alexmoncks/V9968_Cartridge/fpga/V9968_Cartridge_TangNano20K_geo3d/README.md

# V9968 cartridge + geo3d (Gowin project)

Generated by `geo3d/integration/apply_geo3d_patch.py` from HRA!'s project
and `geo3d/rtl`. Do not edit the files in this folder by hand: the script
refuses to regenerate over a hand edit (`geo3d_manifest.txt` tells its own
output from hand edits), and with `--force` it backs the edit up next to
this folder and overwrites it.

- `../V9968_Cartridge_TangNano20K/` is HRA!'s project, exactly as upstream,
  with his own build in `impl/` (the recovery bitstream).
- This folder is the same project with geo3d wired in, laid out like his:
  - `tangnano20k_vdp_cartridge.gprj`: his file list plus `src/geo3d/*.v`.
  - `src/`: the files his project lists, and the IP generator files of his
    IPs (`.ipc`, `.mod`, `_tmp.v`, `.vo`); `v9968/vdp.v`,
    `tangnano20k_vdp_cartridge.v`, `gowin_rpll2/gowin_rpll2.v` and
    `tangnano20k_vdp_cartridge.sdc` carry the geo3d patch.
  - `src/geo3d/`: copies of `geo3d/rtl`. Edit the files in `geo3d/rtl`,
    then run the script again.
  - `impl/tangnano20k_vdp_cartridge_process_config.json`: his project
    settings, unchanged.
  - `impl/gwsynthesis/`, `impl/pnr/`: the Gowin build of this project. The
    bitstream is `impl/pnr/tangnano20k_vdp_cartridge.fs`.
  - `geo3d_manifest.txt`: the files the script generated, with the SHA-256
    of their text.
  - `tangnano20k_vdp_cartridge.gprj.user` and `impl/temp/` are written by
    Gowin, as in HRA!'s folder. The first time the Gowin IDE opens the
    project, it adds `impl/temp/rtl_parser.result` and
    `impl/temp/rtl_parser_arg.json` and rewrites the `.gprj.user`.

After a change in HRA!'s project or in `geo3d/rtl`, from the repository root:

    python3 geo3d/integration/apply_geo3d_patch.py           # regenerate this folder
    python3 geo3d/integration/apply_geo3d_patch.py --check   # verify that it is current
    sh geo3d/syn/gowin/build_gowin.sh                         # build it in place, check every timing path

The script needs Python 3 and runs in any shell that has it (Linux, macOS,
WSL, or Windows with Python installed). `build_gowin.sh` needs Gowin EDA, so
on Windows it runs from Git Bash; it runs `--check` first (with WSL's
python3 when Windows has no Python of its own) and stops if this folder is
not current.

Opening `tangnano20k_vdp_cartridge.gprj` in the Gowin IDE and running
"Run All" gives the same bitstream as `build_gowin.sh`.

Licenses: HRA!'s sources, MIT (the repository's `LICENSE`); the files
written by Gowin's IP generator (`src/dvi_tx/`, `src/gowin_*/`), Gowin's
terms, as in HRA!'s folder; geo3d, MIT, Copyright (c) 2026 Alex Moncks.
