alexmoncks/V9968_Cartridge/geo3d/docs/cartridge_report.ja.md

[English](cartridge_report.md) | [Português](cartridge_report.pt.md)

# 標準 V9968 カートリッジ上の geo3d：検証レポート

日付：2026年9月27日。ベース：HRA! 氏のカートリッジプロジェクト（Tang Nano 20K、Gowin GW2AR-18C FPGA）のバージョン 86361d8 に、スクリプト `geo3d/integration/apply_geo3d_patch.py` で geo3d を統合したものです。ブランチは `geo3d-phase2` です。この段階の変更はすべて GitHub（alexmoncks/V9968_Cartridge）にあります：ブランチ `geo3d-phase2` は `eb9be4f`、`main` は `a72a761` です。4 章のフォルダ構成（HRA! 氏のプロジェクトは `fpga/V9968_Cartridge_TangNano20K/` にそのまま置き、geo3d 入りのプロジェクトをその隣の `fpga/V9968_Cartridge_TangNano20K_geo3d/` に置く構成）は、これらのコミットの後に導入したものです。

**2026年10月2日の更新：** geo3d プロジェクトは、新しいコマンドキャッシュを含む HRA! 氏の 4410365 をベースにするようになりました。変更点と新しい数値は 13 章にあります。1 章から 12 章は 86361d8 ベースの記述です。

## 1. 概要

| 質問 | 回答 |
|---|---|
| 物理的な基板の変更は必要ですか？ | **いいえ。** 部品、パターン、ピン、水晶、ジャンパーのいずれも変更しません。 |
| HRA! 氏のオリジナルプロジェクトは変わりますか？ | **いいえ、同氏のフォルダは upstream のままです。** geo3d は、その隣にある 2 つ目の Gowin プロジェクトに入っています。このプロジェクトは同氏のプロジェクトからスクリプトで生成し、同氏のファイルのうち 5 つにパッチを当てています（FPGA のみ）。 |
| カートリッジの FPGA に収まりますか？ | **はい。** Gowin 公式ツールで、ロジック 62%、スライス 86%、メモリ 48%、DSP 38%、プライマリクロック 8 本中 6 本です。 |
| geo3d は専用のクロックを持っていますか？ | **はい。** clk42g（42.95 MHz）は clk85m と同じ PLL から出ています。HRA! 氏の clk42m と HDMI は元のままです。 |
| ロジックは動作しますか？ | **はい、シミュレーション上では。** HRA! 氏のボード全体を geo3d と新しいクロックを含めてシミュレーションしました。すべてのケースで VRAM がリファレンスと一致しました。 |
| タイミングは収束しますか？ | **はい、Gowin のモデル上では。** HRA! 氏のプロジェクト自身の設定で、すべてのクロックペアについて、セットアップ、ホールド、リカバリ、リムーバルの負スラックのパスはゼロです。一部のスラックはぎりぎりです（6 章）。 |
| デモ ROM は geo3d を検出しますか？ | **はい。** geo3d がない場合は、黒い画面のままになるのではなく、3 か国語で「geo3d not found」を表示してそこで停止します。 |
| もうカートリッジに書き込めますか？ | **はい。** ビットストリーム `geo3d_cartridge_86361d8.fs`（`fpga/V9968_Cartridge_TangNano20K_geo3d/impl/pnr/tangnano20k_vdp_cartridge.fs` のコピー）と手順書 `FLASH.txt`（英語、ポルトガル語、日本語）が用意できています。書き込みはカートリッジを MSX から抜いた状態で行ってください。 |
| 実機のカートリッジでテストしましたか？ | **いいえ。** ここに書いた内容は実機でのテストの代わりにはなりません（10 章と 11 章）。 |

## 2. 検証した項目と方法

| 項目 | 方法 | 結果 |
|---|---|---|
| 基板とスロット | `pcb/` の回路図とネットリスト、RTL `msx_slot.v`、Z80 の I/O サイクルのシミュレーション | 変更なしで動作 |
| 統合スクリプト | HRA! 氏のクリーンな 86361d8 から生成スクリプトを実行し、リポジトリの geo3d プロジェクトと比較、2 回目の実行、`--check`、`geo3d/integration/test_apply_geo3d_patch.sh` のテスト 47 件（HRA! 氏のテキストの変更。バス読み出しマルチプレクサへの新しい読み出し元の追加や、信号の名前とビット幅の変更を含みます。パッチ済みの HRA! 氏のフォルダ、手作業での編集の拒否と保持、バックアップ付きの `--force`、HRA! 氏のプロジェクトと `geo3d/rtl` の更新、余分なファイルと欠けたファイル、設定の変更、HRA! 氏のリポジトリのクローンだけの場合） | ツリーは一致（Windows の CRLF 改行を除く）。2 回目の実行では何も書き込まない。パッチを当てたファイルは、以前のフォルダ内へのパッチとバイト単位で一致。47 件中 47 件合格 |
| 使用率とタイミング | Gowin EDA Standard V1.9.12.03（Alex のライセンス）で、geo3d プロジェクトをそのフォルダ内で、IDE の Run All と同じ方法でフルビルド。設定はプロジェクトのもの（Place Option 0）。すべてのクロックペアについてセットアップとホールドのパス表を、同じビットストリームになるコピーから出力 | 収まる。違反ゼロ |
| オープンソースツール | Yosys + nextpnr-himbaechel（oss-cad-suite） | オリジナルは配線まで完了するが、geo3d を含めると配置できない（98.6%）。このチップのリファレンスとしては使えない |
| 統合ロジック | iverilog：HRA! 氏のトップ全体、VDP、スロット、SDRAM コントローラと Micron モデル、それに geo3d を clk42g で。すべて geo3d プロジェクトの `src/` から取っています。clk42g を 0.5 ns と 2.0 ns 遅らせた場合も実行。テストベンチはリポジトリの外（作者の作業環境）にあります | すべて合格 |
| VDP の等価性 | 形式検証（Yosys）と並列シミュレーション | geo3d が停止している状態では、変更後の VDP はオリジナルと同一 |
| デモ ROM | Z80 シミュレーター `geo3d/rom/run_rom_z80.py`、geo3d あり／なし、88h と 98h | 256 回中 256 回の実行が合格 |
| geo3d なしでのソフトウェア | geo3d なしの openMSX：88h と 98h、MSX1、MSX2 PAL、MSX2+、カートリッジなし | BASIC ROM とゲームは正しく動作。デモ ROM は「geo3d not found」を表示 |

## 3. 基板（ハードウェア）

**結論：標準のカートリッジは、何も変更せずに geo3d に対応できます。** クロックの修正（4 章）は FPGA のみです。

- **アドレス：** A0-A7 は U5（SN74LVC8T245、DIR は GND、入力専用）を経由して FPGA に届きます。A8-A15、/SLTSL、/MERQ、/M1 は届きません。このカートリッジは I/O 専用で、ROM は別のスロットにあります。
- **制御：** /IORQ、/RD、/WR、/RESET は U6（DIR は GND）を経由します。
- **データ：** U4 の方向は FPGA が制御します（`SLOT_DATA_DIR`、R2 による 10k のプルダウン付き）。
- **/BUSDIR：** Q1（オープンドレインの NMOS）から出力され、ゲートは同じ `SLOT_DATA_DIR` につながっています。カートリッジがバスをドライブしている間は、どのポートでも Low になります。
- **/WAIT：** Q2 を経由し、起動時（FPGA のコンフィギュレーションと SDRAM の初期化が終わるまで）だけ使われます。geo3d は /WAIT を使いません。
- **デコード：** オリジナルの `msx_slot.v` はすでに 8 ポートのブロック全体（DIP スイッチにより 88h-8Fh または 98h-9Fh）をデコードしています。VDP は +0 から +4 を、geo3d は +5（インデックスとステータス）と +7（データ）を使います。+6（8Eh）は意図的に使っていません。
- **リード：** geo3d のリードは VDP のステータスリードと同じ経路を通り、U4 の方向切り替えも /BUSDIR も同じです。
- **シミュレーション上の応答時間：** geo3d は /RD から 116 から 140 ns 後にデータをバスに出します（clk42g でのシミュレーションでは 139.7 ns）。3.58 MHz の Z80 は約 500 ns 後に読むので十分な余裕があり、7.16 MHz でも約 220 ns の余裕が残ります。レベル変換器の遅延はこの計算に含まれていません。

**お手元の機材で確認していただきたい点：**
- **MegaRAM：** msx.org のポートマップ（再確認はしていません）によると、8Eh-8Fh は MegaRAM が使用します。アドレスを一部しかデコードしない MegaRAM は、8Fh での geo3d のリードに反応する可能性があります。
- **水晶：** 基板の部品表（`pcb/.../parts.txt`）では U1 は 28.636 MHz となっていますが、プロジェクトの PLL は 14.318 MHz を前提としています。どちらが実装されているか確認する価値があります。これは HRA! 氏のオリジナルのビットストリームにも同じように当てはまります。
- **電源：** Tang Nano の 5 V ピンはスロットの +5 V に接続されています。**ビットストリームの書き込みは、カートリッジを MSX から抜いた状態で行ってください。**

## 4. HRA! 氏のプロジェクトで変わる点

HRA! 氏のフォルダ `fpga/V9968_Cartridge_TangNano20K/` は変更しません。同氏の upstream 86361d8 そのままで、`impl/` には同氏自身のビルド（復元用のビットストリーム）が入っています。そのため、同氏の更新をマージしても競合は起きません。geo3d は、その隣にある 2 つ目の Gowin プロジェクト `fpga/V9968_Cartridge_TangNano20K_geo3d/` に入っています。構成もファイル名も同氏のプロジェクトと同じです：

| `fpga/V9968_Cartridge_TangNano20K_geo3d/` 内のパス | 内容 |
|---|---|
| `tangnano20k_vdp_cartridge.gprj` | 同氏のファイルリストに `src/geo3d/geo3d_core.v`、`geo3d_engine.v`、`geo3d_bus.v` を加えたもの（パスはプロジェクト内なので、Gowin IDE でそのまま開けます） |
| `src/` | 同氏の `.gprj` に記載されたファイルと、同氏の IP の IP ジェネレータ用ファイル（`.ipc`、`.mod`、`_tmp.v`、`.vo`）。そのうち 4 つに下記のパッチを当てています |
| `src/geo3d/` | `geo3d/rtl` のコピー。編集するのは引き続き `geo3d/rtl` だけです |
| `impl/tangnano20k_vdp_cartridge_process_config.json` | 同氏のプロジェクト設定をそのまま使用（Place Option 0） |
| `impl/gwsynthesis/`、`impl/pnr/` | 当方の Gowin ビルド。同氏と同じ形で git に入れています。ビットストリームは `impl/pnr/tangnano20k_vdp_cartridge.fs` です |
| `geo3d_manifest.txt`、`README.md` | スクリプトが書き込むファイル。生成したファイルとそれぞれのテキストの SHA-256（スクリプト自身の出力と手作業での編集を見分けるため）、およびフォルダの簡単な説明 |

`apply_geo3d_patch.py` は、HRA! 氏のフォルダと `geo3d/rtl` からこのフォルダを生成します。同氏のフォルダは読むだけです。このスクリプトは冪等で（2 回目の実行では何も書き込みません）、同氏のテキストが変わっている場合や、同氏のフォルダにすでに geo3d の変更が入っている場合は、何も書き込みません。実行のたびに、rPLL2 の設定、`u_pll2` の接続（入力 clk14m、出力 clk85m）、SDC のクロック、バス読み出しマルチプレクサ（新しい読み出し元が失われないよう、upstream とまったく同じでなければなりません）、geo3d が接続する同氏の各信号の宣言とビット幅、それらの信号がつながるスロットと VDP のポートを確認します。geo3d プロジェクト内の手作業での編集（たとえば、`src/geo3d` のコピーを表示する Gowin IDE での編集）は上書きしません。書き込みを拒否して編集を移すべき場所を示し、`--force` を付けた場合は、フォルダの隣にバックアップを取ってから上書きします。`--check` は何も書き込まず、フォルダがスクリプトの生成するものと完全に一致すること、特に `src/geo3d` が `geo3d/rtl` と同じであることを確認します。パッチを当てたファイルは、以前のフォルダ内へのパッチとバイト単位で一致します（本日確認しました）。このスクリプトには Python 3 が必要です（Linux、macOS、WSL、Windows）。`geo3d/integration/test_apply_geo3d_patch.sh` が一時的なコピーの上でスクリプトをテストします。

| HRA! 氏のファイル（geo3d プロジェクト内でパッチ適用） | 変更（行数、86361d8 との比較） | 影響 |
|---|---|---|
| `src/v9968/vdp.v` | +11 / -3：コマンドレジスタへの外部書き込みポート（`ext_cmd_wr/num/data`）を CPU からの書き込みに加え、CE を出力 | geo3d が停止している状態では、VDP はオリジナルと**同一**です。形式検証（695 点中 695 点、86361d8 では 697 点中 697 点）と、全ピンが一致した 360 万サイクルの並列シミュレーションで確認 |
| `src/tangnano20k_vdp_cartridge.v`（トップ） | +44 / -4：`geo3d_bus` をポート +5 と +7 にインスタンス化し、これらのポートを VDP から外し、リードデータをまとめ、ワイヤ `clk42g` を作って `u_pll2 .clkoutd` に接続し、geo3d の `clk_eng` を clk42g につなぐ | VDP は引き続き +0 から +4 に応答し、+6 も引き続き VDP に行きます |
| `tangnano20k_vdp_cartridge.gprj` | +3：geo3d のファイル（`src/geo3d/`） | なし |
| `src/gowin_rpll2/gowin_rpll2.v` | +3 / -3：出力 `clkoutd` を公開。PLL ではすでに設定済み（CLKOUT / 2、`DYN_SDIV_SEL = 2`）で、未使用のままだった | HRA! 氏の回路への影響はありません。CLKOUT と CLKOUTP は変わりません |
| `src/tangnano20k_vdp_cartridge.sdc` | +7：clk42g の `create_generated_clock`（clk85m が clk14m x 6 であるのと同様に clk14m x 3）と、clk85m と clk42g の間の両方向への `set_clock_uncertainty 0.5`、およびコメント | タイミング解析のみ |

**geo3d プロジェクト内で変わらないもの：** `msx_slot.v`、ピン定義ファイル（`.cst`）、HDMI、SDRAM、HRA! 氏の clk42m（引き続き CLKDIV 分周器から出て、HDMI と同氏の設計の残りの部分に供給されます）、HRA! 氏の SDC のクロックとクロックグループ、そしてプロジェクト設定です。HRA! 氏自身のフォルダはまったく変わりません。その `impl/pnr/` には、復元用に同氏のオリジナルのビットストリームが入っています。

**注意：** rPLL2 IP の `.ipc` と `.mod` ファイルは変更せずにコピーしています。誰かが geo3d プロジェクト内で、Gowin でこの IP を再生成すると、ポート `clkoutd` が消え、合成がエラーで失敗します。その場合はスクリプトをもう一度実行してください。

**Gowin IDE：** IDE で geo3d プロジェクトを初めて開くと、`impl/temp/rtl_parser.result` と `impl/temp/rtl_parser_arg.json` が作られ、`tangnano20k_vdp_cartridge.gprj.user` が書き換えられます。HRA! 氏のフォルダと同じです（同氏はこれらを git に入れています）。`build_gowin.sh` が使う `gw_sh` はこれらを作らないため、まだリポジトリには入っていません。

**この段階で変更したファイル：**

| ファイル | 変更 |
|---|---|
| `fpga/V9968_Cartridge_TangNano20K/` | HRA! 氏の upstream 86361d8 に、ファイル単位で戻しました |
| `fpga/V9968_Cartridge_TangNano20K_geo3d/`（新規） | スクリプトで生成した geo3d プロジェクト。`impl/` に Gowin のビルド結果があります |
| `geo3d/integration/apply_geo3d_patch.py` | HRA! 氏のフォルダにパッチを当てる代わりに、同氏のフォルダから geo3d プロジェクトを生成します。`--check` 付き。2 つの新しいステップ（rPLL2 と SDC）、トップへの clk42g の追加、上記の確認処理、手作業での編集の保護（`geo3d_manifest.txt`、`--force`） |
| `geo3d/integration/test_apply_geo3d_patch.sh`（新規） | スクリプトのテスト 47 件。一時的なコピーの上で実行します（bash と Python 3：Linux または WSL） |
| `geo3d/syn/gowin/build_gowin.sh`（新規） | geo3d プロジェクトをそのフォルダ内で、IDE の Run All と同じ方法で、プロジェクトの設定のままビルドします。Git Bash で実行し、最初に `apply_geo3d_patch.py --check` を実行して（Windows に Python がなければ WSL の python3 で）、プロジェクトが最新でなければ停止します。パス表は、リポジトリ外のコピーで行う 2 回目のビルドから取ります。そのコピーの SDC にだけ、プロジェクトの SDC が定義するすべてのクロックのペアについてレポートコマンドを追加し、同じビットストリームになることを確認します。負のスラックが 1 つでもあれば終了コード 2 で終わります |
| `geo3d/syn/cartridge/synth_cartridge.sh` | Yosys での合成は、HRA! 氏のプロジェクト（`run_all.sh` と同様に、同氏のリポジトリのクローンだけで足ります）とスクリプト自身の `geo3d/rtl` から、geo3d プロジェクトを作業フォルダに生成してから行います |
| `geo3d/rtl/geo3d_bus.v` | ヘッダーのコメントのみ（clk42g と SDC のマージン）。ロジックは変更していません |
| `geo3d/rom/geo3d_rom.asm`、`build_rom.py`、`run_rom_z80.py` | デモ ROM での geo3d の検出と、シミュレーターの新しいモード（8 章） |
| `geo3d/docs/BASIC_API.md` | R#32-R#58 のルール（9 章） |

## 5. FPGA の使用率（Gowin、GW2AR-LV18QN88C8/I7）

86361d8 ベース、Gowin V1.9.12.03、HRA! 氏のプロジェクト設定でのビルドです。最終ビルドの Gowin のレポートは `fpga/V9968_Cartridge_TangNano20K_geo3d/impl/` に、サマリーとパス表は `openmsx-geo3d\fpga\reports\`（納品フォルダ、リポジトリ外）にあります。

| リソース | HRA! 氏のオリジナル | geo3d あり、clk42m（以前） | geo3d あり、clk42g（最終） | 最終の差分 |
|---|---|---|---|---|
| ロジック（LUT + ALU） | 7,023 (34%) | 12,756 (62%) | 12,756 (62%) | +5,733 |
| レジスタ | 4,219 (27%) | 7,536 (48%) | 7,536 (48%) | +3,317 |
| スライス（CLS） | 5,605 (55%) | 8,896 (86%) | 8,886 (86%) | +3,281 |
| ブロックメモリ（BSRAM） | 10 / 46 (22%) | 22 (48%) | 22 (48%) | +12 |
| DSP | 3 / 24 (13%) | 9 (38%) | 9 (38%) | +6 |
| I/O ピン | 39 / 66 | 39 / 66 | 39 / 66 | 0 |
| プライマリクロック | 4 / 8 | 5 / 8 | 6 / 8 | +2 |
| ロングワイヤ | 5 / 8 | 8 / 8 | 8 / 8 | +3 |
| PLL（rPLL）／分周器（CLKDIV） | 2 / 2、1 / 8 | 2 / 2、1 / 8 | 2 / 2、1 / 8 | 0 |

- geo3d 専用のクロックは、ロジックも PLL も消費しません。PLL がもともと持っていた出力を使っているためです。プライマリクロックネットワークを 1 本使います（clk42g は TR、TL、BL の各象限で使われます）。
- ロングワイヤは 8 本中 8 本を使用しており、今後の変更に使える余りはありません。

## 6. タイミング

**結果：HRA! 氏のプロジェクト自身の設定（Place Option 0）で、すべての表において負スラックのパスはゼロです。** これは、すべてのクロックペアのセットアップ、ホールド、リカバリ、リムーバルを含みます。`build_gowin.sh` は、geo3d プロジェクトをそのフォルダ内で、Gowin IDE とまったく同じ方法（`open_project` と `run all`、オプションも追加の表もなし）でビルドします。パス表は、SDC にレポートコマンドを加えたコピーで行う 2 回目のビルドから取ります。スクリプトは、そのコピーが同じビットストリームを生成することを確認します（異なるのは「Created Time」の行だけです）。このビットストリームは、フォルダ構成を変更する前に納品したものとも同じです。

ワーストスラック（ns、正の値は合格）です。geo3d ありの 2 列では、clk42m または clk42g が geo3d エンジンのクロックです。

| 検査項目（目標） | HRA! 氏のオリジナル | geo3d、clk42m（以前） | geo3d、clk42g（最終） |
|---|---|---|---|
| Fmax clk85m (85.909 MHz) | 86.73 MHz | 86.14 MHz | 86.34 MHz |
| Fmax clk42m (42.955 MHz) | 120.92 MHz | 62.64 MHz | 117.46 MHz |
| Fmax clk42g (42.955 MHz) | なし | なし | 64.07 MHz |
| セットアップ 85 → 85 | +0.111 | +0.031 | +0.058 |
| セットアップ 85 → 42m（HDMI） | +1.334 | **-1.130（50 本以上が違反）** | +0.489 |
| セットアップ 85 → 42g | なし | なし | +2.383 |
| セットアップ 42m → 85 | なし | +12.698 | なし |
| セットアップ 42g → 85 | なし | なし | +7.857 |
| セットアップ 42m → 42m | +15.010 | +7.316 | +14.767 |
| セットアップ 42g → 42g | なし | なし | +7.673 |
| ホールド 85 → 85 | +0.199 | +0.227 | +0.216 |
| ホールド 85 → 42m（HDMI） | +3.443 | +3.458 | +3.782 |
| ホールド 85 → 42g | なし | なし | +0.047 |
| ホールド 42m → 85 | なし | **-2.487（40 本が違反）** | なし |
| ホールド 42g → 85 | なし | なし | +0.039 |
| ホールド 42m → 42m | +0.539 | +0.074 | +0.544 |
| ホールド 42g → 42g | なし | なし | +0.074 |
| リカバリ／リムーバル | +10.046 / +1.047 | +9.476 / +1.200 | +9.476 / +1.185 |
| **負のパス（全表の合計）** | **0** | **90 本以上** | **0** |

- 各表には最大 50 本のパスしか表示されません。そのため「50 本以上」としています。
- clk42m の列では、「85 → 42m」の行は geo3d エンジンも含んでおり、ワーストパスは HDMI ではなく geo3d のものです。セットアップは HRA! 氏のリセット `ff_reset3_n2` からエンジンへのパス、42m → 85 のホールドは `geo3d_bus` の `cmd_*_e` レジスタから `cmd_*` へのパスです。
- 74 の表は、プロジェクトの SDC が定義する 6 つのクロック（clk85m、clk42m、clk42g、clk215m、clk、clk14m。`build_gowin.sh` が SDC から読み取ります）の 36 のペアそれぞれのセットアップとホールド、それにリカバリとリムーバルです。最終ビルドでは、そのうち 60 の表にパスがありません。clk215m、clk、clk14m のいずれかを含むすべてのペア（54 表）、clk42m と clk42g の間のペア（4 表、HDMI と geo3d はつながっていないため）、clk42m から clk85m へのペア（2 表）です。
- clk85m と clk42g の間のスラックは、0.5 ns のマージンを差し引いた後の値です。マージンがなければ、このクロスのホールドは約 +0.54 ns になります。
- **Gowin のレポートを読む際の注意：** 「Total Negative Slack」のサマリーは、クロック間のパスが違反していても 0 と表示します。違反が見えるのはパス表だけです。`build_gowin.sh` はこれらの表を生成し、すべてを確認します。

**以前の違反の原因：** clk42m は CLKDIV 分周器から出ており、Gowin のモデルでは遅延がゼロですが、PLL から出る clk85m には 2.9 から 4.4 ns の遅延があります。geo3d のクロックドメイン間の受け渡しは、クロックがそろっていることを前提としています。

**適用した修正：** geo3d に clk42g を追加しました。clk85m と同じ PLL の CLKOUTD 出力（CLKOUT / 2）です。これにより、モデル上で geo3d のクロスのクロックスキューは 0 ns になりました（以前は 4.36 ns）。

**0.5 ns のマージン：** Gowin は CLKOUTD に CLKOUT とまったく同じ遅延を与え、分周器そのものの遅延はモデル化していません。SDC は clk85m と clk42g の間の両方向に 0.5 ns（`set_clock_uncertainty`）を確保しています。**この値は仮定であり、測定値ではありません。** ロジックを確認するため、clk42g を 0.5 ns と 2.0 ns 遅らせたシミュレーションも行いました（7 章）。

**途中のビルド**（サマリーは `reports\compare\`）：

| ビルド | 配置 | マージン | 負のパス |
|---|---|---|---|
| clk42m（旧） | Option 0 | なし | 90 本以上 |
| clk42g | Option 0 | なし | 1（HRA! 氏の HDMI のパス、85 → 42m、-0.059 ns） |
| clk42g | Option 1 | なし | 0 |
| **clk42g（納品版）** | **Option 0（HRA! 氏のデフォルト）** | **0.5 ns** | **0** |
| clk42g | Option 1 | 0.5 ns | 0 |

**ぎりぎりだが正のスラック：**
- セットアップ 85 → 85：+0.058 ns。VDP のコマンドエンジン内のパスです（オリジナルでは +0.111 ns、clk42m のビルドでは +0.031 ns）。このスラックは配置によって変わります。
- geo3d エンジン内部のホールド（42g → 42g）：+0.074 ns。
- 85 と 42g の間のクロスのホールド：+0.039 ns と +0.047 ns（マージン込み）。
- HDMI のパス（85 → 42m）は配置によって変動し、上記の clk42g のビルドでは -0.059 から +0.962 ns でした。今後の RTL の変更で再び動く可能性があります。`build_gowin.sh` はそれを検出します（終了コード 2）。

## 7. 統合 RTL のシミュレーション

iverilog で、HRA! 氏のトップ全体（geo3d プロジェクトの `src/` の Verilog、つまりクリーンな 86361d8 にスクリプトを適用したもの）を、VDP、スロット、SDRAM コントローラ、Micron MT48LC2M32B2 モデル、それに geo3d を含めて 85.909 MHz でシミュレーションしました。スタブは PLL、分周器（実際に 2 分周します）、HDMI だけです。PLL のスタブは `clkoutd` を clk85m / 2 として同相で生成します。チェッカー（`clkcheck.v`）が、geo3d の `clk_eng` が clk42g であること、正確に半分の周波数であること、ずれたエッジが 0 であることを確認します。Z80 側は OTIR の速度で実際の I/O サイクル（/IORQ、/RD、/WR、A0-A7、D0-D7）を使います。VRAM（256 KB）は、書き込みの抜けを検出できるよう、擬似乱数パターンで埋めた状態から始めます。

| テスト | 結果 |
|---|---|
| レジスタ、ステータス、即時変換 | エラー 0 |
| ワイヤーフレーム（立方体と正八面体、XOR と TIMP） | VRAM 一致 |
| シェーディングしたソリッド面 | VRAM 一致 |
| テクスチャ付きの面（LRMM） | VRAM 一致 |
| 実際のテクスチャデモ（GEO3DT.COM）、すべての OUT を再現 | 2,842 コマンド（LINE 1,855、LRMM 987）、相違 0、3 フレーム一致 |
| DIP スイッチ 98h | 合格 |
| 起動時の状態（V9958 モード） | VRAM 一致 |
| geo3d から VDP への 39,158 回の書き込みでのハンドシェイク | CE = 1 での書き込み 0、抜け 0、衝突 0 |
| 意図的な競合：geo3d がビジーの間に CPU が R#32-R#58 に書き込む（33 回） | 同一サイクルでの衝突 4 回とフレームの破損、想定どおりです。9 章のルールを裏付けます |

- **旧クロックおよび前回の納品物との比較：** コマンドログとリードログ、VRAM、サイクル数は、clk42m でのシミュレーションとも、clk42g を使った前回の納品物とも、バイト単位で一致しました。起動時の状態のテストは以前は clk42m でしか実行していなかったため、今回の見直しで最終ツリー上で再実行しました。
- **新しいフォルダ構成：** レジスタ、ワイヤーフレーム、面、テクスチャ、ハンドシェイク、DIP 98h、98h でのレジスタ、実際のデモの各テストを、すべてのファイルを `fpga/V9968_Cartridge_TangNano20K_geo3d/src`（geo3d は `src/geo3d`）から取って再実行しました。8 件すべて合格し、コマンドログとリードログ、VRAM、サイクル数は、以前の実行とバイト単位で一致しました。
- **遅延させたクロック：** 7 つのテストを、clk42g を clk85m に対して 0.5 ns と 2.0 ns 遅らせて実行しました（14 回）。ゲート遅延のないシミュレーションでは、これにより clk85m から clk42g へのすべての取り込みが、同じエッジで送出された値を取り込むことになります。14 回すべて合格しました。VRAM はクロックがそろった場合と一致しました。例外は意図的な競合テストで、衝突が変わり（4 回ではなく 1 回）、それに伴って破損したフレームも変わります。
- **テストベンチ：** `tb_cart.sv`、スタブ、Z80 サイクルの生成、デモの再生はリポジトリの外（作者の作業環境）にあるため、これらの実行はリポジトリだけでは再現できません。
- **限界：** シミュレーションは実際の配線遅延をモデル化していません。それはタイミング解析（6 章）と実機のカートリッジに委ねられます。

## 8. HRA! 氏のオリジナルのビットストリーム（geo3d なし）での当方のソフトウェア

| プログラム | 動作 | 状況 |
|---|---|---|
| BASIC ROM（G3BASIC.ROM） | 起動表示「geo3d BASIC 0.2 (none)」。`CALL G3INIT` は「Device I/O error」になり、BASIC はそのまま動作し続けます | 正しい |
| ゲーム VECTOR RAID | 止まりはしませんが、自機も敵も表示されないまま、警告なしで動作します | 許容範囲 |
| デモ ROM | 「geo3d not found」画面（英語、スペイン語、ポルトガル語）を表示し、そこで停止します。geo3d のどのポートにも書き込みません | **正しい（修正済み）** |

**デモ ROM が geo3d を検出する方法**（`geo3d_rom.asm` の `geo_probe`。BASIC ROM の `detect` と同じ方法で、ROM 自身のベースアドレスでのみ行います）：
1. 98h 版の ROM は、MSX1（MSXVER = 0）では何もしません。TMS9918 は R#15 への書き込みを R#7 として解釈してしまうためです。
2. S#1 から VDP の ID を読みます。ID 0、2、3 は V99x8 があることを意味し、メッセージの画像をそこに表示できます。geo3d には ID 2 または 3 が必要です。
3. R#15 = 2 にして P+5 を読みます。FFh（HRA! 氏のビットストリーム、または空きポート）は geo3d なしを意味します。ビット 3-2 = 11 は、ポートが P+4 から P+7 に繰り返し現れる VDP を意味します。その後で初めて PORT#4 を読みます。
4. geo3d への最初の書き込みはインデックス 40h です。続いて P+7 を 17 回読み、17 回目の値は 1 回目と同じでなければなりません。

検出は 29 回のポートアクセスで行います。geo3d がある場合、その後のトラフィックは以前の ROM と同一です。

**geo3d がない場合：**
- ベースアドレスに V99x8 がある場合は、メニューと同じスタイルの SCREEN 5 の画像を表示します。どの V99x8 でも受け付けるレジスタだけを使い、V9968 のレジスタ、コマンド、PORT#4 への書き込みは一切使いません。
- 88h 版の ROM は、BIOS（INITXT と CHPUT、プレーンな ASCII）で MSX 本体の画面にもテキストを表示します。88h に V9968 がない場合は、これが唯一のメッセージです。98h 版は MSX1 の場合にのみこれを行います。
- ROM は割り込み禁止のループ（`ng_stay`）にとどまります。
- **50/60 Hz：** 98h 版の ROM は本体の周波数を維持します（R#9 = `(RG9SAV & 02h) | 80h`、PAL 機では 82h）。88h 版はカートリッジの HDMI のため 80h（60 Hz）を使います。

**待ちのタイムアウト：** geo3d の RUN と VDP の CE の待ちは、3.58 MHz の Z80 で約 3 秒後に打ち切られます（シミュレーターでは 3.08 から 3.29 秒）。turbo R では、カートリッジの INIT は Z80 で動作します。R800 の ROM モードでは、待ちの 65,536 回のリード 1 周（Z80 では約 1.6 秒）に約 0.7 秒かかります（レビュー時の測定値で、再測定はしていません）。タイムアウトになると（`hw_timeout`）：
1. 音楽を止めます。
2. コマンドエンジンに STOP（R#46 = 0）を送ります。
3. 描画中のフレームがメッセージの上に描かれないよう、geo3d の RUN が終わるのを、P+5 を最大 32,768 回読んで（約 0.55 秒）待ちます。
4. RUN が終わった場合に限り、2 回目の STOP を送ります。
5. 同じメッセージを表示します。

**Z80 シミュレーター（`run_rom_z80.py`）、新しい ROM：**

| セット | 実行回数 | 結果 |
|---|---|---|
| MoonSound なし（PSG、SCC、OPL、OPL4、3 か国語、キー入力スクリプト、スペースバー、88h と 98h） | 120 | 120 回合格。トレースは、検出の 29 アクセスの後にリファレンスのトレースが続く形で、バイト単位で一致 |
| メッセージ（`--absent ff/mirror/v9938/none`、`--stuck geo/ce/cegeo`、`--msxver`、`--pal`、MSX1、MoonSound、88h と 98h） | 84 | 84 回合格。CPU は `ng_stay` で終わり、ページ 0、パレット、レジスタが画像と一致し、BIOS のテキストも一致 |
| MoonSound（640、256、128、0 KB） | 52 | 52 回合格。ポートごとの書き込みは、52 回中 45 回で検出とリファレンスを合わせたものと一致。残りの 7 回は最後の部分だけが異なり、そこでは実時間によって実行が打ち切られます |

- `--stuck cegeo` モードは、geo3d が CE を待っている状態で CE が止まったままになるケースを再現します。ステータスリード 1,001 回と STOP 2 回が、すべて画像の表示前に行われます。以前の ROM は、このモードと `--pal` で失敗します。

**openMSX（ヘッドレス、画像は VRAM、レジスタ、パレットのダンプから生成）：**

| 機種とカートリッジ | ROM | 結果 |
|---|---|---|
| FS-A1WSX、HRA! 氏の V9968（geo3d なし） | 88h | V9968（HDMI）に画像、MSX の画面にテキスト。geo3d へのアクセスは 8Dh のリード 1 回（FFh）のみ |
| C-BIOS_V9968_JP、geo3d なし | 98h | 画像。9Dh のリード 1 回（FFh）、書き込みなし |
| FS-A1WSX、カートリッジなし | 88h | BIOS のテキストのみ。8Dh-8Fh へのアクセスなし |
| MSX1（Expert XP-800）、HRA! 氏の V9968 | 88h | V9968 に画像、MSX の画面にテキスト |
| FS-A1WSX（98h に V9958） | 98h | V9958 に画像 |
| MSX1 | 98h | BIOS のテキストのみ。98h-9Fh へのアクセスなし |
| Philips NMS 8245（PAL、V9938） | 98h | R#9 = 82h で画像（50 Hz を維持） |
| Philips NMS 8245、HRA! 氏の V9968（geo3d なし） | 88h | R#9 = 80h で V9968 に画像 |
| geo3d あり（88h と 98h） | 両方 | メニューとクロールは正常。ポートアクセス数と VRAM は前回の納品物と同じ |

画像は `openmsx-geo3d\geo3d_not_found\`（9 ファイル）にあります。

## 9. geo3d をプログラムする方へのルール

- geo3d の描画中（RUN がビジーの間）は、**R#32 から R#58** に何も書き込んではいけません。LRMM は R#47 から R#58 を使い、geo3d の書き込みと同じサイクルで行われた CPU の書き込みは失われます。7 章の意図的な競合テストがこれを示しています。
- **CE = 0 はエンジンが空いていることを意味しません。** CE は geo3d のあるコマンドと次のコマンドの間で下がります。geo3d のステータスのビット 0 を待ってください。
- LRMM のウィンドウ（R#51 から R#58）は VRAM 全体をカバーしている必要があります。これはリセット時の値です。

これらのルールは `BASIC_API.md` の 7.2 節に記載しています。3 つの ROM はすでにこれを守っています。唯一の例外はデモ ROM の `hw_timeout` の STOP ですが、それも理論上だけです。geo3d は、固まっている場合でも、CE が High の間はレジスタに書き込みません。

## 10. 実機のカートリッジでしか確認できないこと

- **チップ上での CLKOUT と CLKOUTD の間の実際の遅延。** 0.5 ns のマージンは仮定であり、測定値ではありません。
- **6 章のぎりぎりのスラック**（ホールドで +0.039 から +0.074 ns、セットアップ 85 → 85 で +0.058 ns）：タイミング解析はあくまでモデルです。
- **シグナルインテグリティ：** LVC8T245 の遅延、ノイズ、そしてスロットバッファ付きの機種、スロット拡張、R800 でわずかに遅れる /BUSDIR。
- geo3d のコマンドトラフィック下での**実際の SDRAM**。
- **実際のモニターでの HDMI。**
- 長時間使用時の**消費電力、発熱、安定性**。
- HRA! 氏のオリジナルのビットストリームを使った、**実機上での「geo3d not found」画面**。

## 11. 実機での最初のテストの手順

納品フォルダ `openmsx-geo3d`（リポジトリ外）のファイル：

| ファイル | 確認 |
|---|---|
| `fpga\geo3d_cartridge_86361d8.fs` | SHA-256 `00238660f28d4fa73232fcfd3553b3c1eb554bb1a81b35e52ebfbab3b1e8c3ca`、リポジトリの `fpga/V9968_Cartridge_TangNano20K_geo3d/impl/pnr/tangnano20k_vdp_cartridge.fs` と同一。前回の納品物（`49a3fc51...`）と内容は同じで、異なるのは「Created Time」の行だけです |
| `fpga\recovery\tangnano20k_vdp_cartridge_HRA_86361d8.fs` | SHA-256 `9957d2b507897370c402973c2a358adad9675c0bb7b45b38f75d1fb6a6b32b73`、リポジトリの `fpga/V9968_Cartridge_TangNano20K/impl/pnr/tangnano20k_vdp_cartridge.fs`（HRA! 氏のフォルダ）と同一 |
| `fpga\FLASH.txt` | 英語、ポルトガル語、日本語の手順 |
| `GEO3D_88_hardware_real_MOD.ROM` | SHA-1 `79fbbd4f29f2f3ebffa1e9da414b7917d0ca575f` |
| `GEO3D_98.ROM` | SHA-1 `0b8ff70cd6f6ad3dbbcb194ec269987536f42987` |

2 つのビットストリームの SHA-256 の値は、Gowin が書き出すとおり、また Windows で git がチェックアウトするとおりの、CRLF 改行のファイルのものです。Linux や macOS でチェックアウトすると改行が LF になり、ハッシュが変わります（geo3d `4ce281b2...`、HRA! 氏 `7fc1fffa...`）。ビットストリームは同じです。

2 つの ROM は Star Wars の音楽（MOD）を使っているため、git には入れません。フォルダ内のほかの ROM は検出機能のない古いビルドです。

0. **基準の確認：** DIP スイッチを 88h にし、HDMI を接続し、HRA! 氏の**オリジナル**のビットストリームを書き込んだ状態で、BASIC ROM を動かします。`CALL G3INIT` は「Device I/O error」になるはずです。次に `GEO3D_88_hardware_real_MOD.ROM` を動かします。HDMI に「geo3d not found」が、MSX の画面にテキストが表示されるはずです。これで、カートリッジ、88h の経路、メッセージが動作することを確認できます。
1. **geo3d のビットストリームの書き込み**は、**カートリッジを MSX から抜いた状態で**、USB-C で PC に接続して行います。事前に SHA-256 を確認してください。
   - Gowin Programmer：デバイス GW2AR-18C、Access Mode = External Flash Mode、Operation = exFlash Erase,Program thru GAO-Bridge、ファイル `geo3d_cartridge_86361d8.fs`。
   - または：`openFPGALoader -b tangnano20k -f geo3d_cartridge_86361d8.fs`。
2. **最初の起動：** USB ケーブルを抜き、DIP スイッチを 88h にし、MSX の電源を切った状態でカートリッジをスロットに挿し、HDMI を接続してから MSX の電源を入れます。通常どおり起動するはずです。起動せずに固まった場合は、/WAIT がアサートされたままです。FPGA のコンフィギュレーションができなかったか、SDRAM が初期化されなかったことを意味します。電源を切り、カートリッジを抜いて、もう一度書き込んでください。
3. **最初は BASIC ROM** です。最も安全だからです。geo3d を識別するまではリードしか行わず、待ちにはタイムアウトがあり、CTRL+STOP も受け付けます。起動表示に「(88h)」と出るはずです。次にサンプルを実行します：`10 SCREEN 5:CALL G3INIT`、`20 CALL G3OBJ(1,1)`、`30 CALL G3SPIN(1,1,2,0)`、`40 CALL G3FRAME:GOTO 40`。
4. **次にゲーム：** タイトル画面に 3D の自機が表示されるはずです。
5. **最後にデモ ROM**（`GEO3D_88_hardware_real_MOD.ROM`）：言語メニューとデモです。
   - 起動直後に「geo3d not found」が出る場合：カートリッジは応答していますが、geo3d がありません。このビットストリームが書き込まれているか、DIP スイッチが 88h になっているかを確認してください。
   - デモの途中で同じメッセージが出る場合：geo3d またはコマンドエンジンが約 3 秒間応答しなくなりました。デモの名前と発生したタイミングを記録してください。調査すべき実際の問題です。
6. **観察する点：** 描画中の点やゴミ（SDRAM）、数分後のフリーズ、発熱。可能であれば、PAL 機や turbo R を含むほかの MSX 機種でもテストしてください。
7. **オリジナルに戻すには：** 同じ手順で、カートリッジを MSX から抜いた状態で `recovery\tangnano20k_vdp_cartridge_HRA_86361d8.fs`（または HRA! 氏の `fpga/V9968_Cartridge_TangNano20K/impl/pnr/tangnano20k_vdp_cartridge.fs`、内容は同じ）を書き込みます。

## 12. 未解決事項

1. **実機のカートリッジでの最初のテスト**（11 章）。0.5 ns のマージンとぎりぎりのスラックを確認する唯一の方法です。
2. **`geo3d/README.md`**（意図的に読み取り専用、Alex の承認が必要）：統合とタイミングの段落が、まだ以前の構成（HRA! 氏のフォルダへのパッチ適用、コピー上での Gowin ビルド）を説明しています。
3. **`geo3d/demos/README.md`、`README.pt.md`、`README.es.md`：** 「Real hardware」（実機）の段落と `run_rom_z80.py` の使い方（新しいオプション `--absent`、`--stuck`、`--msxver`、`--pal`）が、まだ以前の状態を説明しています。
4. **納品フォルダ内の古い ROM：** `GEO3D_88_hardware_real.ROM`、`*_crawlonly`、`GEO3D_98_fmconv`、`GEO3D_98_midi` には検出機能がありません。作り直すか削除してください。
5. `FLASH.txt` 内の **Gowin Programmer のメニュー名**：Sipeed の Tang Nano 20K 向けの手順に基づくもので、このマシンでは確認していません。
6. **ディスク容量：** 実験用のフォルダ `C:\Projects\mmsoft\g3x`（561 MB）と `geo3d_review_gw*` はリポジトリ外にあり、削除してかまいません。

## 13. 2026年10月2日の更新：HRA! 氏の 4410365

geo3d プロジェクトは、HRA! 氏の upstream **4410365**（2026年9月30日）から生成するようになりました。この upstream は `geo3d-phase2` にマージ済みで、同氏のフォルダは再び upstream とバイト単位で一致しています。1 章から 12 章は 86361d8 ベースの記述で、そのまま残しています。

**86361d8 以降の HRA! 氏の変更：**
- 88132d2：コマンドキャッシュを書き直し。32 ビット 8 ライン、LRU 置換（以前は 4 ライン、ラウンドロビン）になり、`vdp_command.v` の内部から `vdp.v` に移りました。CPU の VRAM アクセスもこのキャッシュを通ります。各コマンドの終了時と、CPU の最後のアクセスから 256 クロック後に書き戻され、コマンド開始時のクリアはなくなりました。
- 4410365：SCREEN 2 で R#25 CMD = 1 のとき 1 バイト飛ばしになる問題。ピクセルステップは R#46 の書き込みで設定されるレジスタになりました。
- ef12ee3：DIY = 1 の HMMM / LMMM / YMMM は、転送元が Y = 0 に達すると止まります。
- 05f9806：ステータス読み出しでポート #1 のバイト対をリセット。6acdb4d：V9958 モードでの R#4 の A17。fda3f26：水平拡大。9917548：スプライト合成とタイミング制御。
- 同氏のプロジェクト設定：`Route_Maxfan` が 100 から 50 に（スクリプトはすべての設定と同様に geo3d プロジェクトへコピーします）。

**geo3d 側の変更：** `geo3d/rtl` もパッチも変更なし。`apply_geo3d_patch.py` は新しい `vdp.v` にそのまま適用できました。フックは `vdp_command` の手前にあるので、geo3d 自身の R#46 書き込みも新しいピクセルステップのレジスタを設定します。HRA! 氏のエンジンを直接インスタンス化する 2 つのテストベンチ、`sim/hra/tb_hra_cmd.v` と `sim/tb_system.v` は、`vdp.v` と同じ接続で `vdp_command_cache.v` も並べてインスタンス化するようにしました（CPU ポートは未使用）。

| 4410365 での確認 | 結果 |
|---|---|
| パッチ後の `vdp.v` と upstream の比較 | 差分は 4 つのポート、`u_command` の接続 3 行、`ext_cmd_ce` の assign のみ。20 個の `vdp_*.v` サブモジュールは同一 |
| geo3d 停止時の VDP の等価性 | 形式検証（Yosys）：755 点中 755 点。`ext_cmd_wr` = 1 のミュータントは 15 点が未証明となり、期待どおり失敗。両カートリッジの並列シミュレーション、366 万サイクル、全ピン：一致 |
| 統合スクリプト | テスト 47 件中 47 件合格。`--check`：最新 |
| `run_all.sh`（geo3d のシミュレーション） | すべて合格：4,000 ベクタ、ワイヤーフレーム 24 シーン、面 16 シーン、テクスチャ 12 シーン、Z80 デモ 3 本。HRA! 氏の RTL と LRMM / LINE モデルの比較：不一致 0 バイト（900 + 300 コマンド）。エンドツーエンドで 130 ページ一致。ショーケースの 3 サンプル、不一致ページ 0。デモ ROM のトラフィックは検証済みのものと一致 |
| カートリッジ全体（`tb_cart.sv`） | regs、ワイヤーフレーム、面、テクスチャ、busy、DIP 98h、regs 98h、V9958 モードの面、実際のテクスチャデモ：すべて合格。VRAM はモデルと一致、CE = 1 のときのレジスタ書き込み 0（デモで geo3d の書き込み 39,158 回）、コマンド列は 86361d8 での実行と一致。変わるのはサイクル数だけ |
| HRA! 氏のテストベンチ | `test_command_cache`：すべて合格（iverilog）。`tb_port1_latch_reset`：12 件中 12 件（Verilator）。その他のテストベンチは ModelSim が必要（iverilog 12 は `break` 非対応。`test_vdp_cpu_interface/tb` と `test_vdp_timing_control_ssg` は RTL にもう存在しないポートを接続している） |
| Gowin EDA V1.9.12.03、その場でビルド | 74 個の表すべてで負のスラックのパス 0 |

**リソースとタイミング（Gowin）：**

| | HRA! 4410365（同氏のビルド） | geo3d（86361d8） | geo3d（4410365） |
|---|---|---|---|
| ロジック（LUT + ALU） | 7,469（37%） | 12,756（62%） | 13,130（64%） |
| レジスタ | 4,513（29%） | 7,536（48%） | 7,863（50%） |
| CLS | 5,768（56%） | 8,886（86%） | 9,137（89%） |
| BSRAM / DSP | 10 / 3 | 22 / 9 | 22 / 9 |
| Fmax clk85m（85.909 MHz） | 90.2 MHz | 86.34 MHz | 85.91 MHz |
| Fmax clk42g（42.955 MHz） | - | 64.07 MHz | 68.11 MHz |
| セットアップの最悪スラック 85 から 85 | | +0.058 ns | **+0.001 ns** |
| ホールドの最悪 42g から 85 / 85 から 42g | | +0.039 / +0.047 ns | +0.039 / +0.042 ns |

geo3d 自身の分は変わりません（ロジック約 +5,660、レジスタ約 +3,350）。+0.001 ns のパスは HRA! 氏のもの（スプライト回路、`ff_screen_pos_x_clone` から `ff_sprite_overmap_id`）で、配置によって変わります。今後の RTL の変更で負になる可能性があり、その場合 `build_gowin.sh` は終了コード 2 で知らせます。ビットストリームの SHA-256：Gowin が書き出す CRLF 改行で `c13b99ac...`、LF 改行で `5bb80bd0...`。

**新しいキャッシュでのコマンドのタイミング**（高速モード、85.9 MHz、両ベースで同じテストベンチ）：

| 測定 | 86361d8 | 4410365 |
|---|---|---|
| LRMM、1 ピクセルあたりのクロック数（`check_lrmm.py`、VRAM は常に準備完了） | 8.8 | 11.6 |
| LINE、1 ピクセルあたりのクロック数 | 5.9 | 7.0 |
| LINE、V9938 互換タイミング | 224 | 225 |
| テクスチャデモの最長フレーム（`tb_system.v`、RUN から終了まで） | 4.14 ms | 4.36 ms |
| サンプルの最長フレーム、パンとズーム / クロール / フライイン | 9.2 / 4.7 / 3.2 ms | 10.2 / 6.2 / 3.4 ms |

各アクセスが検索と更新のステートを通るようになったため、キャッシュヒットのコストが数クロック増えました。影響が最も大きいのはテクスチャのスパン（LRMM は読み書きの両方）です。どのデモもフレーム時間に十分収まっています（相対的な変化が最も大きいクロールでも、2.9 フィールドに 1 フレームの描画です）。

GRAPHIC 7 で古い 4 ラインのキャッシュに見られた位置合わせの影響（SX - DX が 8 で割って 3 または 4 余るコピーは最大 1.6 倍の時間がかかった）はなくなりました。画面表示とスプライトの VRAM スロットのモデルで、GRAPHIC 7 の HMMM 248x64 は SX = 0 から 7 で 2.48 から 2.90 ms（以前は 1.88 から 3.02 ms）、LMMM + TIMP は 4.08 から 4.51 ms（以前は 3.18 から 5.23 ms）です。最悪の場合は速くなり、位置が揃った場合は遅くなりました。GRAPHIC 4 と、VRAM が常に準備完了の場合、コピーと LINE は 10 から 36% 遅くなります（HMMV は変わりません）。

**VDP ポートの読み出しレイテンシ：** カートリッジ全体のテストベンチで、最も遅い VDP の読み出しは /RD から 350 ns が 417 ns になりました。CPU の VRAM アクセスが共有キャッシュでコマンドエンジンを待つようになったためと考えられます（詳しくは調べていません）。並列シミュレーションでは geo3d の有無にかかわらず同じレイテンシで、3.58 MHz の Z80 が許す 503 ns にはまだ収まっています。geo3d 自身の読み出しは変わりません（140 ns）。

**openMSX：** フォーク（`geo3d` ブランチ）は古いキャッシュ（4 ライン、ラウンドロビン、ヒット 1 クロック）をモデル化しています。古い RTL と一致していた範囲で言えば、VRAM が速い場合の高速コマンドでは約 20 から 35% 楽観的になり、位置のずれた GRAPHIC 7 のコピーでは悲観的になります。buppu3 氏の upstream は 88132d2 以降キャッシュのモデルを変えていません。更新には、LRU の経過を持つ 8 ライン、新しいステートマシンのアクセスごとのコスト、コマンド開始時にクリアしないこと、コマンド終了時と CPU アイドル時の書き戻し、キャッシュを共有する CPU の VRAM アクセスが必要です。

**未解決：** 納品フォルダのビットストリーム `geo3d_cartridge_86361d8.fs` は 86361d8 のビルドです。`cartridge_report.pt.pdf` はこの章より前のものです。
