alexmoncks/V9968_Cartridge/geo3d/demos/img/sphere7.gif

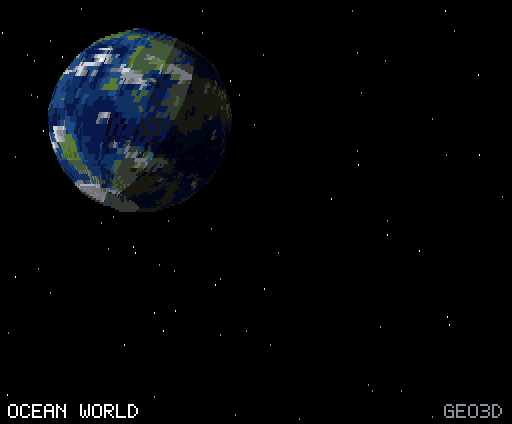
geo3d/demos/img/sphere7.gif
