alexmoncks/V9968_Cartridge/geo3d/demos/img/sphere7_textures.png

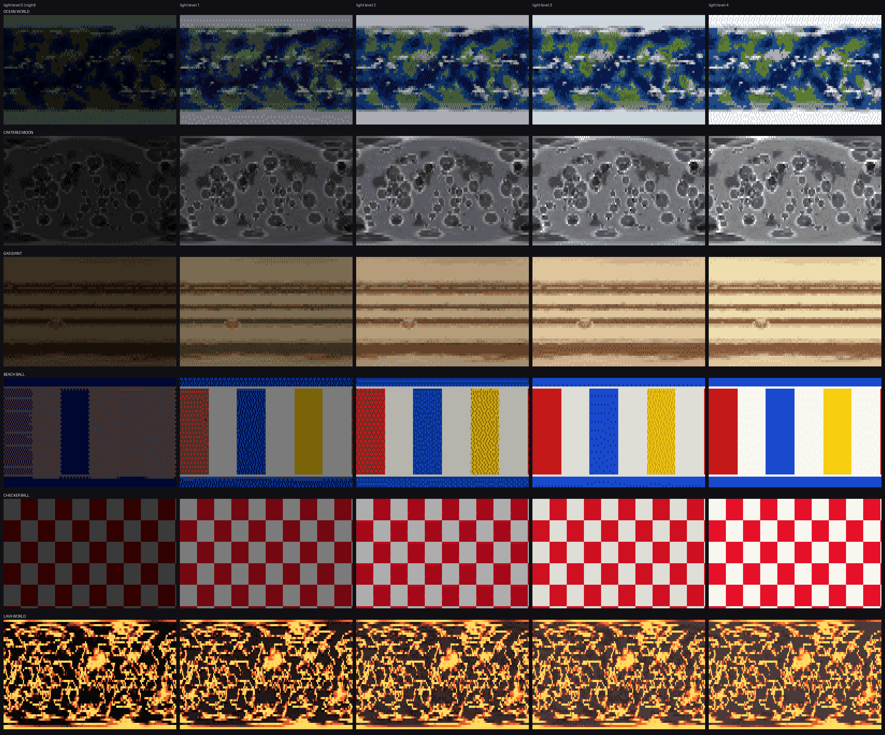
geo3d/demos/img/sphere7_textures.png
