alexmoncks/V9968_Cartridge/geo3d/demos/img/tile_background_512x212.png

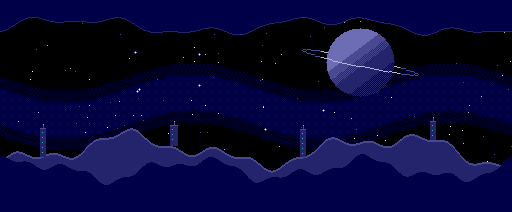
geo3d/demos/img/tile_background_512x212.png
