alexmoncks/V9968_Cartridge/geo3d/docs/demo_frames.png

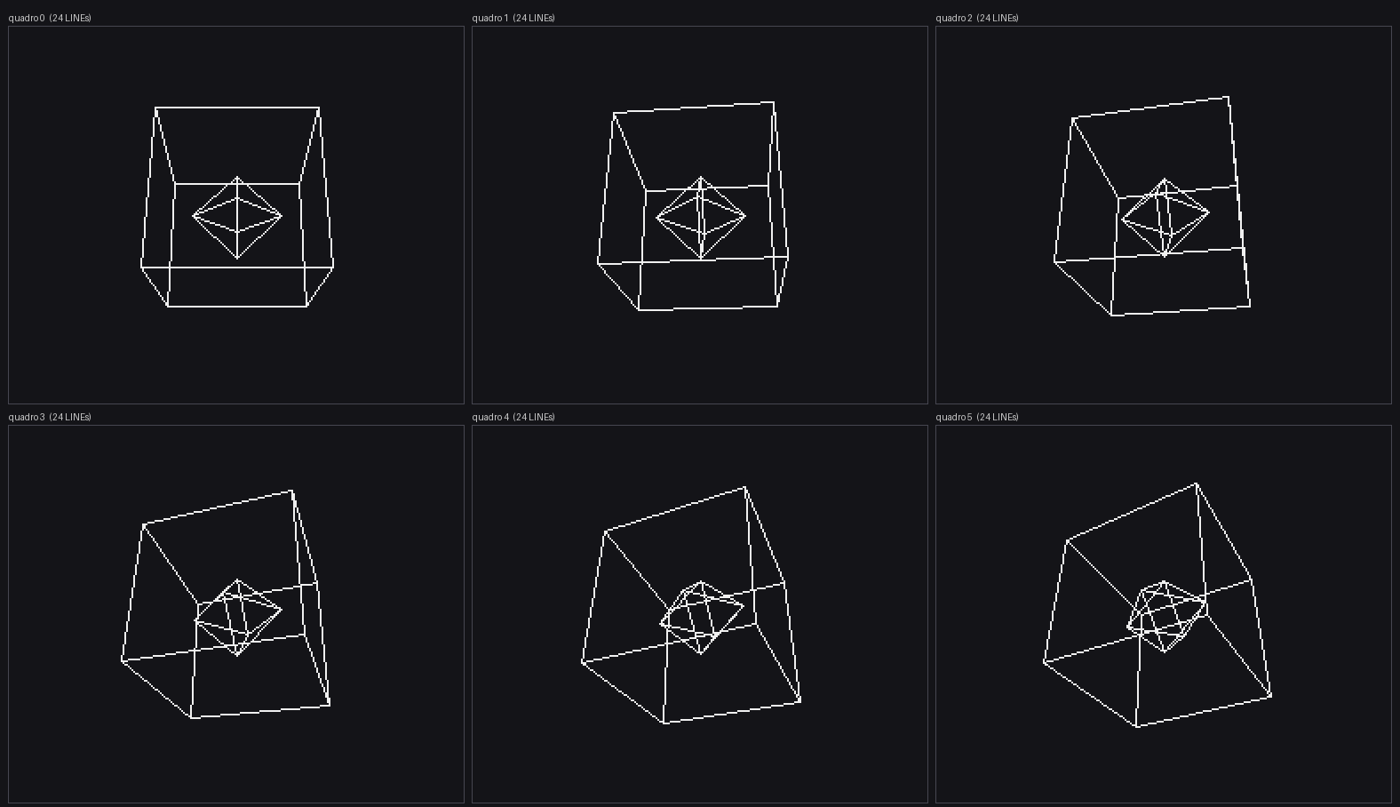
geo3d/docs/demo_frames.png
