alexmoncks/V9968_Cartridge/fpga/V9968_Cartridge_TangNano20K/src/history.md

## 2026-09-30 VDPコマンド互換性とタイミング改善

### コマンド互換性

- `ds4.rom`のデモ停止調査で、DIY逆走査時にコピー元SYが先にY=0へ到達しても、LMMM/HMMM/YMMMがコピー先DY側の境界しか終了条件に含めていないことを確認。コピー元・コピー先のうち先に上端へ到達する側で行を打ち切るよう`w_sy_overflow`を追加した。256KB VRAM時は既存の11bit Y座標を使い、Y=0を上端とする。
- [Issue #10](https://github.com/hra1129/V9968_Cartridge/issues/10)のSCREEN2（R#25 CMD=1）でHMMM/HMMV/YMMM/HMMCが1バイトおきに処理する問題を修正。非ビットマップモードをbyte単位として扱い、`w_next`と`w_nx_max`の刻み幅・終端値を一致させた。FG4のSCREEN5相当動作とSCREEN5/6/7/8の従来刻み幅は維持する。

### タイミング改善

- PnRレポートでclk85mのSetup違反16 endpoint、TNS -4.906 ns、最悪slack -0.459 nsを確認。最悪パスは`ff_fg4`から`w_next`、`w_next_sx`を経て`ff_xsel`のCEに至っていた。
- R#46書込み時に1/2/4のpixel stepを`ff_pixel_step`へ登録し、実行中の座標更新とNX終端判定で再利用するよう変更。FG4判定を画素処理の組合せ経路から外した。
- ModelSimで`vdp_command.v`単体コンパイルはエラー0、警告0。ユーザーがGowinビルド後にタイミング違反の解消を確認した。改修後の機能全体回帰は未実施。

## 2026-09-29 Fleet Commander II 起動停止の調査・ポート#1ラッチ修正

### 症状

- 実機MSX（内蔵VDP無効化）にV9968カートリッジを装着し、別スロットのASCII8Kメガロム「Fleet Commander II」を起動すると、212ライン化→画面一面シアンの後、黒画面になる前に停止した。本物のVDPでは正常起動する。

### 調査

- ROM(ASCII8K)の起動経路を逆アセンブルで追跡。H.STKE経由でバンク0 `405Eh` → `CHGMOD 7`、ページ1への64KB `BIGFIL` → RAM `D011h`（スロット走査・FM音源検出・H.TIMI設定） → バンク28 `4BE0h` → バンク29 `41EBh` → `4745h` で画面初期化。シアンは `6461h` の表示OFF（R#7=7の周辺色）。
- 停止地点の切り分けのため、指定地点で `DI`→R#7に目印色→`JR $` を実行するパッチROMを作成。バンク29 `41EBh`（赤）は到達、バンク2 `62FFh`（緑）は未到達で、停止箇所をバンク2 `6372h` 内に特定。
- `6372h` はポート99hへ `00,22,81,0F,86,00,88` の奇数バイトを書き込み、組がずれる。本物のV9938/V9958はポート98hの読み書きや、いずれかのポートの読み出しで99hの1バイト目の保持を取り消すため、直後の `CLRSPR` の98h書き込みで組が復帰する。V9968は99h書き込みでしか組の状態が変わらず、以降のレジスタ書き込みがずれ続け、CE待ちから抜けられなくなっていた（誤ったR#46書き込みで転送待ちコマンドが起動したと推定）。
- ゲーム内のステータス読み出し（99h read）は、CE待ち（S#2 bit0）、HMMC/LMMCループ（S#2 bit0/bit7）、POINT（S#7）のみ。S#0のF、S#1、S#2のHR/VRでの分岐はなく、ステータス値の差異は原因ではなかった。
- 実機で `SCREEN 7`→表示OFF→R#8=0→`CLRSPR`→`CLS`→`SCREEN 5` を99hへ必ず2バイトずつ書くBASICで再現したが停止しなかった。奇数バイト書き込みが再現条件。

### openMSXの挙動（`VDP.cc` の `writeIO`/`readIO`）

- 98h書き込み、および98h〜9Bhいずれの読み出しでも `registerDataStored`（99hの1バイト目保持）を取り消す。
- 9Ah（パレット1バイト目）と9Bhの書き込みは保持を取り消さないが、共有の `dataLatch` を上書きする。パレット2バイト目のR/Bもこの `dataLatch` から取る。
- パレットのバイトカウンタ（`paletteDataStored`）はR#16書き込みでのみリセットされる。

### RTL変更（`vdp_cpu_interface.v`）

- 98h書き込み、またはいずれかのポートの読み出しで `ff_2nd_access` を0に戻す。
- 通常パレット（V9938形式）の1バイト目を `ff_1st_byte`（99h/9Bhと共有）に格納し、2バイト目でそこからR/Bを取り出すよう変更。
- 拡張パレットモード（R/G/B 3バイト）のカウンタは独立のまま、R#16書き込みで0に戻す挙動も維持。拡張パレットの書き込みは共有ラッチを変更しない。
- 実機でFleet Commander IIの起動を確認（ラッチ取り消し修正時点）。パレットのopenMSX準拠化は合成・実機未確認。

### テスト

- `test_vdp_cpu_interface/tb.sv` に `tb_port1_latch_reset` を追加（test001〜test012）。98h書き込み・98h読み出し・ステータス読み出しでの取り消し、9Ah/9Bh書き込みでの保持と値の置き換え、パレットR/Bの共有ラッチ参照、R#16およびステータス読み出しとパレットカウンタの関係、拡張パレットの独立性を確認。`run.bat` から実行するよう追加。
- ModelSimで全件エラー0。修正前RTLではtest002で失敗することを確認。既存の `tb_sprite_overmap_status` も通過。

### 注意点

- `test_vdp_cpu_interface` の既存 `tb` モジュールはDUTのポート構成が古く、vsimの読み込みで失敗する（今回の変更以前から）。
- 9Ahが共有ラッチを上書きする挙動はopenMSXの実装に準拠したもので、実機での裏付けは未確認。
- R#8のVR=0でCPUアドレスを16KB折り返す実装は、openMSX（CPU・コマンド・表示すべてに16KBマスクとアドレス入れ替え）と異なる。今回のゲームでは実際にはR#8が書き込まれないため影響なし。

## 2026-09-27 水平スクロール調査・修正

### 症状と調査

- 実機のロゴ表示に水平帯状の乱れが発生。R#27をBG側だけ8pixel境界で反映する変更では乱れが大きくなったため、BGとスプライトでR#27の反映タイミングを分けず、ライン単位に戻した。
- 改善後も数ラインに一度、前のR#26値が使われるように見える症状が報告された。残るずれは8pixel未満とのこと。
- 参考実装 `OTHERS/ocm-pld-dev/esemsx3/src/video` のV9958 VHDLを確認。R#26はCPU書込み値と表示側の有効値を分け、HSYNCパルスで有効化し、描画側は8ドットグループ先頭で座標に取り込む。R#27はSSGの表示開始位置補正とスプライト表示位置で別々に使用されていた。

### RTL変更

- `vdp_timing_control_ssg.v` のR#26/R#27有効値を、スクロール補正後のXが`-1 pixel`、最終サブフェーズとなる位置で同時にラッチするよう変更。
- イベント位置はラッチ済みR#27ではなく入力中の`reg_horizontal_offset_l`から計算する。これによりR#27を増減した場合も、新しい値に対応する次の表示開始直前に両レジスタを更新する。
- 旧R#26の8pixel境界ごとの更新はやめ、表示中は有効値を維持する。
- BGとスプライトには共通の`horizontal_offset_l`を使用する。ユーザー変更により低位ラッチ名は`ff_horizontal_offset_l`。

### テストと確認

- `test_vdp_timing_control_ssg/tb.sv` の`tb_scroll_group_alignment`で、R#26/R#27が表示中に変化しないこと、表示開始前に同時更新されることをR#27の0→3、3→0の両方向で確認。
- VRAM要求時の`ff_phase`とサブフェーズを検査し、SCREEN5のVRAMアドレスXグループがR#26/R#27適用後の期待座標と一致することを確認。
- `tb_scroll_midline`も同時ラッチの境界期待値に更新。
- ModelSimで両専用テストを実行し、コンパイル・シミュレーションともエラー0、警告0。編集ファイルの診断エラーなし。`git diff --check`も通過（CRLF正規化に関する警告のみ）。
- 実機では途中段階で乱れの改善と8pixel未満の残りずれが報告された。最終のR#26/R#27同時ラッチ変更後の実機確認、および全体回帰テストは未実施。

### 次回の注意点

- R#26は8pixel単位の高位オフセットなので、`w_pos_x[2:0]`だけを見るテストではR#26のアドレス群ずれを検出できない。VRAMアドレスのグループ番号と要求位相を直接照合する。
- R#27=0で表示開始直前のX=-1は、14bit座標では`14'h3FFF`。テスト期待値で符号付き折返しを考慮する。
- R#26/R#27のCPU書込み値と、描画に使うラッチ済み値を区別する。表示中の書込みが即時に描画へ反映される前提を置かない。
- R#27をBGだけ8pixel境界で切り替えると、VRAM取得位相と参照座標のグループがずれ得る。個別の表示系統だけ更新タイミングを変えない。

## 2026-09-27 共有VRAMキャッシュと映像の水平拡大

### 共有VRAMキャッシュ

- `vdp_command_cache.v`を32bitライン・8-way完全連想・LRU置換に変更。CPUとVDPコマンドの8bitアクセスを共通キャッシュへ通し、同時要求時はCPUを優先する。CPUアドレスはインターリーブ変換後にキャッシュへ渡す。
- CPUアクセスを受理するたび256クロックの無アクセスカウンタを再設定し、満了時に自動フラッシュする。コマンド終了時の明示フラッシュと完了通知も維持した。
- GowinのPnRでsetupスラック-5.388nsの違反を確認。インターリーブ設定からタグ比較・LRU選択・書き戻しアドレス選択までが同一サイクルに連なっていたため、要求の保持、ライン選択、データ処理をFFで分けた。8-wayは維持。
- `test_command_cache/tb.sv`でLRU、書きかけラインの読み出し、CPU/コマンド間の可視性と優先順位、256クロックタイマーの再設定・自動フラッシュを確認。FF追加後の全件回帰はModelSim Starter Editionでエラー0、警告0。
- FF追加後、ユーザーが合成時のタイミング違反解消とFPGA実機での期待どおりの動作を確認。

### 映像の水平拡大

- `vdp_video_out.v`はBresenham式の水平座標進行で前ラインの画素を読み、水平補間後に垂直2倍表示の走査線ゲインを適用する。非インターレースでは暗い画素ほど間のラインを暗くし、インターレースでは間のラインを黒にする。
- 同じ幅の縦縞がX位置により太さを変えて見える件を調査。上位の係数は約0～63だったが、`vdp_video_out_bilinear.v`は256分率として解釈していた。黒白境界の中間係数32では、期待する約128ではなく32/223が出ていた。
- 係数の取り出しを`w_normalized_numerator[14:7]`から`[12:5]`に変更。補間器や走査線ゲインは変更しない。中間係数128で黒→白、白→黒の出力がどちらも`0x80`となることをModelSimで確認。
- `test_vdp_video_out/tb.sv`に座標進行中の係数チェックを追加。映像テストはModelSim Starter Editionでエラー0、警告0。ユーザーが実機で見た目の明確な改善を確認。

### 注意点

- キャッシュを通らない画面・スプライト読み出しは、dirtyラインが書き戻されるまで更新前のVRAMを見る可能性がある。CPUの無アクセス時は256クロック後の自動フラッシュで書き戻される。
- 係数修正の前後で、水平座標進行と補間タップの位相を画素ごとに照合するテストは追加していない。必要になった場合は出力画素値を期待値と比較する。
