alexmoncks/V9968_Cartridge/geo3d/docs/kicad/geo3d_logic.pdf

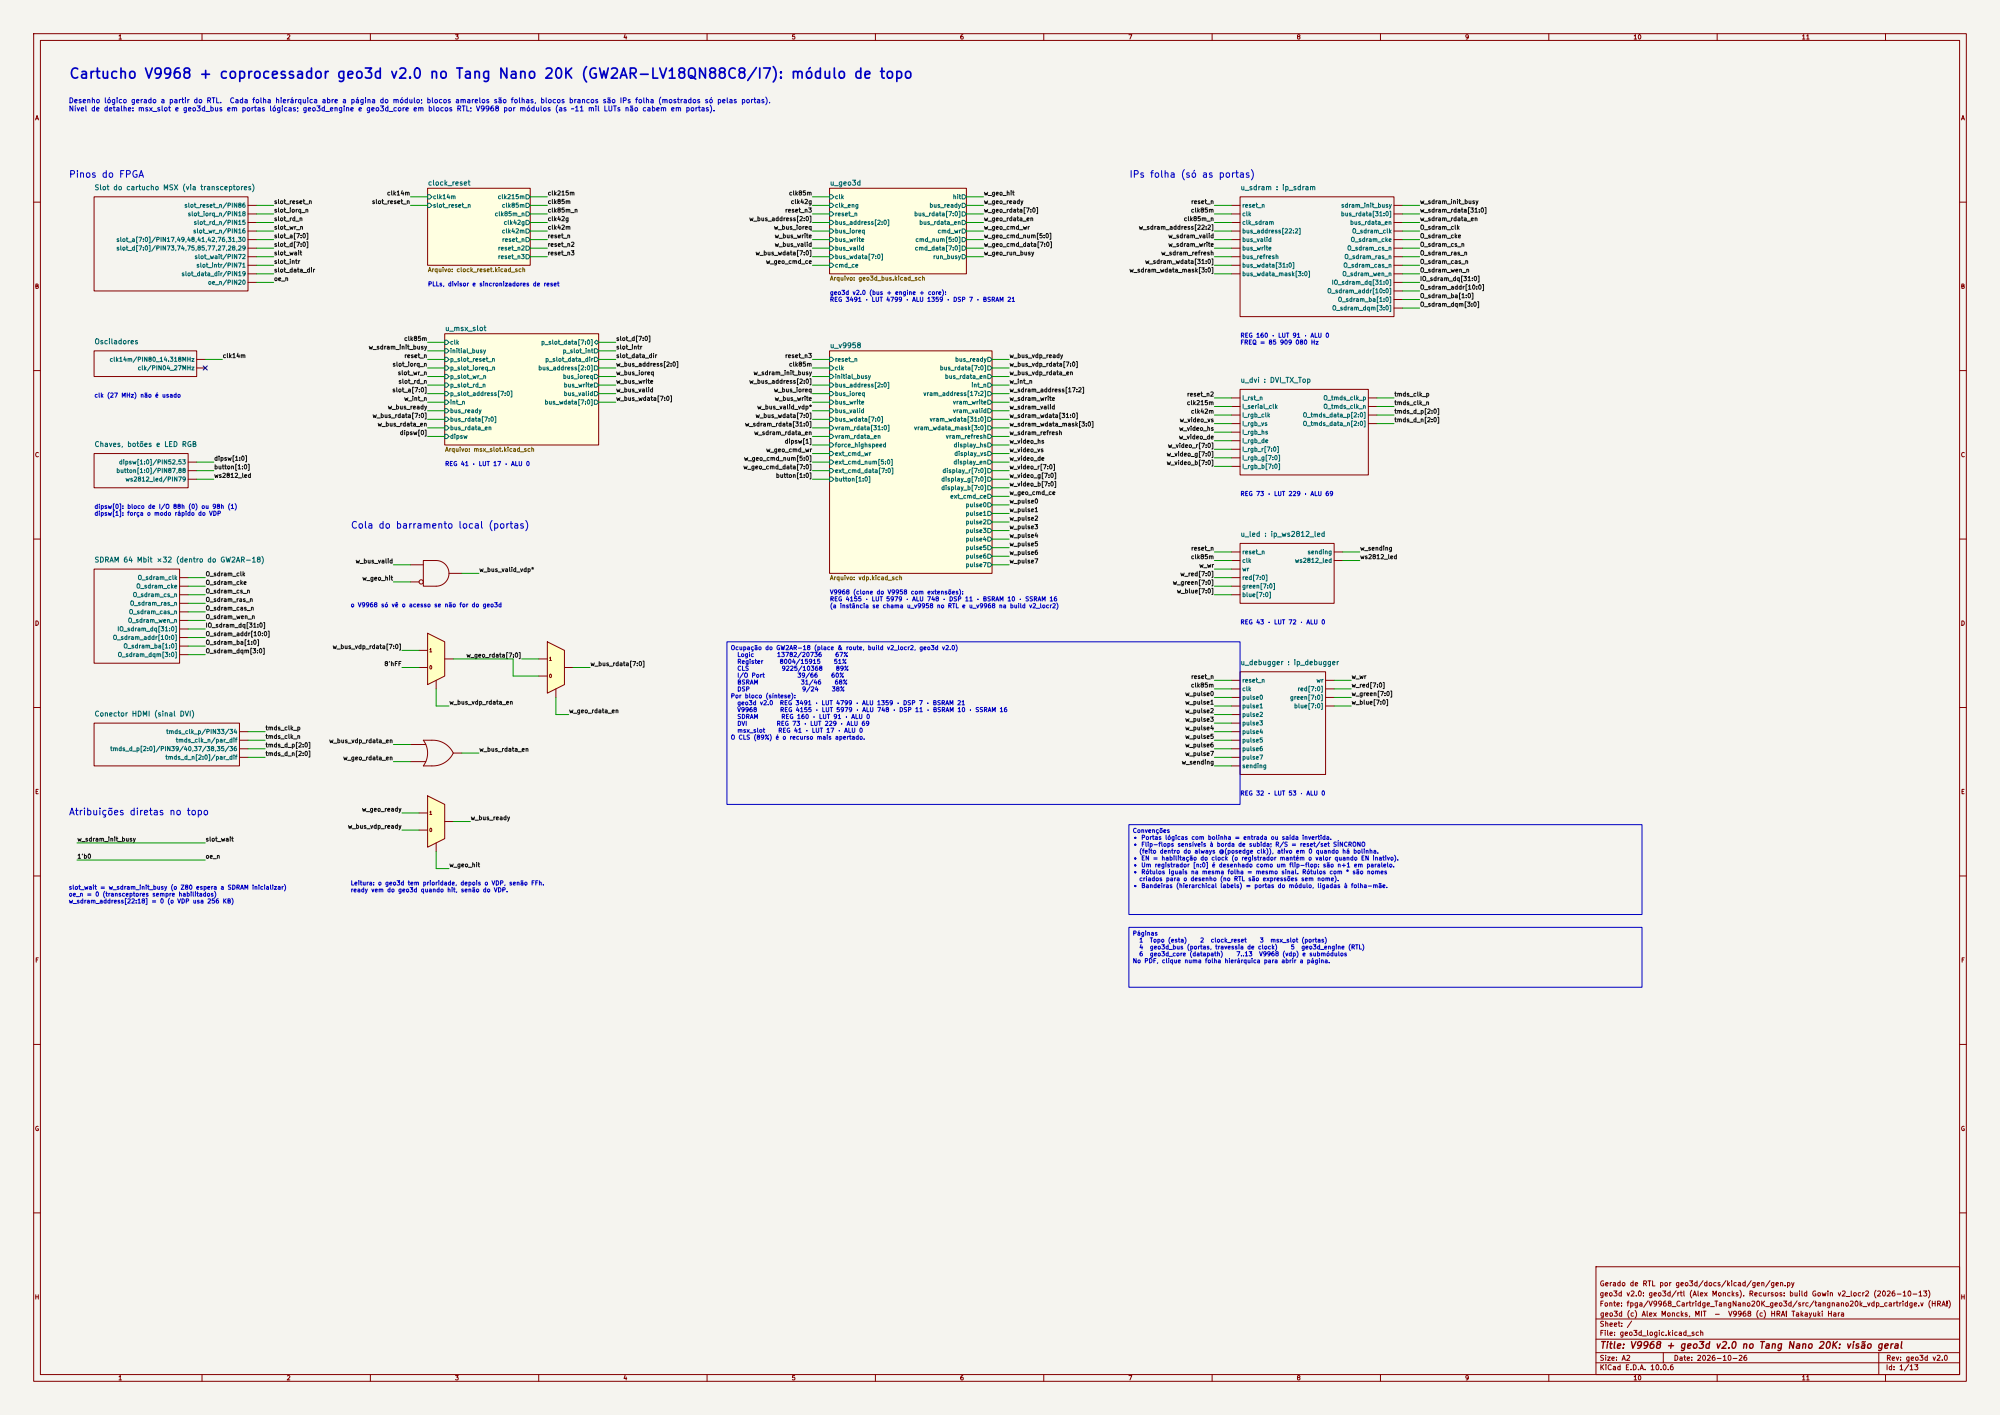
[picture p51: page 1]

Cartucho V9968 + coprocessador geo3d v2.0 no Tang Nano 20K (GW2AR-LV18QN88C8/I7): módulo de topo

Desenho lógico gerado a partir do RTL. Cada folha hierárquica abre a página do módulo; blocos amarelos são folhas, blocos brancos são IPs folha (mostrados só pelas portas).
Nível de detalhe: msx_slot e geo3d_bus em portas lógicas; geo3d_engine e geo3d_core em blocos RTL; V9968 por módulos (as ~11 mil LUTs não cabem em portas).

IPs folha (só as portas)

Slot do cartucho MSX (via transceptores)

PLLs, divisor e sincronizadores de reset Atribuições diretas no topo

geo3d v2.0 (bus + engine + core): REG 3491 · LUT 4799 · ALU 1359 · DSP 7 · BSRAM 21

REG 160 · LUT 91 · ALU 0
FREQ = 85 909 080 Hz REG 73 · LUT 229 · ALU 69

Chaves, botões e LED RGB

dipsw[0]: bloco de I/O 88h (0) ou 98h (1)
dipsw[1]: força o modo rápido do VDP

SDRAM 64 Mbit ×32 (dentro do GW2AR-18)

V9968 (clone do V9958 com extensões): REG 4155 · LUT 5979 · ALU 748 · DSP 11 · BSRAM 10 · SSRAM 16

o V9968 só vê o acesso se não for do geo3d
w_bus_vdp_rdata_en w_bus_rdata_en w_geo_hit

(a instância se chama u_v9958 no RTL e u_v9968 na build v2_locr2)

(feito dentro do always @(posedge clk)), ativo em 0 quando há bolinha. • EN = habilitação do clock (o registrador mantém o valor quando EN inativo). • Um registrador [n:0] é desenhado como um flip-flop: são n+1 em paralelo. • Rótulos iguais na mesma folha = mesmo sinal. Rótulos com * são nomes criados para o desenho (no RTL são expressões sem nome). • Bandeiras (hierarchical labels) = portas do módulo, ligadas à folha-mãe. Ocupação do GW2AR-18 (place & route, build v2_locr2, geo3d v2.0)
Por bloco (síntese):

Conector HDMI (sinal DVI)

Convenções • Portas lógicas com bolinha = entrada ou saída invertida. • Flip-flops sensíveis à borda de subida; R/S = reset/set SÍNCRONO

slot_wait = w_sdram_init_busy (o Z80 espera a SDRAM inicializar) oe_n = 0 (transceptores sempre habilitados)

Leitura: o geo3d tem prioridade, depois o VDP, senão FFh. ready vem do geo3d quando hit, senão do VDP.

Gerado de RTL por geo3d/docs/kicad/gen/gen.py
geo3d v2.0: geo3d/rtl (Alex Moncks). Recursos: build Gowin v2_locr2 (2026-10-13)
Fonte: fpga/V9968_Cartridge_TangNano20K_geo3d/src/tangnano20k_vdp_cartridge.v (HRA!)
geo3d (c) Alex Moncks, MIT - V9968 (c) HRA! Takayuki Hara
Sheet: /
File: geo3d_logic.kicad_sch
Title: V9968 + geo3d v2.0 no Tang Nano 20K: visão geral

Size: A2 | Rev: geo3d v2.0
KiCad E.D.A. 10.0.6 | Id: 1/13

1 | 2 | 3 | 4 | 5 | 6 | 7 | 8
1 | 2 | 3 | 4 | 5 | 6 | 7 | 8

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
## F Date: 2026-10-26

Size: A3 | Rev: geo3d v2.0

# Title: Clocks (PLLs) e sincronizadores de reset

## File: clock_reset.kicad_sch

## Sheet: /clock_reset/

# geo3d (c) Alex Moncks, MIT - V9968 (c) HRA! Takayuki Hara

## Fonte: fpga/V9968_Cartridge_TangNano20K_geo3d/src/tangnano20k_vdp_cartridge.v (HRA!)

## Folha de desenho: estes elementos estão no próprio módulo de topo

D | Q
rPLL clkin | clkout

## lock u_pll : Gowin_rPLL

D | Q
D | Q
D | Q
D | Q

# rPLL

clkin | clkout clkoutp

clkoutd

## lock u_pll2 : Gowin_rPLL2

÷2 hclkin

resetn

## clkout u_clkdiv : Gowin_CLKDIV

D | Q
D | Q
D | Q
D | Q

slot_reset_n

clk42g

clk14m

slot_reset_n

slot_reset_n

clk14m

clk215m

clk85m

clk85m_n

clk42m

reset_n

reset_n2

reset_n3

clk85m

clk42m

pll_lock85

clk85m

clk215m

clk215m | clk85m

clk85m_n

clk42m

reset_n3

clk42m

clk42g

clk42m

reset_n

reset_n2

clk85m

clk85m

clk85m

pll_lock85

clk85m

clk85m

clk42g

clk85m

reset_n2

reset_n3

reset_n

clk85m_n

clk42m

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

(feito dentro do always @(posedge clk)), ativo em 0 quando há bolinha. • EN = habilitação do clock (o registrador mantém o valor quando EN inativo). • Um registrador [n:0] é desenhado como um flip-flop: são n+1 em paralelo. • Rótulos iguais na mesma folha = mesmo sinal. Rótulos com * são nomes criados para o desenho (no RTL são expressões sem nome). • Bandeiras (hierarchical labels) = portas do módulo, ligadas à folha-mãe. Clocks e reset (parte do módulo de topo tangnano20k_vdp_cartridge)

# Saídas desta folha

Tudo deriva de clk14m (14,31818 MHz, pino 80). O oscilador de 27 MHz da placa (clk, pino 4) não é usado.
slot_reset_n (RESET do MSX) passa por 3 flip-flops em cada domínio antes de virar reset síncrono.
1. PLLs e divisor (primitivas Gowin rPLL / CLKDIV) ×6 → clk85m 85,91 MHz (VDP, barramento, SDRAM)

clkoutp: 85,91 MHz defasado 180° (clock da SDRAM) clkoutd: ÷2 da própria PLL → clk42g 42,95 MHz (engine geo3d) ×15 → 214,77 MHz (serializador TMDS do HDMI)

# 2. Sincronizadores de reset (3 flip-flops, syn_preserve)

clk42m 42,95 MHz (pixel clock do DVI). O geo3d usa clk42g e não
clk42m: o CLKDIV fica 3-4 ns defasado das saídas da PLL no modelo de timing. ff_reset_n0..2 em clk85m → reset_n: msx_slot, SDRAM, LED, debugger

ff_reset2_n0..2 em clk42m → reset_n2: DVI (HDMI)

ff_reset3_n0..2 em clk85m → reset_n3: geo3d e V9968

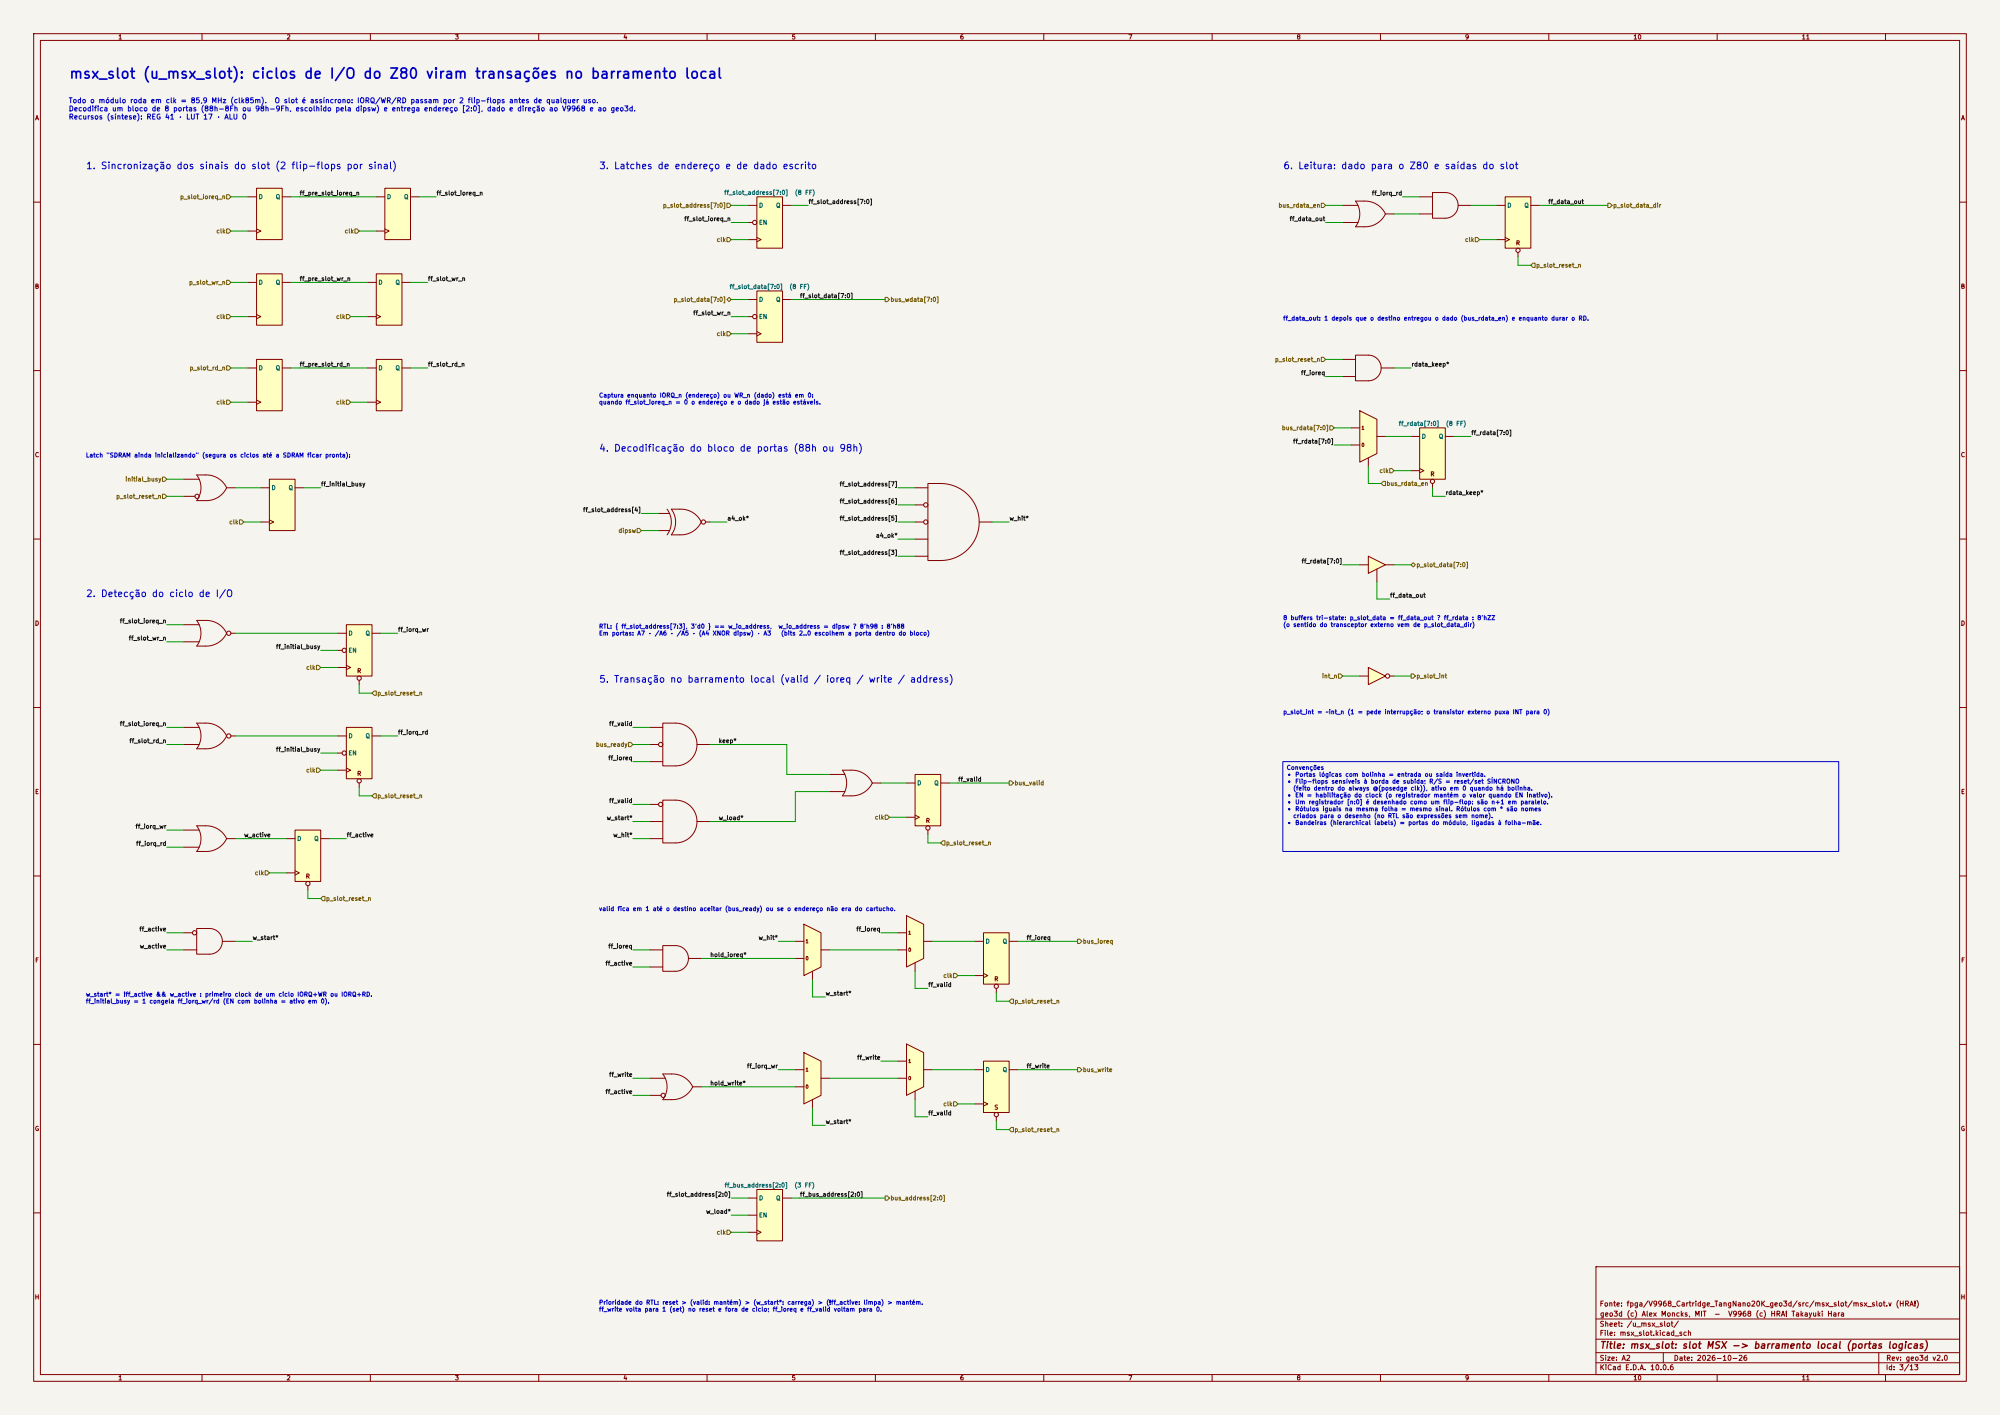
[picture p52: page 3]

(feito dentro do always @(posedge clk)), ativo em 0 quando há bolinha. • EN = habilitação do clock (o registrador mantém o valor quando EN inativo). • Um registrador [n:0] é desenhado como um flip-flop: são n+1 em paralelo. • Rótulos iguais na mesma folha = mesmo sinal. Rótulos com * são nomes criados para o desenho (no RTL são expressões sem nome). • Bandeiras (hierarchical labels) = portas do módulo, ligadas à folha-mãe. msx_slot (u_msx_slot): ciclos de I/O do Z80 viram transações no barramento local

Todo o módulo roda em clk = 85,9 MHz (clk85m). O slot é assíncrono: IORQ/WR/RD passam por 2 flip-flops antes de qualquer uso. Decodifica um bloco de 8 portas (88h-8Fh ou 98h-9Fh, escolhido pela dipsw) e entrega endereço [2:0], dado e direção ao V9968 e ao geo3d.

Recursos (síntese): REG 41 · LUT 17 · ALU 0

1. Sincronização dos sinais do slot (2 flip-flops por sinal)

3. Latches de endereço e de dado escrito

ff_data_out: 1 depois que o destino entregou o dado (bus_rdata_en) e enquanto durar o RD.

4. Decodificação do bloco de portas (88h ou 98h)

Latch "SDRAM ainda inicializando" (segura os ciclos até a SDRAM ficar pronta):

2. Detecção do ciclo de I/O

8 buffers tri-state: p_slot_data = ff_data_out ? ff_rdata : 8'hZZ RTL:

(o sentido do transceptor externo vem de p_slot_data_dir) { ff_slot_address[7:3], 3'd0 } == w_io_address, w_io_address = dipsw ? 8'h98 : 8'h88

valid fica em 1 até o destino aceitar (bus_ready) ou se o endereço não era do cartucho. 5. Transação no barramento local (valid / ioreq / write / address)

p_slot_int = ~int_n (1 = pede interrupção; o transistor externo puxa INT para 0)

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

w_start* = !ff_active && w_active : primeiro clock de um ciclo IORQ+WR ou IORQ+RD. ff_initial_busy = 1 congela ff_iorq_wr/rd (EN com bolinha = ativo em 0).

Prioridade do RTL: reset > (valid: mantém) > (w_start*: carrega) > (!ff_active: limpa) > mantém. ff_write volta para 1 (set) no reset e fora de ciclo; ff_ioreq e ff_valid voltam para 0.

Fonte: fpga/V9968_Cartridge_TangNano20K_geo3d/src/msx_slot/msx_slot.v (HRA!)

Sheet: /u_msx_slot/
File: msx_slot.kicad_sch
Title: msx_slot: slot MSX -> barramento local (portas logicas)

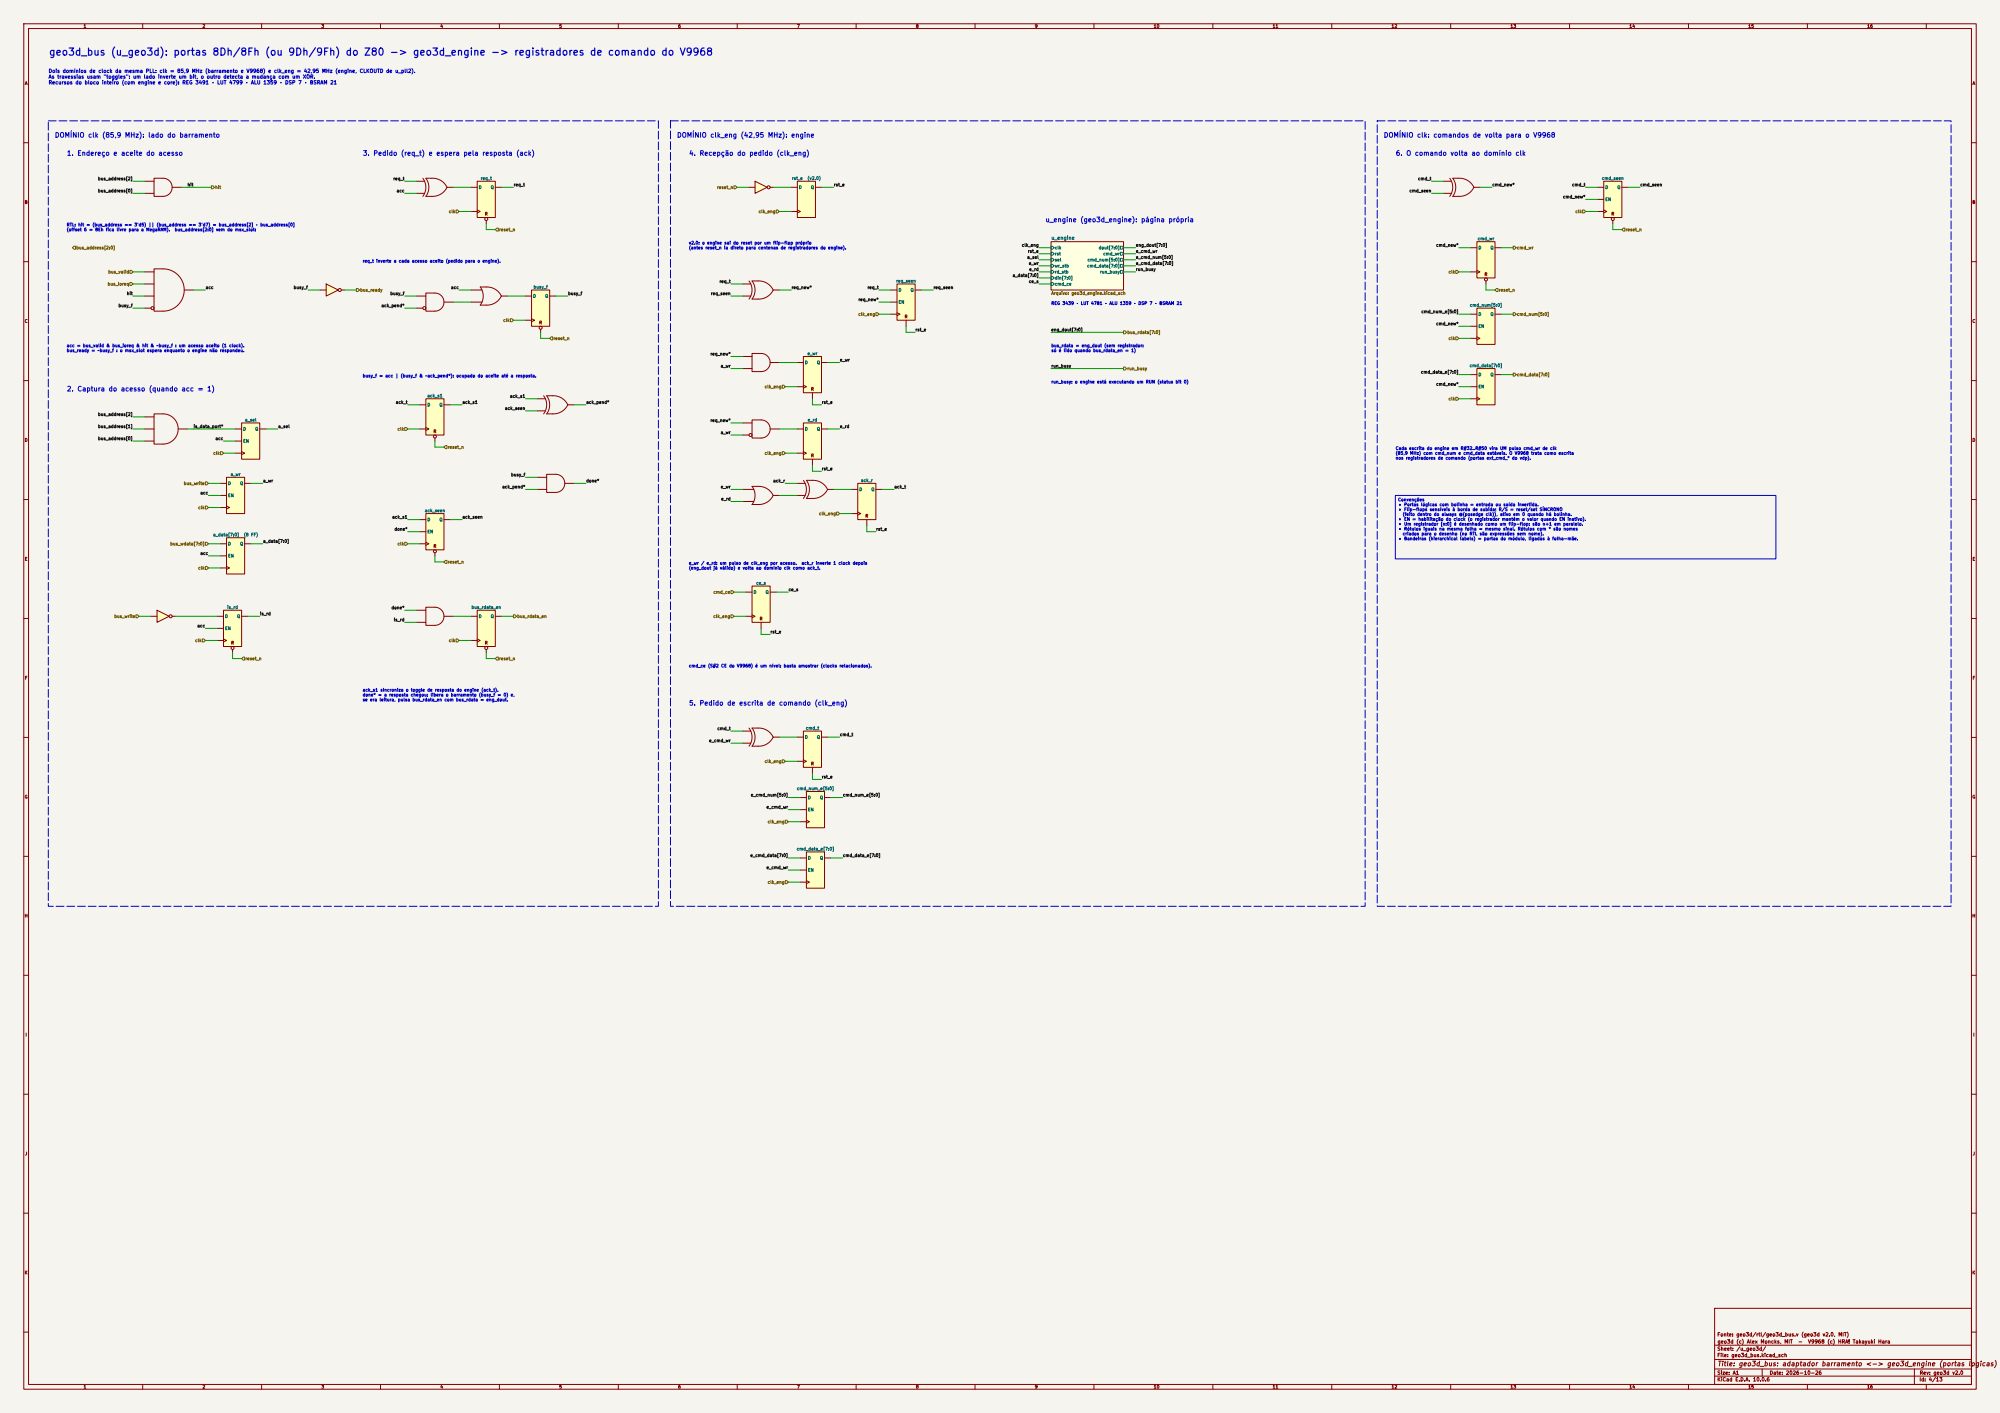
[picture p53: page 4]

geo3d_bus (u_geo3d): portas 8Dh/8Fh (ou 9Dh/9Fh) do Z80 -> geo3d_engine -> registradores de comando do V9968

Dois domínios de clock da mesma PLL: clk = 85,9 MHz (barramento e V9968) e clk_eng = 42,95 MHz (engine, CLKOUTD de u_pll2).
As travessias usam "toggles": um lado inverte um bit, o outro detecta a mudança com um XOR.
Recursos do bloco inteiro (com engine e core): REG 3491 · LUT 4799 · ALU 1359 · DSP 7 · BSRAM 21

DOMÍNIO clk (85,9 MHz): lado do barramento

DOMÍNIO clk: comandos de volta para o V9968

1. Endereço e aceite do acesso

3. Pedido (req_t) e espera pela resposta (ack)

6. O comando volta ao domínio clk

v2.0: o engine sai do reset por um flip-flop próprio
(antes reset_n ia direto para centenas de registradores do engine).

REG 3439 · LUT 4781 · ALU 1359 · DSP 7 · BSRAM 21

2. Captura do acesso (quando acc = 1)

run_busy: o engine está executando um RUN (status bit 0)

Cada escrita do engine em R#32..R#50 vira UM pulso cmd_wr de clk
(85,9 MHz) com cmd_num e cmd_data estáveis. O V9968 trata como escrita
nos registradores de comando (portas ext_cmd_* do vdp).

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

(eng_dout já válido) e volta ao domínio clk como ack_t.

cmd_ce (S#2 CE do V9968) é um nível: basta amostrar (clocks relacionados).

ack_s1 sincroniza o toggle de resposta do engine (ack_t). done* = a resposta chegou: libera o barramento (busy_f = 0) e, se era leitura, pulsa bus_rdata_en com bus_rdata = eng_dout.

5. Pedido de escrita de comando (clk_eng)

Sheet: /u_geo3d/
File: geo3d_bus.kicad_sch
Title: geo3d_bus: adaptador barramento <-> geo3d_engine (portas logicas)

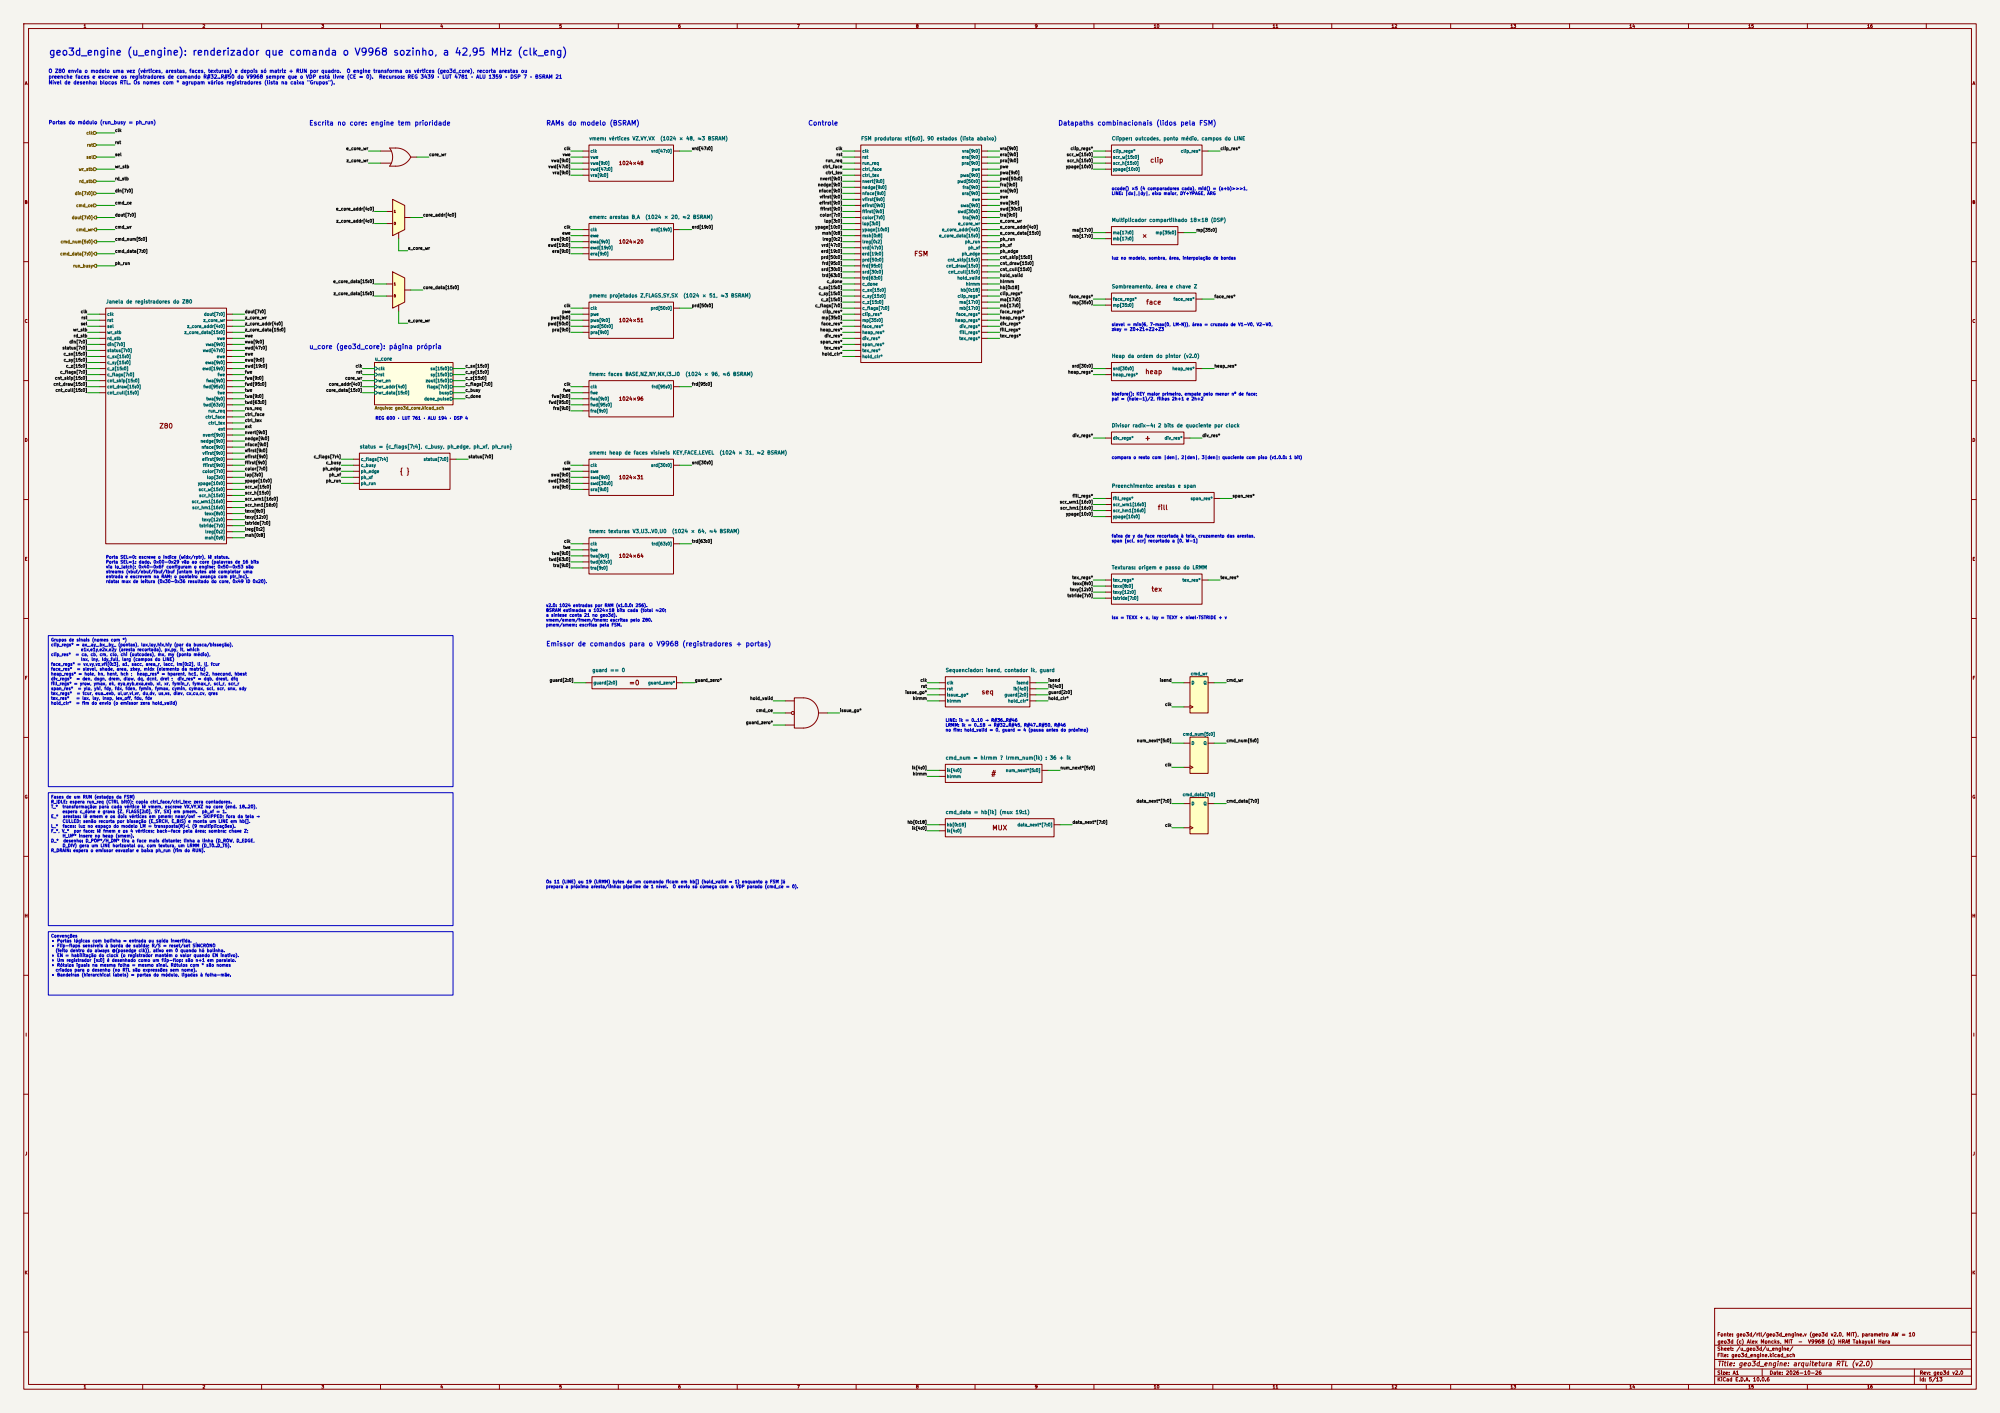
[picture p54: page 5]

geo3d_engine (u_engine): renderizador que comanda o V9968 sozinho, a 42,95 MHz (clk_eng)

O Z80 envia o modelo uma vez (vértices, arestas, faces, texturas) e depois só matriz + RUN por quadro. O engine transforma os vértices (geo3d_core), recorta arestas ou
preenche faces e escreve os registradores de comando R#32..R#50 do V9968 sempre que o VDP está livre (CE = 0). Recursos: REG 3439 · LUT 4781 · ALU 1359 · DSP 7 · BSRAM 21
Nível de desenho: blocos RTL. Os nomes com * agrupam vários registradores (lista na caixa "Grupos").
cmd_data[7:0] clk

Escrita no core: engine tem prioridade

RAMs do modelo (BSRAM)

ocode() ×5 (4 comparadores cada), mid() = (a+b)>>>1, LINE: |dx|,|dy|, eixo maior, DY+YPAGE, ARG Controle
lop[3:0] clk

luz no modelo, sombra, área, interpolação de bordas Datapaths combinacionais (lidos pela FSM)

vrd[47:0] vmem: vértices VZ,VY,VX (1024 × 48, ≈3 BSRAM)

FSM produtora: st[6:0], 90 estados (lista abaixo)

Clipper: outcodes, ponto médio, campos do LINE

erd[19:0] emem: arestas B,A (1024 × 20, ≈2 BSRAM)

pmem: projetados Z,FLAGS,SY,SX (1024 × 51, ≈3 BSRAM)

Janela de registradores do Z80

slevel = min(6, 7·max(0, LM·N)), área = cruzado de V1-V0, V2-V0,
zkey = Z0+Z1+Z2+Z3

Heap da ordem do pintor (v2.0)

fmem: faces BASE,NZ,NY,NX,I3..I0 (1024 × 96, ≈6 BSRAM)

hbefore(): KEY maior primeiro, empate pelo menor nº de face;
pai = (hole-1)/2, filhos 2h+1 e 2h+2

vmem/emem/fmem/tmem: escritas pelo Z80. pmem/smem: escritas pela FSM. REG 600 · LUT 761 · ALU 194 · DSP 4

srd[30:0] smem: heap de faces visíveis KEY,FACE,LEVEL (1024 × 31, ≈2 BSRAM)

compara o resto com |den|, 2|den|, 3|den|; quociente com piso (v1.0.0: 1 bit)

faixa de y da face recortada à tela, cruzamento das arestas, span [scl, scr] recortado a [0, W-1]

Porta SEL=0: escreve o índice (widx/rptr), lê status. Porta SEL=1: dado. 0x00-0x29 vão ao core (palavras de 16 bits

via lo_latch); 0x40-0x6F configuram o engine; 0x50-0x53 são
streams (vbuf/ebuf/fbuf/tbuf juntam bytes até completar uma
entrada e escrevem na RAM; o ponteiro avança com ptr_inc). rdata: mux de leitura (0x30-0x36 resultado do core, 0x49 ID 0x20).

tex_res* Texturas: origem e passo do LRMM

v2.0: 1024 entradas por RAM (v1.0.0: 256). BSRAM estimadas a 1024×18 bits cada (total ≈20; a síntese conta 21 no geo3d).

lsx = TEXX + u, lsy = TEXY + nível·TSTRIDE + v

Grupos de sinais (nomes com *)
clip_regs* = ax_,ay_,bx_,by_ (pontas), lox,loy,hix,hiy (par da busca/bisseção),

Emissor de comandos para o V9968 (registradores + portas)

e1x,e1y,e2x,e2y (aresta recortada), px,py, it, which

lnx, lny, ldy_full, larg (campos do LINE)

face_regs* = vx,vy,vz,vfl[0:3], a1, sacc, area_r, lacc, lm[0:2], li, lj, fcur

guard[2:0] hold_clr* Sequenciador: isend, contador ik, guard

LINE: ik = 0..10 → R#36..R#46
LRMM: ik = 0..18 → R#32..R#45, R#47..R#50, R#46
no fim: hold_valid = 0, guard = 4 (pausa antes do próximo)

D_DIV) gera um LINE horizontal ou, com textura, um LRMM (D_T0..D_T5). R_DRAIN: espera o emissor esvaziar e baixa ph_run (fim do RUN).

Os 11 (LINE) ou 19 (LRMM) bytes de um comando ficam em hb[] (hold_valid = 1) enquanto a FSM já

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

Fonte: geo3d/rtl/geo3d_engine.v (geo3d v2.0, MIT), parametro AW = 10

1 | 2 | 3 | 4 | 5 | 6 | 7 | 8 | 9 | 10 | 11 | 12 | 13 | 14 | 15 | 16
1 | 2 | 3 | 4 | 5 | 6 | 7 | 8 | 9 | 10 | 11 | 12 | 13 | 14 | 15 | 16

AB

C

D

E

### FGH

### IJK

AB

C

D

E

### FGH

## IJK Date: 2026-10-26

Size: A1 | Rev: geo3d v2.0

# Title: geo3d_core: datapath da transformacao e projecao

## File: geo3d_core.kicad_sch

## Sheet: /u_geo3d/u_engine/u_core/

## Fonte: geo3d/rtl/geo3d_core.v (MIT)

×

acoord[16:0]

f[15:0]

prod[32:0]

## Multiplicador 17×16

# reg

clk prod[32:0] st_mul* | num[32:0] num (S_MUL)

{ }

outc[3:0]

busy

f_ovfy

f_ovfx

f_near

flags[7:0]

## flags = {outc, busy, f_ovfy, f_ovfx, f_near} −

clk cy[15:0]

sq[16:0] st_acc* axis

sy[15:0]

## sy = sat16(CY - sq) (S_ACC, axis = 1)

# MUX

m[0:8]

v[0:2]

col[1:0]

m_row0*[15:0]

m_row1*[15:0]

m_row2*[15:0]

vcol[15:0]

## Seleção da coluna col

±

q[15:0]

coord[17:0]

sq[16:0]

## sq = coord < 0 ? -q : q ×

m_row2*[15:0]

vcol[15:0]

p2[31:0]

## Multiplicador 16×16 com sinal (p2)

+

clk cx[15:0]

sq[16:0] st_acc* axis

## sx[15:0] sx = sat16(CX + sq) (S_ACC, axis = 0)

Σ

clk p2[31:0] st_mac* start | acc2[33:0]

## Acumulador acc2 (34 bits): zera em S_IDLE+start, soma em S_MAC

# FSM

clk

rst start col[1:0]

cnt[3:0] near* ovf* axis

# state[3:0] st_mac* st_xf* st_chk* st_mul* st_ovf* st_div* st_acc* st_out* busy

done_pulse

## Máquina de estados (9 estados)

≥

num[32:0]

zc[17:0] | ovf* num ≥ zc·2^15 → satura em 32767

# sat

clk acc0[33:0]

t[0] st_xf* | xc[17:0] xc = sat18((acc0 >>> 14) + TX) (reg. em S_XF)

# sat

clk acc1[33:0]

t[1] st_xf*

yc[17:0]

## yc = sat18((acc1 >>> 14) + TY) (reg. em S_XF)

# sat

clk acc2[33:0]

t[2] st_xf* | zc[17:0] zc = sat18((acc2 >>> 14) + TZ) (reg. em S_XF)

# sat

clk

zc[17:0] st_chk* | zout[15:0]

## zout = sat16(zc) (S_CHK) <

zc[17:0]

znear[15:0] | near* zc < ZNEAR ou zc ≤ 0 → vértice atrás ×

m_row1*[15:0]

vcol[15:0]

p1[31:0]

## Multiplicador 16×16 com sinal (p1)

# regs

clk

rst wr_en wr_addr[4:0]

wr_data[15:0]

m[0:8]

t[0:2]

v[0:2]

f[15:0]

cx[15:0]

cy[15:0]

znear[15:0]

w[15:0]

## h[15:0] start Banco de registradores (decodificador de wr_addr)

coord[17:0] |x| acoord[16:0]

## valor absoluto

Σ

clk p0[31:0] st_mac* start | acc0[33:0]

## Acumulador acc0 (34 bits): zera em S_IDLE+start, soma em S_MAC

1

0 | ×

m_row0*[15:0]

vcol[15:0]

p0[31:0]

## Multiplicador 16×16 com sinal (p0)

Σ

clk p1[31:0] st_mac* start | acc1[33:0]

## Acumulador acc1 (34 bits): zera em S_IDLE+start, soma em S_MAC

≥ −

rem[16:0]

low[15:0]

zc[17:0] | ge diff[17:0]

rem2[17:0]

## rem2 = {rem, low[15]}; ge = rem2 ≥ zc; diff = rem2 - zc div

clk gediff[17:0]

rem2[17:0]

num[32:0] st_ovf* st_div*

rem[16:0]

low[15:0]

q[15:0]

cnt[3:0]

## Registradores do divisor (restaurador)

<≥

clk
sx[15:0]

sy[15:0]

w[15:0]

h[15:0] st_out* | outc[3:0]

## outcodes: sx<0, sx≥W, sy<0, sy≥H (S_OUT)

# flags

clk near* ovf* axis

st_chk* st_ovf*

f_near

f_ovfx

f_ovfy

## bits de flag

clk

# rst busy

done_pulse

wr_data[15:0]

sx[15:0]

sy[15:0]

zout[15:0]

# flags[7:0] wr_en wr_addr[4:0]

wr_data[15:0]

acoord[16:0]

m[0:8]

t[0:2]

v[0:2]

f[15:0]

m_row1*[15:0]

vcol[15:0]

m_row2*[15:0]

vcol[15:0]

m_row0*[15:0]

vcol[15:0]

m[0:8]

v[0:2]

col[1:0] | clk

clk

m_row0*[15:0]

m_row1*[15:0]

near* ovf* axis

m_row2*[15:0]

vcol[15:0]

p0[31:0]

state[3:0]

cx[15:0]

znear[15:0]

w[15:0]

h[15:0] start

acc0[33:0] clk clk

rst start col[1:0]

cnt[3:0]

num[32:0]

st_mac* st_xf* st_chk* st_mul* st_ovf* st_div* st_acc* | ovf*

acc2[33:0]

zc[17:0]

acc1[33:0] | st_xf* st_out*

p1[31:0]

busy

done_pulse

prod[32:0]

xc[17:0] | axis

acc1[33:0]

t[1]

p2[31:0] | st_xf*

acoord[16:0]

p0[31:0] st_mac*

f[15:0]

acc2[33:0]

yc[17:0]

coord[17:0]

coord[17:0]

t[2] start clk p1[31:0] st_mac* start | acc0[33:0]

clk prod[32:0]

clk p2[31:0] st_mac* start

# st_mul* num[32:0]

zc[17:0]

cy[15:0]

clk

rst

low[15:0]

rem[16:0]

# clk busy wr_en

ge diff[17:0]

rem2[17:0]

num[32:0] st_ovf* st_div*

# st_chk* gediff[17:0]

rem2[17:0]

rem[16:0]

low[15:0]

q[15:0]

cnt[3:0]

wr_addr[4:0]

wr_data[15:0]

done_pulse

clk near* ovf* axis

st_chk* st_ovf*

f_near

f_ovfx

f_ovfy

flags[7:0]

q[15:0]

coord[17:0] clk

sy[15:0]

outc[3:0]

sx[15:0]

sq[16:0]

sy[15:0] | sx[15:0]

zout[15:0]

cx[15:0]

# sq[16:0] st_acc* axis clk cy[15:0]

sq[16:0] st_acc* axis

sx[15:0]

sy[15:0]

w[15:0]

# h[15:0] st_out* clk outc[3:0]

busy

f_ovfy

f_ovfx

f_near

xc[17:0]

yc[17:0]

flags[7:0] | clk | zc[17:0] clk
rst | zc[17:0]
t[0] st_xf* | near* zout[15:0] wr_en wr_addr[4:0]

# znear[15:0] clk

zc[17:0]

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

ovf*: q = 32767 e FLAGS.OVFX/OVFY = 1 (S_OVF)

# S_OUT

### outcodes S_DIV ×16 passos

# geo3d_core (u_core): matriz 3×3 + translação + perspectiva, ~44 clocks por vértice

S_CHK com near → S_IDLE. | S_OVF com ovf pula para S_ACC. S_ACC com axis = 0 volta a S_MUL (agora Y). | S_OUT → S_IDLE com done_pulse. Total ≈ 44 clocks: 3 MAC + 2 × (MUL, OVF, 16 DIV, ACC) + XF, CHK, OUT. | S_CHK

### near?

Portas do módulo | 1. MAC: 3 linhas em paralelo, 1 coluna por clock

### sat18 + T

# 4. Sinal, centro, saturação e outcodes

busy = (state != S_IDLE) | start | Sequência de estados (state[3:0])

# 3. Projeção: |coord|·F / Zc por divisão de 16 passos, primeiro X depois Y (axis)

# S_IDLE

espera start | S_MAC

S_OVF: rem = num[32:16], low = num[15:0], q = 0, cnt = 15 S_DIV: rem = ge ? diff : rem2; q = {q, ge}; low <<= 1; cnt--

# S_ACC

### sx ou sy ×3 (col 0..2)

# S_XF

0..8 M00..M22, 9..11 TX..TZ, 12 F, 13 CX, 14 CY, 15 ZNEAR, 16 W, 17 H, 18..20 VX..VZ (VZ dispara start)

reset: F=256, CX=128, CY=106, ZNEAR=16, W=256, H=212 | m_rowK* = m[3K + col], vcol = v[col]

# S_MUL

|c|·F

# S_OVF

### satura?

# 2. Translação, saturação, plano próximo

Xc = sat18((M00·VX + M01·VY + M02·VZ) >>> 14) + TX (idem Yc, Zc); | SX = sat16(CX + sinal(Xc)·min(|Xc|·F / Zc, 32767)); | SY = sat16(CY - sinal(Yc)·min(|Yc|·F / Zc, 32767))
Formatos: M em Q2.14, T/V/CX/CY/ZNEAR/W/H inteiros de 16 bits, F sem sinal. Escrever VZ (endereço 20) dispara o cálculo. Recursos: REG 600 · LUT 761 · ALU 194 · DSP 4

near*: FLAGS.NEAR = 1, SX = SY = 0, termina (S_CHK)

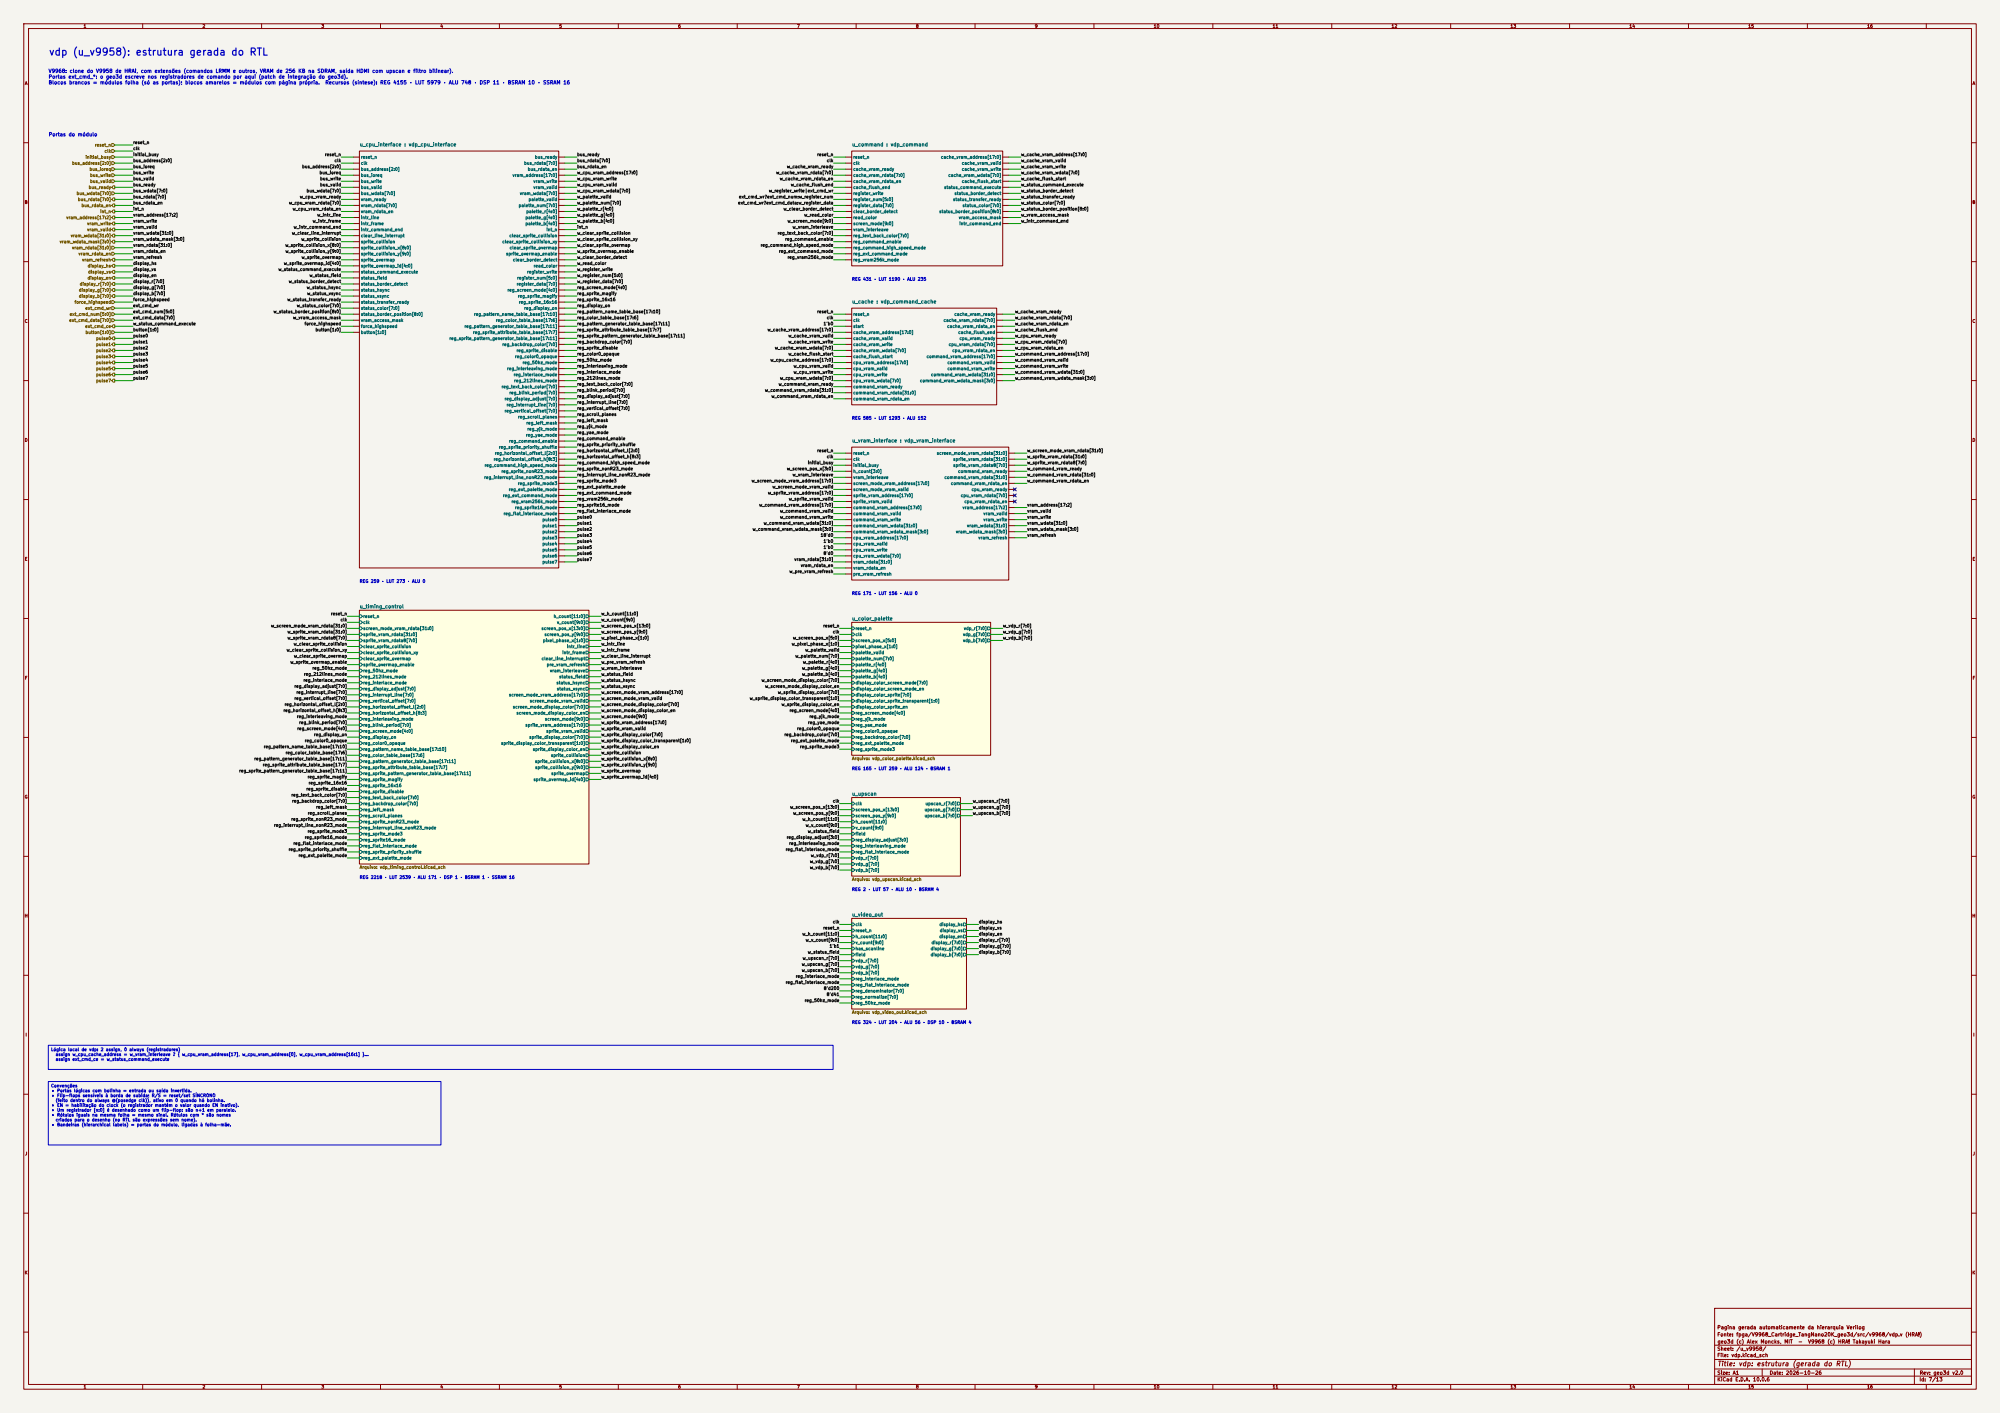
[picture p55: page 7]

REG 585 · LUT 1293 · ALU 152 vdp (u_v9958): estrutura gerada do RTL

V9968: clone do V9958 de HRA!, com extensões (comandos LRMM e outros, VRAM de 256 KB na SDRAM, saída HDMI com upscan e filtro bilinear).
Portas ext_cmd_*: o geo3d escreve nos registradores de comando por aqui (patch de integração do geo3d).
Blocos brancos = módulos folha (só as portas); blocos amarelos = módulos com página própria. Recursos (síntese): REG 4155 · LUT 5979 · ALU 748 · DSP 11 · BSRAM 10 · SSRAM 16

REG 171 · LUT 156 · ALU 0 REG 165 · LUT 259 · ALU 124 · BSRAM 1 REG 2218 · LUT 2539 · ALU 171 · DSP 1 · BSRAM 1 · SSRAM 16

REG 2 · LUT 57 · ALU 10 · BSRAM 4

REG 324 · LUT 204 · ALU 56 · DSP 10 · BSRAM 4

(feito dentro do always @(posedge clk)), ativo em 0 quando há bolinha. • EN = habilitação do clock (o registrador mantém o valor quando EN inativo). • Um registrador [n:0] é desenhado como um flip-flop: são n+1 em paralelo. • Rótulos iguais na mesma folha = mesmo sinal. Rótulos com * são nomes criados para o desenho (no RTL são expressões sem nome). • Bandeiras (hierarchical labels) = portas do módulo, ligadas à folha-mãe. Lógica local de vdp: 2 assign, 0 always (registradores)
assign w_cpu_cache_address = w_vram_interleave ? { w_cpu_vram_address[17], w_cpu_vram_address[0], w_cpu_vram_address[16:1] }...
assign ext_cmd_ce = w_status_command_execute

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

Pagina gerada automaticamente da hierarquia Verilog
Fonte: fpga/V9968_Cartridge_TangNano20K_geo3d/src/v9968/vdp.v (HRA!)

Sheet: /u_v9958/
File: vdp.kicad_sch
Title: vdp: estrutura (gerada do RTL)

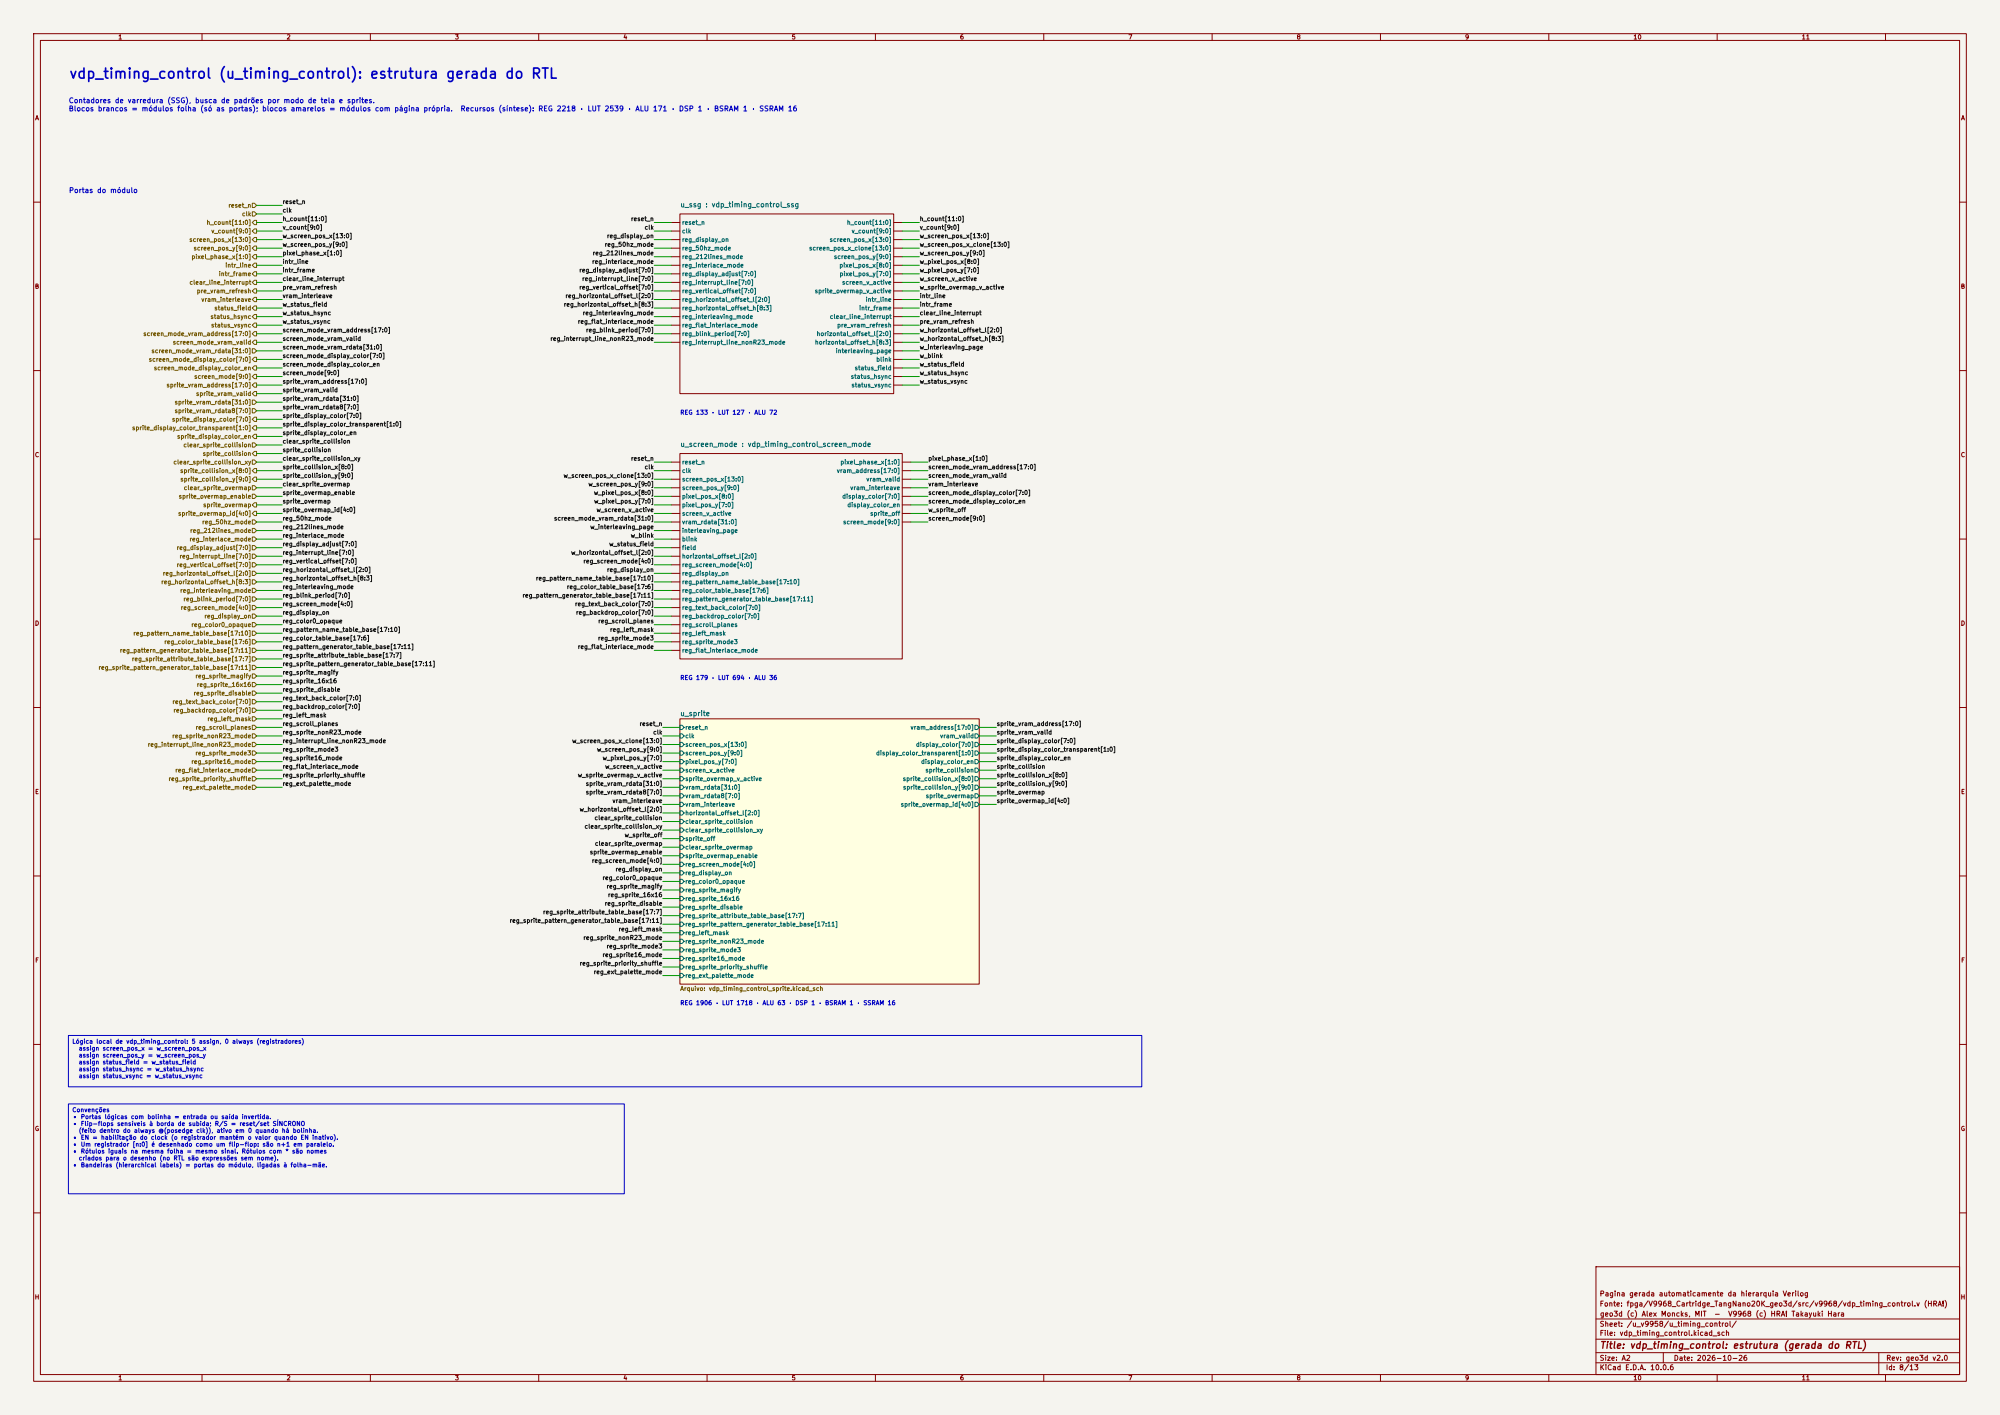
[picture p56: page 8]

vdp_timing_control (u_timing_control): estrutura gerada do RTL

Contadores de varredura (SSG), busca de padrões por modo de tela e sprites.
Blocos brancos = módulos folha (só as portas); blocos amarelos = módulos com página própria. Recursos (síntese): REG 2218 · LUT 2539 · ALU 171 · DSP 1 · BSRAM 1 · SSRAM 16

REG 1906 · LUT 1718 · ALU 63 · DSP 1 · BSRAM 1 · SSRAM 16

(feito dentro do always @(posedge clk)), ativo em 0 quando há bolinha. • EN = habilitação do clock (o registrador mantém o valor quando EN inativo). • Um registrador [n:0] é desenhado como um flip-flop: são n+1 em paralelo. • Rótulos iguais na mesma folha = mesmo sinal. Rótulos com * são nomes criados para o desenho (no RTL são expressões sem nome). • Bandeiras (hierarchical labels) = portas do módulo, ligadas à folha-mãe. Lógica local de vdp_timing_control: 5 assign, 0 always (registradores)
assign screen_pos_x = w_screen_pos_x assign screen_pos_y = w_screen_pos_y assign status_field = w_status_field

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

Pagina gerada automaticamente da hierarquia Verilog
Fonte: fpga/V9968_Cartridge_TangNano20K_geo3d/src/v9968/vdp_timing_control.v (HRA!)

Sheet: /u_v9958/u_timing_control/
File: vdp_timing_control.kicad_sch
Title: vdp_timing_control: estrutura (gerada do RTL)

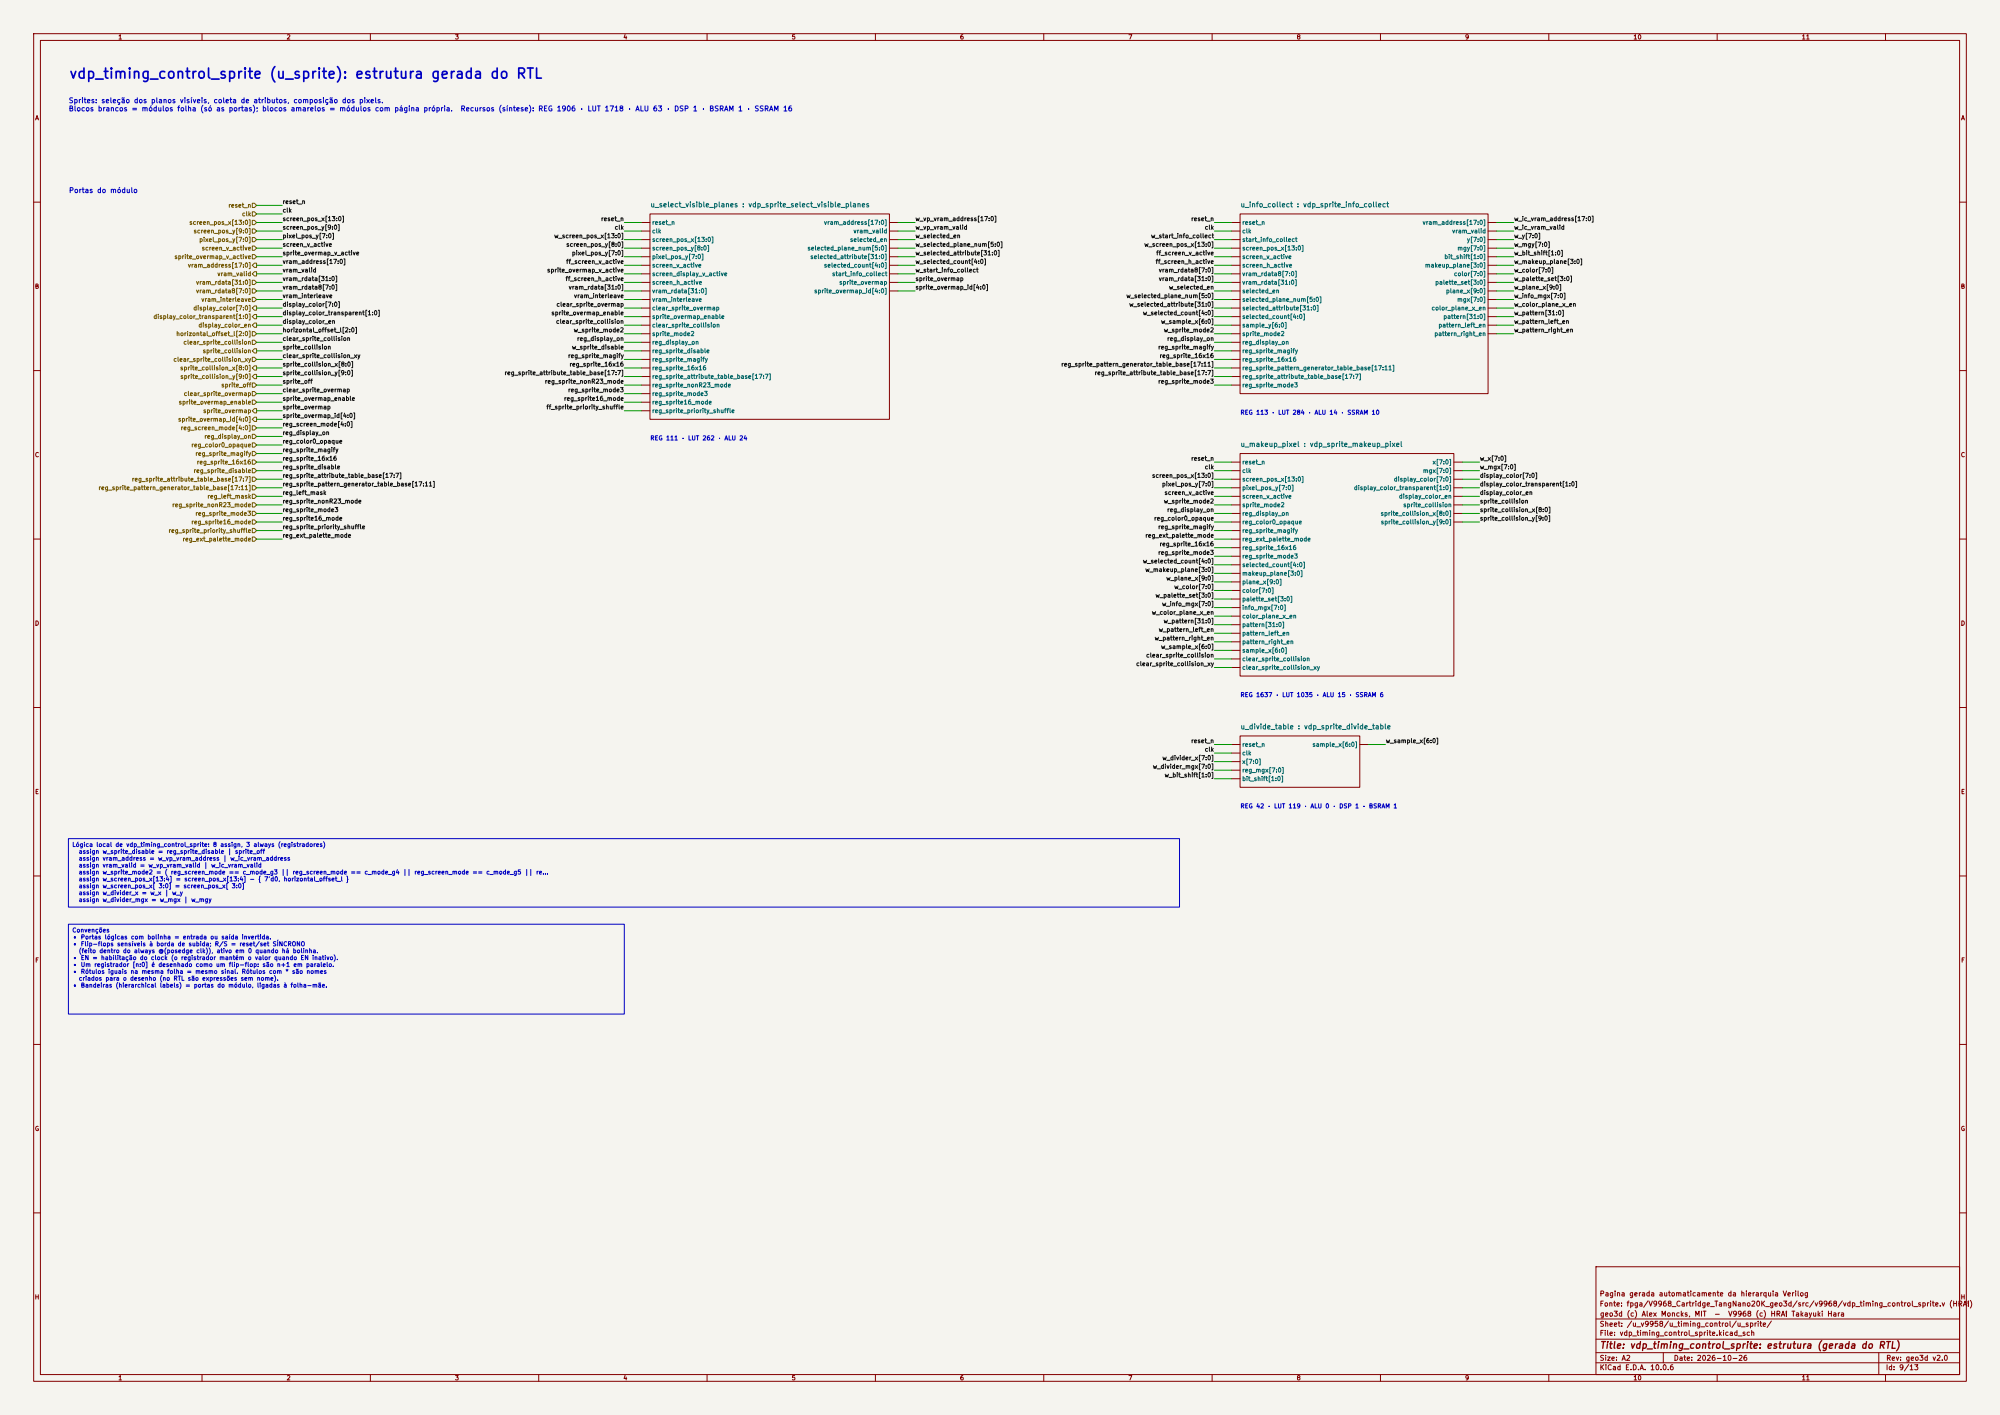
[picture p57: page 9]

vdp_timing_control_sprite (u_sprite): estrutura gerada do RTL

Sprites: seleção dos planos visíveis, coleta de atributos, composição dos pixels.
Blocos brancos = módulos folha (só as portas); blocos amarelos = módulos com página própria. Recursos (síntese): REG 1906 · LUT 1718 · ALU 63 · DSP 1 · BSRAM 1 · SSRAM 16

Lógica local de vdp_timing_control_sprite: 8 assign, 3 always (registradores)
assign w_sprite_disable = reg_sprite_disable | sprite_off
assign vram_address = w_vp_vram_address | w_ic_vram_address assign vram_valid = w_vp_vram_valid | w_ic_vram_valid

assign w_screen_pos_x[ 3:0] = screen_pos_x[ 3:0]
assign w_divider_x = w_x | w_y assign w_divider_mgx = w_mgx | w_mgy Convenções • Portas lógicas com bolinha = entrada ou saída invertida. • Flip-flops sensíveis à borda de subida; R/S = reset/set SÍNCRONO

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

Pagina gerada automaticamente da hierarquia Verilog
Fonte: fpga/V9968_Cartridge_TangNano20K_geo3d/src/v9968/vdp_timing_control_sprite.v (HRA!)

Sheet: /u_v9958/u_timing_control/u_sprite/
File: vdp_timing_control_sprite.kicad_sch
Title: vdp_timing_control_sprite: estrutura (gerada do RTL)

1 | 2 | 3 | 4 | 5 | 6 | 7 | 8
1 | 2 | 3 | 4 | 5 | 6 | 7 | 8

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
## F Date: 2026-10-26

Size: A3 | Rev: geo3d v2.0

# Title: vdp_color_palette: estrutura (gerada do RTL)

## File: vdp_color_palette.kicad_sch

## Sheet: /u_v9958/u_color_palette/

# geo3d (c) Alex Moncks, MIT - V9968 (c) HRA! Takayuki Hara

## Fonte: fpga/V9968_Cartridge_TangNano20K_geo3d/src/v9968/vdp_color_palette.v (HRA!)

## Pagina gerada automaticamente da hierarquia Verilog

clk palette_valid

palette_num[7:0]

palette_r[4:0]

palette_g[4:0]

palette_b[4:0]

display_color[7:0]

display_color_oe

display_r[4:0]

display_g[4:0]

display_b[4:0]

## u_color_palette_ram : vdp_color_palette_ram

reg_screen_mode[4:0]

reg_yae_mode

reg_color0_opaque
reg_backdrop_color[7:0]

reg_ext_palette_mode

display_color_screen_mode[7:0]

vdp_g[7:0]

display_color_sprite[7:0]

reset_n

clk
screen_pos_x[5:0]

pixel_phase_x[1:0]

reg_sprite_mode3

palette_valid
palette_num[7:0]

palette_r[4:0]

palette_g[4:0]

palette_b[4:0]

display_color_screen_mode_en

display_color_sprite_transparent[1:0]

display_color_sprite_en
vdp_r[7:0]

vdp_b[7:0]

reg_yjk_mode

screen_pos_x[5:0]

display_color_sprite[7:0]

display_color_sprite_transparent[1:0]

display_color_sprite_en

clk w_palette_valid

w_palette_r[4:0]

w_palette_g[4:0]

w_palette_b[4:0]

ff_display_color[7:0]

ff_display_color_oe

w_display_g16[4:0]

reg_yae_mode

w_display_b16[4:0]

reg_screen_mode[4:0]

reg_yjk_mode

ff_vdp_b[7:0]

reset_n

ff_vdp_g[7:0]

ff_vdp_r[7:0]

w_display_r16[4:0]

pixel_phase_x[1:0]

palette_valid
palette_num[7:0]

palette_r[4:0]

palette_g[4:0]

reg_ext_palette_mode

w_palette_num[7:0]

reg_sprite_mode3

palette_b[4:0] clk display_color_screen_mode[7:0]

display_color_screen_mode_en

reg_color0_opaque
reg_backdrop_color[7:0]

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

Lógica local de vdp_color_palette: 34 assign, 12 always (registradores)
assign w_palette_valid = ff_palette_num[8] ? palette_valid : 1'b1
assign w_palette_num = ff_palette_num[8] ? palette_num : ff_palette_num[7:0] assign w_palette_r = ff_palette_num[8] ? palette_r : ff_palette_r
assign w_palette_g = ff_palette_num[8] ? palette_g : ff_palette_g
assign w_palette_b = ff_palette_num[8] ? palette_b : ff_palette_b
assign w_r_yjk = { 2'd0, ff_y } + { ff_j[5], ff_j }
assign w_g_yjk = { 2'd0, ff_y } + { ff_k[5], ff_k }
assign w_b_y = { 1'b0, ff_y, 2'd0 } + { 3'd0, ff_y }
assign w_b_jk = { ff_j[5], ff_j, 1'b0 } + { ff_k[5], ff_k[5], ff_k } assign w_b_yjk_pre = { 1'b0, w_b_y } - { w_b_jk[7], w_b_jk } + 9'd2 assign w_b_yjk = w_b_yjk_pre[ 8: 2 ]
assign w_r = w_r_yjk[6] ? 5'd0: w_r_yjk[5] ? 5'd31: w_r_yjk[4:0] assign w_g = w_g_yjk[6] ? 5'd0: w_g_yjk[5] ? 5'd31: w_g_yjk[4:0] assign w_b = w_b_yjk[6] ? 5'd0: w_b_yjk[5] ? 5'd31: w_b_yjk[4:0]
assign w_256colors_mode = (reg_screen_mode == 5'b11100)
assign w_4colors_mode = (reg_screen_mode == 5'b10000)
assign w_g4567_mode = (reg_screen_mode == 5'b01100) || (reg_screen_mode == 5'b10000) || (reg_screen_mode == 5'b10100) || (re... assign w_t12_mode = (reg_screen_mode == 5'b00001) || (reg_screen_mode == 5'b00101) || (reg_screen_mode == 5'b01001)
assign w_g5_mode = (reg_screen_mode == 5'b10000)
assign w_g6_mode = (reg_screen_mode == 5'b10100)
assign w_high_resolution = w_g5_mode | w_g6_mode | (reg_screen_mode == 5'b01001)
assign w_display_color = reg_yjk_mode ? ff_display_color_delay3: ff_display_color_delay0
assign w_display_sprite_mix_r16 = func_sprite_mix( ff_display_r16, w_display_r16, ff_display_color_sprite_transparent )
assign w_display_sprite_mix_g16 = func_sprite_mix( ff_display_g16, w_display_g16, ff_display_color_sprite_transparent )
assign w_display_sprite_mix_b16 = func_sprite_mix( ff_display_b16, w_display_b16, ff_display_color_sprite_transparent )
assign w_display_r_pre = (!reg_ext_palette_mode && w_256colors_mode) ? { ff_display_color256[4:2], ff_display_color256[4:3] ... assign w_display_g_pre = (!reg_ext_palette_mode && w_256colors_mode) ? { ff_display_color256[7:5], ff_display_color256[7:6] ... assign w_display_b_pre = (!reg_ext_palette_mode && w_256colors_mode) ? { ff_display_color256[1:0], ff_display_color256[1] & ...

... e mais 6

# Portas do módulo

Paleta de 256 cores em BSRAM, modos YJK/YAE, conversão para RGB de 8 bits.
Blocos brancos = módulos folha (só as portas); blocos amarelos = módulos com página própria. Recursos (síntese): REG 165 · LUT 259 · ALU 124 · BSRAM 1

# vdp_color_palette (u_color_palette): estrutura gerada do RTL

REG 0 · LUT 0 · ALU 0 · BSRAM 1

1 | 2 | 3 | 4 | 5 | 6
1 | 2 | 3 | 4 | 5 | 6

AB

C

D

AB

C

## D Date: 2026-10-26

Size: A4 | Rev: geo3d v2.0

# Title: vdp_upscan: estrutura (gerada do RTL)

## File: vdp_upscan.kicad_sch

## Sheet: /u_v9958/u_upscan/

# geo3d (c) Alex Moncks, MIT - V9968 (c) HRA! Takayuki Hara

## Fonte: fpga/V9968_Cartridge_TangNano20K_geo3d/src/v9968/vdp_upscan.v (HRA!)
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
