alexmoncks/V9968_Cartridge/geo3d/docs/kicad/clock_reset.kicad_sch

## KiCad design geo3d/docs/kicad/clock_reset.kicad_sch (2026-10-27)

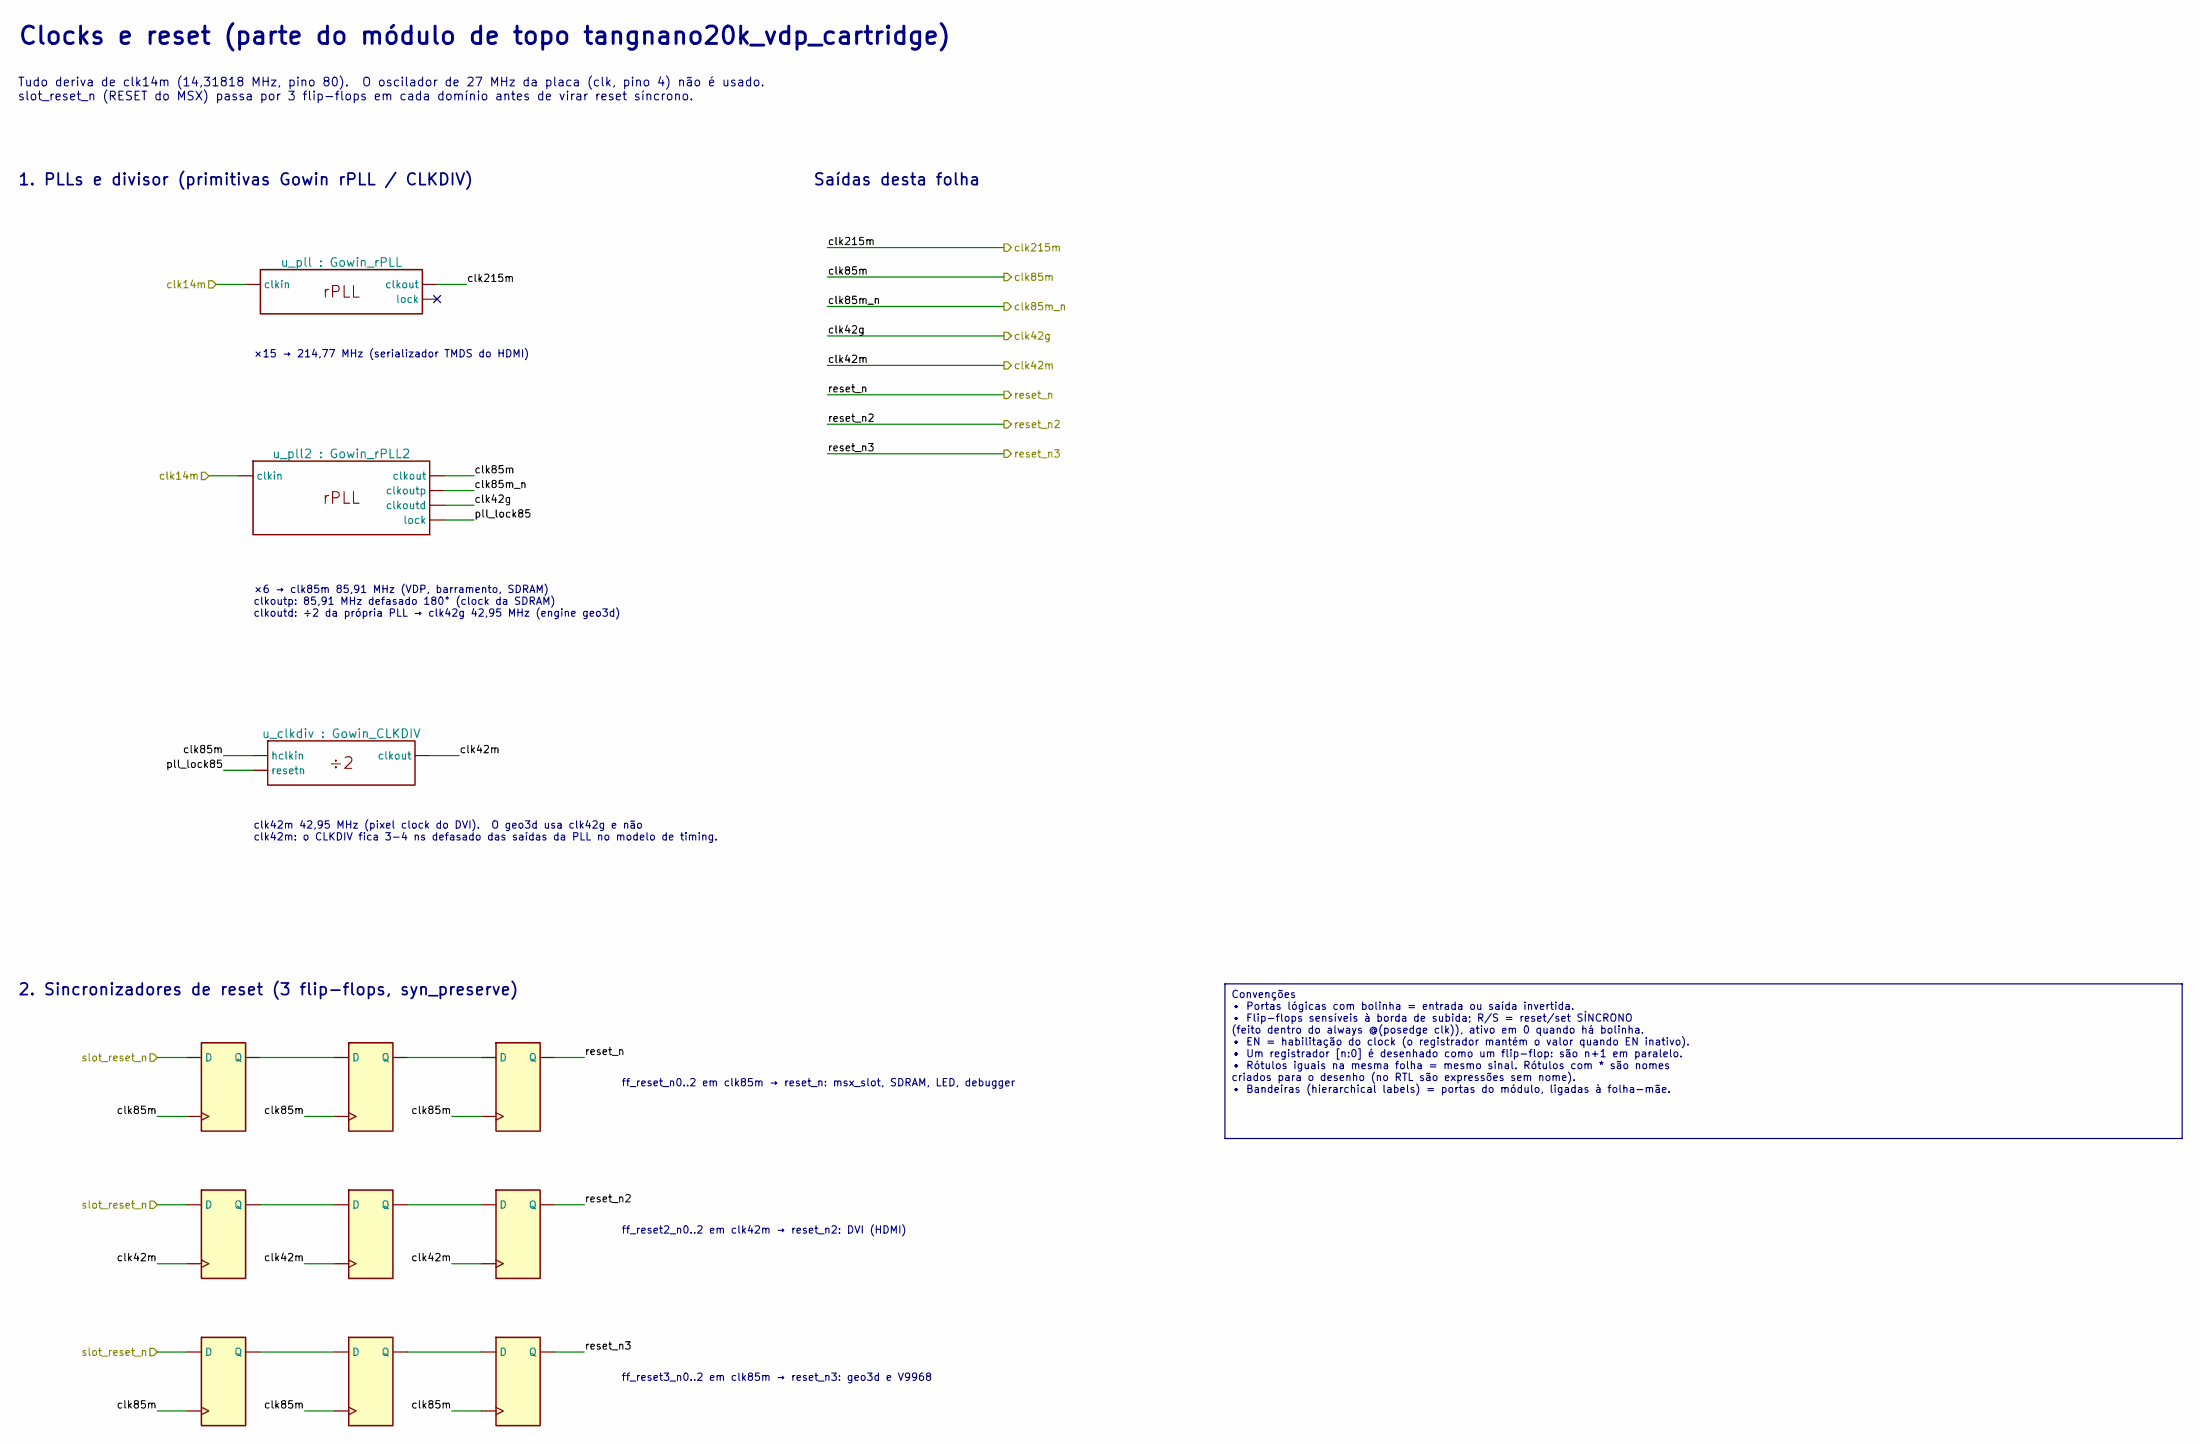
[picture p58: schematic clock_reset.kicad_sch]

Parts:
U15: u_pll : Gowin_rPLL
U16: u_pll2 : Gowin_rPLL2
U17: u_clkdiv : Gowin_CLKDIV
U18: ff_reset_n0
U19, U20, U22, U23, U25, U26: DFF
U21: ff_reset2_n0
U24: ff_reset3_n0

Connections:
unnamed: U18.3 (Q), U19.1 (D)
unnamed: U19.3 (Q), U20.1 (D)
unnamed: U21.3 (Q), U22.1 (D)
unnamed: U22.3 (Q), U23.1 (D)
unnamed: U24.3 (Q), U25.1 (D)
unnamed: U25.3 (Q), U26.1 (D)
clk14m: U15.1 (clkin), U16.1 (clkin)
clk42g: U16.4 (clkoutd)
clk42m: U17.3 (clkout), U21.2, U22.2, U23.2
clk85m: U16.2 (clkout), U17.1 (hclkin), U18.2, U19.2, U20.2, U24.2, U25.2, U26.2
clk85m_n: U16.3 (clkoutp)
clk215m: U15.2 (clkout)
pll_lock85: U16.5 (lock), U17.2 (resetn)
reset_n: U20.3 (Q)
reset_n2: U23.3 (Q)
reset_n3: U26.3 (Q)
slot_reset_n: U18.1 (D), U21.1 (D), U24.1 (D)

Notes on the sheet:
Clocks e reset (parte do módulo de topo tangnano20k_vdp_cartridge)
Tudo deriva de clk14m (14,31818 MHz, pino 80). O oscilador de 27 MHz da placa (clk, pino 4) não é usado. slot_reset_n (RESET do MSX) passa por 3 flip-flops em cada domínio antes de virar reset síncrono.
1. PLLs e divisor (primitivas Gowin rPLL / CLKDIV)
×15 → 214,77 MHz (serializador TMDS do HDMI)
×6 → clk85m 85,91 MHz (VDP, barramento, SDRAM) clkoutp: 85,91 MHz defasado 180° (clock da SDRAM) clkoutd: ÷2 da própria PLL → clk42g 42,95 MHz (engine geo3d)
clk42m 42,95 MHz (pixel clock do DVI). O geo3d usa clk42g e não clk42m: o CLKDIV fica 3-4 ns defasado das saídas da PLL no modelo de timing.
Saídas desta folha
2. Sincronizadores de reset (3 flip-flops, syn_preserve)
ff_reset_n0..2 em clk85m → reset_n: msx_slot, SDRAM, LED, debugger
ff_reset2_n0..2 em clk42m → reset_n2: DVI (HDMI)
ff_reset3_n0..2 em clk85m → reset_n3: geo3d e V9968
Convenções • Portas lógicas com bolinha = entrada ou saída invertida. • Flip-flops sensíveis à borda de subida; R/S = reset/set SÍNCRONO (feito dentro do always @(posedge clk)), ativo em 0 quando há bolinha. • EN = habilitação do clock (o registrador mantém o valor quando EN inativo). • Um registra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
