alexmoncks/V9968_Cartridge/geo3d/docs/kicad/geo3d_bus.kicad_sch

## KiCad design geo3d/docs/kicad/geo3d_bus.kicad_sch (2026-10-27)

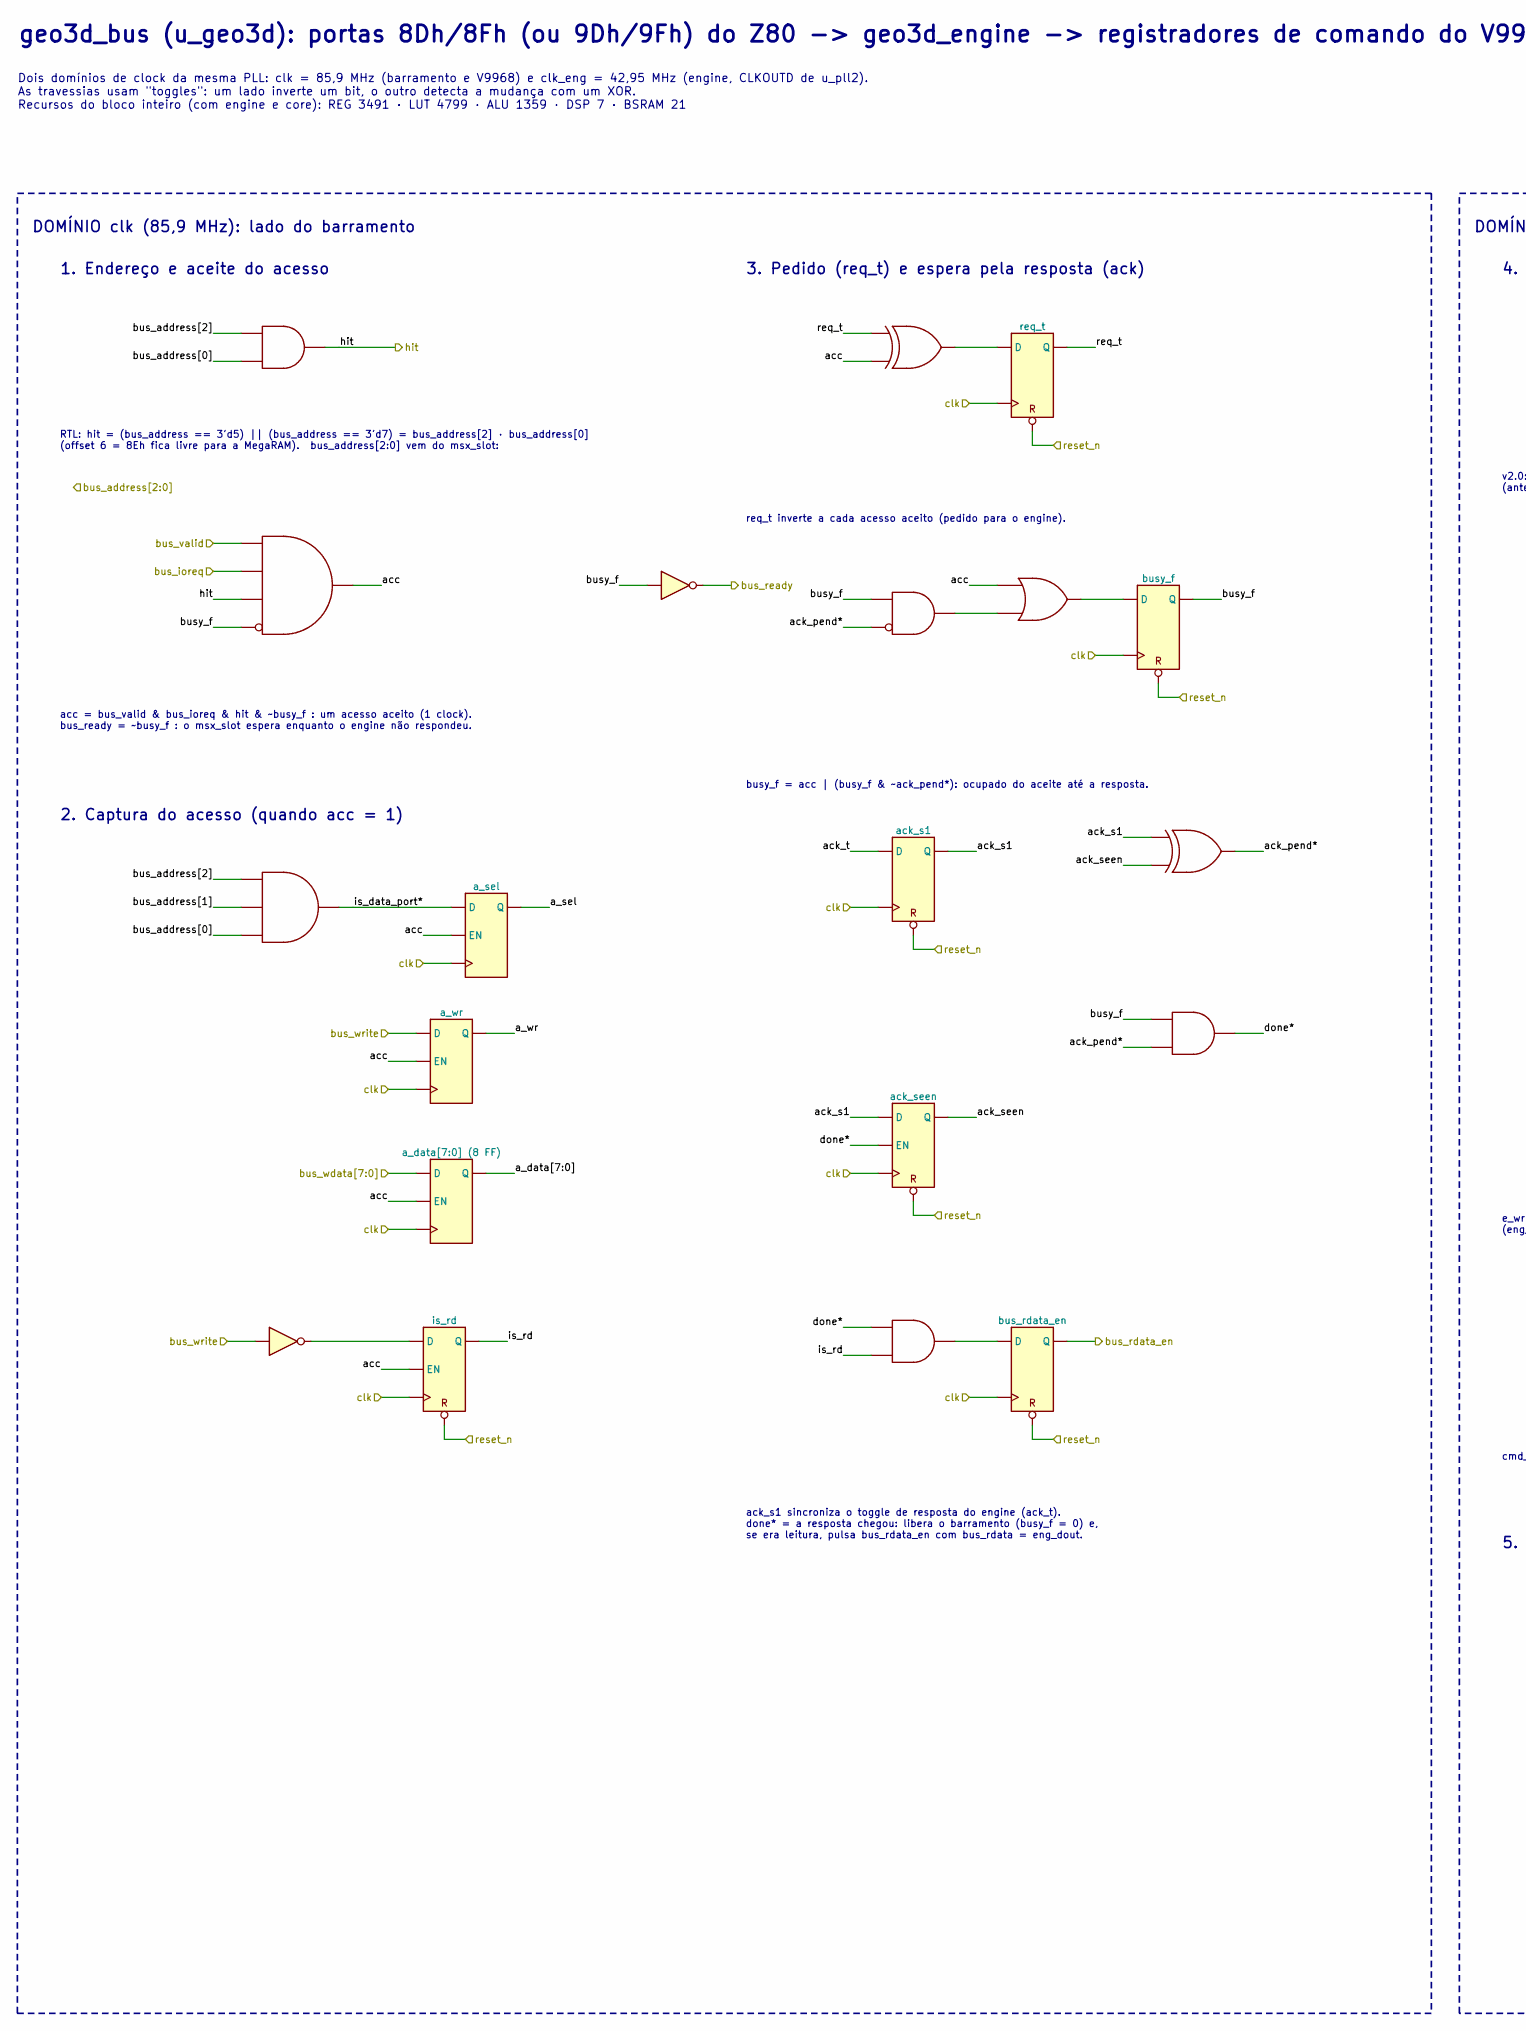
[picture p59: schematic geo3d_bus.kicad_sch, part in row 1, column 1]

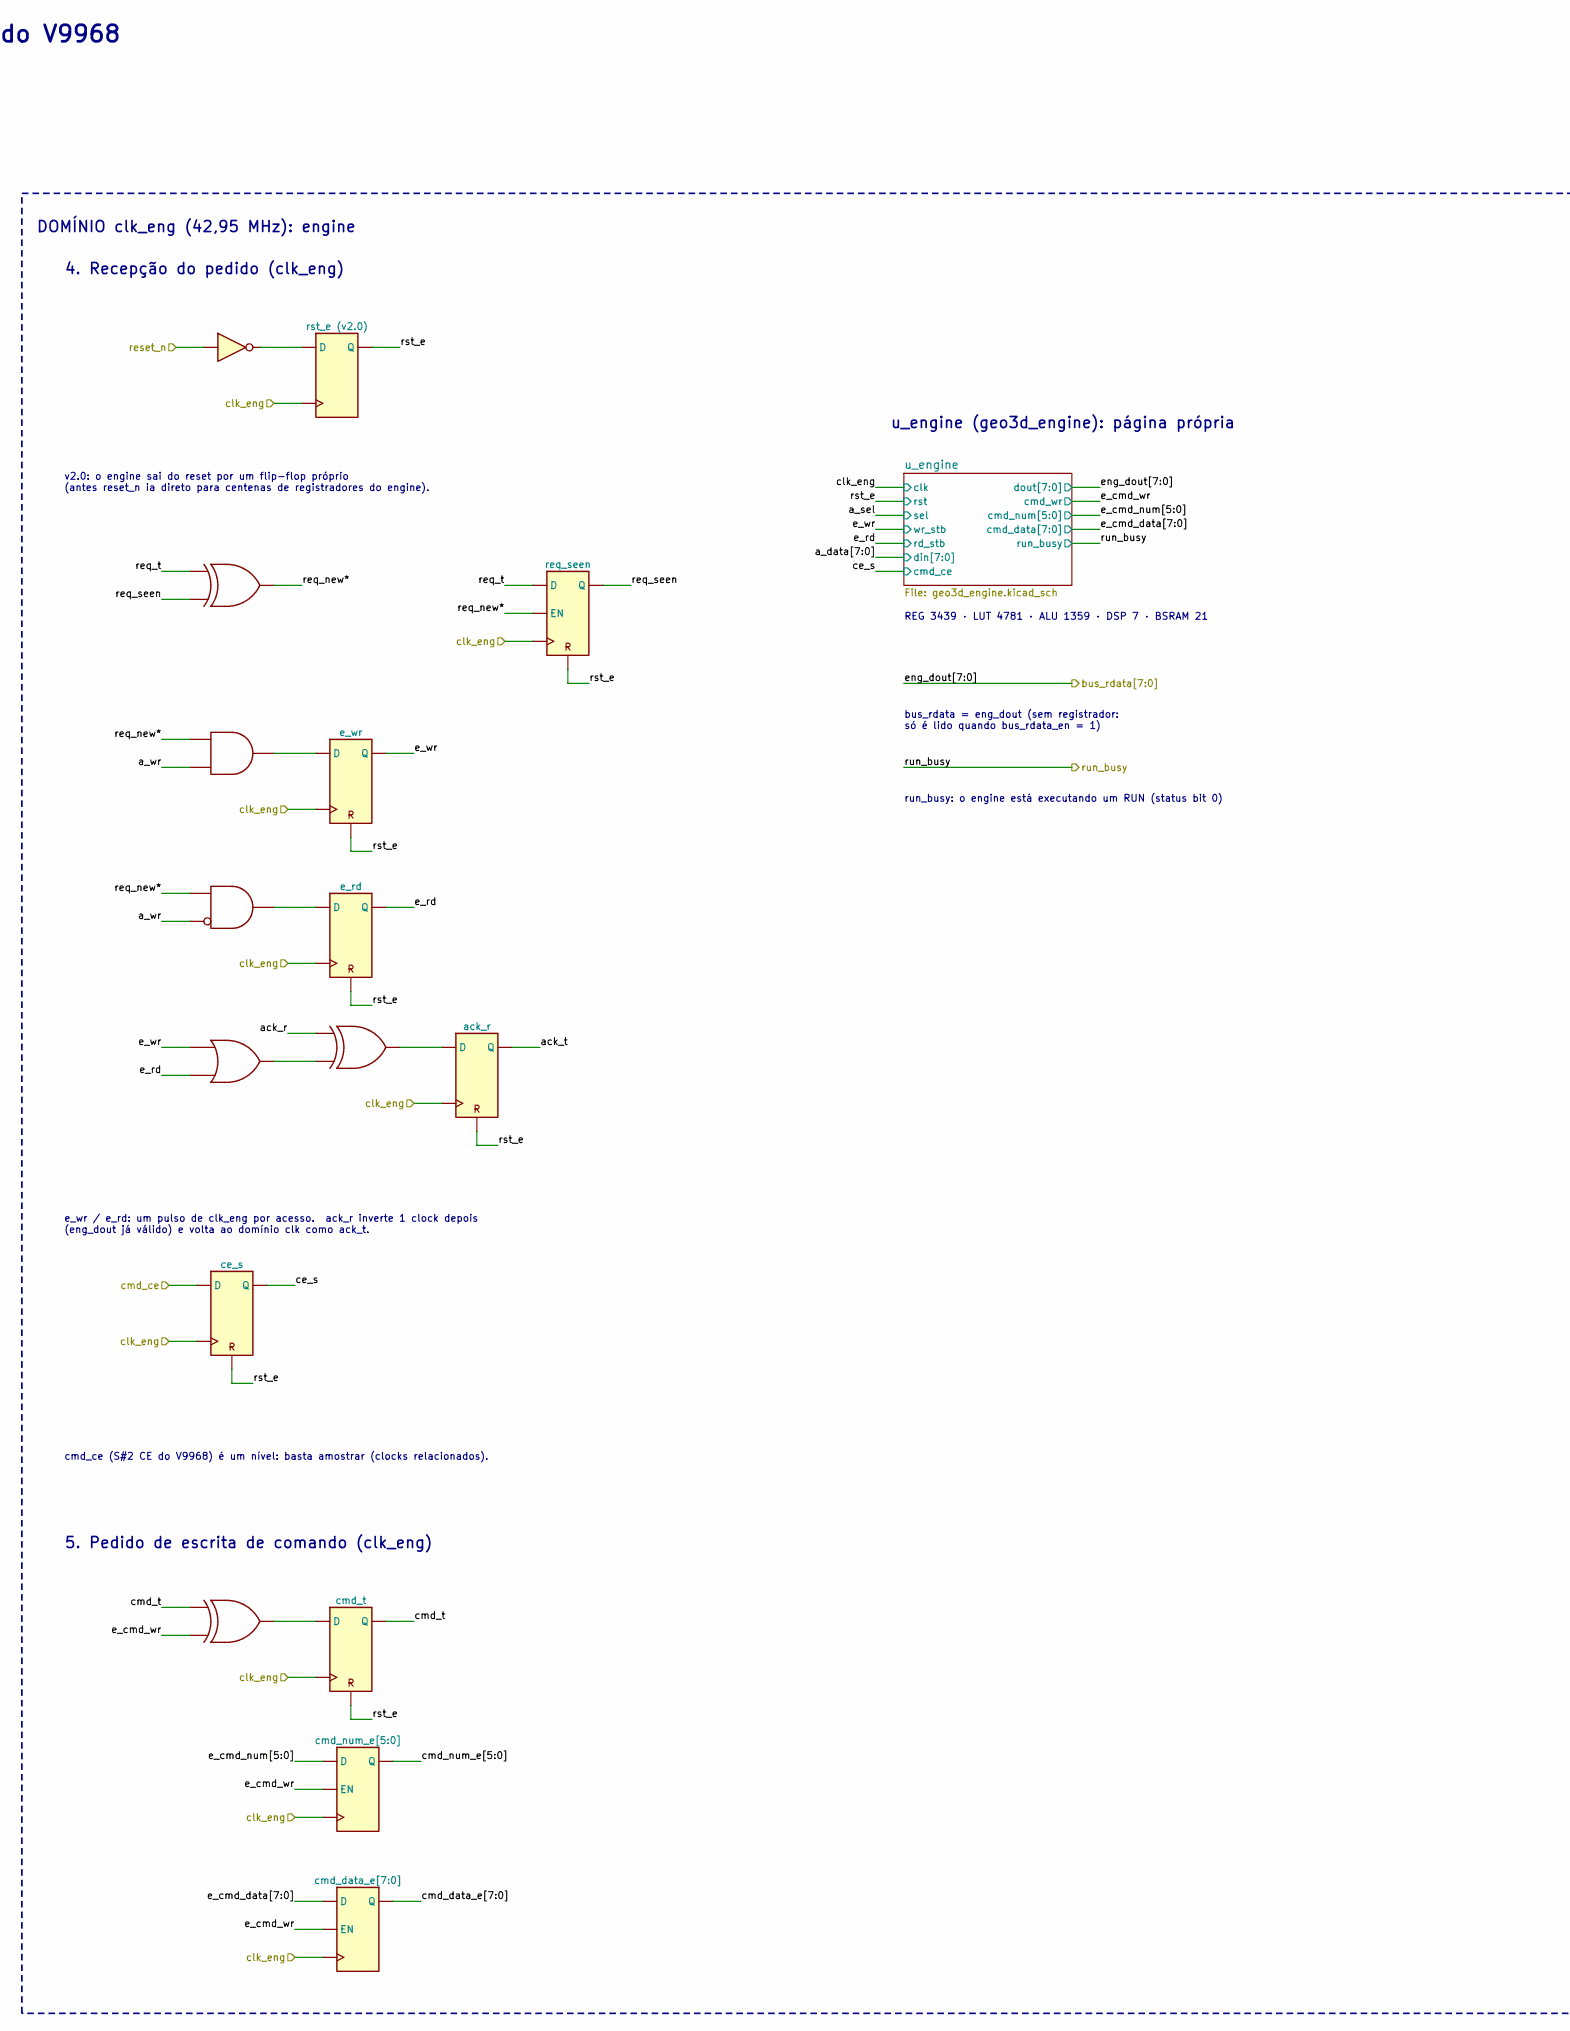
[picture p60: schematic geo3d_bus.kicad_sch, part in row 1, column 2]

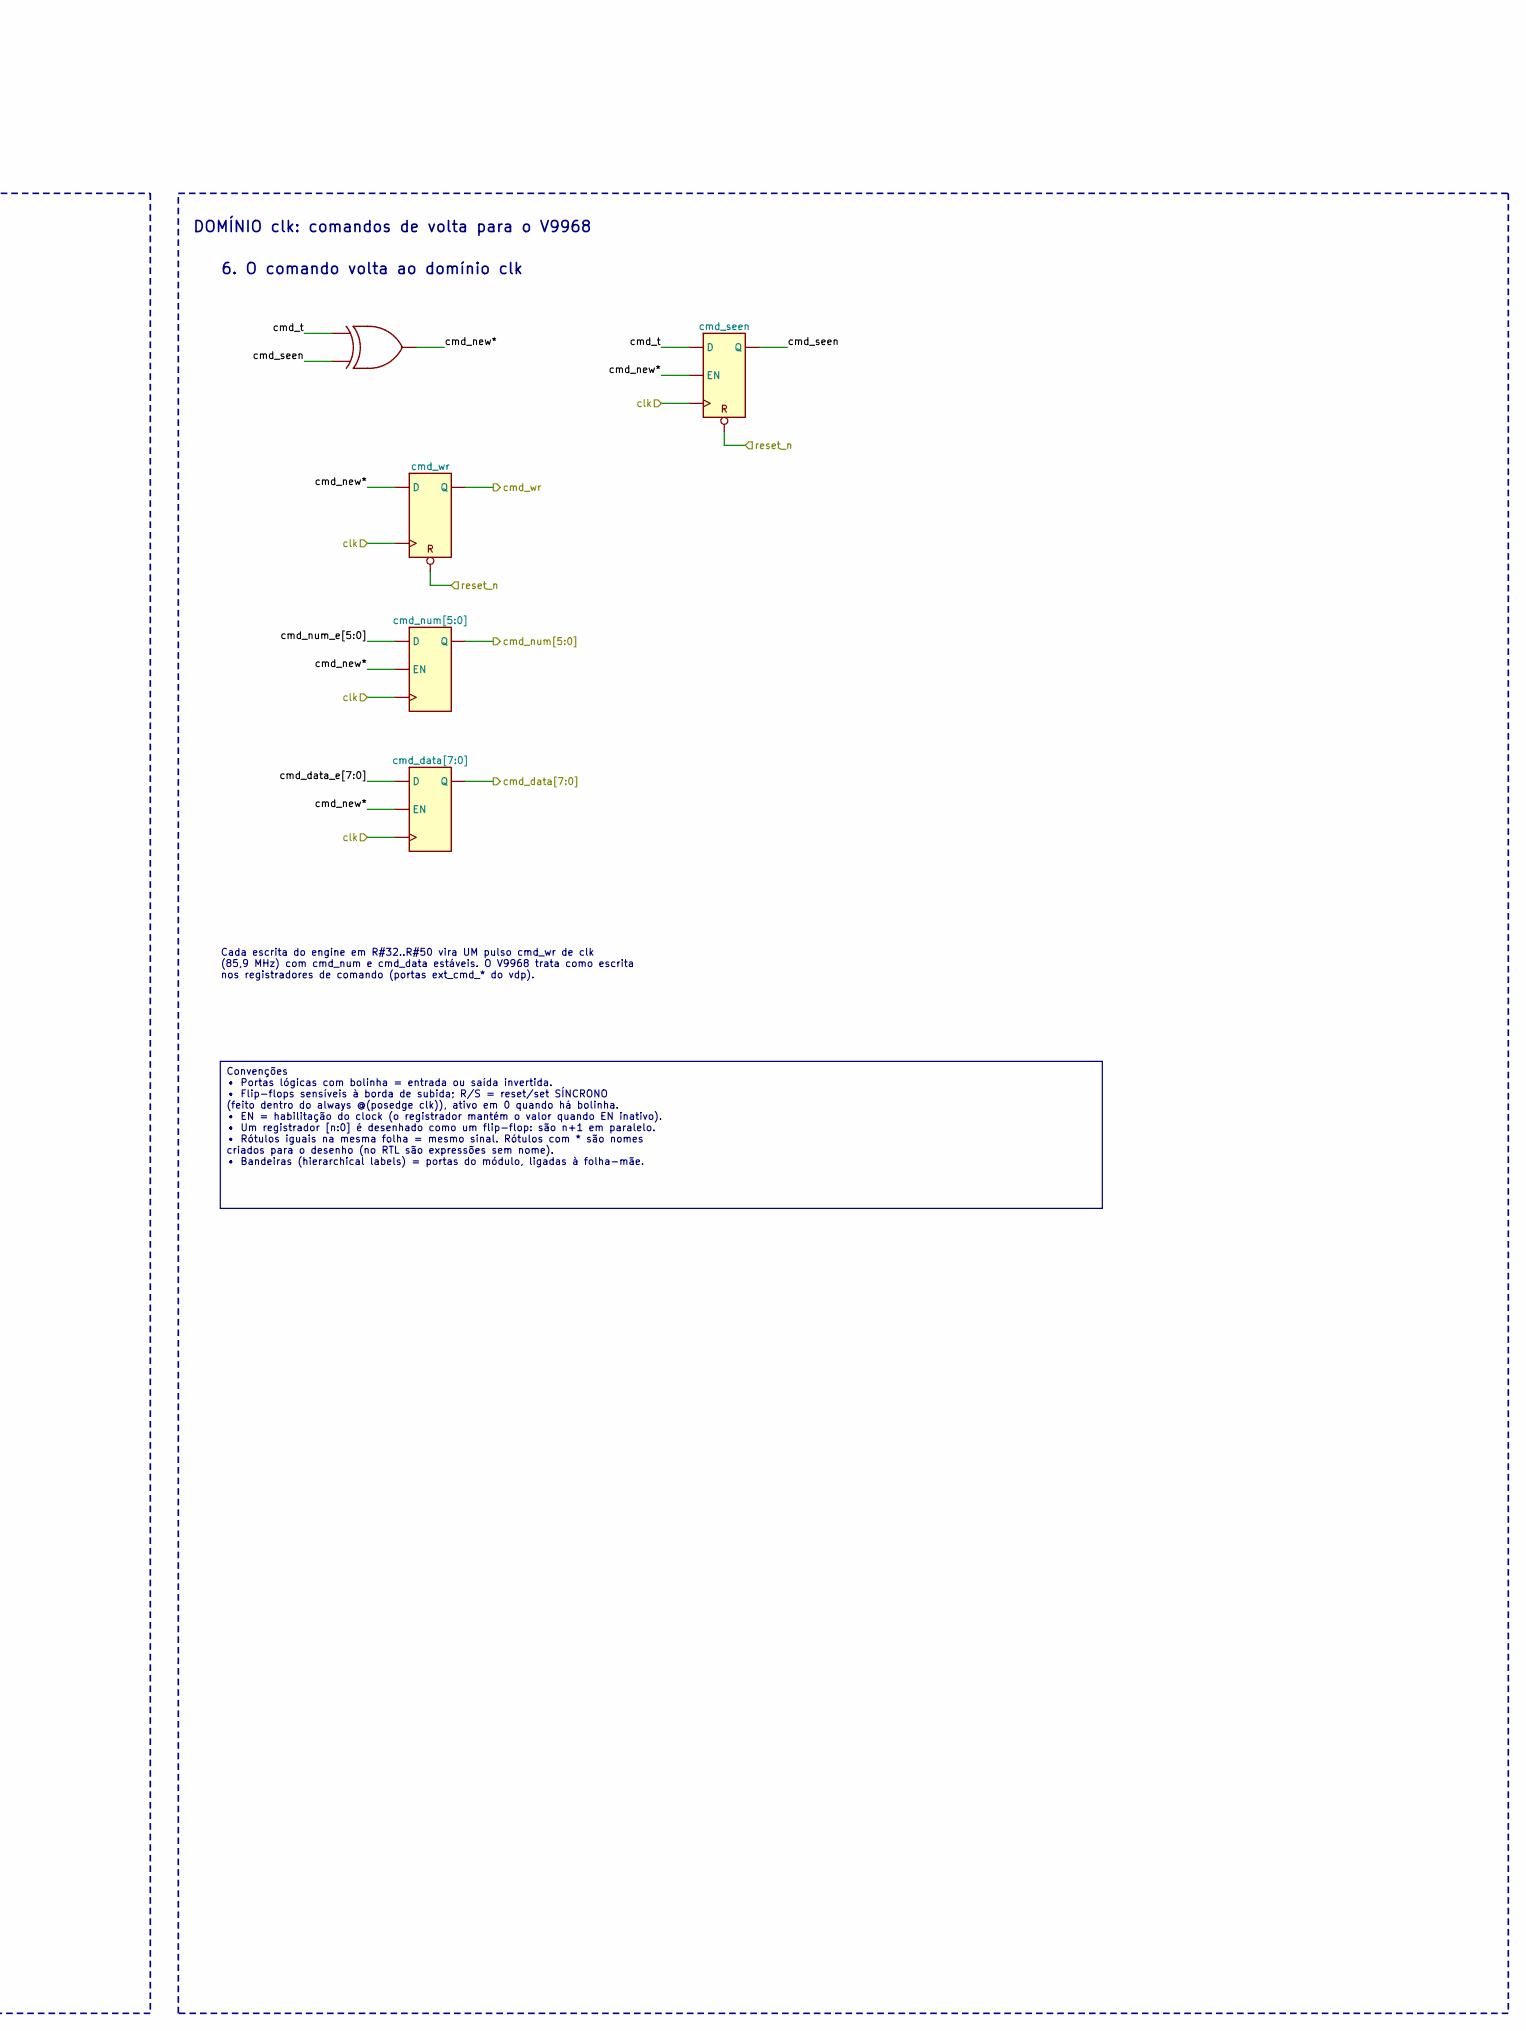
[picture p61: schematic geo3d_bus.kicad_sch, part in row 1, column 3]

Parts:
U67, U83, U85, U91: AND2
U68: AND4_N3
U69, U74, U87: NOT
U70: AND3
U71: a_sel
U72: a_wr
U73: a_data[7:0] (8 FF)
U75: is_rd
U76, U82, U89, U96, U99, U103: XOR2
U77: req_t
U78, U93: AND2_N1
U79, U95: OR2
U80: busy_f
U81: ack_s1
U84: ack_seen
U86: bus_rdata_en
U88: rst_e (v2.0)
U90: req_seen
U92: e_wr
U94: e_rd
U97: ack_r
U98: ce_s
U100: cmd_t
U101: cmd_num_e[5:0]
U102: cmd_data_e[7:0]
U104: cmd_seen
U105: cmd_wr
U106: cmd_num[5:0]
U107: cmd_data[7:0]

Connections:
unnamed: U74.2, U75.1 (D)
unnamed: U76.3, U77.1 (D)
unnamed: U78.3, U79.2
unnamed: U79.3, U80.1 (D)
unnamed: U85.3, U86.1 (D)
unnamed: U87.2, U88.1 (D)
unnamed: U91.3, U92.1 (D)
unnamed: U93.3, U94.1 (D)
unnamed: U95.3, U96.2
unnamed: U96.3, U97.1 (D)
unnamed: U99.3, U100.1 (D)
a_data[7:0]: U73.4 (Q)
a_sel: U71.4 (Q)
a_wr: U72.4 (Q), U91.2, U93.2
acc: U68.5, U71.2 (EN), U72.2 (EN), U73.2 (EN), U75.2 (EN), U76.2, U79.1
ack_pend*: U78.2, U82.3, U83.2
ack_r: U96.1
ack_s1: U81.3 (Q), U82.1, U84.1 (D)
ack_seen: U82.2, U84.4 (Q)
ack_t: U81.1 (D), U97.3 (Q)
bus_address[0]: U67.2, U70.3
bus_address[1]: U70.2
bus_address[2]: U67.1, U70.1
bus_ioreq: U68.2
bus_rdata_en: U86.3 (Q)
bus_ready: U69.2
bus_valid: U68.1
bus_wdata[7:0]: U73.1 (D)
bus_write: U72.1 (D), U74.1
busy_f: U68.4, U69.1, U78.1, U80.3 (Q), U83.1
ce_s: U98.3 (Q)
clk: U71.3, U72.3, U73.3, U75.3, U77.2, U80.2, U81.2, U84.3, U86.2, U104.3, U105.2, U106.3, U107.3
clk_eng: U88.2, U90.3, U92.2, U94.2, U97.2, U98.2, U100.2, U101.3, U102.3
cmd_ce: U98.1 (D)
cmd_data[7:0]: U107.4 (Q)
cmd_data_e[7:0]: U102.4 (Q), U107.1 (D)
cmd_new*: U103.3, U104.2 (EN), U105.1 (D), U106.2 (EN), U107.2 (EN)
cmd_num[5:0]: U106.4 (Q)
cmd_num_e[5:0]: U101.4 (Q), U106.1 (D)
cmd_seen: U103.2, U104.4 (Q)
cmd_t: U99.1, U100.3 (Q), U103.1, U104.1 (D)
cmd_wr: U105.3 (Q)
done*: U83.3, U84.2 (EN), U85.1
e_cmd_data[7:0]: U102.1 (D)
e_cmd_num[5:0]: U101.1 (D)
e_cmd_wr: U99.2, U101.2 (EN), U102.2 (EN)
e_rd: U94.3 (Q), U95.2
e_wr: U92.3 (Q), U95.1
hit: U67.3, U68.3
is_data_port*: U70.4, U71.1 (D)
is_rd: U75.4 (Q), U85.2
req_new*: U89.3, U90.2 (EN), U91.1, U93.1
req_seen: U89.2, U90.4 (Q)
req_t: U76.1, U77.3 (Q), U89.1, U90.1 (D)
reset_n: U75.5, U77.4, U80.4, U81.4, U84.5, U86.4, U87.1, U104.5, U105.4
rst_e: U88.3 (Q), U90.5, U92.4, U94.4, U97.4, U98.4, U100.4

Notes on the sheet:
geo3d_bus (u_geo3d): portas 8Dh/8Fh (ou 9Dh/9Fh) do Z80 -> geo3d_engine -> registradores de comando do V9968
Dois domínios de clock da mesma PLL: clk = 85,9 MHz (barramento e V9968) e clk_eng = 42,95 MHz (engine, CLKOUTD de u_pll2). As travessias usam "toggles": um lado inverte um bit, o outro detecta a mudança com um XOR. Recursos do bloco inteiro (com engine e core): REG 3491 · LUT 4799 · ALU 1359 · DSP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
DOMÍNIO clk (85,9 MHz): lado do barramento
DOMÍNIO clk_eng (42,95 MHz): engine
DOMÍNIO clk: comandos de volta para o V9968
1. Endereço e aceite do acesso
RTL: hit = (bus_address == 3'd5) || (bus_address == 3'd7) = bus_address[2] · bus_address[0] (offset 6 = 8Eh fica livre para a MegaRAM). bus_address[2:0] vem do msx_slot:
acc = bus_valid & bus_ioreq & hit & ~busy_f : um acesso aceito (1 clock). bus_ready = ~busy_f : o msx_slot espera enquanto o engine não respondeu.
2. Captura do acesso (quando acc = 1)
3. Pedido (req_t) e espera pela resposta (ack)
req_t inverte a cada acesso aceito (pedido para o engine).
busy_f = acc | (busy_f & ~ack_pend*): ocupado do aceite até a resposta.
ack_s1 sincroniza o toggle de resposta do engine (ack_t). done* = a resposta chegou: libera o barramento (busy_f = 0) e, se era leitura, pulsa bus_rdata_en com bus_rdata = eng_dout.
4. Recepção do pedido (clk_eng)
v2.0: o engine sai do reset por um flip-flop próprio (antes reset_n ia direto para centenas de registradores do engine).
e_wr / e_rd: um pulso de clk_eng por acesso. ack_r inverte 1 clock depois (eng_dout já válido) e volta ao domínio clk como ack_t.
cmd_ce (S#2 CE do V9968) é um nível: basta amostrar (clocks relacionados).
5. Pedido de escrita de comando (clk_eng)
u_engine (geo3d_engine): página própria
REG 3439 · LUT 4781 · ALU 1359 · DSP 7 · BSRAM 21
bus_rdata = eng_dout (sem registrador: só é lido quando bus_rdata_en = 1)
run_busy: o engine está executando um RUN (status bit 0)
6. O comando volta ao domínio clk
Cada escrita do engine em R#32..R#50 vira UM pulso cmd_wr de clk (85,9 MHz) com cmd_num e cmd_data estáveis. O V9968 trata como escrita nos registradores de comando (portas ext_cmd_* do vdp).
Convenções • Portas lógicas com bolinha = entrada ou saída invertida. • Flip-flops sensíveis à borda de subida; R/S = reset/set SÍNCRONO (feito dentro do always @(posedge clk)), ativo em 0 quando há bolinha. • EN = habilitação do clock (o registrador mantém o valor quando EN inativo). • Um registra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
