alexmoncks/V9968_Cartridge/geo3d/docs/kicad/geo3d_core.kicad_sch

## KiCad design geo3d/docs/kicad/geo3d_core.kicad_sch (2026-10-27)

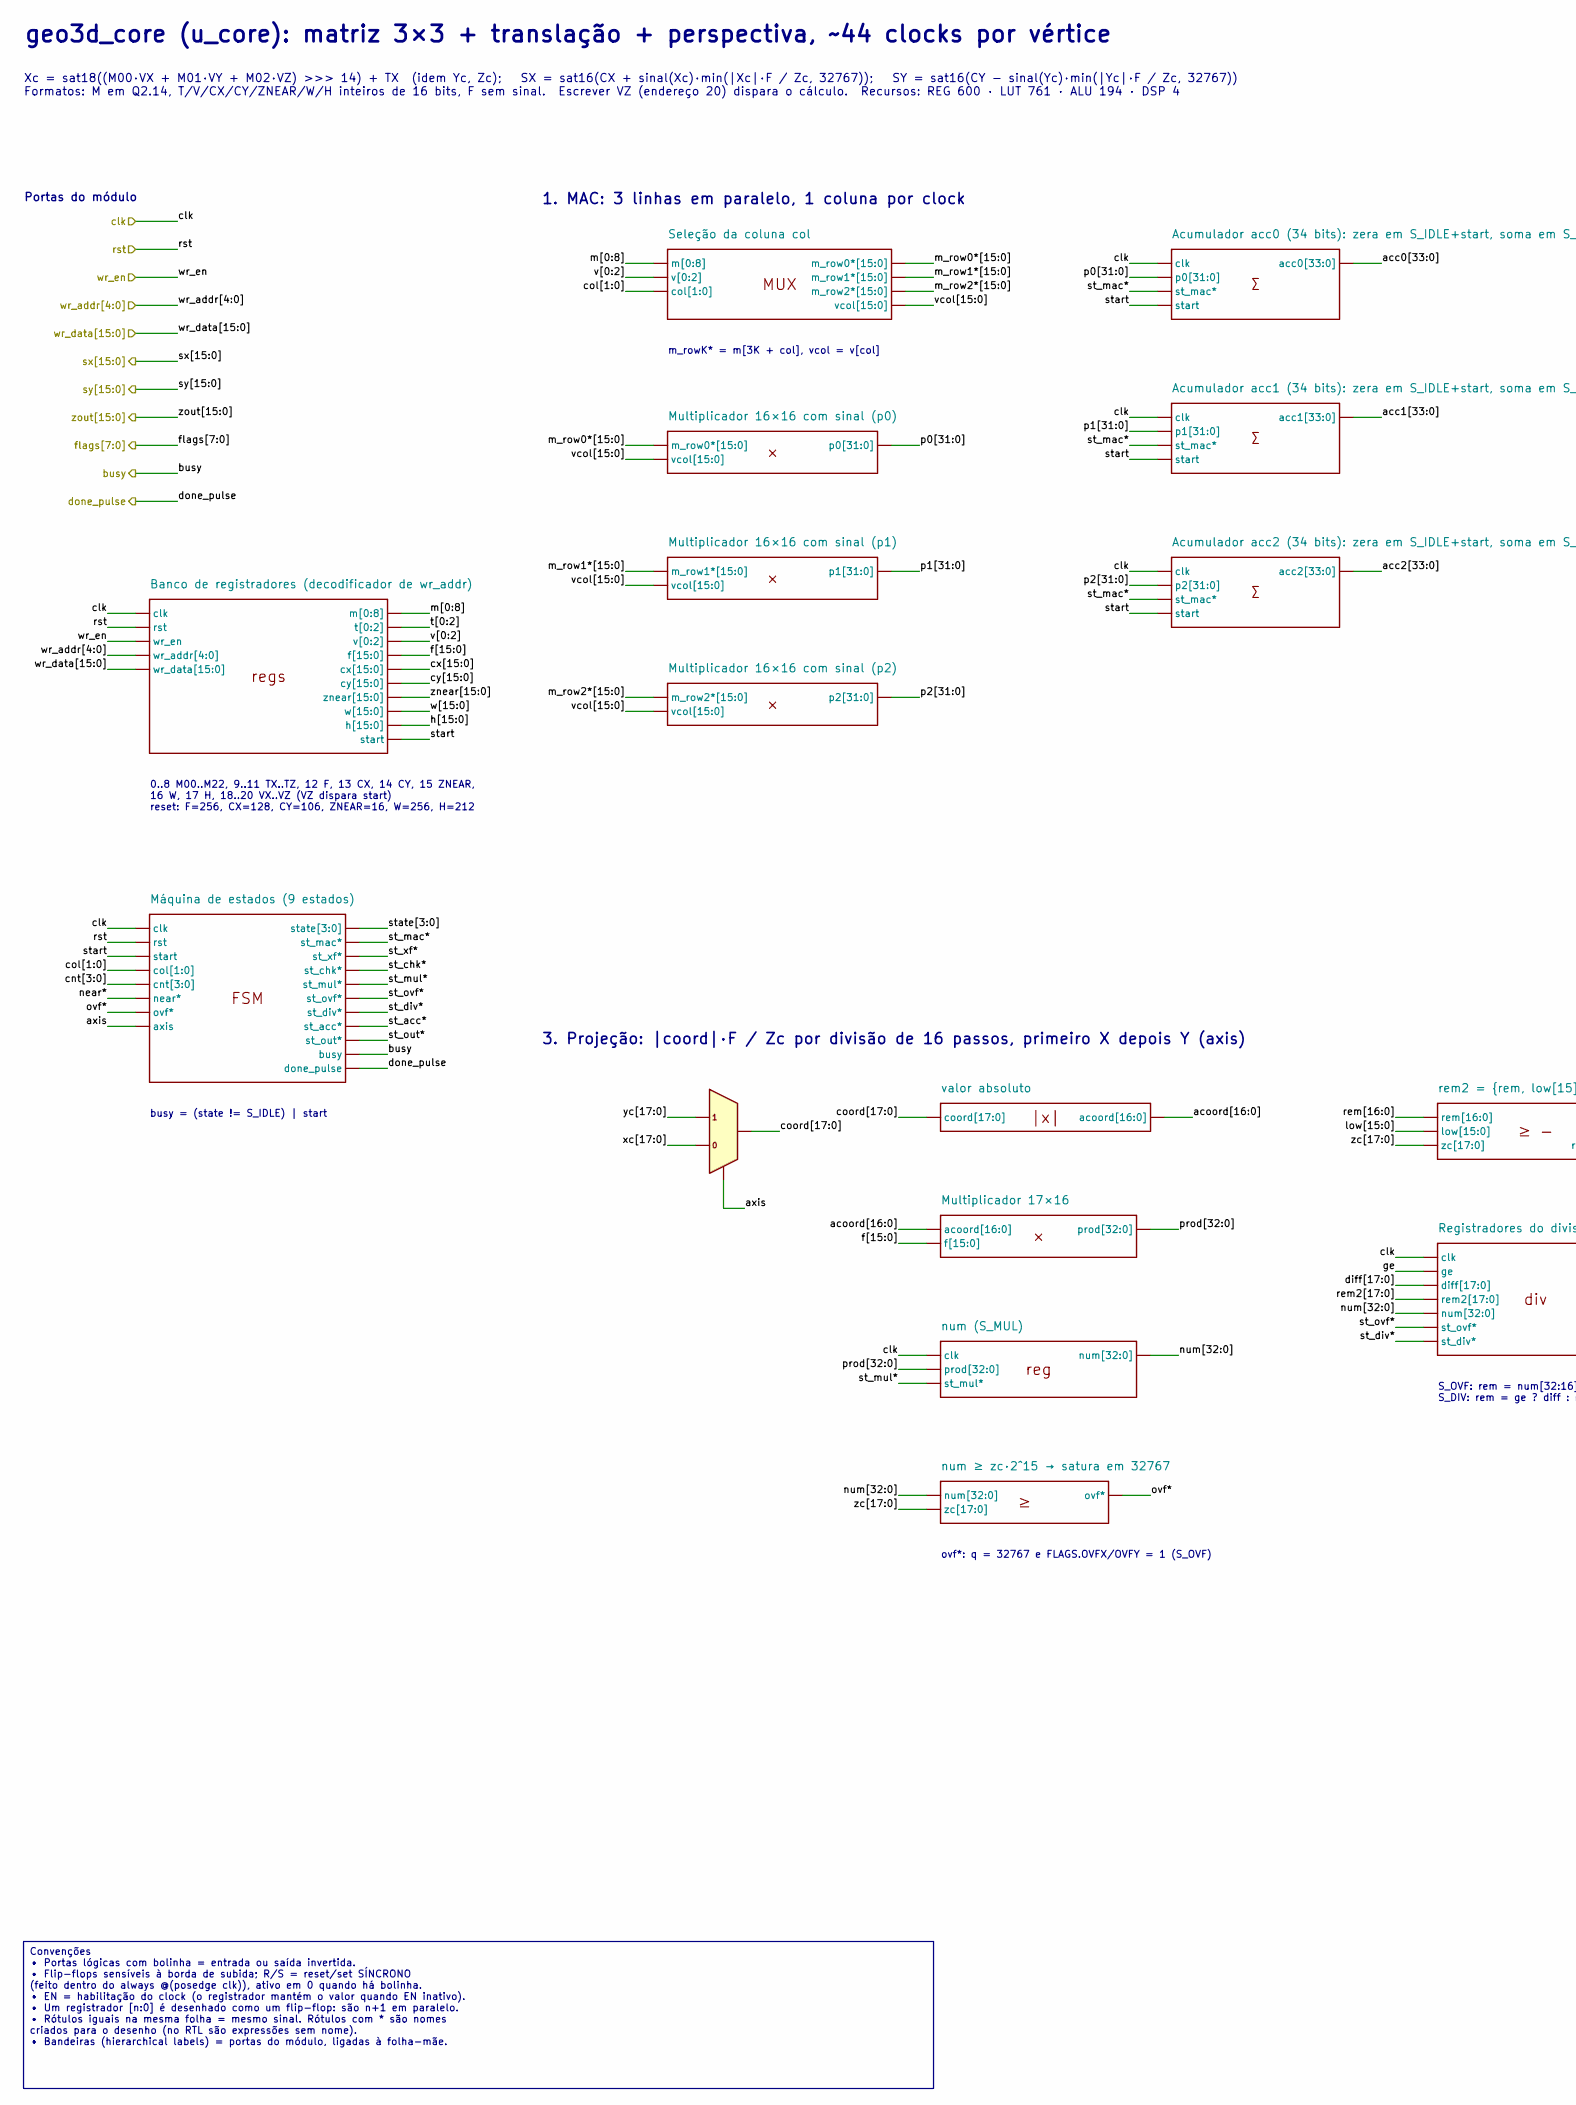
[picture p62: schematic geo3d_core.kicad_sch, part in row 1, column 1]

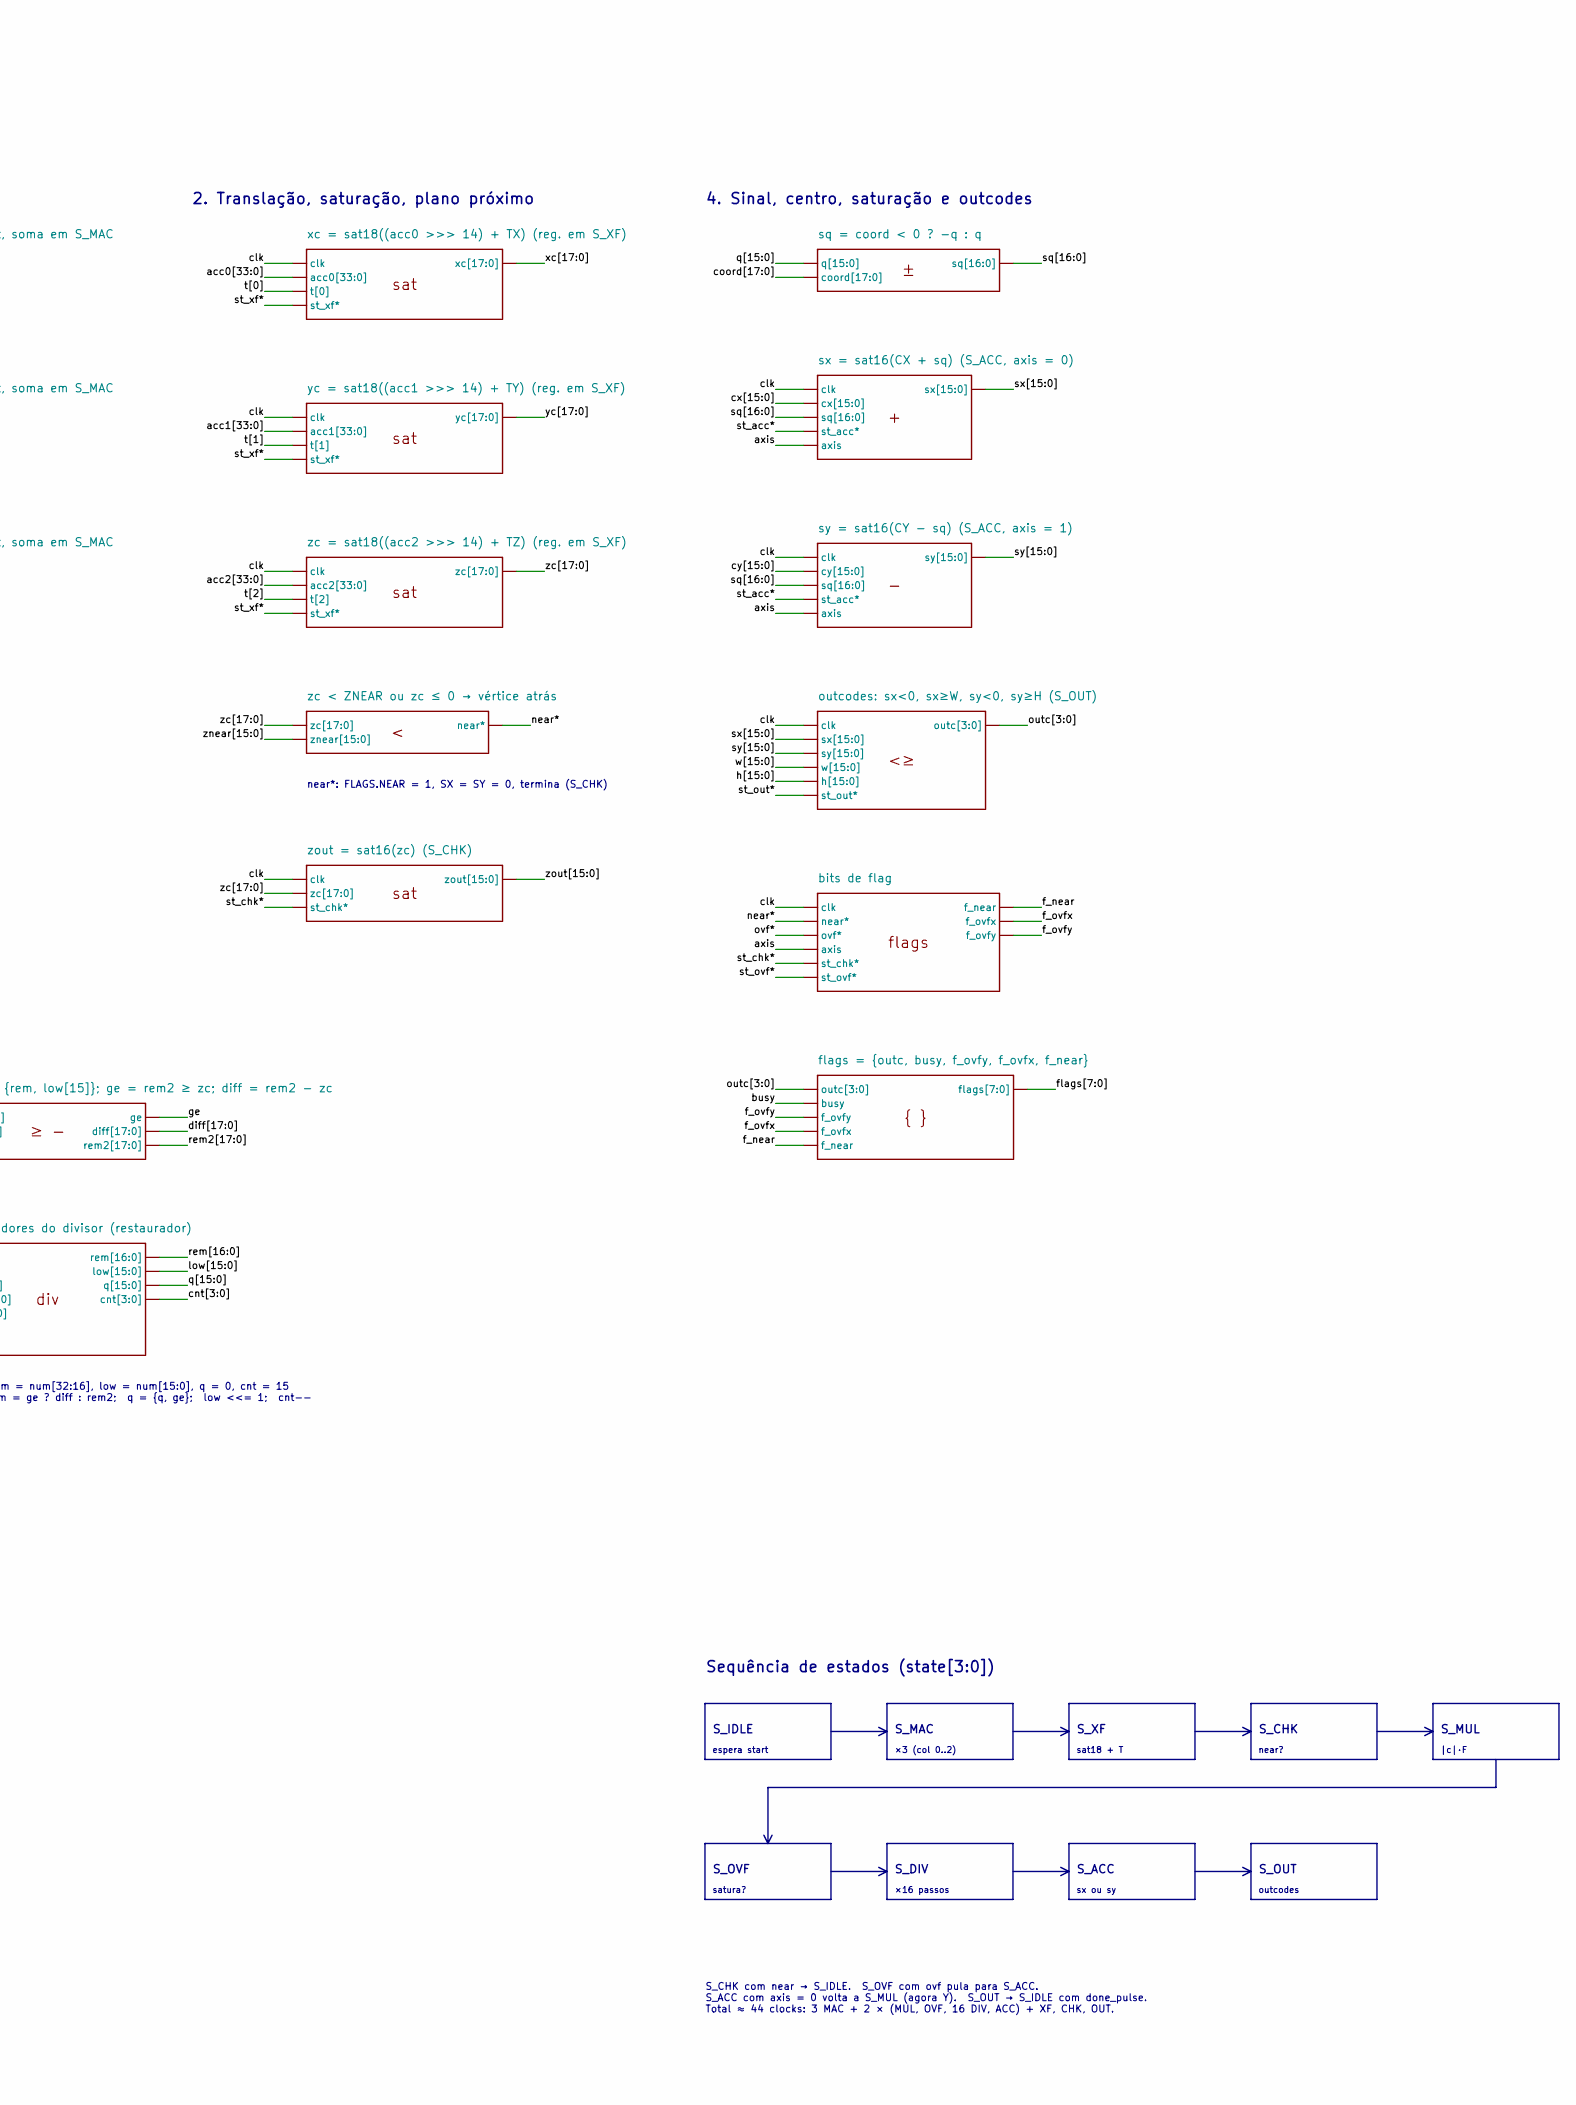
[picture p63: schematic geo3d_core.kicad_sch, part in row 1, column 2]

Parts:
U135: Banco de registradores (decodificador de wr_addr)
U136: Máquina de estados (9 estados)
U137: Seleção da coluna col
U138: Multiplicador 16×16 com sinal (p0)
U139: Multiplicador 16×16 com sinal (p1)
U140: Multiplicador 16×16 com sinal (p2)
U141: Acumulador acc0 (34 bits): zera em S_IDLE+start, 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
U142: Acumulador acc1 (34 bits): zera em S_IDLE+start, 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
U143: Acumulador acc2 (34 bits): zera em S_IDLE+start, 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
U144: xc = sat18((acc0 >>> 14) + TX) (reg. em S_XF)
U145: yc = sat18((acc1 >>> 14) + TY) (reg. em S_XF)
U146: zc = sat18((acc2 >>> 14) + TZ) (reg. em S_XF)
U147: zc < ZNEAR ou zc ≤ 0 → vértice atrás
U148: zout = sat16(zc) (S_CHK)
U149: MUX2
U150: valor absoluto
U151: Multiplicador 17×16
U152: num (S_MUL)
U153: num ≥ zc·2^15 → satura em 32767
U154: rem2 = {rem, low[15]}; ge = rem2 ≥ zc; diff = rem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
U155: Registradores do divisor (restaurador)
U156: sq = coord < 0 ? -q : q
U157: sx = sat16(CX + sq) (S_ACC, axis = 0)
U158: sy = sat16(CY - sq) (S_ACC, axis = 1)
U159: outcodes: sx<0, sx≥W, sy<0, sy≥H (S_OUT)
U160: bits de flag
U161: flags = {outc, busy, f_ovfy, f_ovfx, f_near}

Connections:
acc0[33:0]: U141.5 (acc0[33:0]), U144.2 (acc0[33:0])
acc1[33:0]: U142.5 (acc1[33:0]), U145.2 (acc1[33:0])
acc2[33:0]: U143.5 (acc2[33:0]), U146.2 (acc2[33:0])
acoord[16:0]: U150.2 (acoord[16:0]), U151.1 (acoord[16:0])
axis: U136.8 (axis), U149.3, U157.5 (axis), U158.5 (axis), U160.4 (axis)
busy: U136.18 (busy), U161.2 (busy)
clk: U135.1 (clk), U136.1 (clk), U141.1 (clk), U142.1 (clk), U143.1 (clk), U144.1 (clk), U145.1 (clk), U146.1 (clk), U148.1 (clk), U152.1 (clk), U155.1 (clk), U157.1 (clk), U158.1 (clk), U159.1 (clk), U160.1 (clk)
cnt[3:0]: U136.5 (cnt[3:0]), U155.11 (cnt[3:0])
col[1:0]: U136.4 (col[1:0]), U137.3 (col[1:0])
coord[17:0]: U149.4, U150.1 (coord[17:0]), U156.2 (coord[17:0])
cx[15:0]: U135.10 (cx[15:0]), U157.2 (cx[15:0])
cy[15:0]: U135.11 (cy[15:0]), U158.2 (cy[15:0])
diff[17:0]: U154.5 (diff[17:0]), U155.3 (diff[17:0])
done_pulse: U136.19 (done_pulse)
f[15:0]: U135.9 (f[15:0]), U151.2 (f[15:0])
f_near: U160.7 (f_near), U161.5 (f_near)
f_ovfx: U160.8 (f_ovfx), U161.4 (f_ovfx)
f_ovfy: U160.9 (f_ovfy), U161.3 (f_ovfy)
flags[7:0]: U161.6 (flags[7:0])
ge: U154.4 (ge), U155.2 (ge)
h[15:0]: U135.14 (h[15:0]), U159.5 (h[15:0])
low[15:0]: U154.2 (low[15:0]), U155.9 (low[15:0])
m[0:8]: U135.6 (m[0:8]), U137.1 (m[0:8])
m_row0*[15:0]: U137.4 (m_row0*[15:0]), U138.1 (m_row0*[15:0])
m_row1*[15:0]: U137.5 (m_row1*[15:0]), U139.1 (m_row1*[15:0])
m_row2*[15:0]: U137.6 (m_row2*[15:0]), U140.1 (m_row2*[15:0])
near*: U136.6 (near*), U147.3 (near*), U160.2 (near*)
num[32:0]: U152.4 (num[32:0]), U153.1 (num[32:0]), U155.5 (num[32:0])
outc[3:0]: U159.7 (outc[3:0]), U161.1 (outc[3:0])
ovf*: U136.7 (ovf*), U153.3 (ovf*), U160.3 (ovf*)
p0[31:0]: U138.3 (p0[31:0]), U141.2 (p0[31:0])
p1[31:0]: U139.3 (p1[31:0]), U142.2 (p1[31:0])
p2[31:0]: U140.3 (p2[31:0]), U143.2 (p2[31:0])
prod[32:0]: U151.3 (prod[32:0]), U152.2 (prod[32:0])
q[15:0]: U155.10 (q[15:0]), U156.1 (q[15:0])
rem2[17:0]: U154.6 (rem2[17:0]), U155.4 (rem2[17:0])
rem[16:0]: U154.1 (rem[16:0]), U155.8 (rem[16:0])
rst: U135.2 (rst), U136.2 (rst)
sq[16:0]: U156.3 (sq[16:0]), U157.3 (sq[16:0]), U158.3 (sq[16:0])
st_acc*: U136.16 (st_acc*), U157.4 (st_acc*), U158.4 (st_acc*)
st_chk*: U136.12 (st_chk*), U148.3 (st_chk*), U160.5 (st_chk*)
st_div*: U136.15 (st_div*), U155.7 (st_div*)
st_mac*: U136.10 (st_mac*), U141.3 (st_mac*), U142.3 (st_mac*), U143.3 (st_mac*)
st_mul*: U136.13 (st_mul*), U152.3 (st_mul*)
st_out*: U136.17 (st_out*), U159.6 (st_out*)
st_ovf*: U136.14 (st_ovf*), U155.6 (st_ovf*), U160.6 (st_ovf*)
st_xf*: U136.11 (st_xf*), U144.4 (st_xf*), U145.4 (st_xf*), U146.4 (st_xf*)
start: U135.15 (start), U136.3 (start), U141.4 (start), U142.4 (start), U143.4 (start)
state[3:0]: U136.9 (state[3:0])
sx[15:0]: U157.6 (sx[15:0]), U159.2 (sx[15:0])
sy[15:0]: U158.6 (sy[15:0]), U159.3 (sy[15:0])
t[0:2]: U135.7 (t[0:2])
t[0]: U144.3 (t[0])
t[1]: U145.3 (t[1])
t[2]: U146.3 (t[2])
v[0:2]: U135.8 (v[0:2]), U137.2 (v[0:2])
vcol[15:0]: U137.7 (vcol[15:0]), U138.2 (vcol[15:0]), U139.2 (vcol[15:0]), U140.2 (vcol[15:0])
w[15:0]: U135.13 (w[15:0]), U159.4 (w[15:0])
wr_addr[4:0]: U135.4 (wr_addr[4:0])
wr_data[15:0]: U135.5 (wr_data[15:0])
wr_en: U135.3 (wr_en)
xc[17:0]: U144.5 (xc[17:0]), U149.2
yc[17:0]: U145.5 (yc[17:0]), U149.1
zc[17:0]: U146.5 (zc[17:0]), U147.1 (zc[17:0]), U148.2 (zc[17:0]), U153.2 (zc[17:0]), U154.3 (zc[17:0])
znear[15:0]: U135.12 (znear[15:0]), U147.2 (znear[15:0])
zout[15:0]: U148.4 (zout[15:0])

Notes on the sheet:
geo3d_core (u_core): matriz 3×3 + translação + perspectiva, ~44 clocks por vértice
Xc = sat18((M00·VX + M01·VY + M02·VZ) >>> 14) + TX (idem Yc, Zc); SX = sat16(CX + sinal(Xc)·min(|Xc|·F / Zc, 32767)); SY = sat16(CY - sinal(Yc)·min(|Yc|·F / Zc, 32767)) Formatos: M em Q2.14, T/V/CX/CY/ZNEAR/W/H inteiros de 16 bits, F sem sinal. Escrever VZ (endereço 20) dispara o cálculo. Recursos: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
Portas do módulo
0..8 M00..M22, 9..11 TX..TZ, 12 F, 13 CX, 14 CY, 15 ZNEAR, 16 W, 17 H, 18..20 VX..VZ (VZ dispara start) reset: F=256, CX=128, CY=106, ZNEAR=16, W=256, H=212
busy = (state != S_IDLE) | start
1. MAC: 3 linhas em paralelo, 1 coluna por clock
m_rowK* = m[3K + col], vcol = v[col]
near*: FLAGS.NEAR = 1, SX = SY = 0, termina (S_CHK)
2. Translação, saturação, plano próximo
3. Projeção: |coord|·F / Zc por divisão de 16 passos, primeiro X depois Y (axis)
ovf*: q = 32767 e FLAGS.OVFX/OVFY = 1 (S_OVF)
S_OVF: rem = num[32:16], low = num[15:0], q = 0, cnt = 15 S_DIV: rem = ge ? diff : rem2; q = {q, ge}; low <<= 1; cnt--
4. Sinal, centro, saturação e outcodes
Sequência de estados (state[3:0])
S_IDLE
espera start
S_MAC
×3 (col 0..2)
S_XF
sat18 + T
S_CHK
near?
S_MUL
|c|·F
S_OVF
satura?
S_DIV
×16 passos
S_ACC
sx ou sy
S_OUT
outcodes
S_CHK com near → S_IDLE. S_OVF com ovf pula para S_ACC. S_ACC com axis = 0 volta a S_MUL (agora Y). S_OUT → S_IDLE com done_pulse. Total ≈ 44 clocks: 3 MAC + 2 × (MUL, OVF, 16 DIV, ACC) + XF, CHK, OUT.
Convenções • Portas lógicas com bolinha = entrada ou saída invertida. • Flip-flops sensíveis à borda de subida; R/S = reset/set SÍNCRONO (feito dentro do always @(posedge clk)), ativo em 0 quando há bolinha. • EN = habilitação do clock (o registrador mantém o valor quando EN inativo). • Um registra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
