alexmoncks/V9968_Cartridge/geo3d/docs/kicad/geo3d_engine.kicad_sch

## KiCad design geo3d/docs/kicad/geo3d_engine.kicad_sch (2026-10-27)

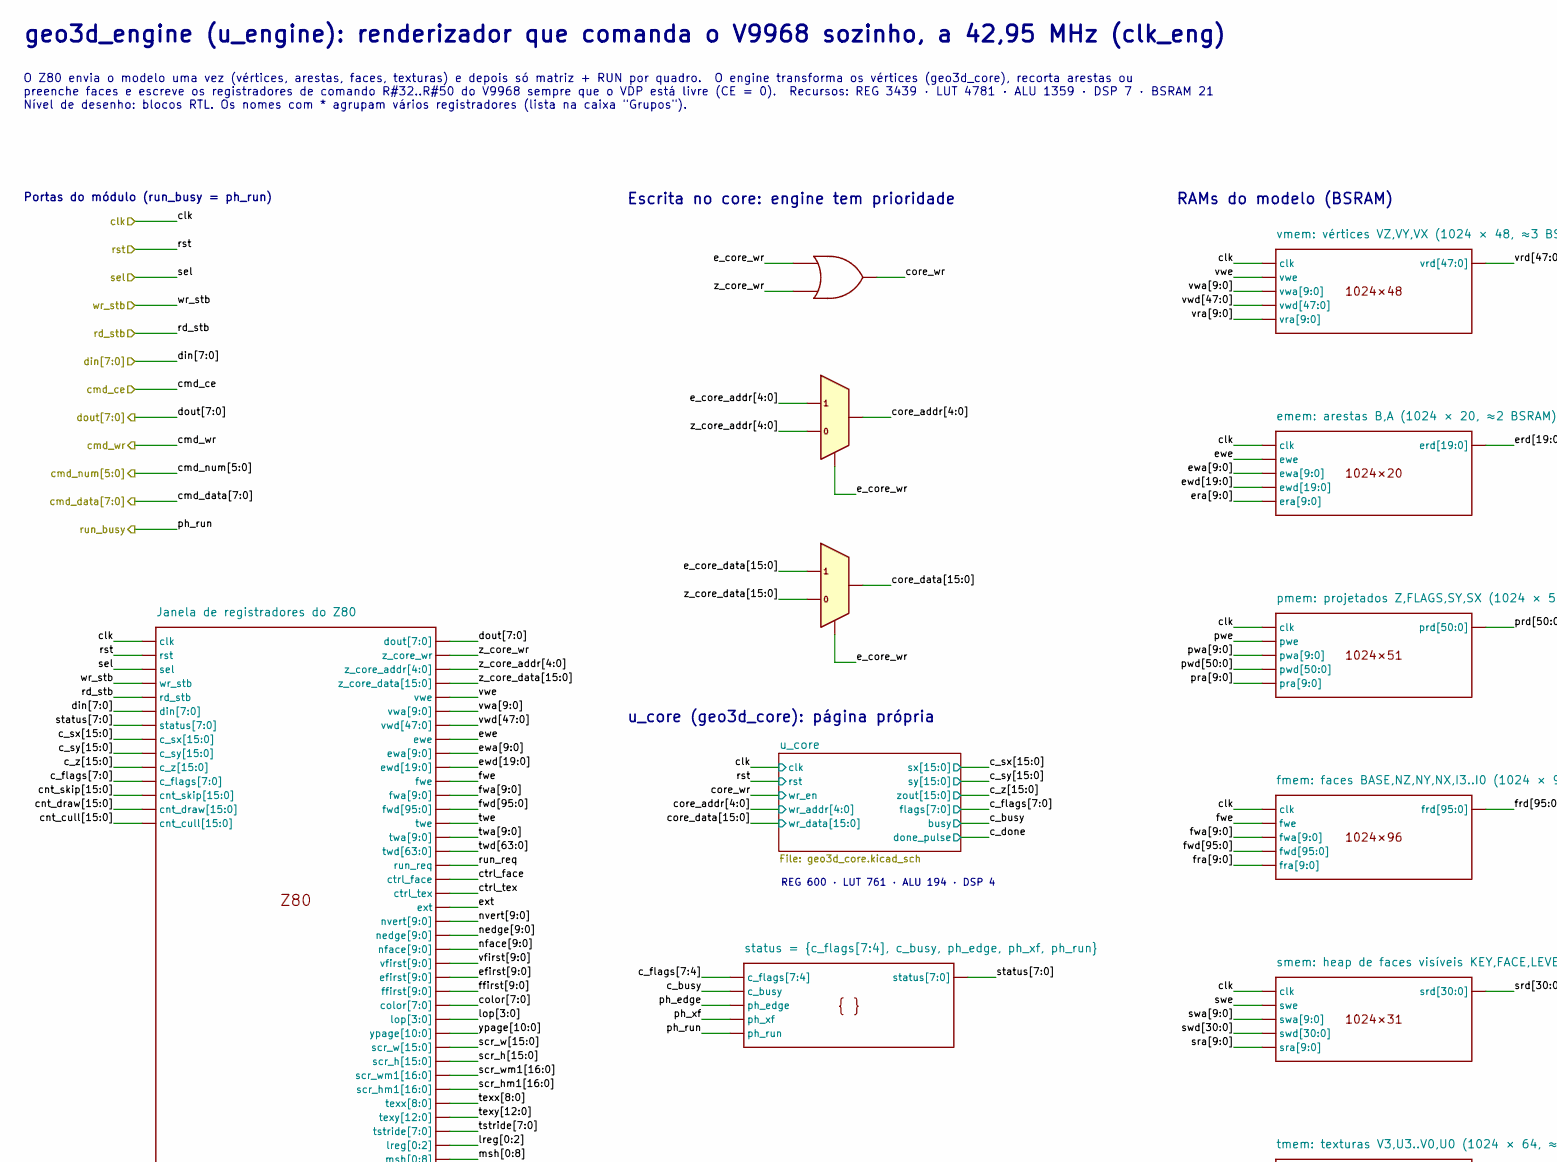
[picture p64: schematic geo3d_engine.kicad_sch, part in row 1, column 1]

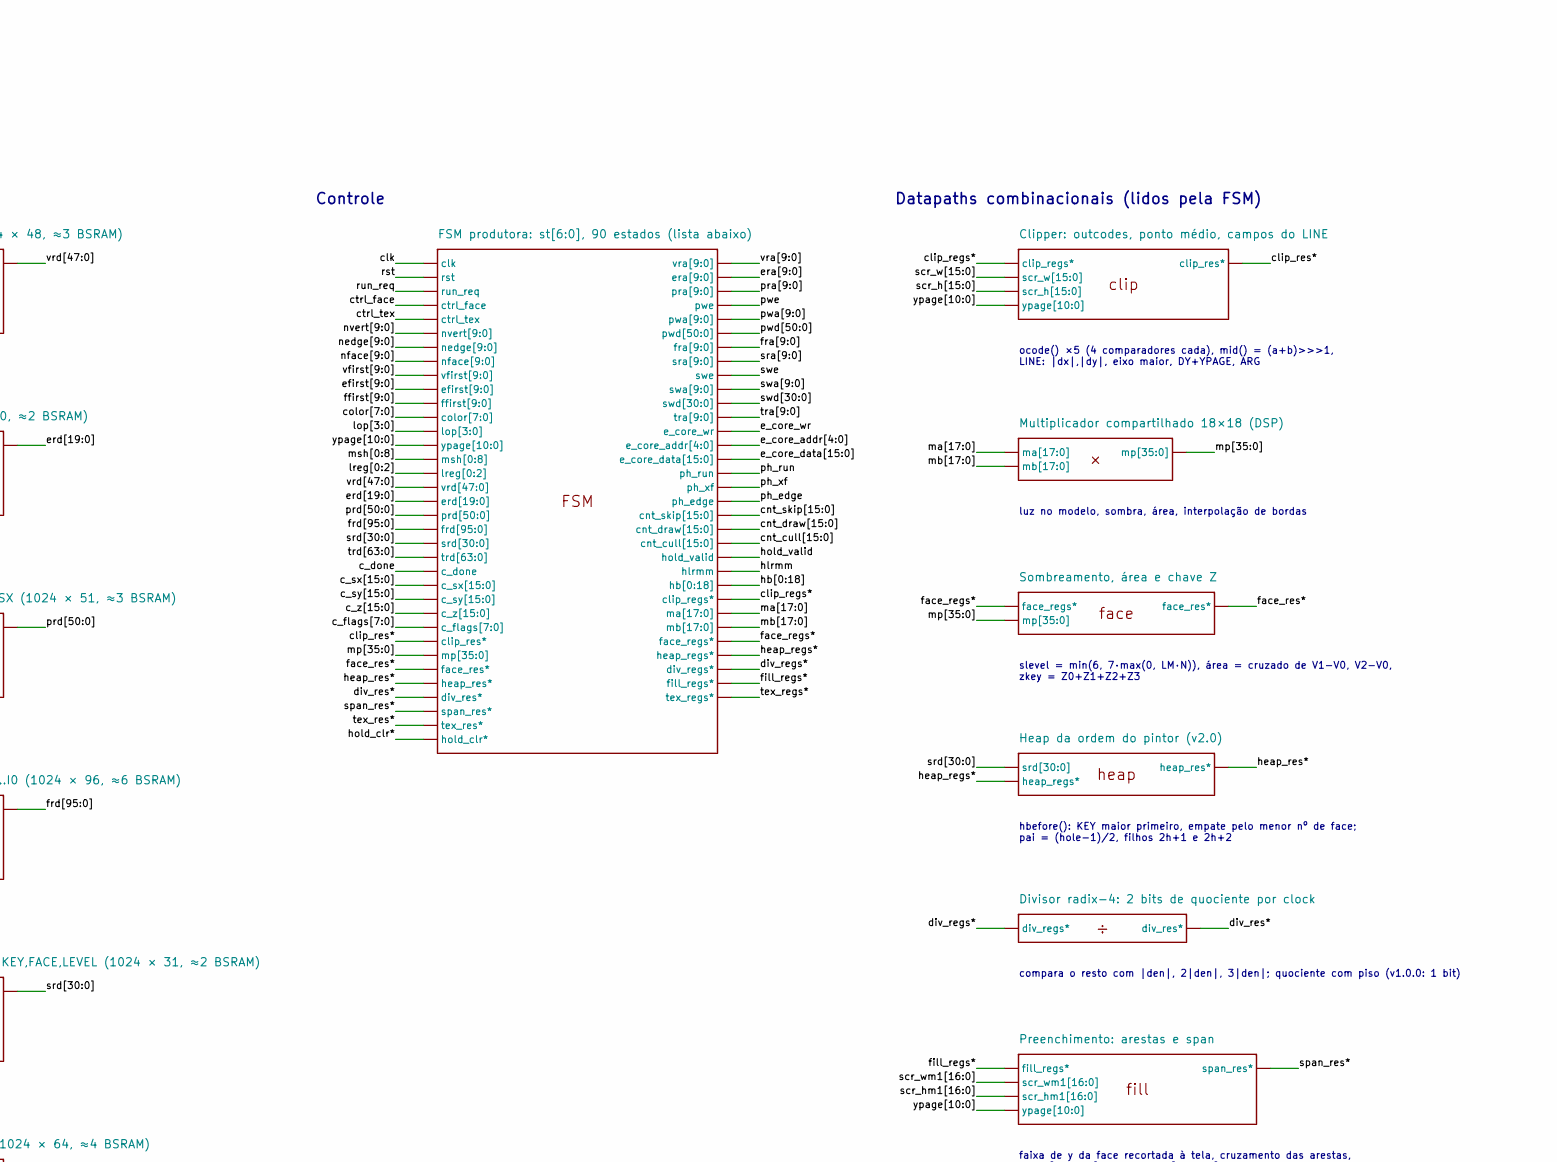
[picture p65: schematic geo3d_engine.kicad_sch, part in row 1, column 2]

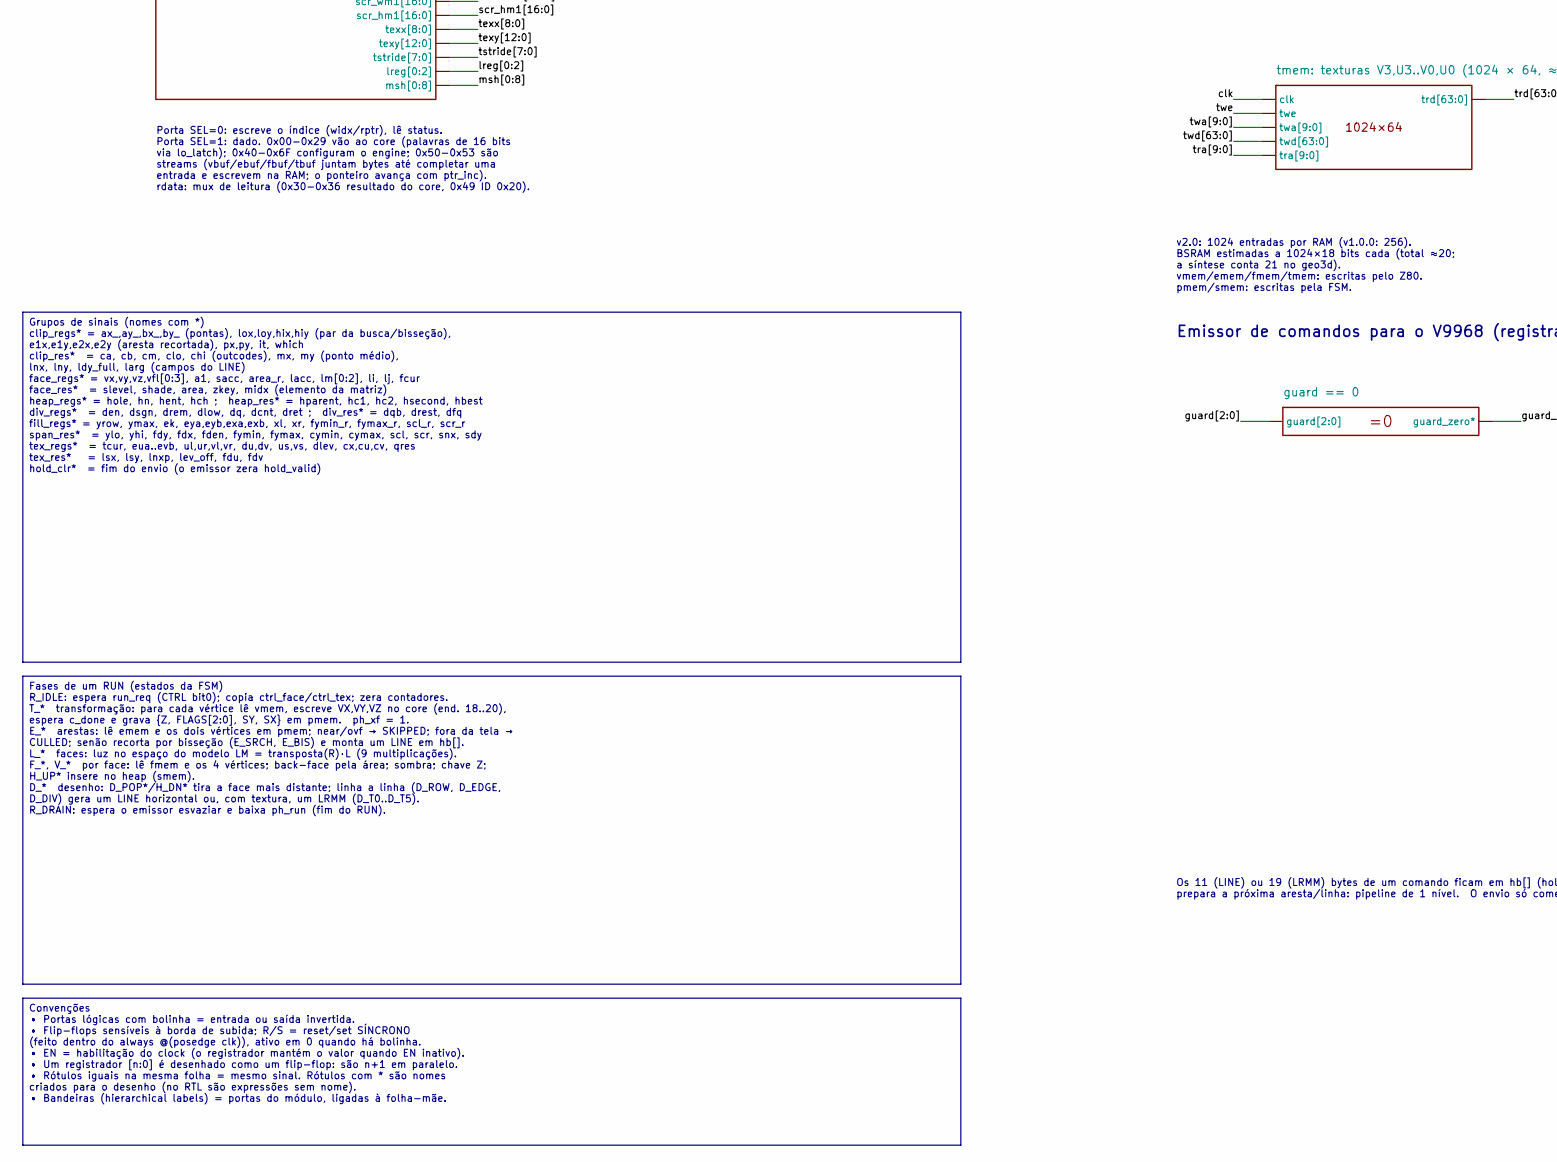
[picture p66: schematic geo3d_engine.kicad_sch, part in row 2, column 1]

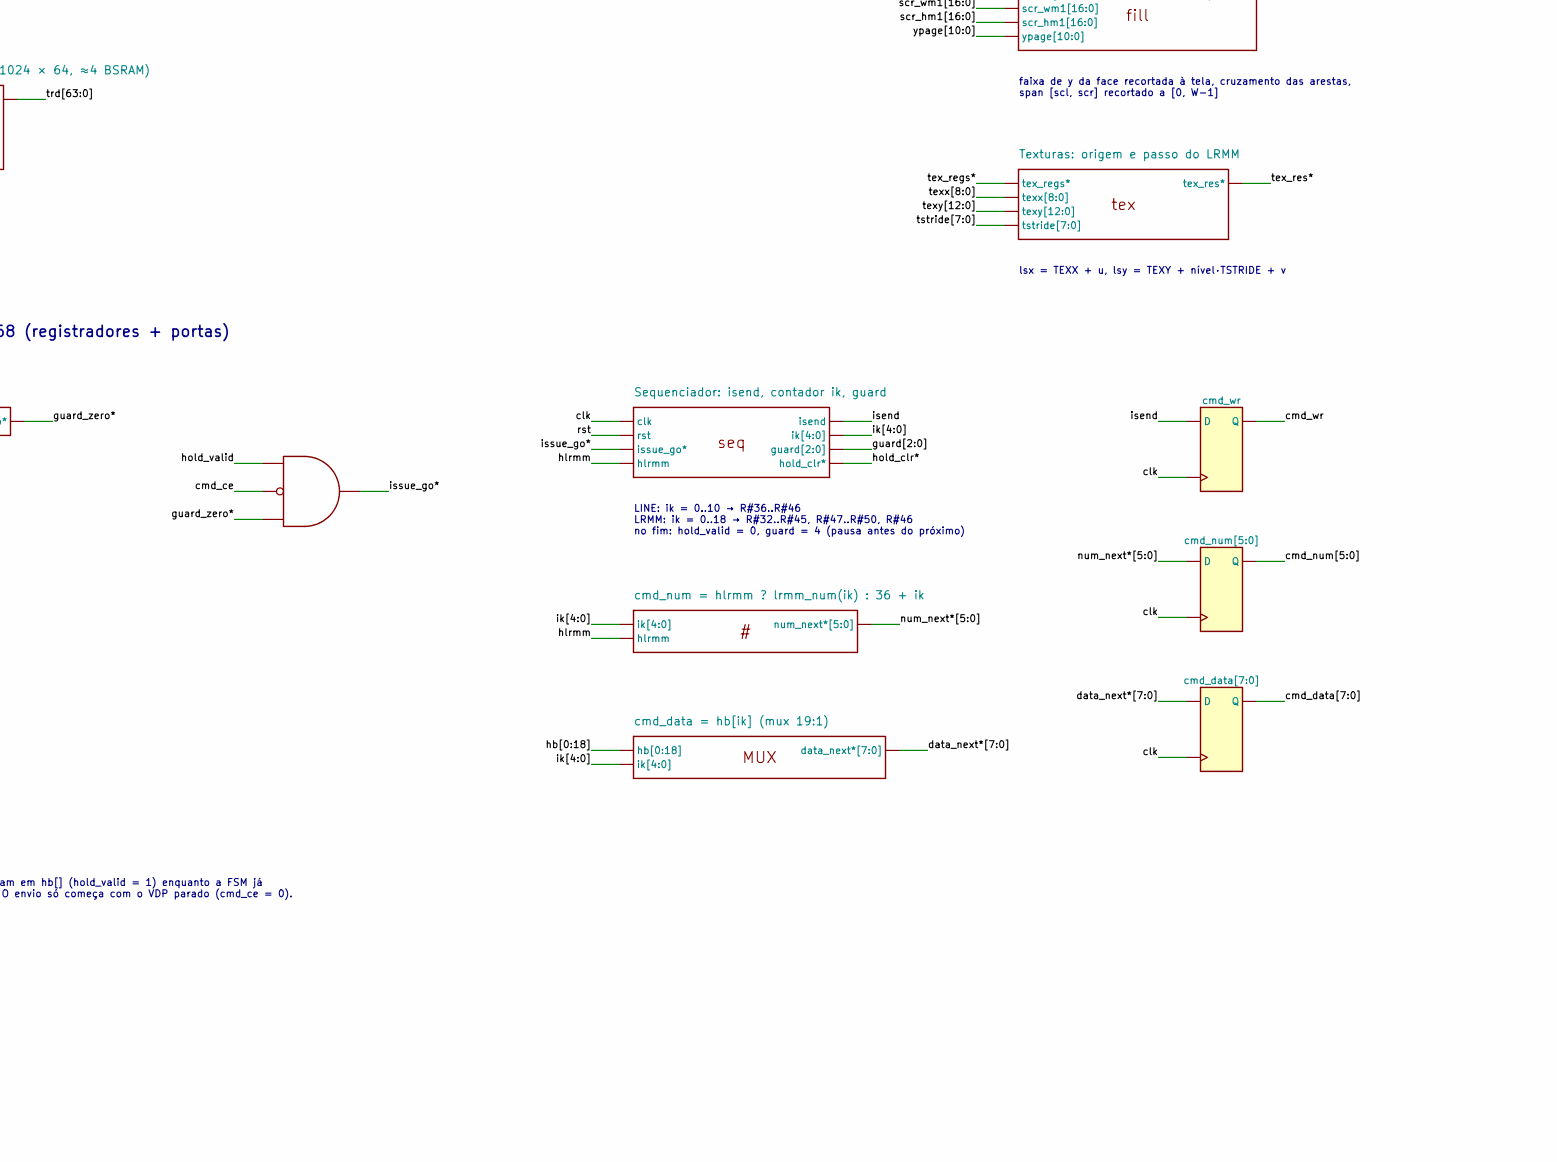
[picture p67: schematic geo3d_engine.kicad_sch, part in row 2, column 2]

Parts:
U108: Janela de registradores do Z80
U109: OR2
U110, U111: MUX2
U112: status = {c_flags[7:4], c_busy, ph_edge, ph_xf, p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
U113: vmem: vértices VZ,VY,VX (1024 × 48, ≈3 BSRAM)
U114: emem: arestas B,A (1024 × 20, ≈2 BSRAM)
U115: pmem: projetados Z,FLAGS,SY,SX (1024 × 51, ≈3 BSR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
U116: fmem: faces BASE,NZ,NY,NX,I3..I0 (1024 × 96, ≈6 B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
U117: smem: heap de faces visíveis KEY,FACE,LEVEL (1024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
U118: tmem: texturas V3,U3..V0,U0 (1024 × 64, ≈4 BSRAM)
U119: FSM produtora: st[6:0], 90 estados (lista abaixo)
U120: Clipper: outcodes, ponto médio, campos do LINE
U121: Multiplicador compartilhado 18×18 (DSP)
U122: Sombreamento, área e chave Z
U123: Heap da ordem do pintor (v2.0)
U124: Divisor radix-4: 2 bits de quociente por clock
U125: Preenchimento: arestas e span
U126: Texturas: origem e passo do LRMM
U127: guard == 0
U128: AND3_N1
U129: Sequenciador: isend, contador ik, guard
U130: cmd_num = hlrmm ? lrmm_num(ik) : 36 + ik
U131: cmd_data = hb[ik] (mux 19:1)
U132: cmd_wr
U133: cmd_num[5:0]
U134: cmd_data[7:0]

Connections:
c_busy: U112.2 (c_busy)
c_done: U119.23 (c_done)
c_flags[7:0]: U108.11 (c_flags[7:0]), U119.27 (c_flags[7:0])
c_flags[7:4]: U112.1 (c_flags[7:4])
c_sx[15:0]: U108.8 (c_sx[15:0]), U119.24 (c_sx[15:0])
c_sy[15:0]: U108.9 (c_sy[15:0]), U119.25 (c_sy[15:0])
c_z[15:0]: U108.10 (c_z[15:0]), U119.26 (c_z[15:0])
clip_regs*: U119.60 (clip_regs*), U120.1 (clip_regs*)
clip_res*: U119.28 (clip_res*), U120.5 (clip_res*)
clk: U108.1 (clk), U113.1 (clk), U114.1 (clk), U115.1 (clk), U116.1 (clk), U117.1 (clk), U118.1 (clk), U119.1 (clk), U129.1 (clk), U132.2, U133.2, U134.2
cmd_ce: U128.2
cmd_data[7:0]: U134.3 (Q)
cmd_num[5:0]: U133.3 (Q)
cmd_wr: U132.3 (Q)
cnt_cull[15:0]: U108.14 (cnt_cull[15:0]), U119.56 (cnt_cull[15:0])
cnt_draw[15:0]: U108.13 (cnt_draw[15:0]), U119.55 (cnt_draw[15:0])
cnt_skip[15:0]: U108.12 (cnt_skip[15:0]), U119.54 (cnt_skip[15:0])
color[7:0]: U108.41 (color[7:0]), U119.12 (color[7:0])
core_addr[4:0]: U110.4
core_data[15:0]: U111.4
core_wr: U109.3
ctrl_face: U108.32 (ctrl_face), U119.4 (ctrl_face)
ctrl_tex: U108.33 (ctrl_tex), U119.5 (ctrl_tex)
data_next*[7:0]: U131.3 (data_next*[7:0]), U134.1 (D)
din[7:0]: U108.6 (din[7:0])
div_regs*: U119.65 (div_regs*), U124.1 (div_regs*)
div_res*: U119.32 (div_res*), U124.2 (div_res*)
dout[7:0]: U108.15 (dout[7:0])
e_core_addr[4:0]: U110.1, U119.49 (e_core_addr[4:0])
e_core_data[15:0]: U111.1, U119.50 (e_core_data[15:0])
e_core_wr: U109.1, U110.3, U111.3, U119.48 (e_core_wr)
efirst[9:0]: U108.39 (efirst[9:0]), U119.10 (efirst[9:0])
era[9:0]: U114.5 (era[9:0]), U119.37 (era[9:0])
erd[19:0]: U114.6 (erd[19:0]), U119.18 (erd[19:0])
ewa[9:0]: U108.23 (ewa[9:0]), U114.3 (ewa[9:0])
ewd[19:0]: U108.24 (ewd[19:0]), U114.4 (ewd[19:0])
ewe: U108.22 (ewe), U114.2 (ewe)
ext: U108.34 (ext)
face_regs*: U119.63 (face_regs*), U122.1 (face_regs*)
face_res*: U119.30 (face_res*), U122.3 (face_res*)
ffirst[9:0]: U108.40 (ffirst[9:0]), U119.11 (ffirst[9:0])
fill_regs*: U119.66 (fill_regs*), U125.1 (fill_regs*)
fra[9:0]: U116.5 (fra[9:0]), U119.42 (fra[9:0])
frd[95:0]: U116.6 (frd[95:0]), U119.20 (frd[95:0])
fwa[9:0]: U108.26 (fwa[9:0]), U116.3 (fwa[9:0])
fwd[95:0]: U108.27 (fwd[95:0]), U116.4 (fwd[95:0])
fwe: U108.25 (fwe), U116.2 (fwe)
guard[2:0]: U127.1 (guard[2:0]), U129.7 (guard[2:0])
guard_zero*: U127.2 (guard_zero*), U128.3
hb[0:18]: U119.59 (hb[0:18]), U131.1 (hb[0:18])
heap_regs*: U119.64 (heap_regs*), U123.2 (heap_regs*)
heap_res*: U119.31 (heap_res*), U123.3 (heap_res*)
hlrmm: U119.58 (hlrmm), U129.4 (hlrmm), U130.2 (hlrmm)
hold_clr*: U119.35 (hold_clr*), U129.8 (hold_clr*)
hold_valid: U119.57 (hold_valid), U128.1
ik[4:0]: U129.6 (ik[4:0]), U130.1 (ik[4:0]), U131.2 (ik[4:0])
isend: U129.5 (isend), U132.1 (D)
issue_go*: U128.4, U129.3 (issue_go*)
lop[3:0]: U108.42 (lop[3:0]), U119.13 (lop[3:0])
lreg[0:2]: U108.51 (lreg[0:2]), U119.16 (lreg[0:2])
ma[17:0]: U119.61 (ma[17:0]), U121.1 (ma[17:0])
mb[17:0]: U119.62 (mb[17:0]), U121.2 (mb[17:0])
mp[35:0]: U119.29 (mp[35:0]), U121.3 (mp[35:0]), U122.2 (mp[35:0])
msh[0:8]: U108.52 (msh[0:8]), U119.15 (msh[0:8])
nedge[9:0]: U108.36 (nedge[9:0]), U119.7 (nedge[9:0])
nface[9:0]: U108.37 (nface[9:0]), U119.8 (nface[9:0])
num_next*[5:0]: U130.3 (num_next*[5:0]), U133.1 (D)
nvert[9:0]: U108.35 (nvert[9:0]), U119.6 (nvert[9:0])
ph_edge: U112.3 (ph_edge), U119.53 (ph_edge)
ph_run: U112.5 (ph_run), U119.51 (ph_run)
ph_xf: U112.4 (ph_xf), U119.52 (ph_xf)
pra[9:0]: U115.5 (pra[9:0]), U119.38 (pra[9:0])
prd[50:0]: U115.6 (prd[50:0]), U119.19 (prd[50:0])
pwa[9:0]: U115.3 (pwa[9:0]), U119.40 (pwa[9:0])
pwd[50:0]: U115.4 (pwd[50:0]), U119.41 (pwd[50:0])
pwe: U115.2 (pwe), U119.39 (pwe)
rd_stb: U108.5 (rd_stb)
rst: U108.2 (rst), U119.2 (rst), U129.2 (rst)
run_req: U108.31 (run_req), U119.3 (run_req)
scr_h[15:0]: U108.45 (scr_h[15:0]), U120.3 (scr_h[15:0])
scr_hm1[16:0]: U108.47 (scr_hm1[16:0]), U125.3 (scr_hm1[16:0])
scr_w[15:0]: U108.44 (scr_w[15:0]), U120.2 (scr_w[15:0])
scr_wm1[16:0]: U108.46 (scr_wm1[16:0]), U125.2 (scr_wm1[16:0])
sel: U108.3 (sel)
span_res*: U119.33 (span_res*), U125.5 (span_res*)
sra[9:0]: U117.5 (sra[9:0]), U119.43 (sra[9:0])
srd[30:0]: U117.6 (srd[30:0]), U119.21 (srd[30:0]), U123.1 (srd[30:0])
status[7:0]: U108.7 (status[7:0]), U112.6 (status[7:0])
swa[9:0]: U117.3 (swa[9:0]), U119.45 (swa[9:0])
swd[30:0]: U117.4 (swd[30:0]), U119.46 (swd[30:0])
swe: U117.2 (swe), U119.44 (swe)
tex_regs*: U119.67 (tex_regs*), U126.1 (tex_regs*)
tex_res*: U119.34 (tex_res*), U126.5 (tex_res*)
texx[8:0]: U108.48 (texx[8:0]), U126.2 (texx[8:0])
texy[12:0]: U108.49 (texy[12:0]), U126.3 (texy[12:0])
tra[9:0]: U118.5 (tra[9:0]), U119.47 (tra[9:0])
trd[63:0]: U118.6 (trd[63:0]), U119.22 (trd[63:0])
tstride[7:0]: U108.50 (tstride[7:0]), U126.4 (tstride[7:0])
twa[9:0]: U108.29 (twa[9:0]), U118.3 (twa[9:0])
twd[63:0]: U108.30 (twd[63:0]), U118.4 (twd[63:0])
twe: U108.28 (twe), U118.2 (twe)
vfirst[9:0]: U108.38 (vfirst[9:0]), U119.9 (vfirst[9:0])
vra[9:0]: U113.5 (vra[9:0]), U119.36 (vra[9:0])
vrd[47:0]: U113.6 (vrd[47:0]), U119.17 (vrd[47:0])
vwa[9:0]: U108.20 (vwa[9:0]), U113.3 (vwa[9:0])
vwd[47:0]: U108.21 (vwd[47:0]), U113.4 (vwd[47:0])
vwe: U108.19 (vwe), U113.2 (vwe)
wr_stb: U108.4 (wr_stb)
ypage[10:0]: U108.43 (ypage[10:0]), U119.14 (ypage[10:0]), U120.4 (ypage[10:0]), U125.4 (ypage[10:0])
z_core_addr[4:0]: U108.17 (z_core_addr[4:0]), U110.2
z_core_data[15:0]: U108.18 (z_core_data[15:0]), U111.2
z_core_wr: U108.16 (z_core_wr), U109.2

Notes on the sheet:
geo3d_engine (u_engine): renderizador que comanda o V9968 sozinho, a 42,95 MHz (clk_eng)
O Z80 envia o modelo uma vez (vértices, arestas, faces, texturas) e depois só matriz + RUN por quadro. O engine transforma os vértices (geo3d_core), recorta arestas ou preenche faces e escreve os registradores de comando R#32..R#50 do V9968 sempre que o VDP está livre (CE = 0). Recursos: REG 3439 ·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
Portas do módulo (run_busy = ph_run)
Porta SEL=0: escreve o índice (widx/rptr), lê status. Porta SEL=1: dado. 0x00-0x29 vão ao core (palavras de 16 bits via lo_latch); 0x40-0x6F configuram o engine; 0x50-0x53 são streams (vbuf/ebuf/fbuf/tbuf juntam bytes até completar uma entrada e escrevem na RAM; o ponteiro avança com ptr_inc). rdat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
Escrita no core: engine tem prioridade
u_core (geo3d_core): página própria
REG 600 · LUT 761 · ALU 194 · DSP 4
RAMs do modelo (BSRAM)
v2.0: 1024 entradas por RAM (v1.0.0: 256). BSRAM estimadas a 1024×18 bits cada (total ≈20; a síntese conta 21 no geo3d). vmem/emem/fmem/tmem: escritas pelo Z80. pmem/smem: escritas pela FSM.
Controle
Datapaths combinacionais (lidos pela FSM)
ocode() ×5 (4 comparadores cada), mid() = (a+b)>>>1, LINE: |dx|,|dy|, eixo maior, DY+YPAGE, ARG
luz no modelo, sombra, área, interpolação de bordas
slevel = min(6, 7·max(0, LM·N)), área = cruzado de V1-V0, V2-V0, zkey = Z0+Z1+Z2+Z3
hbefore(): KEY maior primeiro, empate pelo menor nº de face; pai = (hole-1)/2, filhos 2h+1 e 2h+2
compara o resto com |den|, 2|den|, 3|den|; quociente com piso (v1.0.0: 1 bit)
faixa de y da face recortada à tela, cruzamento das arestas, span [scl, scr] recortado a [0, W-1]
lsx = TEXX + u, lsy = TEXY + nível·TSTRIDE + v
Emissor de comandos para o V9968 (registradores + portas)
LINE: ik = 0..10 → R#36..R#46 LRMM: ik = 0..18 → R#32..R#45, R#47..R#50, R#46 no fim: hold_valid = 0, guard = 4 (pausa antes do próximo)
Os 11 (LINE) ou 19 (LRMM) bytes de um comando ficam em hb[] (hold_valid = 1) enquanto a FSM já prepara a próxima aresta/linha: pipeline de 1 nível. O envio só começa com o VDP parado (cmd_ce = 0).
Grupos de sinais (nomes com *) clip_regs* = ax_,ay_,bx_,by_ (pontas), lox,loy,hix,hiy (par da busca/bisseção), e1x,e1y,e2x,e2y (aresta recortada), px,py, it, which clip_res* = ca, cb, cm, clo, chi (outcodes), mx, my (ponto médio), lnx, lny, ldy_full, larg (campos do LINE) face_regs* = vx,vy,vz,vfl[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
Fases de um RUN (estados da FSM) R_IDLE: espera run_req (CTRL bit0); copia ctrl_face/ctrl_tex; zera contadores. T_* transformação: para cada vértice lê vmem, escreve VX,VY,VZ no core (end. 18..20), espera c_done e grava {Z, FLAGS[2:0], SY, SX} em pmem. ph_xf = 1. E_* arestas: lê emem e os dois vért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
Convenções • Portas lógicas com bolinha = entrada ou saída invertida. • Flip-flops sensíveis à borda de subida; R/S = reset/set SÍNCRONO (feito dentro do always @(posedge clk)), ativo em 0 quando há bolinha. • EN = habilitação do clock (o registrador mantém o valor quando EN inativo). • Um registra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
