alexmoncks/V9968_Cartridge/geo3d/docs/kicad/geo3d_logic.kicad_sch

## KiCad design geo3d/docs/kicad/geo3d_logic.kicad_sch (2026-10-27)

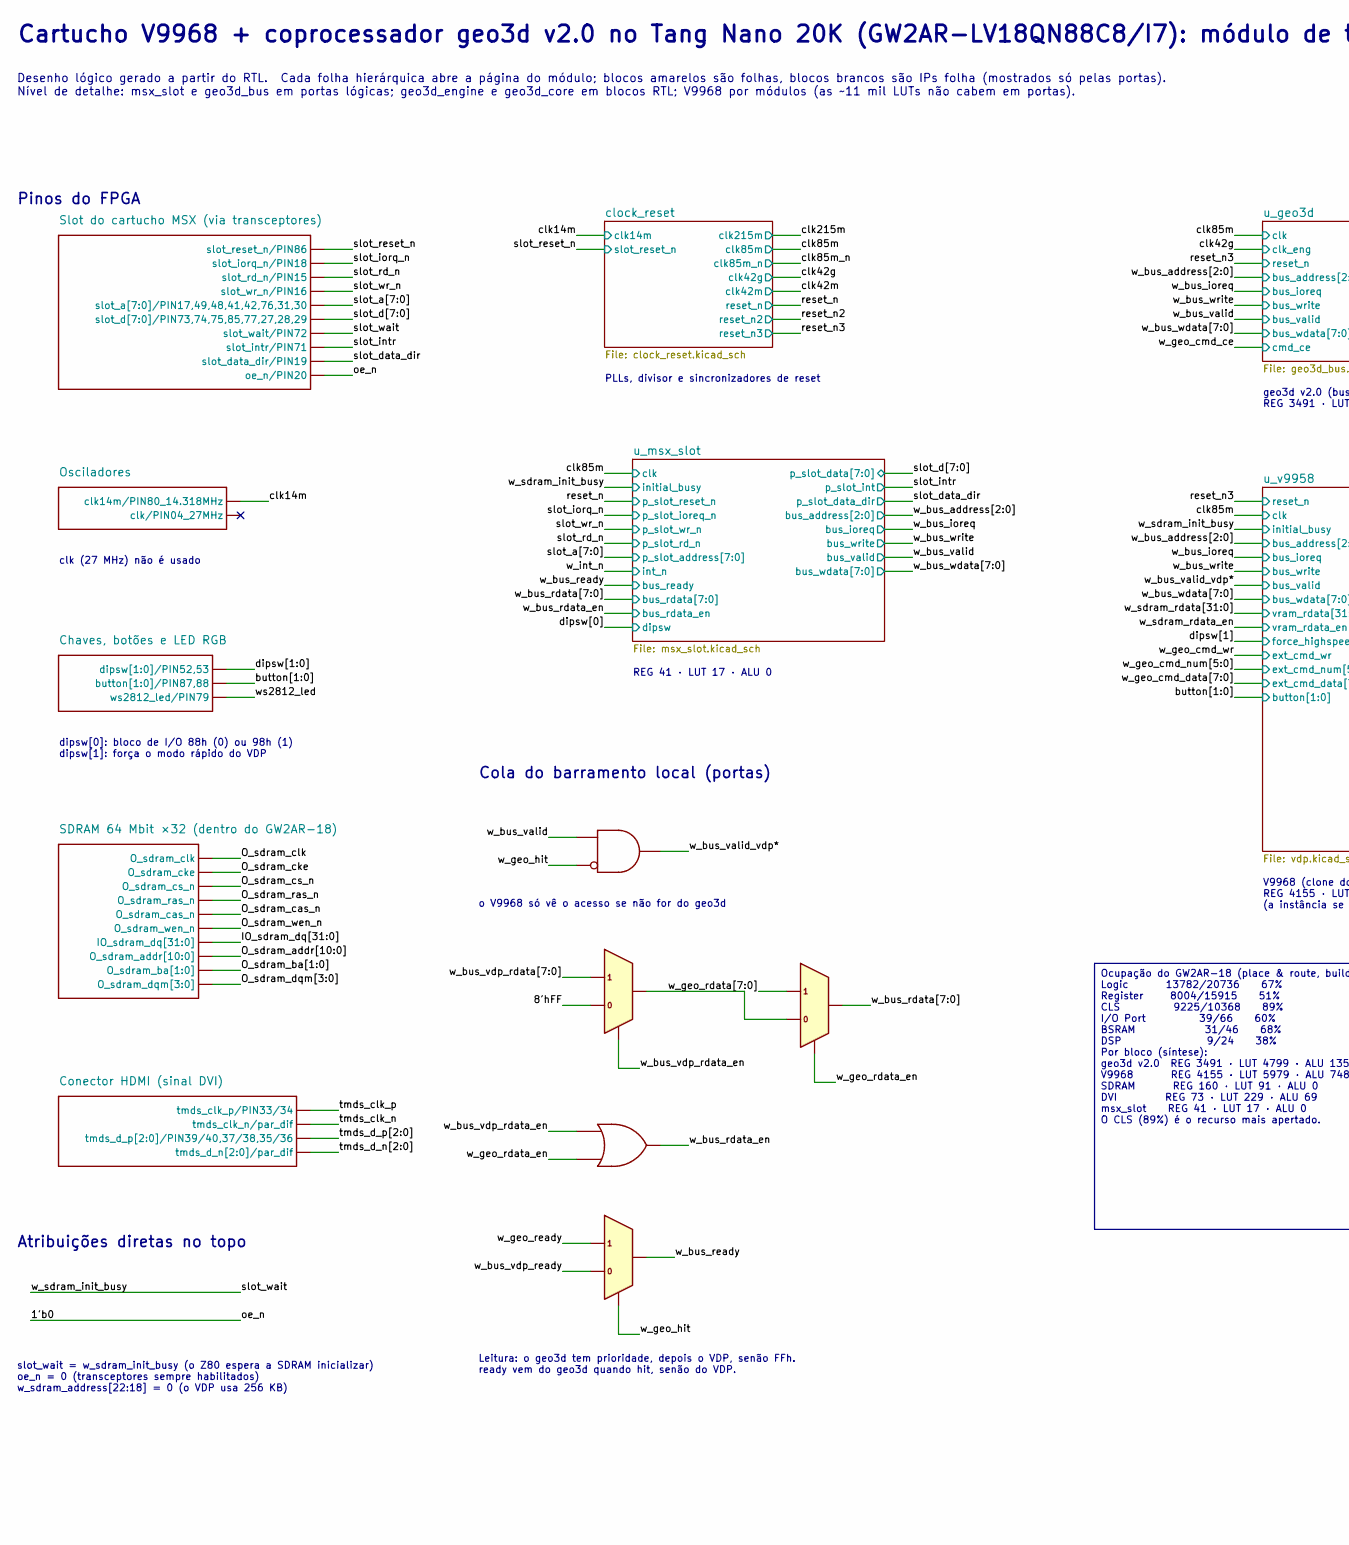
[picture p68: schematic geo3d_logic.kicad_sch, part in row 1, column 1]

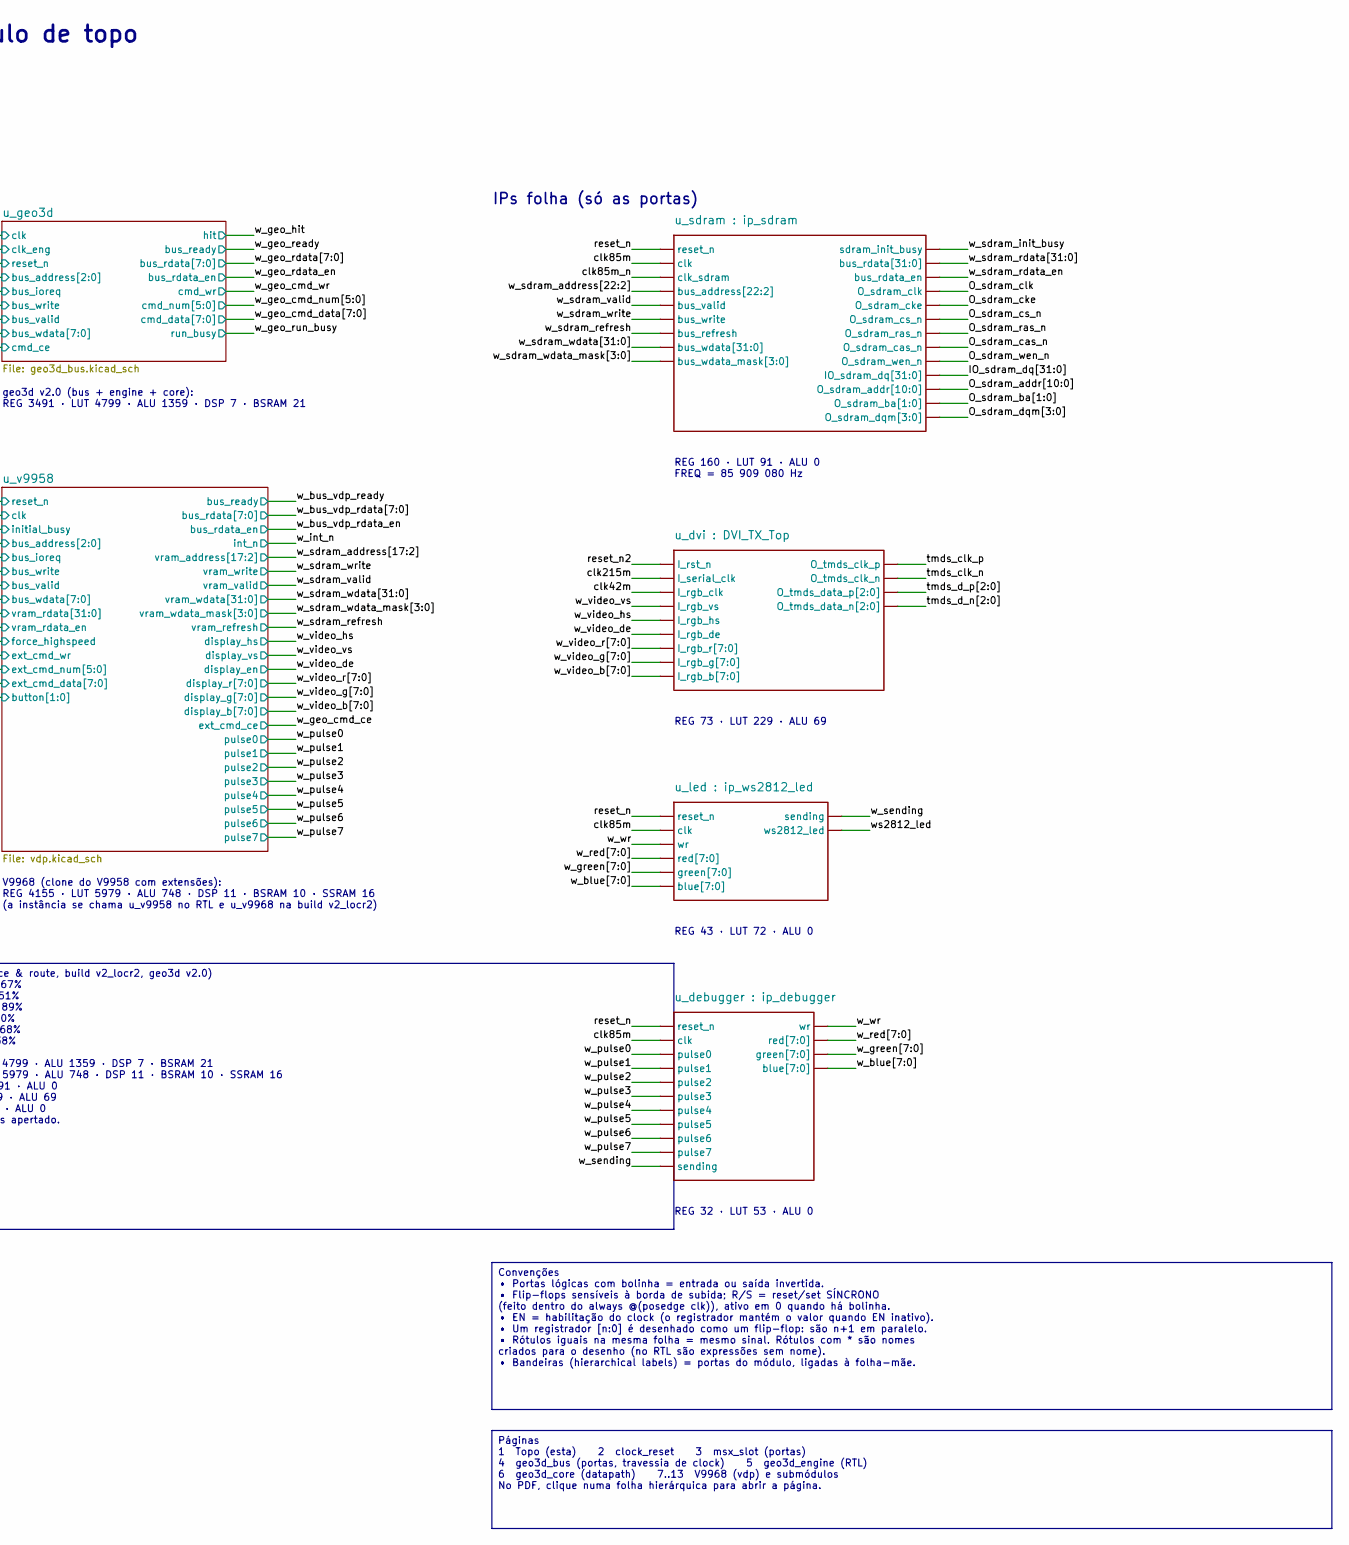
[picture p69: schematic geo3d_logic.kicad_sch, part in row 1, column 2]

Parts:
U1: Slot do cartucho MSX (via transceptores)
U2: Osciladores
U3: Chaves, botões e LED RGB
U4: SDRAM 64 Mbit ×32 (dentro do GW2AR-18)
U5: Conector HDMI (sinal DVI)
U6: AND2_N1
U7, U8, U10: MUX2
U9: OR2
U11: u_sdram : ip_sdram
U12: u_dvi : DVI_TX_Top
U13: u_led : ip_ws2812_led
U14: u_debugger : ip_debugger

Connections:
1'b0: U1.10 (oe_n/PIN20)
8'hFF: U7.2
IO_sdram_dq[31:0]: U4.7 (IO_sdram_dq[31:0]), U11.19 (IO_sdram_dq[31:0])
unnamed: U7.4, U8.2
O_sdram_addr[10:0]: U4.8 (O_sdram_addr[10:0]), U11.20 (O_sdram_addr[10:0])
O_sdram_ba[1:0]: U4.9 (O_sdram_ba[1:0]), U11.21 (O_sdram_ba[1:0])
O_sdram_cas_n: U4.5 (O_sdram_cas_n), U11.17 (O_sdram_cas_n)
O_sdram_cke: U4.2 (O_sdram_cke), U11.14 (O_sdram_cke)
O_sdram_clk: U4.1 (O_sdram_clk), U11.13 (O_sdram_clk)
O_sdram_cs_n: U4.3 (O_sdram_cs_n), U11.15 (O_sdram_cs_n)
O_sdram_dqm[3:0]: U4.10 (O_sdram_dqm[3:0]), U11.22 (O_sdram_dqm[3:0])
O_sdram_ras_n: U4.4 (O_sdram_ras_n), U11.16 (O_sdram_ras_n)
O_sdram_wen_n: U4.6 (O_sdram_wen_n), U11.18 (O_sdram_wen_n)
button[1:0]: U3.2 (button[1:0]/PIN87,88)
clk14m: U2.1 (clk14m/PIN80_14.318MHz)
clk42m: U12.3 (I_rgb_clk)
clk85m: U11.2 (clk), U13.2 (clk), U14.2 (clk)
clk85m_n: U11.3 (clk_sdram)
clk215m: U12.2 (I_serial_clk)
dipsw[1:0]: U3.1 (dipsw[1:0]/PIN52,53)
reset_n: U11.1 (reset_n), U13.1 (reset_n), U14.1 (reset_n)
reset_n2: U12.1 (I_rst_n)
slot_a[7:0]: U1.5 (slot_a[7:0]/PIN17,49,48,41,42,76,31,30)
slot_d[7:0]: U1.6 (slot_d[7:0]/PIN73,74,75,85,77,27,28,29)
slot_data_dir: U1.9 (slot_data_dir/PIN19)
slot_intr: U1.8 (slot_intr/PIN71)
slot_iorq_n: U1.2 (slot_iorq_n/PIN18)
slot_rd_n: U1.3 (slot_rd_n/PIN15)
slot_reset_n: U1.1 (slot_reset_n/PIN86)
slot_wait: U1.7 (slot_wait/PIN72), U11.10 (sdram_init_busy)
slot_wr_n: U1.4 (slot_wr_n/PIN16)
tmds_clk_n: U5.2 (tmds_clk_n/par_dif), U12.11 (O_tmds_clk_n)
tmds_clk_p: U5.1 (tmds_clk_p/PIN33/34), U12.10 (O_tmds_clk_p)
tmds_d_n[2:0]: U5.4 (tmds_d_n[2:0]/par_dif), U12.13 (O_tmds_data_n[2:0])
tmds_d_p[2:0]: U5.3 (tmds_d_p[2:0]/PIN39/40,37/38,35/36), U12.12 (O_tmds_data_p[2:0])
w_blue[7:0]: U13.6 (blue[7:0]), U14.15 (blue[7:0])
w_bus_rdata[7:0]: U8.4
w_bus_rdata_en: U9.3
w_bus_ready: U10.4
w_bus_valid: U6.1
w_bus_valid_vdp*: U6.3
w_bus_vdp_rdata[7:0]: U7.1
w_bus_vdp_rdata_en: U7.3, U9.1
w_bus_vdp_ready: U10.2
w_geo_hit: U6.2, U10.3
w_geo_rdata[7:0]: U8.1
w_geo_rdata_en: U8.3, U9.2
w_geo_ready: U10.1
w_green[7:0]: U13.5 (green[7:0]), U14.14 (green[7:0])
w_pulse0: U14.3 (pulse0)
w_pulse1: U14.4 (pulse1)
w_pulse2: U14.5 (pulse2)
w_pulse3: U14.6 (pulse3)
w_pulse4: U14.7 (pulse4)
w_pulse5: U14.8 (pulse5)
w_pulse6: U14.9 (pulse6)
w_pulse7: U14.10 (pulse7)
w_red[7:0]: U13.4 (red[7:0]), U14.13 (red[7:0])
w_sdram_address[22:2]: U11.4 (bus_address[22:2])
w_sdram_rdata[31:0]: U11.11 (bus_rdata[31:0])
w_sdram_rdata_en: U11.12 (bus_rdata_en)
w_sdram_refresh: U11.7 (bus_refresh)
w_sdram_valid: U11.5 (bus_valid)
w_sdram_wdata[31:0]: U11.8 (bus_wdata[31:0])
w_sdram_wdata_mask[3:0]: U11.9 (bus_wdata_mask[3:0])
w_sdram_write: U11.6 (bus_write)
w_sending: U13.7 (sending), U14.11 (sending)
w_video_b[7:0]: U12.9 (I_rgb_b[7:0])
w_video_de: U12.6 (I_rgb_de)
w_video_g[7:0]: U12.8 (I_rgb_g[7:0])
w_video_hs: U12.5 (I_rgb_hs)
w_video_r[7:0]: U12.7 (I_rgb_r[7:0])
w_video_vs: U12.4 (I_rgb_vs)
w_wr: U13.3 (wr), U14.12 (wr)
ws2812_led: U3.3 (ws2812_led/PIN79), U13.8 (ws2812_led)

Notes on the sheet:
Cartucho V9968 + coprocessador geo3d v2.0 no Tang Nano 20K (GW2AR-LV18QN88C8/I7): módulo de topo
Desenho lógico gerado a partir do RTL. Cada folha hierárquica abre a página do módulo; blocos amarelos são folhas, blocos brancos são IPs folha (mostrados só pelas portas). Nível de detalhe: msx_slot e geo3d_bus em portas lógicas; geo3d_engine e geo3d_core em blocos RTL; V9968 por módulos (as ~11 m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
Pinos do FPGA
clk (27 MHz) não é usado
dipsw[0]: bloco de I/O 88h (0) ou 98h (1) dipsw[1]: força o modo rápido do VDP
Atribuições diretas no topo
slot_wait = w_sdram_init_busy (o Z80 espera a SDRAM inicializar) oe_n = 0 (transceptores sempre habilitados) w_sdram_address[22:18] = 0 (o VDP usa 256 KB)
PLLs, divisor e sincronizadores de reset
REG 41 · LUT 17 · ALU 0
Cola do barramento local (portas)
o V9968 só vê o acesso se não for do geo3d
Leitura: o geo3d tem prioridade, depois o VDP, senão FFh. ready vem do geo3d quando hit, senão do VDP.
geo3d v2.0 (bus + engine + core): REG 3491 · LUT 4799 · ALU 1359 · DSP 7 · BSRAM 21
V9968 (clone do V9958 com extensões): REG 4155 · LUT 5979 · ALU 748 · DSP 11 · BSRAM 10 · SSRAM 16 (a instância se chama u_v9958 no RTL e u_v9968 na build v2_locr2)
Ocupação do GW2AR-18 (place & route, build v2_locr2, geo3d v2.0) Logic 13782/20736 67% Register 8004/15915 51% CLS 9225/10368 89% I/O Port 39/66 60% BSRAM 31/46 68% DSP 9/24 38% Por bloco (síntese): geo3d v2.0 REG 3491 · LUT 4799 · ALU 1359 · DSP 7 · BSRAM 21 V9968 REG 4155 · LUT 5979 · ALU 748 · D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
IPs folha (só as portas)
REG 160 · LUT 91 · ALU 0 FREQ = 85 909 080 Hz
REG 73 · LUT 229 · ALU 69
REG 43 · LUT 72 · ALU 0
REG 32 · LUT 53 · ALU 0
Convenções • Portas lógicas com bolinha = entrada ou saída invertida. • Flip-flops sensíveis à borda de subida; R/S = reset/set SÍNCRONO (feito dentro do always @(posedge clk)), ativo em 0 quando há bolinha. • EN = habilitação do clock (o registrador mantém o valor quando EN inativo). • Um registra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
Páginas 1 Topo (esta) 2 clock_reset 3 msx_slot (portas) 4 geo3d_bus (portas, travessia de clock) 5 geo3d_engine (RTL) 6 geo3d_core (datapath) 7..13 V9968 (vdp) e submódulos No PDF, clique numa folha hierárquica para abrir a página.
