alexmoncks/V9968_Cartridge/geo3d/docs/kicad/msx_slot.kicad_sch

## KiCad design geo3d/docs/kicad/msx_slot.kicad_sch (2026-10-27)

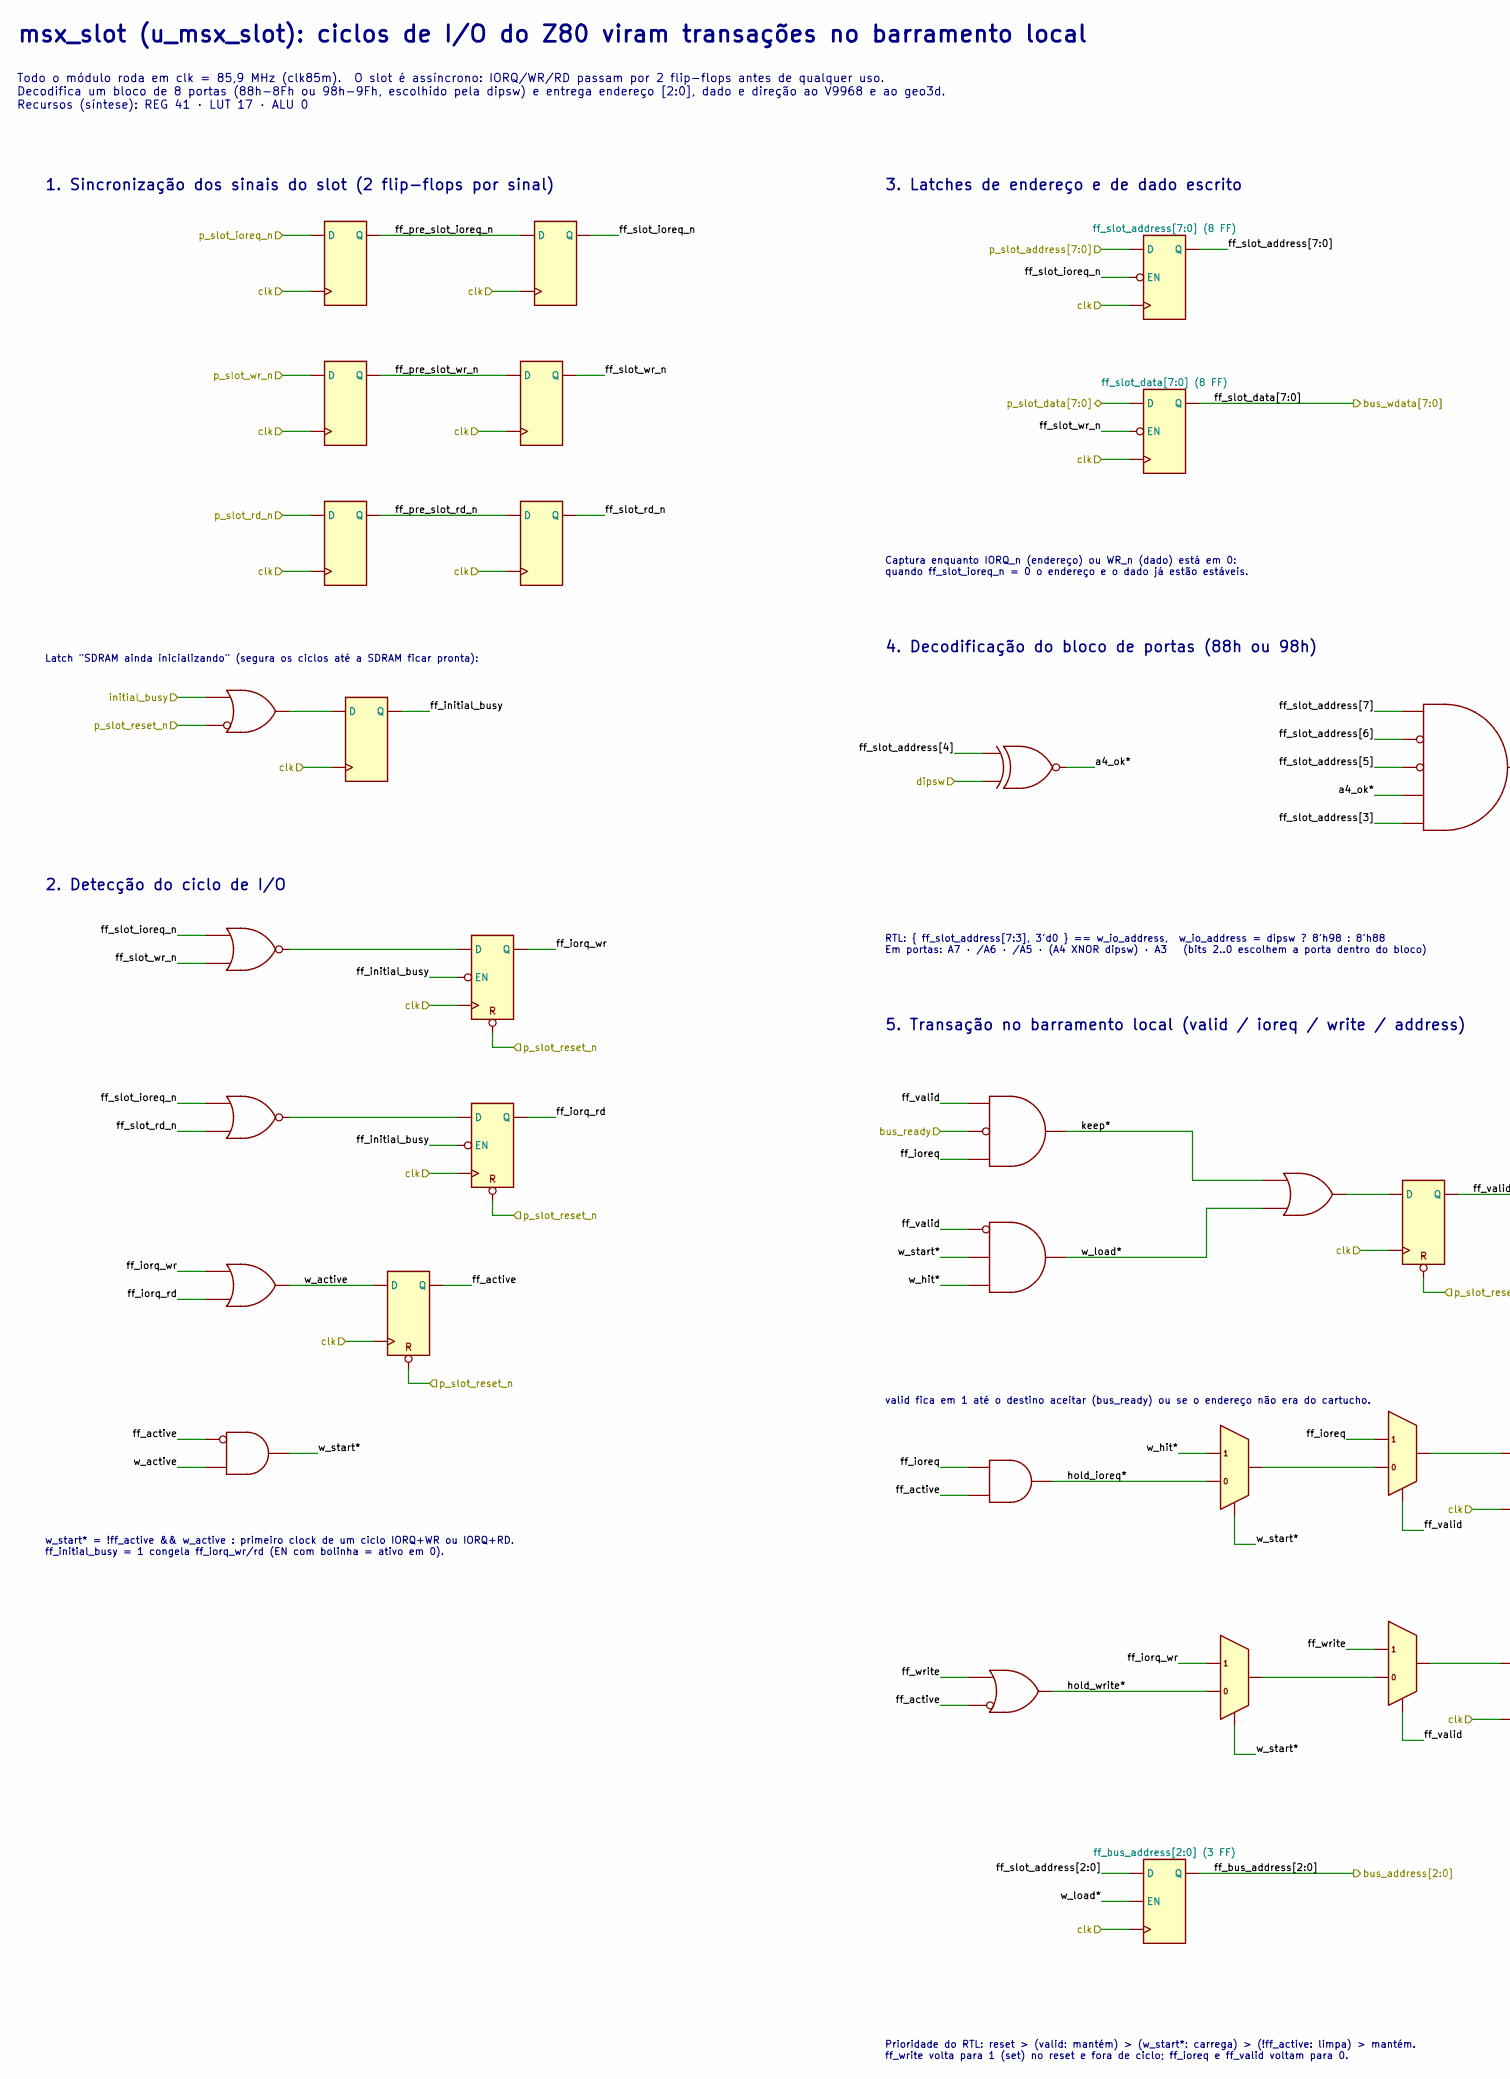
[picture p70: schematic msx_slot.kicad_sch, part in row 1, column 1]

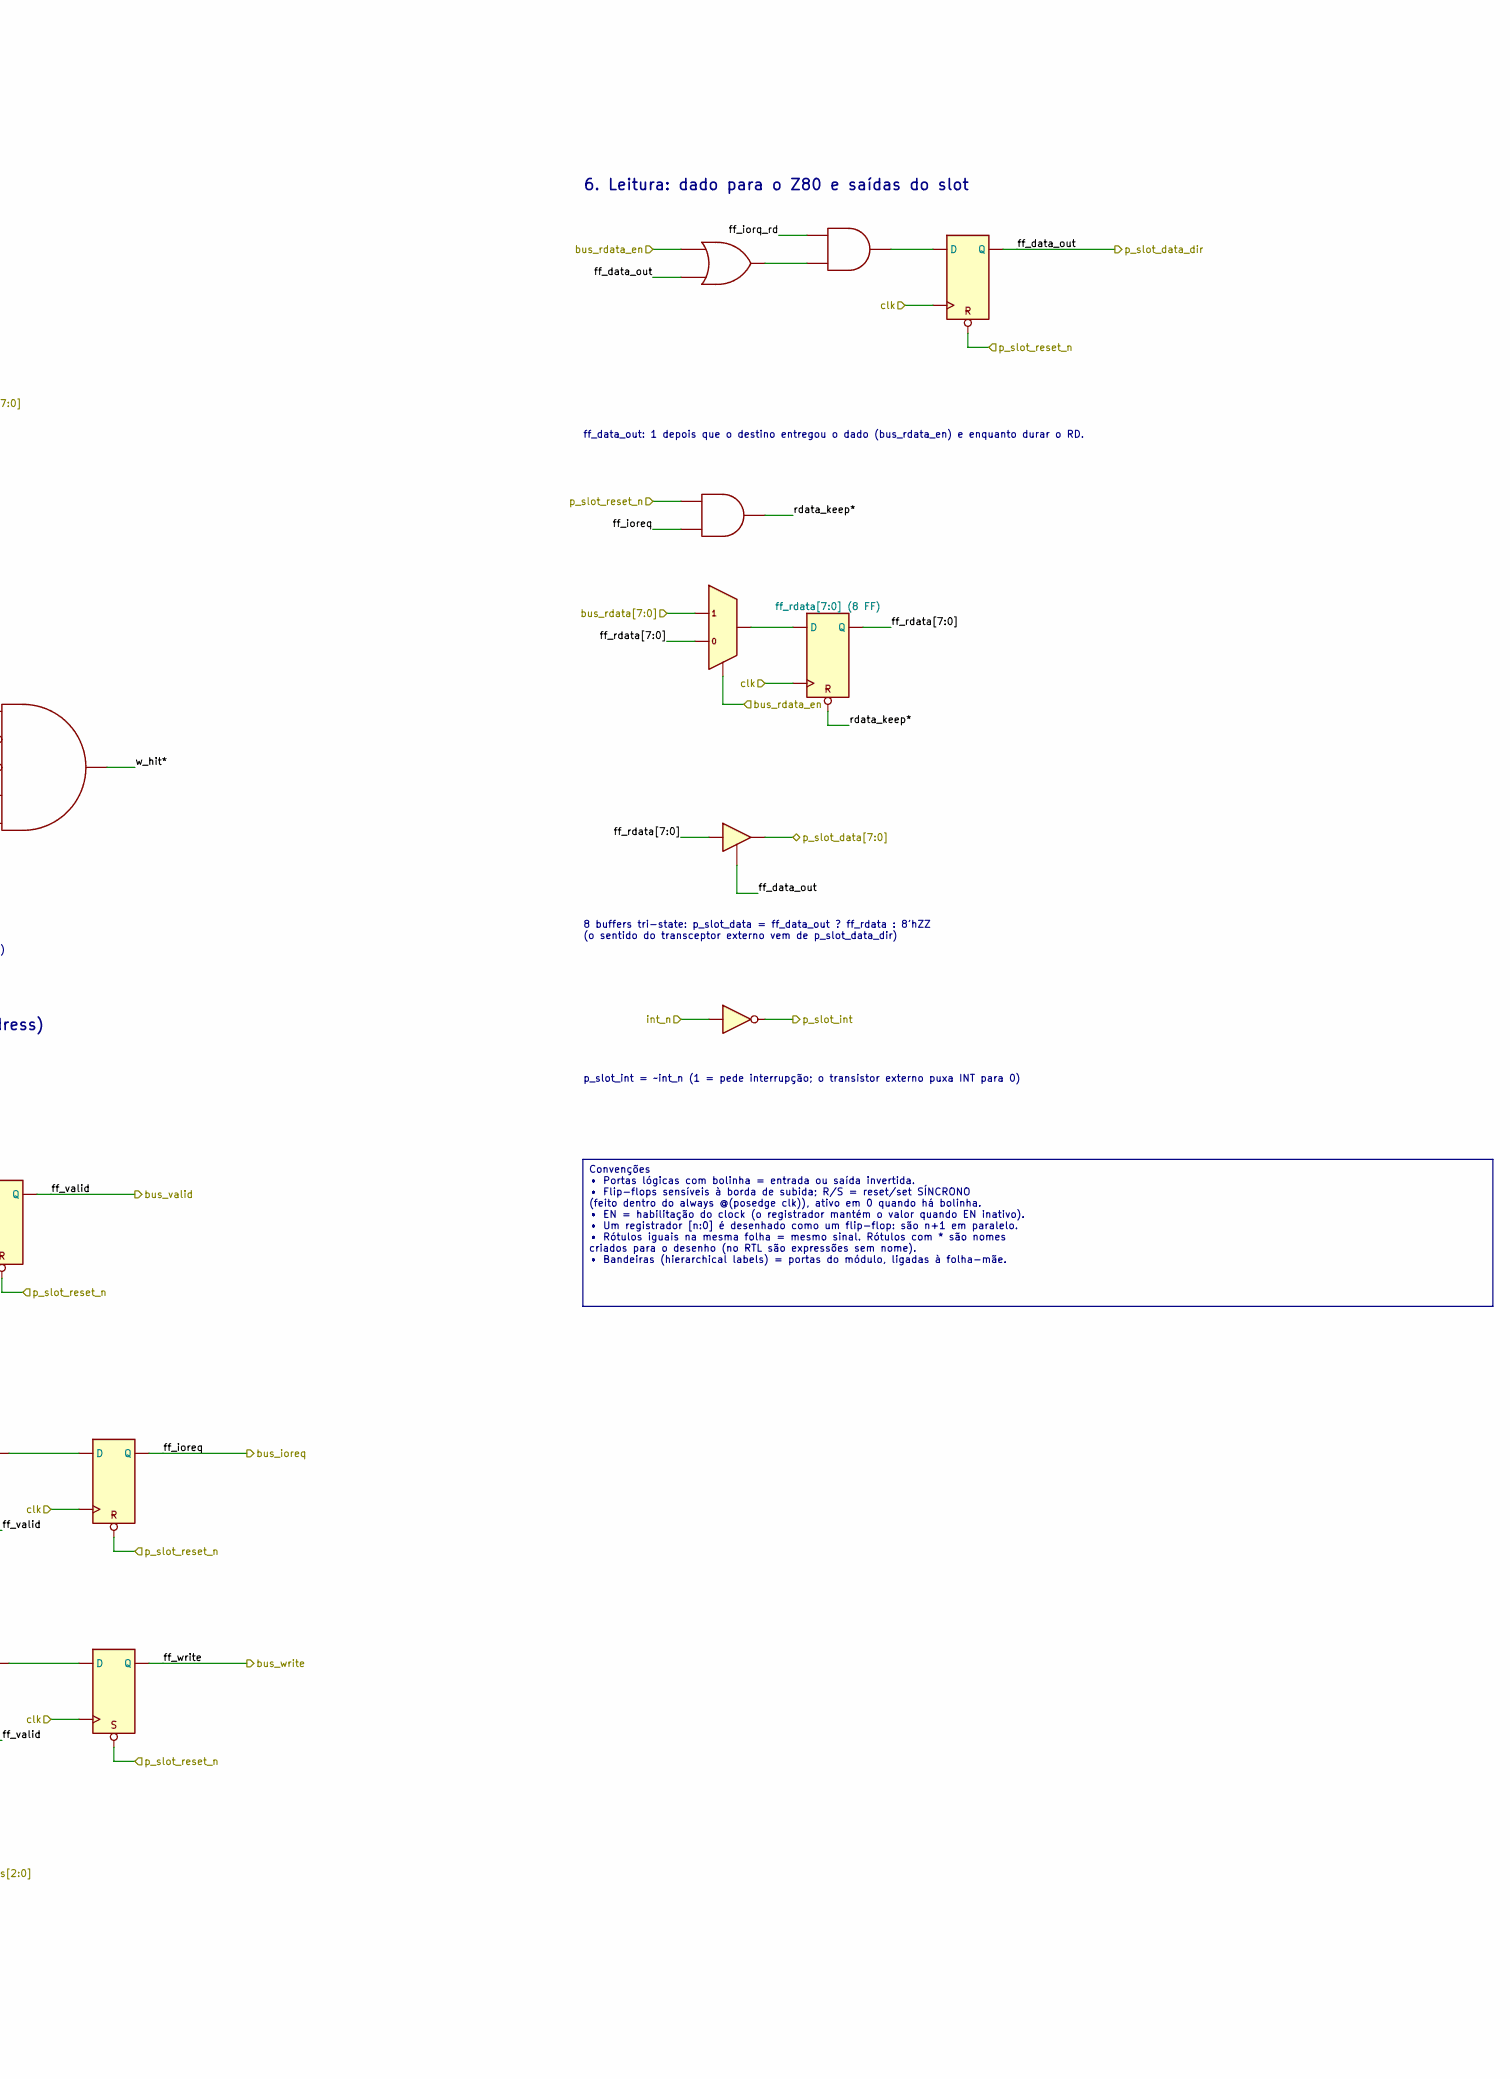
[picture p71: schematic msx_slot.kicad_sch, part in row 1, column 2]

Parts:
U27, U28, U29, U30, U31, U32, U34: DFF
U33, U54: OR2_N1
U35, U37: OR2_INV
U36, U38: DFFENR
U39, U48, U59: OR2
U40, U49, U53, U61: DFFR
U41: AND2_N0
U42: ff_slot_address[7:0] (8 FF)
U43: ff_slot_data[7:0] (8 FF)
U44: XOR2_INV
U45: AND5_N1_N2
U46: AND3_N1
U47: AND3_N0
U50, U60, U62: AND2
U51, U52, U55, U56, U63: MUX2
U57: DFFS
U58: ff_bus_address[2:0] (3 FF)
U64: ff_rdata[7:0] (8 FF)
U65: TRIBUF
U66: NOT

Connections:
unnamed: U33.3, U34.1 (D)
unnamed: U35.3, U36.1 (D)
unnamed: U37.3, U38.1 (D)
unnamed: U48.3, U49.1 (D)
unnamed: U51.4, U52.2
unnamed: U52.4, U53.1 (D)
unnamed: U55.4, U56.2
unnamed: U56.4, U57.1 (D)
unnamed: U59.3, U60.2
unnamed: U60.3, U61.1 (D)
unnamed: U63.4, U64.1 (D)
a4_ok*: U44.3, U45.4
bus_address[2:0]: U58.4 (Q)
bus_ioreq: U46.3, U50.1, U52.1, U53.3 (Q), U62.2
bus_rdata[7:0]: U63.1
bus_rdata_en: U59.1, U63.3
bus_ready: U46.2
bus_valid: U46.1, U47.1, U49.3 (Q), U52.3, U56.3
bus_wdata[7:0]: U43.4 (Q)
bus_write: U54.1, U56.1, U57.3 (Q)
clk: U27.2, U28.2, U29.2, U30.2, U31.2, U32.2, U34.2, U36.3, U38.3, U40.2, U42.3, U43.3, U49.2, U53.2, U57.2, U58.3, U61.2, U64.2
dipsw: U44.2
ff_active: U40.3 (Q), U41.1, U50.2, U54.2
ff_data_out: U59.2, U61.3 (Q), U65.2
ff_initial_busy: U34.3 (Q), U36.2 (EN), U38.2 (EN)
ff_iorq_rd: U38.4 (Q), U39.2, U60.1
ff_iorq_wr: U36.4 (Q), U39.1, U55.1
ff_pre_slot_ioreq_n: U27.3 (Q), U28.1 (D)
ff_pre_slot_rd_n: U31.3 (Q), U32.1 (D)
ff_pre_slot_wr_n: U29.3 (Q), U30.1 (D)
ff_rdata[7:0]: U63.2, U64.3 (Q), U65.1
ff_slot_address[2:0]: U58.1 (D)
ff_slot_address[3]: U45.5
ff_slot_address[4]: U44.1
ff_slot_address[5]: U45.3
ff_slot_address[6]: U45.2
ff_slot_address[7:0]: U42.4 (Q)
ff_slot_address[7]: U45.1
ff_slot_ioreq_n: U28.3 (Q), U35.1, U37.1, U42.2 (EN)
ff_slot_rd_n: U32.3 (Q), U37.2
ff_slot_wr_n: U30.3 (Q), U35.2, U43.2 (EN)
hold_ioreq*: U50.3, U51.2
hold_write*: U54.3, U55.2
initial_busy: U33.1
int_n: U66.1
keep*: U46.4, U48.1
p_slot_address[7:0]: U42.1 (D)
p_slot_data[7:0]: U43.1 (D), U65.3
p_slot_int: U66.2
p_slot_ioreq_n: U27.1 (D)
p_slot_rd_n: U31.1 (D)
p_slot_reset_n: U33.2, U36.5, U38.5, U40.4, U49.4, U53.4, U57.4, U61.4, U62.1
p_slot_wr_n: U29.1 (D)
rdata_keep*: U62.3, U64.4
w_active: U39.3, U40.1 (D), U41.2
w_hit*: U45.6, U47.3, U51.1
w_load*: U47.4, U48.2, U58.2 (EN)
w_start*: U41.3, U47.2, U51.3, U55.3

Notes on the sheet:
msx_slot (u_msx_slot): ciclos de I/O do Z80 viram transações no barramento local
Todo o módulo roda em clk = 85,9 MHz (clk85m). O slot é assíncrono: IORQ/WR/RD passam por 2 flip-flops antes de qualquer uso. Decodifica um bloco de 8 portas (88h-8Fh ou 98h-9Fh, escolhido pela dipsw) e entrega endereço [2:0], dado e direção ao V9968 e ao geo3d. Recursos (síntese): REG 41 · LUT 17 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
1. Sincronização dos sinais do slot (2 flip-flops por sinal)
Latch "SDRAM ainda inicializando" (segura os ciclos até a SDRAM ficar pronta):
2. Detecção do ciclo de I/O
w_start* = !ff_active && w_active : primeiro clock de um ciclo IORQ+WR ou IORQ+RD. ff_initial_busy = 1 congela ff_iorq_wr/rd (EN com bolinha = ativo em 0).
3. Latches de endereço e de dado escrito
Captura enquanto IORQ_n (endereço) ou WR_n (dado) está em 0: quando ff_slot_ioreq_n = 0 o endereço e o dado já estão estáveis.
4. Decodificação do bloco de portas (88h ou 98h)
RTL: { ff_slot_address[7:3], 3'd0 } == w_io_address, w_io_address = dipsw ? 8'h98 : 8'h88 Em portas: A7 · /A6 · /A5 · (A4 XNOR dipsw) · A3 (bits 2..0 escolhem a porta dentro do bloco)
5. Transação no barramento local (valid / ioreq / write / address)
valid fica em 1 até o destino aceitar (bus_ready) ou se o endereço não era do cartucho.
Prioridade do RTL: reset > (valid: mantém) > (w_start*: carrega) > (!ff_active: limpa) > mantém. ff_write volta para 1 (set) no reset e fora de ciclo; ff_ioreq e ff_valid voltam para 0.
6. Leitura: dado para o Z80 e saídas do slot
ff_data_out: 1 depois que o destino entregou o dado (bus_rdata_en) e enquanto durar o RD.
8 buffers tri-state: p_slot_data = ff_data_out ? ff_rdata : 8'hZZ (o sentido do transceptor externo vem de p_slot_data_dir)
p_slot_int = ~int_n (1 = pede interrupção; o transistor externo puxa INT para 0)
Convenções • Portas lógicas com bolinha = entrada ou saída invertida. • Flip-flops sensíveis à borda de subida; R/S = reset/set SÍNCRONO (feito dentro do always @(posedge clk)), ativo em 0 quando há bolinha. • EN = habilitação do clock (o registrador mantém o valor quando EN inativo). • Um registra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
