alexmoncks/V9968_Cartridge/geo3d/docs/kicad/vdp.kicad_sch

## KiCad design geo3d/docs/kicad/vdp.kicad_sch (2026-10-27)

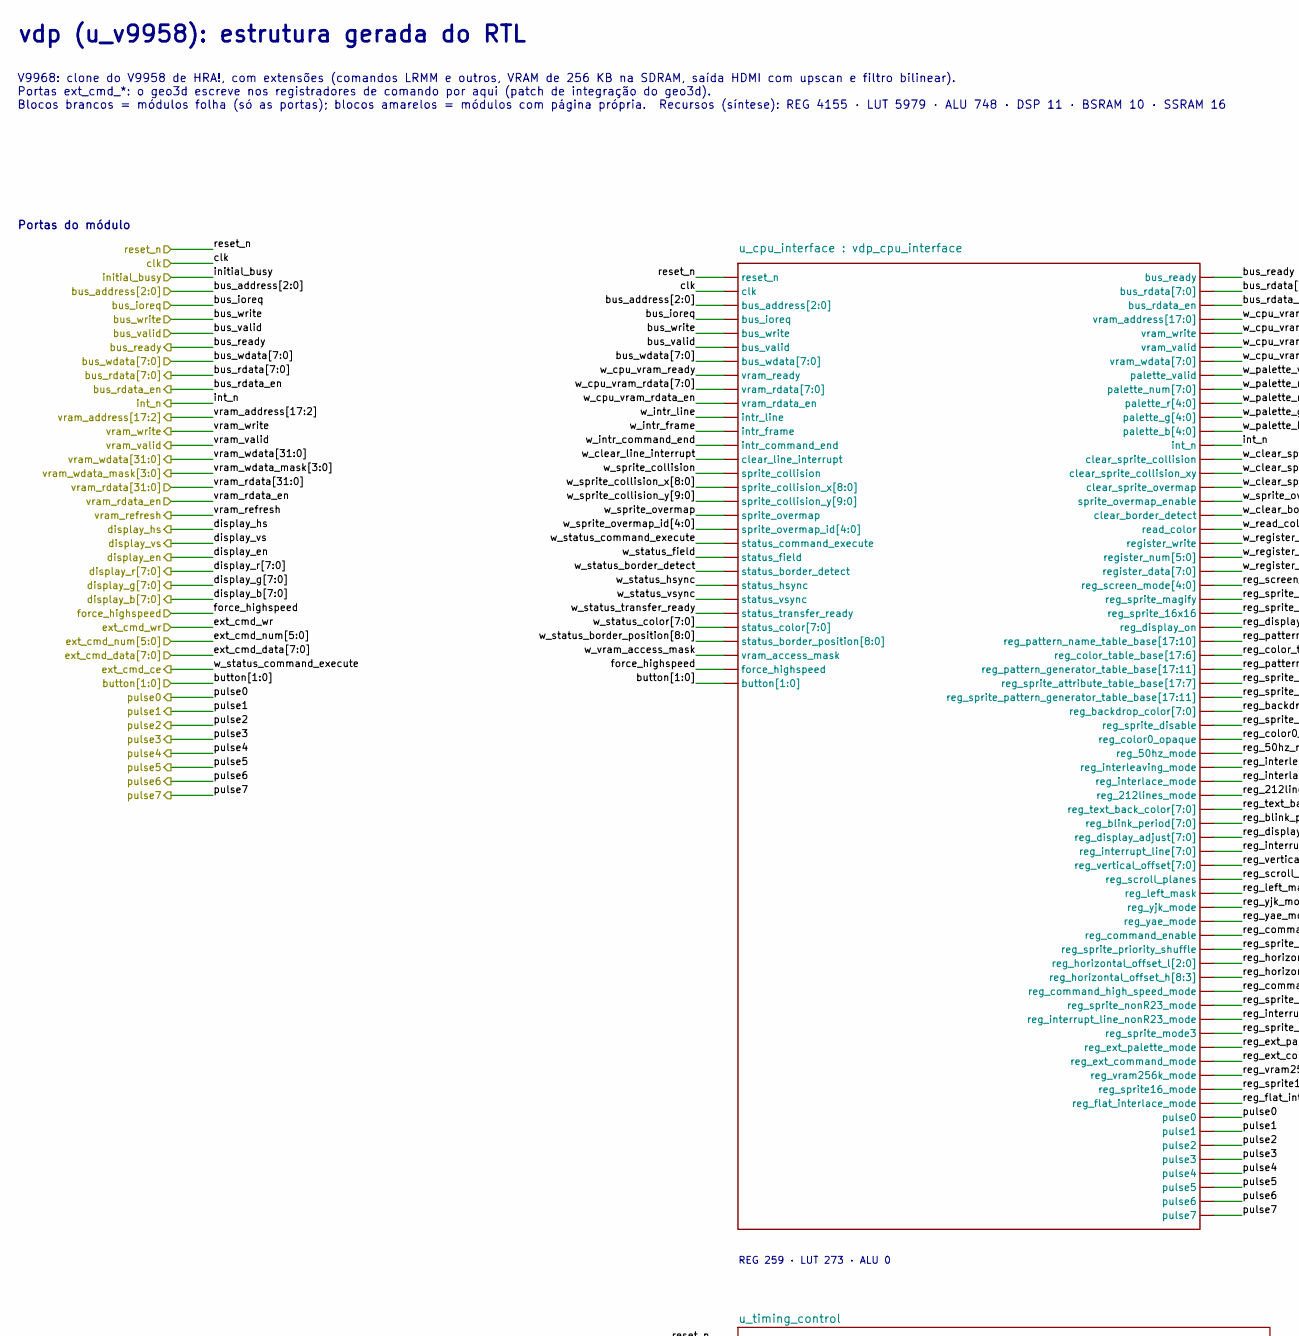
[picture p72: schematic vdp.kicad_sch, part in row 1, column 1]

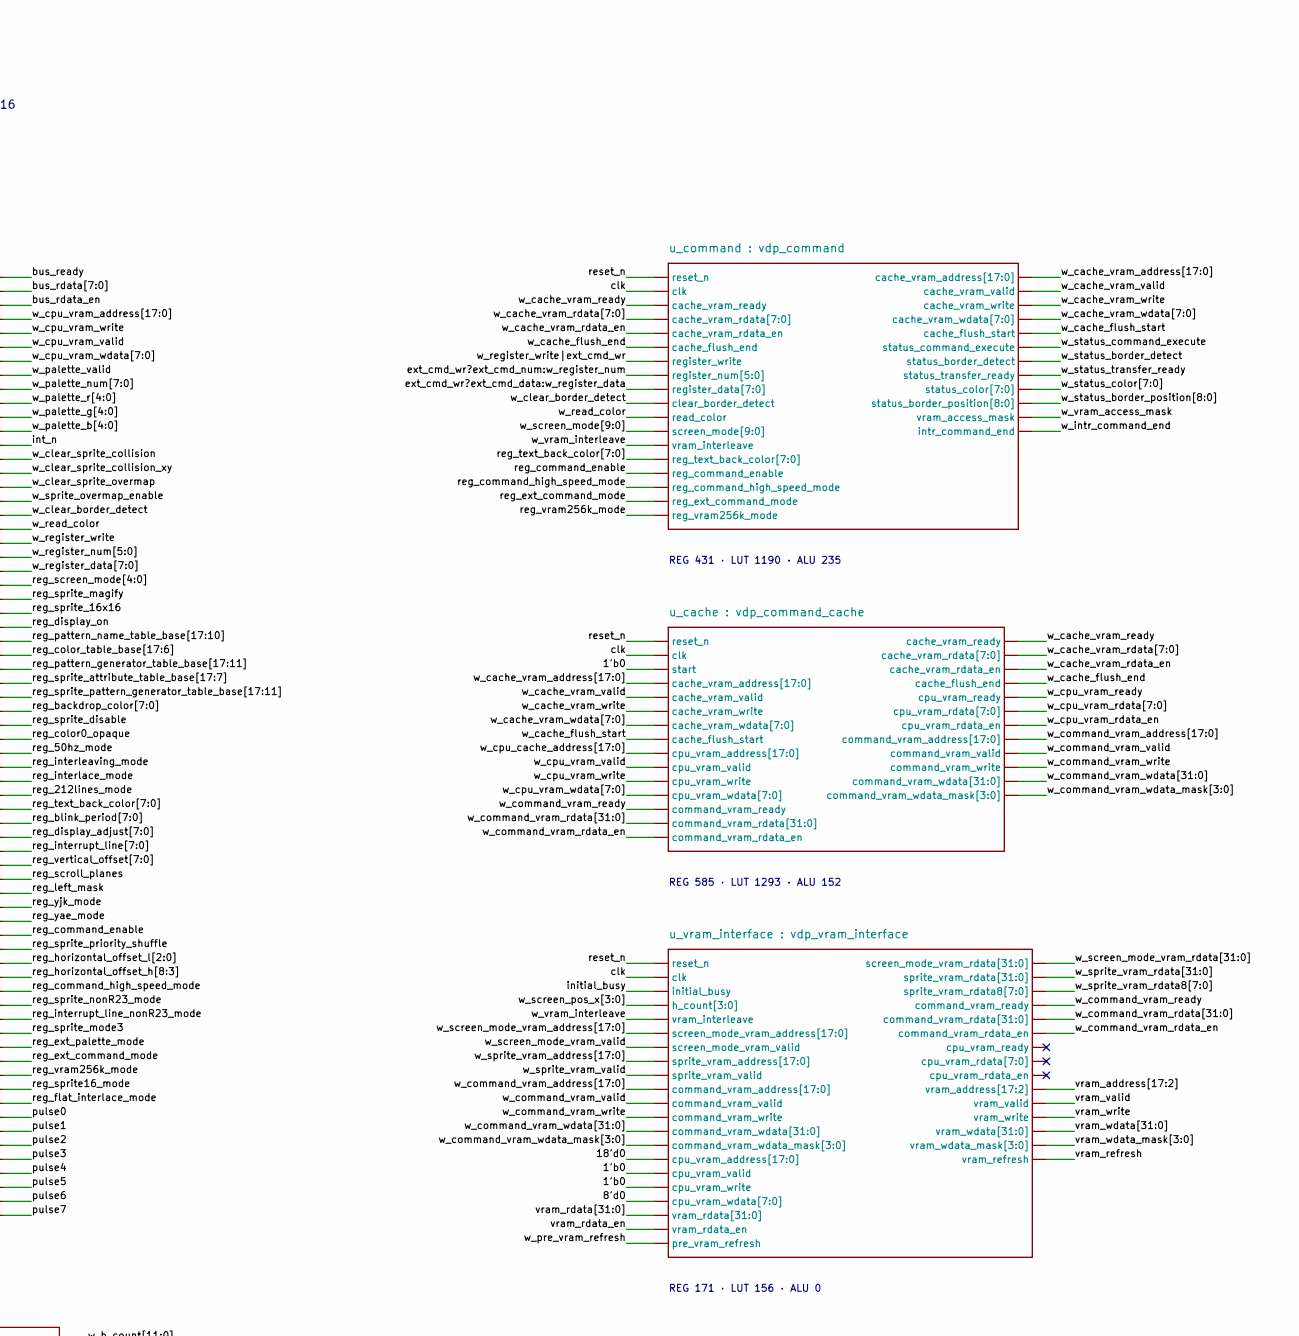
[picture p73: schematic vdp.kicad_sch, part in row 1, column 2]

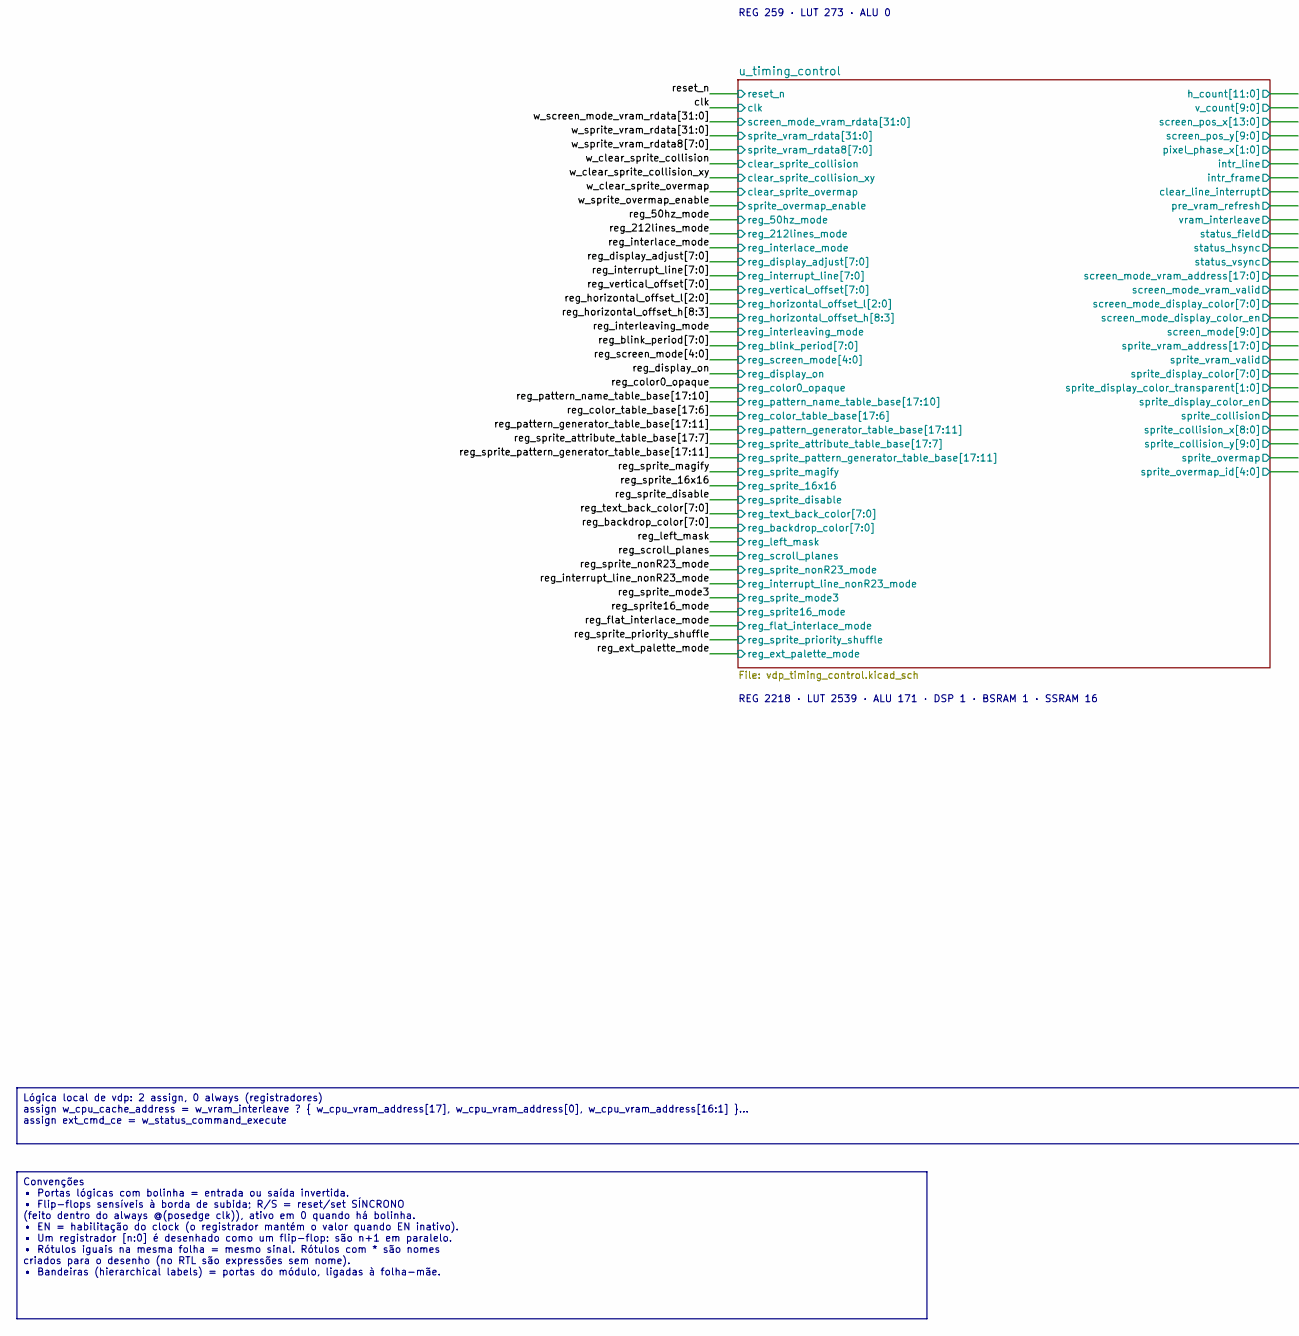
[picture p74: schematic vdp.kicad_sch, part in row 2, column 1]

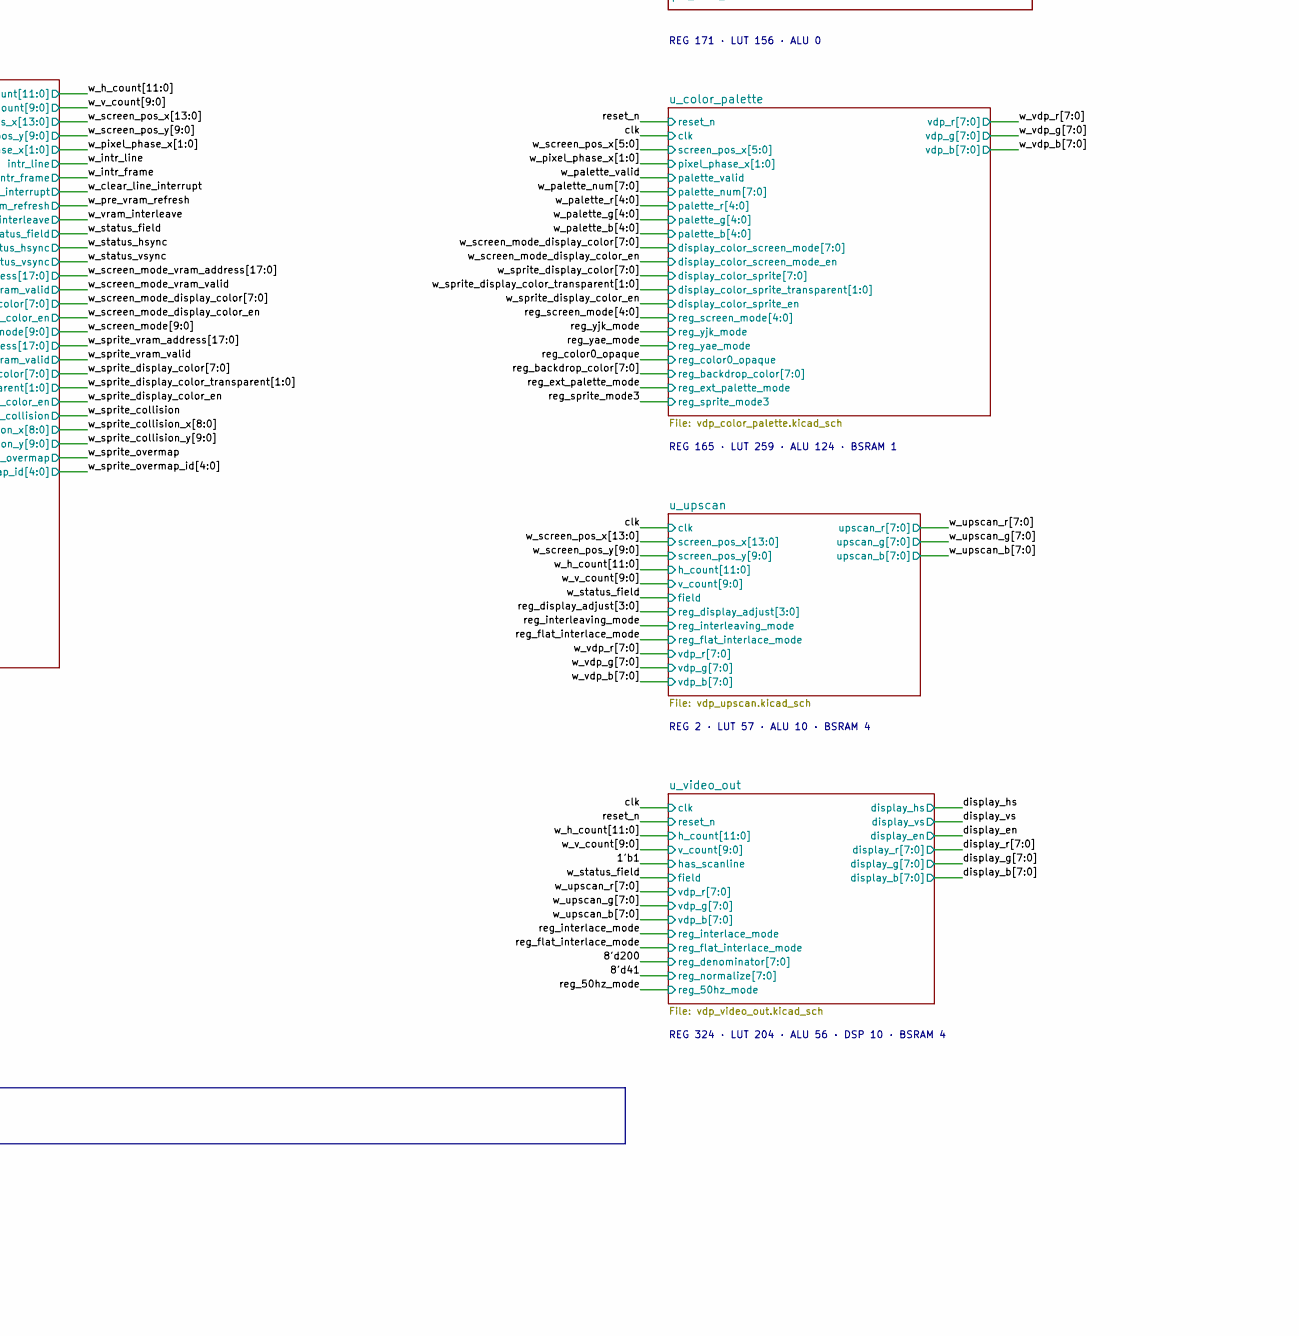
[picture p75: schematic vdp.kicad_sch, part in row 2, column 2]

Parts:
U162: u_cpu_interface : vdp_cpu_interface
U163: u_command : vdp_command
U164: u_cache : vdp_command_cache
U165: u_vram_interface : vdp_vram_interface

Connections:
1'b0: U164.3 (start), U165.16 (cpu_vram_valid), U165.17 (cpu_vram_write)
8'd0: U165.18 (cpu_vram_wdata[7:0])
18'd0: U165.15 (cpu_vram_address[17:0])
bus_address[2:0]: U162.3 (bus_address[2:0])
bus_ioreq: U162.4 (bus_ioreq)
bus_rdata[7:0]: U162.32 (bus_rdata[7:0])
bus_rdata_en: U162.33 (bus_rdata_en)
bus_ready: U162.31 (bus_ready)
bus_valid: U162.6 (bus_valid)
bus_wdata[7:0]: U162.7 (bus_wdata[7:0])
bus_write: U162.5 (bus_write)
button[1:0]: U162.30 (button[1:0])
clk: U162.2 (clk), U163.2 (clk), U164.2 (clk), U165.2 (clk)
ext_cmd_ce: U162.20 (status_command_execute), U163.24 (status_command_execute)
ext_cmd_wr?ext_cmd_data:w_register_data: U163.9 (register_data[7:0])
ext_cmd_wr?ext_cmd_num:w_register_num: U163.8 (register_num[5:0])
force_highspeed: U162.29 (force_highspeed)
initial_busy: U165.3 (initial_busy)
int_n: U162.43 (int_n)
pulse0: U162.91 (pulse0)
pulse1: U162.92 (pulse1)
pulse2: U162.93 (pulse2)
pulse3: U162.94 (pulse3)
pulse4: U162.95 (pulse4)
pulse5: U162.96 (pulse5)
pulse6: U162.97 (pulse6)
pulse7: U162.98 (pulse7)
reg_50hz_mode: U162.65 (reg_50hz_mode)
reg_212lines_mode: U162.68 (reg_212lines_mode)
reg_backdrop_color[7:0]: U162.62 (reg_backdrop_color[7:0])
reg_blink_period[7:0]: U162.70 (reg_blink_period[7:0])
reg_color0_opaque: U162.64 (reg_color0_opaque)
reg_color_table_base[17:6]: U162.58 (reg_color_table_base[17:6])
reg_command_enable: U162.78 (reg_command_enable), U163.15 (reg_command_enable)
reg_command_high_speed_mode: U162.82 (reg_command_high_speed_mode), U163.16 (reg_command_high_speed_mode)
reg_display_adjust[7:0]: U162.71 (reg_display_adjust[7:0])
reg_display_on: U162.56 (reg_display_on)
reg_ext_command_mode: U162.87 (reg_ext_command_mode), U163.17 (reg_ext_command_mode)
reg_ext_palette_mode: U162.86 (reg_ext_palette_mode)
reg_flat_interlace_mode: U162.90 (reg_flat_interlace_mode)
reg_horizontal_offset_h[8:3]: U162.81 (reg_horizontal_offset_h[8:3])
reg_horizontal_offset_l[2:0]: U162.80 (reg_horizontal_offset_l[2:0])
reg_interlace_mode: U162.67 (reg_interlace_mode)
reg_interleaving_mode: U162.66 (reg_interleaving_mode)
reg_interrupt_line[7:0]: U162.72 (reg_interrupt_line[7:0])
reg_interrupt_line_nonR23_mode: U162.84 (reg_interrupt_line_nonR23_mode)
reg_left_mask: U162.75 (reg_left_mask)
reg_pattern_generator_table_base[17:11]: U162.59 (reg_pattern_generator_table_base[17:11])
reg_pattern_name_table_base[17:10]: U162.57 (reg_pattern_name_table_base[17:10])
reg_screen_mode[4:0]: U162.53 (reg_screen_mode[4:0])
reg_scroll_planes: U162.74 (reg_scroll_planes)
reg_sprite16_mode: U162.89 (reg_sprite16_mode)
reg_sprite_16x16: U162.55 (reg_sprite_16x16)
reg_sprite_attribute_table_base[17:7]: U162.60 (reg_sprite_attribute_table_base[17:7])
reg_sprite_disable: U162.63 (reg_sprite_disable)
reg_sprite_magify: U162.54 (reg_sprite_magify)
reg_sprite_mode3: U162.85 (reg_sprite_mode3)
reg_sprite_nonR23_mode: U162.83 (reg_sprite_nonR23_mode)
reg_sprite_pattern_generator_table_base[17:11]: U162.61 (reg_sprite_pattern_generator_table_base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)
reg_sprite_priority_shuffle: U162.79 (reg_sprite_priority_shuffle)
reg_text_back_color[7:0]: U162.69 (reg_text_back_color[7:0]), U163.14 (reg_text_back_color[7:0])
reg_vertical_offset[7:0]: U162.73 (reg_vertical_offset[7:0])
reg_vram256k_mode: U162.88 (reg_vram256k_mode), U163.18 (reg_vram256k_mode)
reg_yae_mode: U162.77 (reg_yae_mode)
reg_yjk_mode: U162.76 (reg_yjk_mode)
reset_n: U162.1 (reset_n), U163.1 (reset_n), U164.1 (reset_n), U165.1 (reset_n)
vram_address[17:2]: U165.31 (vram_address[17:2])
vram_rdata[31:0]: U165.19 (vram_rdata[31:0])
vram_rdata_en: U165.20 (vram_rdata_en)
vram_refresh: U165.36 (vram_refresh)
vram_valid: U165.32 (vram_valid)
vram_wdata[31:0]: U165.34 (vram_wdata[31:0])
vram_wdata_mask[3:0]: U165.35 (vram_wdata_mask[3:0])
vram_write: U165.33 (vram_write)
w_cache_flush_end: U163.6 (cache_flush_end), U164.19 (cache_flush_end)
w_cache_flush_start: U163.23 (cache_flush_start), U164.8 (cache_flush_start)
w_cache_vram_address[17:0]: U163.19 (cache_vram_address[17:0]), U164.4 (cache_vram_address[17:0])
w_cache_vram_rdata[7:0]: U163.4 (cache_vram_rdata[7:0]), U164.17 (cache_vram_rdata[7:0])
w_cache_vram_rdata_en: U163.5 (cache_vram_rdata_en), U164.18 (cache_vram_rdata_en)
w_cache_vram_ready: U163.3 (cache_vram_ready), U164.16 (cache_vram_ready)
w_cache_vram_valid: U163.20 (cache_vram_valid), U164.5 (cache_vram_valid)
w_cache_vram_wdata[7:0]: U163.22 (cache_vram_wdata[7:0]), U164.7 (cache_vram_wdata[7:0])
w_cache_vram_write: U163.21 (cache_vram_write), U164.6 (cache_vram_write)
w_clear_border_detect: U162.48 (clear_border_detect), U163.10 (clear_border_detect)
w_clear_line_interrupt: U162.14 (clear_line_interrupt)
w_clear_sprite_collision: U162.44 (clear_sprite_collision)
w_clear_sprite_collision_xy: U162.45 (clear_sprite_collision_xy)
w_clear_sprite_overmap: U162.46 (clear_sprite_overmap)
w_command_vram_address[17:0]: U164.23 (command_vram_address[17:0]), U165.10 (command_vram_address[17:0])
w_command_vram_rdata[31:0]: U164.14 (command_vram_rdata[31:0]), U165.26 (command_vram_rdata[31:0])
w_command_vram_rdata_en: U164.15 (command_vram_rdata_en), U165.27 (command_vram_rdata_en)
w_command_vram_ready: U164.13 (command_vram_ready), U165.25 (command_vram_ready)
w_command_vram_valid: U164.24 (command_vram_valid), U165.11 (command_vram_valid)
w_command_vram_wdata[31:0]: U164.26 (command_vram_wdata[31:0]), U165.13 (command_vram_wdata[31:0])
w_command_vram_wdata_mask[3:0]: U164.27 (command_vram_wdata_mask[3:0]), U165.14 (command_vram_wdata_mask[3:0])
w_command_vram_write: U164.25 (command_vram_write), U165.12 (command_vram_write)
w_cpu_cache_address[17:0]: U164.9 (cpu_vram_address[17:0])
w_cpu_vram_address[17:0]: U162.34 (vram_address[17:0])
w_cpu_vram_rdata[7:0]: U162.9 (vram_rdata[7:0]), U164.21 (cpu_vram_rdata[7:0])
w_cpu_vram_rdata_en: U162.10 (vram_rdata_en), U164.22 (cpu_vram_rdata_en)
w_cpu_vram_ready: U162.8 (vram_ready), U164.20 (cpu_vram_ready)
w_cpu_vram_valid: U162.36 (vram_valid), U164.10 (cpu_vram_valid)
w_cpu_vram_wdata[7:0]: U162.37 (vram_wdata[7:0]), U164.12 (cpu_vram_wdata[7:0])
w_cpu_vram_write: U162.35 (vram_write), U164.11 (cpu_vram_write)
w_intr_command_end: U162.13 (intr_command_end), U163.30 (intr_command_end)
w_intr_frame: U162.12 (intr_frame)
w_intr_line: U162.11 (intr_line)
w_palette_b[4:0]: U162.42 (palette_b[4:0])
w_palette_g[4:0]: U162.41 (palette_g[4:0])
w_palette_num[7:0]: U162.39 (palette_num[7:0])
w_palette_r[4:0]: U162.40 (palette_r[4:0])
w_palette_valid: U162.38 (palette_valid)
w_pre_vram_refresh: U165.21 (pre_vram_refresh)
w_read_color: U162.49 (read_color), U163.11 (read_color)
w_register_data[7:0]: U162.52 (register_data[7:0])
w_register_num[5:0]: U162.51 (register_num[5:0])
w_register_write: U162.50 (register_write)
w_register_write|ext_cmd_wr: U163.7 (register_write)
w_screen_mode[9:0]: U163.12 (screen_mode[9:0])
w_screen_mode_vram_address[17:0]: U165.6 (screen_mode_vram_address[17:0])
w_screen_mode_vram_rdata[31:0]: U165.22 (screen_mode_vram_rdata[31:0])
w_screen_mode_vram_valid: U165.7 (screen_mode_vram_valid)
w_screen_pos_x[3:0]: U165.4 (h_count[3:0])
w_sprite_collision: U162.15 (sprite_collision)
w_sprite_collision_x[8:0]: U162.16 (sprite_collision_x[8:0])
w_sprite_collision_y[9:0]: U162.17 (sprite_collision_y[9:0])
w_sprite_overmap: U162.18 (sprite_overmap)
w_sprite_overmap_enable: U162.47 (sprite_overmap_enable)
w_sprite_overmap_id[4:0]: U162.19 (sprite_overmap_id[4:0])
w_sprite_vram_address[17:0]: U165.8 (sprite_vram_address[17:0])
w_sprite_vram_rdata8[7:0]: U165.24 (sprite_vram_rdata8[7:0])
w_sprite_vram_rdata[31:0]: U165.23 (sprite_vram_rdata[31:0])
w_sprite_vram_valid: U165.9 (sprite_vram_valid)
w_status_border_detect: U162.22 (status_border_detect), U163.25 (status_border_detect)
w_status_border_position[8:0]: U162.27 (status_border_position[8:0]), U163.28 (status_border_position[8:0])
w_status_color[7:0]: U162.26 (status_color[7:0]), U163.27 (status_color[7:0])
w_status_field: U162.21 (status_field)
w_status_hsync: U162.23 (status_hsync)
w_status_transfer_ready: U162.25 (status_transfer_ready), U163.26 (status_transfer_ready)
w_status_vsync: U162.24 (status_vsync)
w_vram_access_mask: U162.28 (vram_access_mask), U163.29 (vram_access_mask)
w_vram_interleave: U163.13 (vram_interleave), U165.5 (vram_interleave)

Notes on the sheet:
vdp (u_v9958): estrutura gerada do RTL
V9968: clone do V9958 de HRA!, com extensões (comandos LRMM e outros, VRAM de 256 KB na SDRAM, saída HDMI com upscan e filtro bilinear). Portas ext_cmd_*: o geo3d escreve nos registradores de comando por aqui (patch de integração do geo3d). Blocos brancos = módulos folha (só as portas); blocos amar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
Portas do módulo
REG 259 · LUT 273 · ALU 0
REG 2218 · LUT 2539 · ALU 171 · DSP 1 · BSRAM 1 · SSRAM 16
REG 431 · LUT 1190 · ALU 235
REG 585 · LUT 1293 · ALU 152
REG 171 · LUT 156 · ALU 0
REG 165 · LUT 259 · ALU 124 · BSRAM 1
REG 2 · LUT 57 · ALU 10 · BSRAM 4
REG 324 · LUT 204 · ALU 56 · DSP 10 · BSRAM 4
Lógica local de vdp: 2 assign, 0 always (registradores) assign w_cpu_cache_address = w_vram_interleave ? { w_cpu_vram_address[17], w_cpu_vram_address[0], w_cpu_vram_address[16:1] }... assign ext_cmd_ce = w_status_command_execute
Convenções • Portas lógicas com bolinha = entrada ou saída invertida. • Flip-flops sensíveis à borda de subida; R/S = reset/set SÍNCRONO (feito dentro do always @(posedge clk)), ativo em 0 quando há bolinha. • EN = habilitação do clock (o registrador mantém o valor quando EN inativo). • Um registra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
