alexmoncks/V9968_Cartridge/geo3d/docs/kicad/vdp_timing_control.kicad_sch

## KiCad design geo3d/docs/kicad/vdp_timing_control.kicad_sch (2026-10-27)

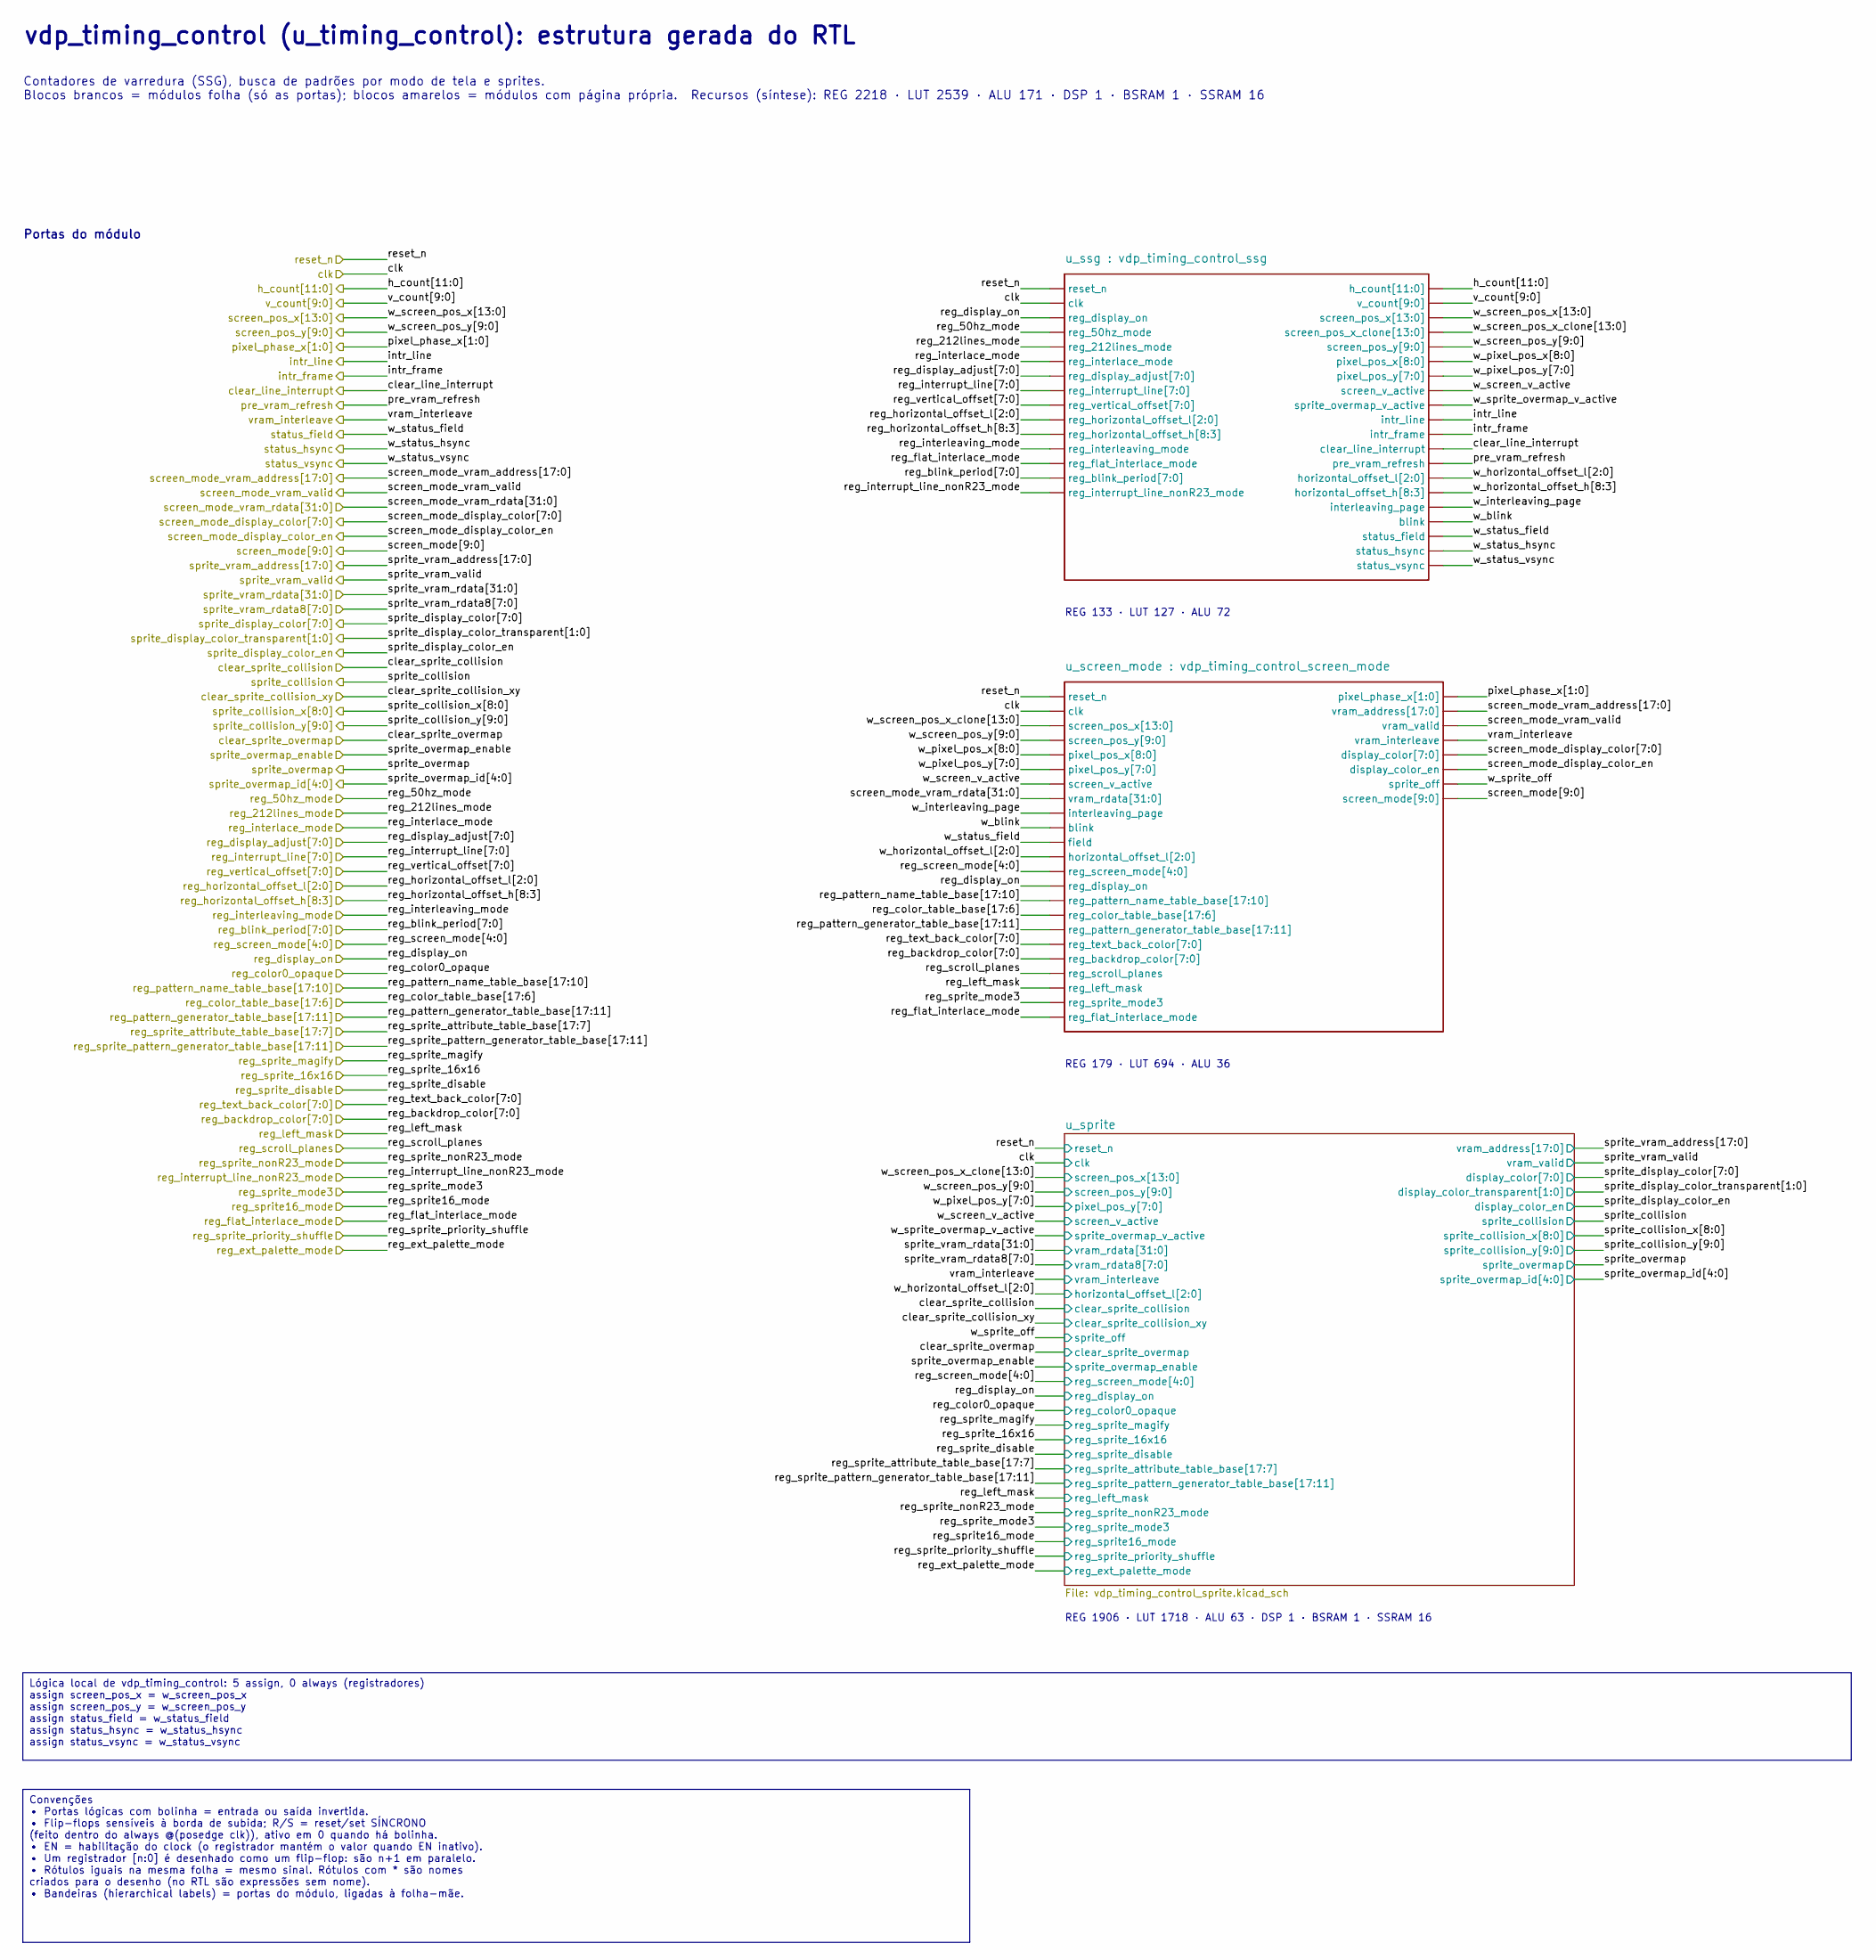
[picture p76: schematic vdp_timing_control.kicad_sch]

Parts:
U166: u_ssg : vdp_timing_control_ssg
U167: u_screen_mode : vdp_timing_control_screen_mode

Connections:
clear_line_interrupt: U166.27 (clear_line_interrupt)
clk: U166.2 (clk), U167.2 (clk)
h_count[11:0]: U166.16 (h_count[11:0])
intr_frame: U166.26 (intr_frame)
intr_line: U166.25 (intr_line)
pixel_phase_x[1:0]: U167.24 (pixel_phase_x[1:0])
pre_vram_refresh: U166.28 (pre_vram_refresh)
reg_50hz_mode: U166.4 (reg_50hz_mode)
reg_212lines_mode: U166.5 (reg_212lines_mode)
reg_backdrop_color[7:0]: U167.19 (reg_backdrop_color[7:0])
reg_blink_period[7:0]: U166.14 (reg_blink_period[7:0])
reg_color_table_base[17:6]: U167.16 (reg_color_table_base[17:6])
reg_display_adjust[7:0]: U166.7 (reg_display_adjust[7:0])
reg_display_on: U166.3 (reg_display_on), U167.14 (reg_display_on)
reg_flat_interlace_mode: U166.13 (reg_flat_interlace_mode), U167.23 (reg_flat_interlace_mode)
reg_horizontal_offset_h[8:3]: U166.11 (reg_horizontal_offset_h[8:3])
reg_horizontal_offset_l[2:0]: U166.10 (reg_horizontal_offset_l[2:0])
reg_interlace_mode: U166.6 (reg_interlace_mode)
reg_interleaving_mode: U166.12 (reg_interleaving_mode)
reg_interrupt_line[7:0]: U166.8 (reg_interrupt_line[7:0])
reg_interrupt_line_nonR23_mode: U166.15 (reg_interrupt_line_nonR23_mode)
reg_left_mask: U167.21 (reg_left_mask)
reg_pattern_generator_table_base[17:11]: U167.17 (reg_pattern_generator_table_base[17:11])
reg_pattern_name_table_base[17:10]: U167.15 (reg_pattern_name_table_base[17:10])
reg_screen_mode[4:0]: U167.13 (reg_screen_mode[4:0])
reg_scroll_planes: U167.20 (reg_scroll_planes)
reg_sprite_mode3: U167.22 (reg_sprite_mode3)
reg_text_back_color[7:0]: U167.18 (reg_text_back_color[7:0])
reg_vertical_offset[7:0]: U166.9 (reg_vertical_offset[7:0])
reset_n: U166.1 (reset_n), U167.1 (reset_n)
screen_mode[9:0]: U167.31 (screen_mode[9:0])
screen_mode_display_color[7:0]: U167.28 (display_color[7:0])
screen_mode_display_color_en: U167.29 (display_color_en)
screen_mode_vram_address[17:0]: U167.25 (vram_address[17:0])
screen_mode_vram_rdata[31:0]: U167.8 (vram_rdata[31:0])
screen_mode_vram_valid: U167.26 (vram_valid)
screen_pos_x[13:0]: U166.18 (screen_pos_x[13:0])
screen_pos_y[9:0]: U166.20 (screen_pos_y[9:0]), U167.4 (screen_pos_y[9:0])
status_field: U166.33 (status_field), U167.11 (field)
status_hsync: U166.34 (status_hsync)
status_vsync: U166.35 (status_vsync)
v_count[9:0]: U166.17 (v_count[9:0])
vram_interleave: U167.27 (vram_interleave)
w_blink: U166.32 (blink), U167.10 (blink)
w_horizontal_offset_h[8:3]: U166.30 (horizontal_offset_h[8:3])
w_horizontal_offset_l[2:0]: U166.29 (horizontal_offset_l[2:0]), U167.12 (horizontal_offset_l[2:0])
w_interleaving_page: U166.31 (interleaving_page), U167.9 (interleaving_page)
w_pixel_pos_x[8:0]: U166.21 (pixel_pos_x[8:0]), U167.5 (pixel_pos_x[8:0])
w_pixel_pos_y[7:0]: U166.22 (pixel_pos_y[7:0]), U167.6 (pixel_pos_y[7:0])
w_screen_pos_x_clone[13:0]: U166.19 (screen_pos_x_clone[13:0]), U167.3 (screen_pos_x[13:0])
w_screen_v_active: U166.23 (screen_v_active), U167.7 (screen_v_active)
w_sprite_off: U167.30 (sprite_off)
w_sprite_overmap_v_active: U166.24 (sprite_overmap_v_active)

Notes on the sheet:
vdp_timing_control (u_timing_control): estrutura gerada do RTL
Contadores de varredura (SSG), busca de padrões por modo de tela e sprites. Blocos brancos = módulos folha (só as portas); blocos amarelos = módulos com página própria. Recursos (síntese): REG 2218 · LUT 2539 · ALU 171 · DSP 1 · BSRAM 1 · SSRAM 16
Portas do módulo
REG 133 · LUT 127 · ALU 72
REG 179 · LUT 694 · ALU 36
REG 1906 · LUT 1718 · ALU 63 · DSP 1 · BSRAM 1 · SSRAM 16
Lógica local de vdp_timing_control: 5 assign, 0 always (registradores) assign screen_pos_x = w_screen_pos_x assign screen_pos_y = w_screen_pos_y assign status_field = w_status_field assign status_hsync = w_status_hsync assign status_vsync = w_status_vsync
Convenções • Portas lógicas com bolinha = entrada ou saída invertida. • Flip-flops sensíveis à borda de subida; R/S = reset/set SÍNCRONO (feito dentro do always @(posedge clk)), ativo em 0 quando há bolinha. • EN = habilitação do clock (o registrador mantém o valor quando EN inativo). • Um registra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
