alexmoncks/V9968_Cartridge/geo3d/docs/kicad/vdp_timing_control_sprite.kicad_sch

## KiCad design geo3d/docs/kicad/vdp_timing_control_sprite.kicad_sch (2026-10-27)

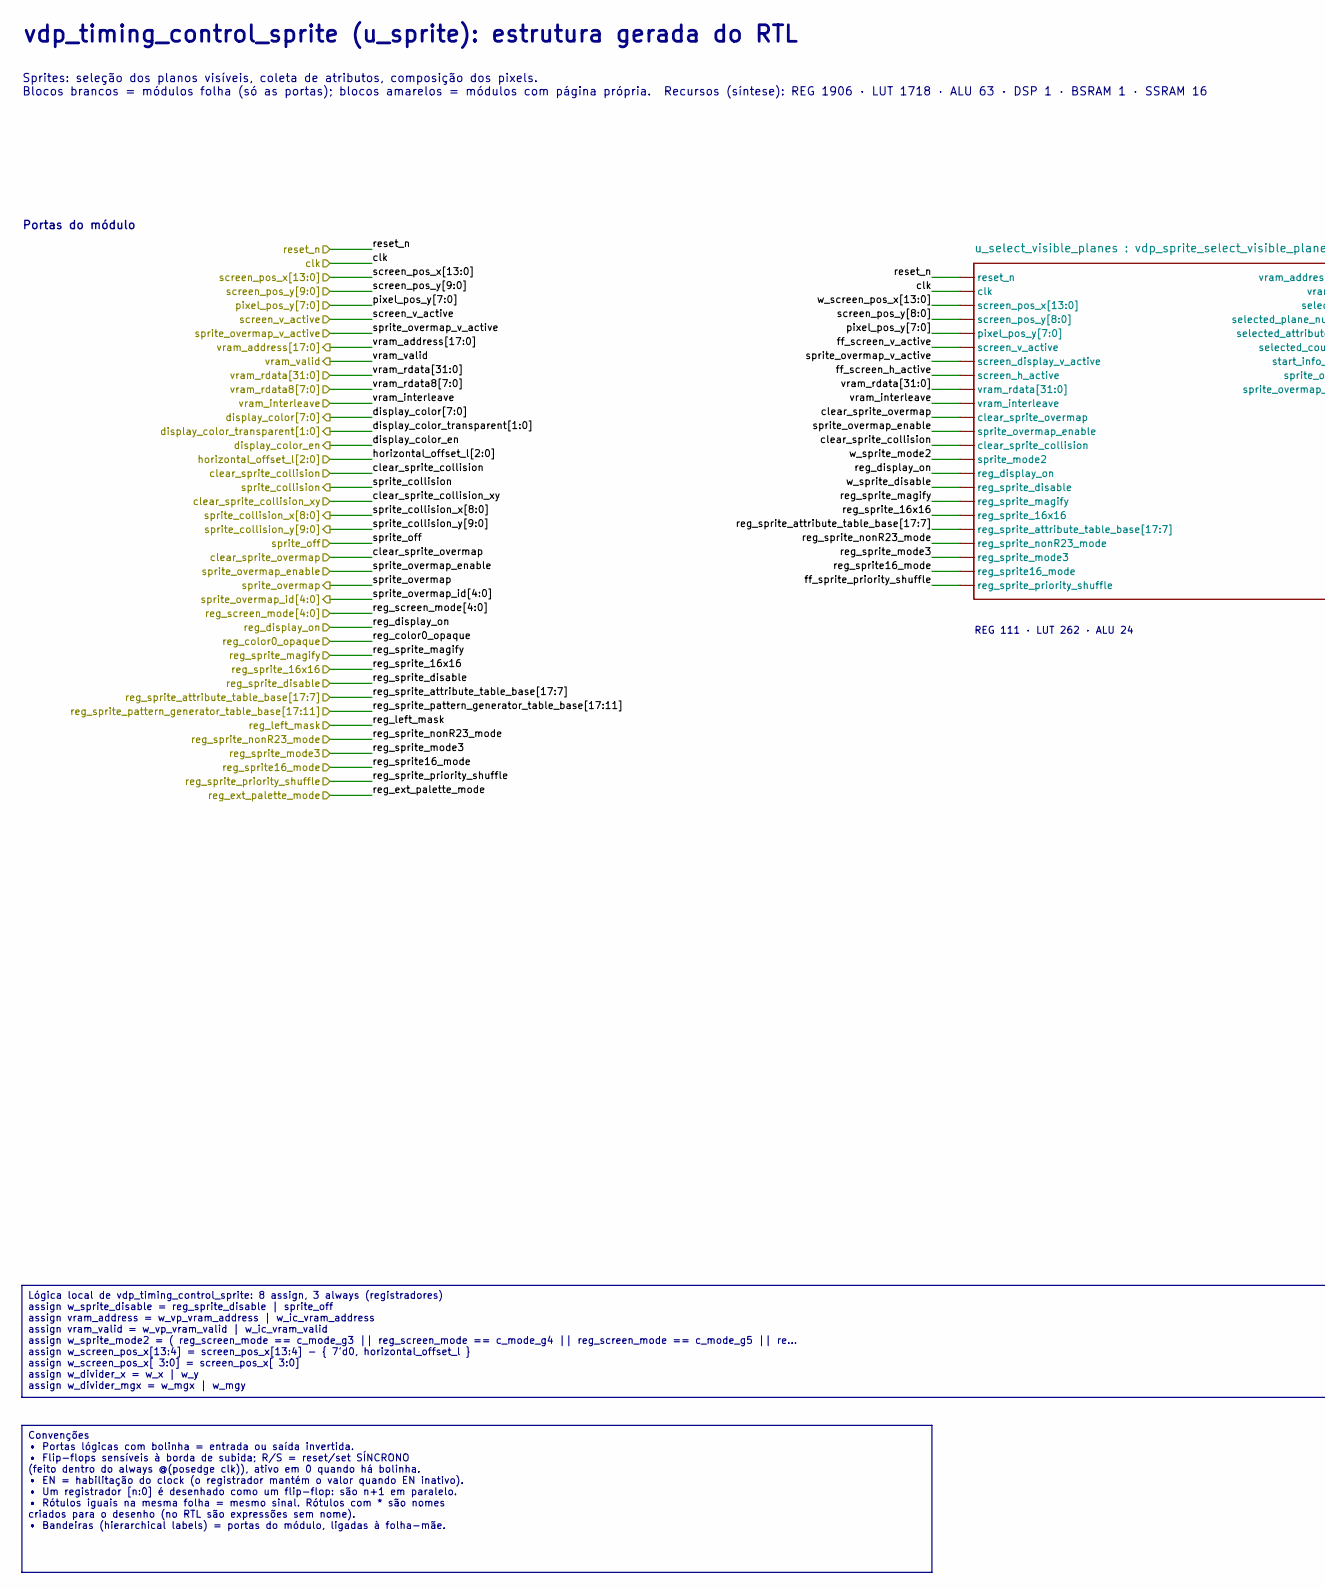
[picture p77: schematic vdp_timing_control_sprite.kicad_sch, part in row 1, column 1]

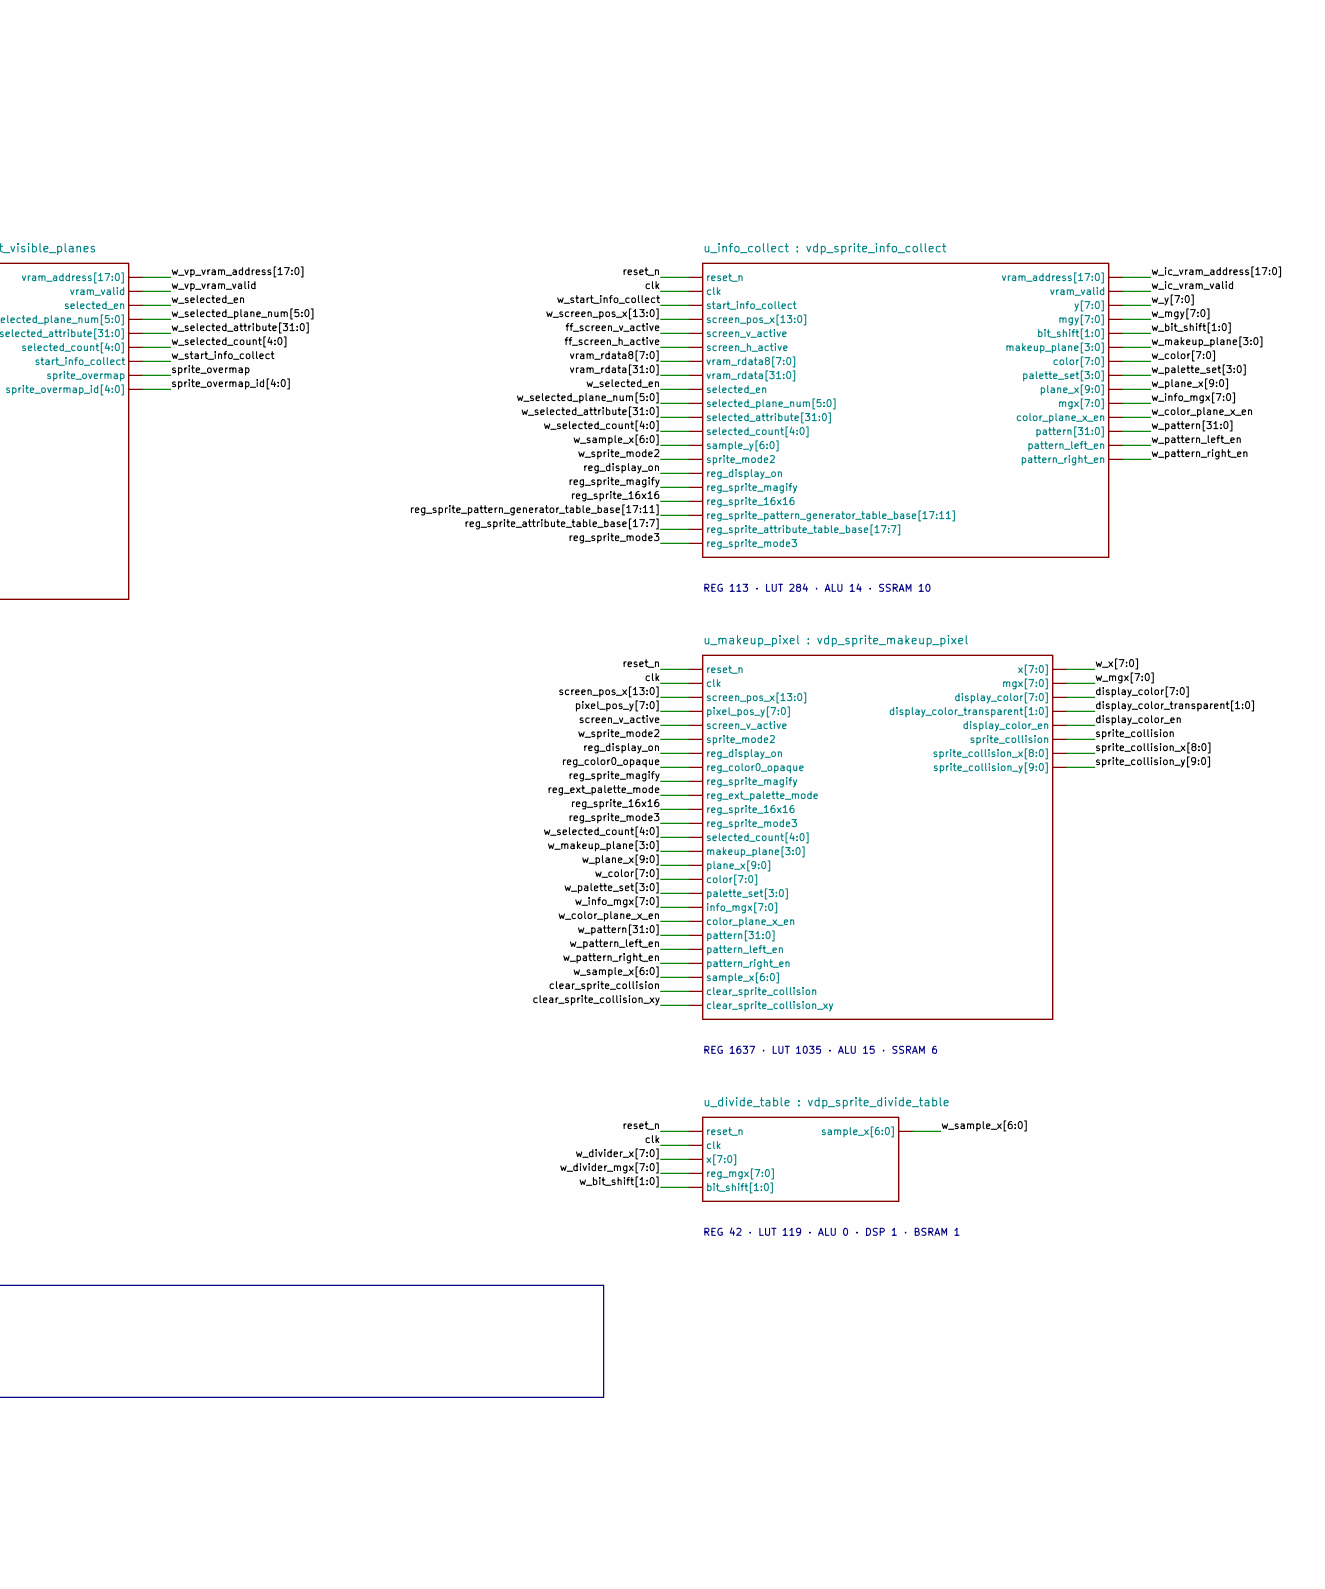
[picture p78: schematic vdp_timing_control_sprite.kicad_sch, part in row 1, column 2]

Parts:
U168: u_select_visible_planes : vdp_sprite_select_visib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
U169: u_info_collect : vdp_sprite_info_collect
U170: u_makeup_pixel : vdp_sprite_makeup_pixel
U171: u_divide_table : vdp_sprite_divide_table

Connections:
clear_sprite_collision: U168.13 (clear_sprite_collision), U170.24 (clear_sprite_collision)
clear_sprite_collision_xy: U170.25 (clear_sprite_collision_xy)
clear_sprite_overmap: U168.11 (clear_sprite_overmap)
clk: U168.2 (clk), U169.2 (clk), U170.2 (clk), U171.2 (clk)
display_color[7:0]: U170.28 (display_color[7:0])
display_color_en: U170.30 (display_color_en)
display_color_transparent[1:0]: U170.29 (display_color_transparent[1:0])
ff_screen_h_active: U168.8 (screen_h_active), U169.6 (screen_h_active)
ff_screen_v_active: U168.6 (screen_v_active), U169.5 (screen_v_active)
ff_sprite_priority_shuffle: U168.23 (reg_sprite_priority_shuffle)
pixel_pos_y[7:0]: U168.5 (pixel_pos_y[7:0]), U170.4 (pixel_pos_y[7:0])
reg_color0_opaque: U170.8 (reg_color0_opaque)
reg_display_on: U168.15 (reg_display_on), U169.15 (reg_display_on), U170.7 (reg_display_on)
reg_ext_palette_mode: U170.10 (reg_ext_palette_mode)
reg_sprite16_mode: U168.22 (reg_sprite16_mode)
reg_sprite_16x16: U168.18 (reg_sprite_16x16), U169.17 (reg_sprite_16x16), U170.11 (reg_sprite_16x16)
reg_sprite_attribute_table_base[17:7]: U168.19 (reg_sprite_attribute_table_base[17:7]), U169.19 (reg_sprite_attribute_table_base[17:7])
reg_sprite_magify: U168.17 (reg_sprite_magify), U169.16 (reg_sprite_magify), U170.9 (reg_sprite_magify)
reg_sprite_mode3: U168.21 (reg_sprite_mode3), U169.20 (reg_sprite_mode3), U170.12 (reg_sprite_mode3)
reg_sprite_nonR23_mode: U168.20 (reg_sprite_nonR23_mode)
reg_sprite_pattern_generator_table_base[17:11]: U169.18 (reg_sprite_pattern_generator_table_base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)
reset_n: U168.1 (reset_n), U169.1 (reset_n), U170.1 (reset_n), U171.1 (reset_n)
screen_pos_x[13:0]: U170.3 (screen_pos_x[13:0])
screen_pos_y[8:0]: U168.4 (screen_pos_y[8:0])
screen_v_active: U170.5 (screen_v_active)
sprite_collision: U170.31 (sprite_collision)
sprite_collision_x[8:0]: U170.32 (sprite_collision_x[8:0])
sprite_collision_y[9:0]: U170.33 (sprite_collision_y[9:0])
sprite_overmap: U168.31 (sprite_overmap)
sprite_overmap_enable: U168.12 (sprite_overmap_enable)
sprite_overmap_id[4:0]: U168.32 (sprite_overmap_id[4:0])
sprite_overmap_v_active: U168.7 (screen_display_v_active)
vram_interleave: U168.10 (vram_interleave)
vram_rdata8[7:0]: U169.7 (vram_rdata8[7:0])
vram_rdata[31:0]: U168.9 (vram_rdata[31:0]), U169.8 (vram_rdata[31:0])
w_bit_shift[1:0]: U169.25 (bit_shift[1:0]), U171.5 (bit_shift[1:0])
w_color[7:0]: U169.27 (color[7:0]), U170.16 (color[7:0])
w_color_plane_x_en: U169.31 (color_plane_x_en), U170.19 (color_plane_x_en)
w_divider_mgx[7:0]: U171.4 (reg_mgx[7:0])
w_divider_x[7:0]: U171.3 (x[7:0])
w_ic_vram_address[17:0]: U169.21 (vram_address[17:0])
w_ic_vram_valid: U169.22 (vram_valid)
w_info_mgx[7:0]: U169.30 (mgx[7:0]), U170.18 (info_mgx[7:0])
w_makeup_plane[3:0]: U169.26 (makeup_plane[3:0]), U170.14 (makeup_plane[3:0])
w_mgx[7:0]: U170.27 (mgx[7:0])
w_mgy[7:0]: U169.24 (mgy[7:0])
w_palette_set[3:0]: U169.28 (palette_set[3:0]), U170.17 (palette_set[3:0])
w_pattern[31:0]: U169.32 (pattern[31:0]), U170.20 (pattern[31:0])
w_pattern_left_en: U169.33 (pattern_left_en), U170.21 (pattern_left_en)
w_pattern_right_en: U169.34 (pattern_right_en), U170.22 (pattern_right_en)
w_plane_x[9:0]: U169.29 (plane_x[9:0]), U170.15 (plane_x[9:0])
w_sample_x[6:0]: U169.13 (sample_y[6:0]), U170.23 (sample_x[6:0]), U171.6 (sample_x[6:0])
w_screen_pos_x[13:0]: U168.3 (screen_pos_x[13:0]), U169.4 (screen_pos_x[13:0])
w_selected_attribute[31:0]: U168.28 (selected_attribute[31:0]), U169.11 (selected_attribute[31:0])
w_selected_count[4:0]: U168.29 (selected_count[4:0]), U169.12 (selected_count[4:0]), U170.13 (selected_count[4:0])
w_selected_en: U168.26 (selected_en), U169.9 (selected_en)
w_selected_plane_num[5:0]: U168.27 (selected_plane_num[5:0]), U169.10 (selected_plane_num[5:0])
w_sprite_disable: U168.16 (reg_sprite_disable)
w_sprite_mode2: U168.14 (sprite_mode2), U169.14 (sprite_mode2), U170.6 (sprite_mode2)
w_start_info_collect: U168.30 (start_info_collect), U169.3 (start_info_collect)
w_vp_vram_address[17:0]: U168.24 (vram_address[17:0])
w_vp_vram_valid: U168.25 (vram_valid)
w_x[7:0]: U170.26 (x[7:0])
w_y[7:0]: U169.23 (y[7:0])

Notes on the sheet:
vdp_timing_control_sprite (u_sprite): estrutura gerada do RTL
Sprites: seleção dos planos visíveis, coleta de atributos, composição dos pixels. Blocos brancos = módulos folha (só as portas); blocos amarelos = módulos com página própria. Recursos (síntese): REG 1906 · LUT 1718 · ALU 63 · DSP 1 · BSRAM 1 · SSRAM 16
Portas do módulo
REG 111 · LUT 262 · ALU 24
REG 113 · LUT 284 · ALU 14 · SSRAM 10
REG 1637 · LUT 1035 · ALU 15 · SSRAM 6
REG 42 · LUT 119 · ALU 0 · DSP 1 · BSRAM 1
Lógica local de vdp_timing_control_sprite: 8 assign, 3 always (registradores) assign w_sprite_disable = reg_sprite_disable | sprite_off assign vram_address = w_vp_vram_address | w_ic_vram_address assign vram_valid = w_vp_vram_valid | w_ic_vram_valid assign w_sprite_mode2 = ( reg_screen_mode == c_mo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
Convenções • Portas lógicas com bolinha = entrada ou saída invertida. • Flip-flops sensíveis à borda de subida; R/S = reset/set SÍNCRONO (feito dentro do always @(posedge clk)), ativo em 0 quando há bolinha. • EN = habilitação do clock (o registrador mantém o valor quando EN inativo). • Um registra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
