alexmoncks/V9968_Cartridge/geo3d/docs/kicad/vdp_upscan.kicad_sch

## KiCad design geo3d/docs/kicad/vdp_upscan.kicad_sch (2026-10-27)

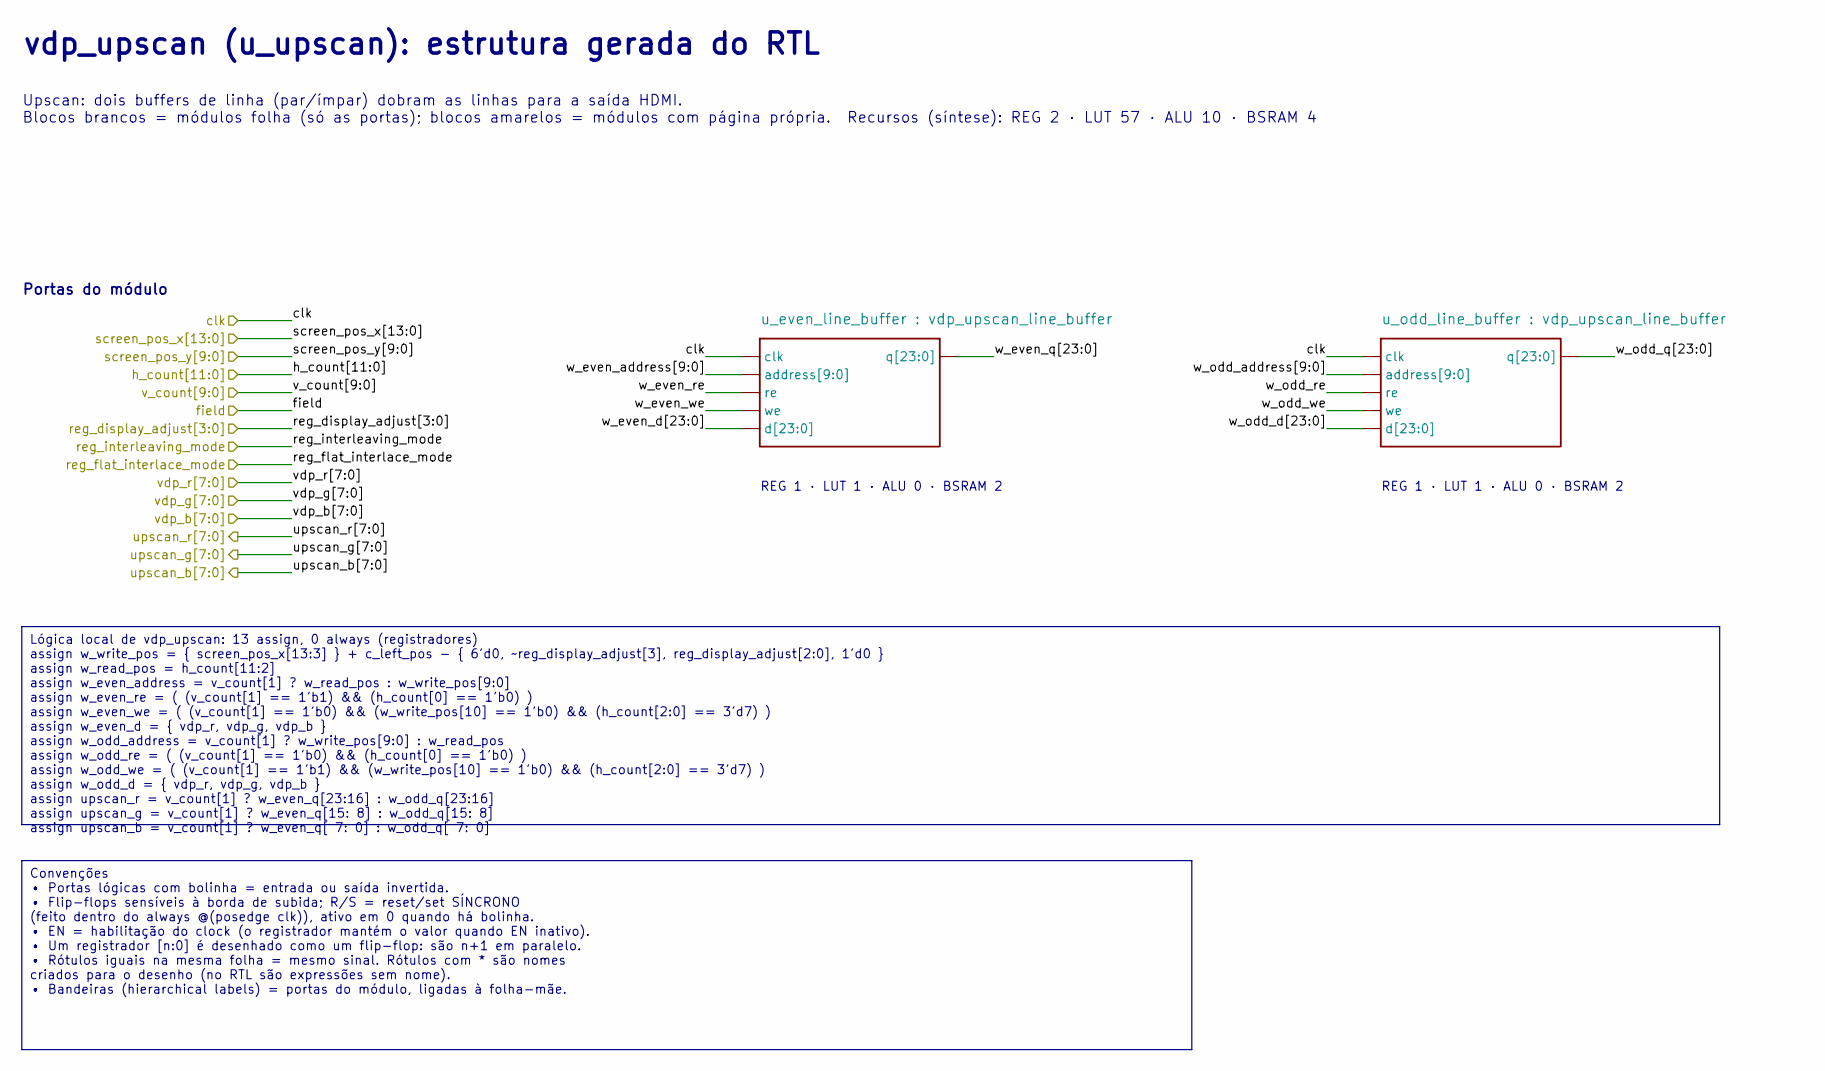
[picture p79: schematic vdp_upscan.kicad_sch]

Parts:
U173: u_even_line_buffer : vdp_upscan_line_buffer
U174: u_odd_line_buffer : vdp_upscan_line_buffer

Connections:
clk: U173.1 (clk), U174.1 (clk)
w_even_address[9:0]: U173.2 (address[9:0])
w_even_d[23:0]: U173.5 (d[23:0])
w_even_q[23:0]: U173.6 (q[23:0])
w_even_re: U173.3 (re)
w_even_we: U173.4 (we)
w_odd_address[9:0]: U174.2 (address[9:0])
w_odd_d[23:0]: U174.5 (d[23:0])
w_odd_q[23:0]: U174.6 (q[23:0])
w_odd_re: U174.3 (re)
w_odd_we: U174.4 (we)

Notes on the sheet:
vdp_upscan (u_upscan): estrutura gerada do RTL
Upscan: dois buffers de linha (par/ímpar) dobram as linhas para a saída HDMI. Blocos brancos = módulos folha (só as portas); blocos amarelos = módulos com página própria. Recursos (síntese): REG 2 · LUT 57 · ALU 10 · BSRAM 4
Portas do módulo
REG 1 · LUT 1 · ALU 0 · BSRAM 2
Lógica local de vdp_upscan: 13 assign, 0 always (registradores) assign w_write_pos = { screen_pos_x[13:3] } + c_left_pos - { 6'd0, ~reg_display_adjust[3], reg_display_adjust[2:0], 1'd0 } assign w_read_pos = h_count[11:2] assign w_even_address = v_count[1] ? w_read_pos : w_write_pos[9:0] assign w_ev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
Convenções • Portas lógicas com bolinha = entrada ou saída invertida. • Flip-flops sensíveis à borda de subida; R/S = reset/set SÍNCRONO (feito dentro do always @(posedge clk)), ativo em 0 quando há bolinha. • EN = habilitação do clock (o registrador mantém o valor quando EN inativo). • Um registra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
