alexmoncks/V9968_Cartridge/geo3d/docs/kicad/vdp_video_double_buffer.kicad_sch

## KiCad design geo3d/docs/kicad/vdp_video_double_buffer.kicad_sch (2026-10-27)

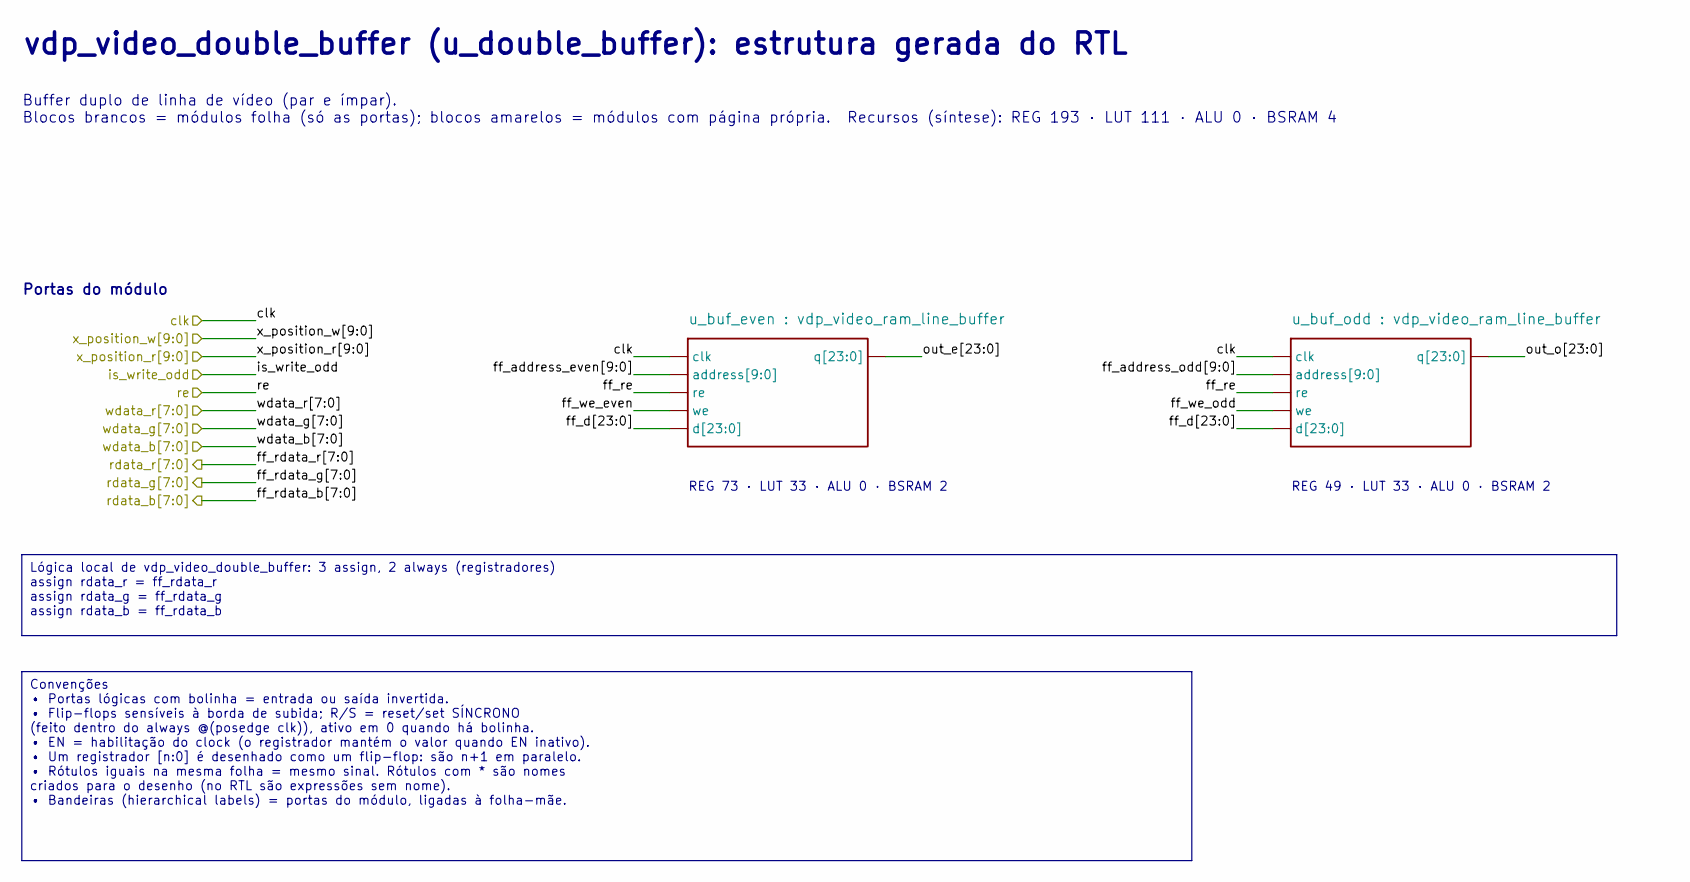
[picture p80: schematic vdp_video_double_buffer.kicad_sch]

Parts:
U178: u_buf_even : vdp_video_ram_line_buffer
U179: u_buf_odd : vdp_video_ram_line_buffer

Connections:
clk: U178.1 (clk), U179.1 (clk)
ff_address_even[9:0]: U178.2 (address[9:0])
ff_address_odd[9:0]: U179.2 (address[9:0])
ff_d[23:0]: U178.5 (d[23:0]), U179.5 (d[23:0])
ff_re: U178.3 (re), U179.3 (re)
ff_we_even: U178.4 (we)
ff_we_odd: U179.4 (we)
out_e[23:0]: U178.6 (q[23:0])
out_o[23:0]: U179.6 (q[23:0])

Notes on the sheet:
vdp_video_double_buffer (u_double_buffer): estrutura gerada do RTL
Buffer duplo de linha de vídeo (par e ímpar). Blocos brancos = módulos folha (só as portas); blocos amarelos = módulos com página própria. Recursos (síntese): REG 193 · LUT 111 · ALU 0 · BSRAM 4
Portas do módulo
REG 73 · LUT 33 · ALU 0 · BSRAM 2
REG 49 · LUT 33 · ALU 0 · BSRAM 2
Lógica local de vdp_video_double_buffer: 3 assign, 2 always (registradores) assign rdata_r = ff_rdata_r assign rdata_g = ff_rdata_g assign rdata_b = ff_rdata_b
Convenções • Portas lógicas com bolinha = entrada ou saída invertida. • Flip-flops sensíveis à borda de subida; R/S = reset/set SÍNCRONO (feito dentro do always @(posedge clk)), ativo em 0 quando há bolinha. • EN = habilitação do clock (o registrador mantém o valor quando EN inativo). • Um registra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
