alexmoncks/V9968_Cartridge/geo3d/docs/kicad/vdp_video_out.kicad_sch

## KiCad design geo3d/docs/kicad/vdp_video_out.kicad_sch (2026-10-27)

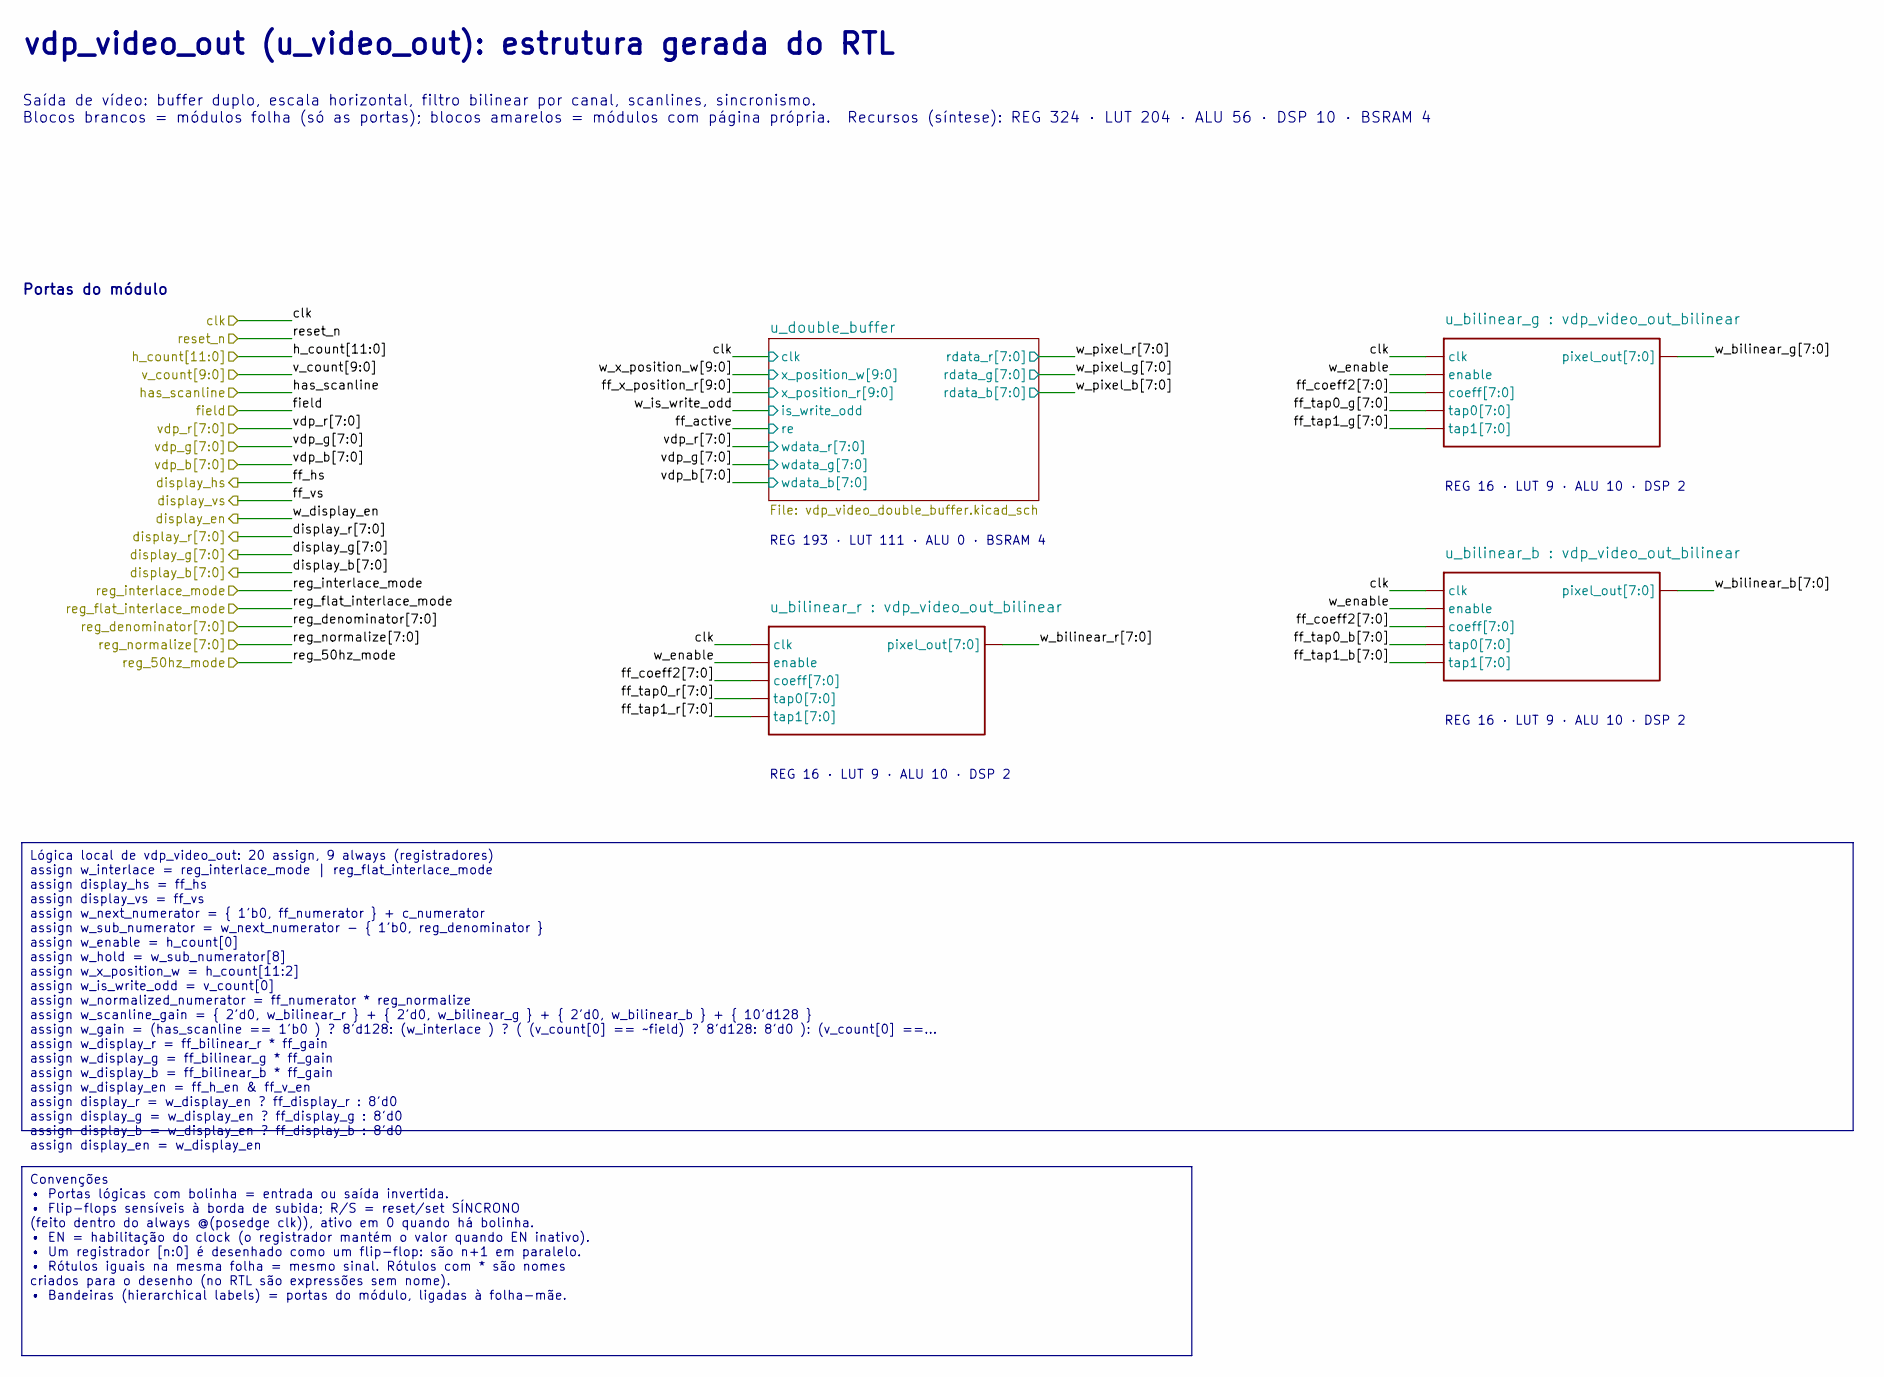
[picture p81: schematic vdp_video_out.kicad_sch]

Parts:
U175: u_bilinear_r : vdp_video_out_bilinear
U176: u_bilinear_g : vdp_video_out_bilinear
U177: u_bilinear_b : vdp_video_out_bilinear

Connections:
clk: U175.1 (clk), U176.1 (clk), U177.1 (clk)
ff_coeff2[7:0]: U175.3 (coeff[7:0]), U176.3 (coeff[7:0]), U177.3 (coeff[7:0])
ff_tap0_b[7:0]: U177.4 (tap0[7:0])
ff_tap0_g[7:0]: U176.4 (tap0[7:0])
ff_tap0_r[7:0]: U175.4 (tap0[7:0])
ff_tap1_b[7:0]: U177.5 (tap1[7:0])
ff_tap1_g[7:0]: U176.5 (tap1[7:0])
ff_tap1_r[7:0]: U175.5 (tap1[7:0])
w_bilinear_b[7:0]: U177.6 (pixel_out[7:0])
w_bilinear_g[7:0]: U176.6 (pixel_out[7:0])
w_bilinear_r[7:0]: U175.6 (pixel_out[7:0])
w_enable: U175.2 (enable), U176.2 (enable), U177.2 (enable)

Notes on the sheet:
vdp_video_out (u_video_out): estrutura gerada do RTL
Saída de vídeo: buffer duplo, escala horizontal, filtro bilinear por canal, scanlines, sincronismo. Blocos brancos = módulos folha (só as portas); blocos amarelos = módulos com página própria. Recursos (síntese): REG 324 · LUT 204 · ALU 56 · DSP 10 · BSRAM 4
Portas do módulo
REG 193 · LUT 111 · ALU 0 · BSRAM 4
REG 16 · LUT 9 · ALU 10 · DSP 2
Lógica local de vdp_video_out: 20 assign, 9 always (registradores) assign w_interlace = reg_interlace_mode | reg_flat_interlace_mode assign display_hs = ff_hs assign display_vs = ff_vs assign w_next_numerator = { 1'b0, ff_numerator } + c_numerator assign w_sub_numerator = w_next_numerator - { 1'b0,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
Convenções • Portas lógicas com bolinha = entrada ou saída invertida. • Flip-flops sensíveis à borda de subida; R/S = reset/set SÍNCRONO (feito dentro do always @(posedge clk)), ativo em 0 quando há bolinha. • EN = habilitação do clock (o registrador mantém o valor quando EN inativo). • Um registra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
