alexmoncks/V9968_Cartridge/fpga/V9968_Cartridge_TangNano20K/src/tangnano20k_vdp_cartridge.v

// -----------------------------------------------------------------------------
//	tangnano20k_vdp_cartridge.v
//	Copyright (C)2025 Takayuki Hara (HRA!)
//	
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
module tangnano20k_vdp_cartridge (
	input			clk,			//	PIN04		(27MHz)
	input			clk14m,			//	PIN80
	input			slot_reset_n,	//	PIN86
	input			slot_iorq_n,	//	PIN18
	input			slot_rd_n,		//	PIN15
	input			slot_wr_n,		//	PIN16
	output			slot_wait,		//	PIN72
	output			slot_intr,		//	PIN71
	output			slot_data_dir,	//	PIN19
	input	[7:0]	slot_a,			//	PIN17, 49, 48, 41, 42, 76, 31, 30
	inout	[7:0]	slot_d,			//	PIN73, 74, 75, 85, 77, 27, 28, 29
	output			oe_n,			//	PIN20
	input	[1:0]	dipsw,			//	PIN52, 53
	output			ws2812_led,		//	PIN79
	input	[1:0]	button,			//	PIN87, 88	KEY2, KEY1

	//	HDMI
	output			tmds_clk_p,		//	(PIN33/34)
	output			tmds_clk_n,		//	dummy
	output	[2:0]	tmds_d_p,		//	(PIN39/40), (PIN37/38), (PIN35/36)
	output	[2:0]	tmds_d_n,		//	dummy

	output			O_sdram_clk,
	output			O_sdram_cke,
	output			O_sdram_cs_n,	// chip select
	output			O_sdram_ras_n,	// row address select
	output			O_sdram_cas_n,	// columns address select
	output			O_sdram_wen_n,	// write enable
	inout	[31:0]	IO_sdram_dq,	// 32 bit bidirectional data bus
	output	[10:0]	O_sdram_addr,	// 11 bit multiplexed address bus
	output	[ 1:0]	O_sdram_ba,		// two banks
	output	[ 3:0]	O_sdram_dqm		// data mask
);
	reg				ff_reset_n0 = 1'b0;		/* synthesis syn_preserve = 1 */
	reg				ff_reset_n1 = 1'b0;		/* synthesis syn_preserve = 1 */
	reg				ff_reset_n2 = 1'b0;		/* synthesis syn_preserve = 1 */
	reg				ff_reset2_n0 = 1'b0;	/* synthesis syn_preserve = 1 */
	reg				ff_reset2_n1 = 1'b0;	/* synthesis syn_preserve = 1 */
	reg				ff_reset2_n2 = 1'b0;	/* synthesis syn_preserve = 1 */
	reg				ff_reset3_n0 = 1'b0;	/* synthesis syn_preserve = 1 */
	reg				ff_reset3_n1 = 1'b0;	/* synthesis syn_preserve = 1 */
	reg				ff_reset3_n2 = 1'b0;	/* synthesis syn_preserve = 1 */
	wire			pll_lock215;
	wire			pll_lock85;
	wire			clk42m;				//	42.95454MHz
	wire			clk42g;				//	42.95454MHz (geo3d engine: CLKOUTD of u_pll2 = clk85m / 2)
	wire			clk85m;				//	85.90908MHz
	wire			clk85m_n;			//	85.90908MHz (180deg phase shift)
	wire			clk215m;			//	214.7727MHz
	wire			reset_n;
	wire			reset_n2;
	wire			reset_n3;
	wire	[2:0]	w_bus_address;
	wire			w_bus_ioreq;
	wire			w_bus_write;
	wire			w_bus_valid;
	wire			w_bus_ready;
	wire	[7:0]	w_bus_wdata;
	wire	[7:0]	w_bus_rdata;
	wire			w_bus_rdata_en;

	wire			w_bus_vdp_ioreq;
	wire			w_bus_vdp_ready;
	wire	[7:0]	w_bus_vdp_rdata;
	wire			w_bus_vdp_rdata_en;

	wire			w_sdram_init_busy;

	wire	[22:2]	w_sdram_address;
	wire			w_sdram_write;
	wire			w_sdram_valid;
	wire			w_sdram_refresh;
	wire	[31:0]	w_sdram_wdata;
	wire	[3:0]	w_sdram_wdata_mask;
	wire	[31:0]	w_sdram_rdata;
	wire			w_sdram_rdata_en;

	wire			w_video_de;
	wire			w_video_hs;
	wire			w_video_vs;
	wire	[7:0]	w_video_r;
	wire	[7:0]	w_video_g;
	wire	[7:0]	w_video_b;

	wire			w_pulse0;
	wire			w_pulse1;
	wire			w_pulse2;
	wire			w_pulse3;
	wire			w_pulse4;
	wire			w_pulse5;
	wire			w_pulse6;
	wire			w_pulse7;
	wire			w_wr;
	wire			w_sending;
	wire	[7:0]	w_red;
	wire	[7:0]	w_green;
	wire	[7:0]	w_blue;
	wire			w_int_n;

	assign slot_wait		= w_sdram_init_busy;
	assign oe_n				= 1'b0;

	always @( posedge clk85m ) begin
		ff_reset_n0		<= slot_reset_n;
		ff_reset_n1		<= ff_reset_n0;
		ff_reset_n2		<= ff_reset_n1;
	end

	always @( posedge clk42m ) begin
		ff_reset2_n0	<= slot_reset_n;
		ff_reset2_n1	<= ff_reset2_n0;
		ff_reset2_n2	<= ff_reset2_n1;
	end

	always @( posedge clk85m ) begin
		ff_reset3_n0	<= slot_reset_n;
		ff_reset3_n1	<= ff_reset3_n0;
		ff_reset3_n2	<= ff_reset3_n1;
	end

	assign reset_n	= ff_reset_n2;
	assign reset_n2	= ff_reset2_n2;
	assign reset_n3	= ff_reset3_n2;

	// --------------------------------------------------------------------
	//	clock
	// --------------------------------------------------------------------
	Gowin_rPLL u_pll (
		.clkout			( clk215m			),		//	output clkout	214.7727MHz
		.lock			( pll_lock215		),
		.clkin			( clk14m			)		//	input clkin		14.31818MHz
	);

	Gowin_rPLL2 u_pll2 (
		.clkout			( clk85m			),		//	output clkout	85.90908MHz
		.lock			( pll_lock85		),
		.clkoutp		( clk85m_n			),		//	output clkoutp	85.90908MHz (180deg phase shift)
		.clkoutd		( clk42g			),		//	output clkoutd	42.95454MHz (CLKOUT / 2, geo3d engine only)
		.clkin			( clk14m			)		//	input clkin		14.31818MHz
    );

	Gowin_CLKDIV u_clkdiv (
		.clkout			( clk42m			),		//	output clkout	42.95454MHz
		.hclkin			( clk85m			),		//	input hclkin	85.90908MHz
		.resetn			( pll_lock85		)		//	input resetn
	);

	// --------------------------------------------------------------------
	//	FullColor Intelligent LED
	// --------------------------------------------------------------------
	msx_slot u_msx_slot (
		.clk				( clk85m					),
		.initial_busy		( w_sdram_init_busy			),
		.p_slot_reset_n		( reset_n					),
		.p_slot_ioreq_n		( slot_iorq_n				),
		.p_slot_wr_n		( slot_wr_n					),
		.p_slot_rd_n		( slot_rd_n					),
		.p_slot_address		( slot_a					),
		.p_slot_data		( slot_d					),
		.p_slot_int			( slot_intr					),
		.p_slot_data_dir	( slot_data_dir				),
		.int_n				( w_int_n					),
		.bus_address		( w_bus_address				),
		.bus_ioreq			( w_bus_ioreq				),
		.bus_write			( w_bus_write				),
		.bus_valid			( w_bus_valid				),
		.bus_ready			( w_bus_ready				),
		.bus_wdata			( w_bus_wdata				),
		.bus_rdata			( w_bus_rdata				),
		.bus_rdata_en		( w_bus_rdata_en			),
		.dipsw				( dipsw[0]					)
	);

	// --------------------------------------------------------------------
	//	geo3d coprocessor (ports base+5 / base+7)
	// --------------------------------------------------------------------
	wire			w_geo_hit;
	wire			w_geo_ready;
	wire	[7:0]	w_geo_rdata;
	wire			w_geo_rdata_en;
	wire			w_geo_cmd_wr;
	wire	[5:0]	w_geo_cmd_num;
	wire	[7:0]	w_geo_cmd_data;
	wire			w_geo_cmd_ce;
	wire			w_geo_run_busy;

	geo3d_bus u_geo3d (
		.clk				( clk85m					),
		.clk_eng			( clk42g					),
		.reset_n			( reset_n3					),
		.bus_address		( w_bus_address				),
		.bus_ioreq			( w_bus_ioreq				),
		.bus_write			( w_bus_write				),
		.bus_valid			( w_bus_valid				),
		.bus_wdata			( w_bus_wdata				),
		.hit				( w_geo_hit					),
		.bus_ready			( w_geo_ready				),
		.bus_rdata			( w_geo_rdata				),
		.bus_rdata_en		( w_geo_rdata_en			),
		.cmd_wr				( w_geo_cmd_wr				),
		.cmd_num			( w_geo_cmd_num				),
		.cmd_data			( w_geo_cmd_data			),
		.cmd_ce				( w_geo_cmd_ce				),
		.run_busy			( w_geo_run_busy			)
	);

	assign w_bus_rdata		= ( w_geo_rdata_en		) ? w_geo_rdata:
						  ( w_bus_vdp_rdata_en	) ? w_bus_vdp_rdata: 8'hFF;
	assign w_bus_rdata_en	= w_bus_vdp_rdata_en | w_geo_rdata_en;
	assign w_bus_ready		= w_geo_hit ? w_geo_ready: w_bus_vdp_ready;

	// --------------------------------------------------------------------
	//	V9968 core
	// --------------------------------------------------------------------
	vdp u_v9968 (
		.reset_n			( reset_n3					),
		.clk				( clk85m					),
		.initial_busy		( w_sdram_init_busy			),
		.bus_address		( w_bus_address				),
		.bus_ioreq			( w_bus_ioreq				),
		.bus_write			( w_bus_write				),
		.bus_valid			( w_bus_valid & ~w_geo_hit	),
		.bus_ready			( w_bus_vdp_ready			),
		.bus_wdata			( w_bus_wdata				),
		.bus_rdata			( w_bus_vdp_rdata			),
		.bus_rdata_en		( w_bus_vdp_rdata_en		),
		.int_n				( w_int_n					),
		.vram_address		( w_sdram_address[17:2]		),
		.vram_write			( w_sdram_write				),
		.vram_valid			( w_sdram_valid				),
		.vram_wdata			( w_sdram_wdata				),
		.vram_wdata_mask	( w_sdram_wdata_mask		),
		.vram_rdata			( w_sdram_rdata				),
		.vram_rdata_en		( w_sdram_rdata_en			),
		.vram_refresh		( w_sdram_refresh			),
		.display_hs			( w_video_hs				),
		.display_vs			( w_video_vs				),
		.display_en			( w_video_de				),
		.display_r			( w_video_r					),
		.display_g			( w_video_g					),
		.display_b			( w_video_b					),
		.ext_cmd_wr			( w_geo_cmd_wr				),
		.ext_cmd_num		( w_geo_cmd_num				),
		.ext_cmd_data		( w_geo_cmd_data			),
		.ext_cmd_ce			( w_geo_cmd_ce				),
		.force_highspeed	( dipsw[1]					),
		.button				( button					),
		.pulse0				( w_pulse0					),
		.pulse1				( w_pulse1					),
		.pulse2				( w_pulse2					),
		.pulse3				( w_pulse3					),
		.pulse4				( w_pulse4					),
		.pulse5				( w_pulse5					),
		.pulse6				( w_pulse6					),
		.pulse7				( w_pulse7					)
	);

	assign w_sdram_address[22:18]	= 5'd0;

	// --------------------------------------------------------------------
	//	HDMI
	// --------------------------------------------------------------------
	DVI_TX_Top u_dvi (
		.I_rst_n			( reset_n2					),		//input I_rst_n
		.I_serial_clk		( clk215m					),		//input I_serial_clk
		.I_rgb_clk			( clk42m					),		//input I_rgb_clk
		.I_rgb_vs			( w_video_vs				),		//input I_rgb_vs
		.I_rgb_hs			( w_video_hs				),		//input I_rgb_hs
		.I_rgb_de			( w_video_de				),		//input I_rgb_de
		.I_rgb_r			( w_video_r					),		//input [7:0] I_rgb_r
		.I_rgb_g			( w_video_g					),		//input [7:0] I_rgb_g
		.I_rgb_b			( w_video_b					),		//input [7:0] I_rgb_b
		.O_tmds_clk_p		( tmds_clk_p				),		//output O_tmds_clk_p
		.O_tmds_clk_n		( tmds_clk_n				),		//output O_tmds_clk_n
		.O_tmds_data_p		( tmds_d_p					),		//output [2:0] O_tmds_data_p
		.O_tmds_data_n		( tmds_d_n					)		//output [2:0] O_tmds_data_n
	);

	// --------------------------------------------------------------------
	//	SDRAM
	// --------------------------------------------------------------------
	ip_sdram #(
		.FREQ				( 85_909_080				)		//	Hz
	) u_sdram (
		.reset_n			( reset_n					),
		.clk				( clk85m					),		//	85.90908MHz
		.clk_sdram			( clk85m_n					),
		.sdram_init_busy	( w_sdram_init_busy			),
		.bus_address		( w_sdram_address			),
		.bus_valid			( w_sdram_valid				),
		.bus_write			( w_sdram_write				),
		.bus_refresh		( w_sdram_refresh			),
		.bus_wdata			( w_sdram_wdata				),
		.bus_wdata_mask		( w_sdram_wdata_mask		),
		.bus_rdata			( w_sdram_rdata				),
		.bus_rdata_en		( w_sdram_rdata_en			),
		.O_sdram_clk		( O_sdram_clk				),
		.O_sdram_cke		( O_sdram_cke				),
		.O_sdram_cs_n		( O_sdram_cs_n				),		// chip select
		.O_sdram_ras_n		( O_sdram_ras_n				),		// row address select
		.O_sdram_cas_n		( O_sdram_cas_n				),		// columns address select
		.O_sdram_wen_n		( O_sdram_wen_n				),		// write enable
		.IO_sdram_dq		( IO_sdram_dq				),		// 32 bit bidirectional data bus
		.O_sdram_addr		( O_sdram_addr				),		// 11 bit multiplexed address bus
		.O_sdram_ba			( O_sdram_ba				),		// two banks
		.O_sdram_dqm		( O_sdram_dqm				)		// data mask
	);

	// --------------------------------------------------------------------
	//	Debug—p LED
	// --------------------------------------------------------------------
	ip_ws2812_led u_led (
		.reset_n			( reset_n					),
		.clk				( clk85m					),
		.wr					( w_wr						),
		.sending			( w_sending					),
		.red				( w_red						),
		.green				( w_green					),
		.blue				( w_blue					),
		.ws2812_led			( ws2812_led				)
	);

	// --------------------------------------------------------------------
	//	Debugger
	// --------------------------------------------------------------------
	ip_debugger u_debugger (
		.reset_n			( reset_n					),
		.clk				( clk85m					),
		.pulse0				( w_pulse0					),
		.pulse1				( w_pulse1					),
		.pulse2				( w_pulse2					),
		.pulse3				( w_pulse3					),
		.pulse4				( w_pulse4					),
		.pulse5				( w_pulse5					),
		.pulse6				( w_pulse6					),
		.pulse7				( w_pulse7					),
		.wr					( w_wr						),
		.sending			( w_sending					),
		.red				( w_red						),
		.green				( w_green					),
		.blue				( w_blue					)
	);
endmodule
