alexmoncks/V9968_Cartridge/geo3d/rom/geo3d_rom.asm

; SPDX-License-Identifier: MIT
; Copyright (c) 2026 Alex Moncks
; ============================================================================
; geo3d_rom.asm  -  GEO3D demo sequence, MSX MegaROM (ASCII16 mapper)
;
; Bank 0 (page 1, 4000h-7FFFh) holds this player. Banks 1..n (page 2,
; 8000h-BFFFh) hold one command stream per demo: the exact port traffic a Z80
; program sends to geo3d and to the V9968 (register writes, VDP commands,
; VRAM uploads, page flips). The geometry is computed by geo3d in the FPGA;
; the Z80 only moves bytes, as in the .COM demos.
;
; The streams are compressed (G3LZ, g3lz.py) in blocks of at most 8 KB of
; ops. The player decodes the current block into dz_buf (RAM, page 3) a
; token at a time, just ahead of the op it interprets (dz_need), and further
; ahead while it waits for a page flip's blank (dz_idle). A few blocks are
; raw (each demo up to its first page flip, the setup frames of the loop
; demos): the player reads those straight from ROM. Raw ops that a stream
; placed earlier already has in ROM (the textures and tables several demos
; upload) are not stored again: a CALL runs them where they are; a VRAM
; upload cut by a bank's end goes on with VMORE. The music data after the
; streams is not compressed.
;
; Music: a ROM built with a ProTracker MOD holds the whole MOD, and on a
; MoonSound a MOD player plays it (geo3d_modplay.asm): the Z80 reads its
; patterns and runs ProTracker's effects at the song's own speed and BPM
; (the OPL4's timer 2, polled through mus_hook and its kin), and the OPL4
; wave part plays the MOD's own samples, uploaded to the sample RAM during
; the language menu. The song starts with the first crawl and then plays on
; for good, over and over, through every demo. Without a MoonSound, or with
; too little sample RAM for the samples, the crawl plays music.py's
; conversion instead (OPL4 / OPL3 FM + PSG, SCC + PSG, or PSG), one tick
; per vertical blank.
;
; Ports: PORT_BASE comes from rom_ports.asm (written by build_rom.py):
;   88h  GEO3D.ROM, real hardware: V9968 cartridge with the geo3d build, DIP
;        switch at 88h (VDP 88h-8Ch, geo3d 8Dh/8Fh). The internal VDP is left
;        alone. Output: the V9968 cartridge HDMI port.
;   98h  GEO3D_98.ROM, emulator profile (openMSX V9968 fork, -ext geo3d): the
;        V9968 is the machine's VDP (98h-9Ch), geo3d on 9Dh/9Fh.
; It starts with a language menu (English, Español, Português: the crawl is
; the only text in the demos): 1/2/3, or cursor up/down and SPACE or RETURN.
; Then the demos play in that language at 30 frames per second, in a loop.
; Space bar: next demo.
;
; geo3d is looked for first (geo_probe, as geo3d BASIC's detect: reads only
; until it is identified). Without it (HRA!'s own bitstream answers P+5..P+7
; with FFh; no V9968 at 88h; a VDP whose ports repeat at 9Ch-9Fh) the ROM
; shows "geo3d not found" in English, Español and Português (nogeo) and
; stays there, touching no geo3d port. Every wait for geo3d (RUN) and for the
; command engine (CE) has a time limit (wait_limit, about 3 s on a 3.58 MHz
; Z80): when it runs out, the music stops and the same message comes up
; (hw_timeout), instead of a black screen for ever.
;
; Stream opcodes (little-endian), ports for the 88h profile:
;   00 END                          next demo
;   01 GEO   idx n data[n]          OUT 8Dh,idx then n bytes to 8Fh
;   02 GEOD  n data[n]              n bytes to 8Fh (index unchanged)
;   03 VREG  reg val                VDP register write
;   04 VIND  reg n data[n]          R#17 = reg (auto-increment), n bytes to 8Bh
;   05 WAITGEO                      until geo3d RUN busy = 0
;   06 WAITCE                       until the VDP command engine is idle
;   07 VRLE  a0 a1 a2 len(2) rle    VRAM upload at a 18-bit address, RLE:
;                                   c < 80h: c+1 literal bytes follow,
;                                   c >= 80h: next byte repeated c-7Eh times
;   08 FLIP  page                   PACE vblanks since the last flip, R#2 = page
;   09 MARK  count                  loop start: the last op of its block, so
;                                   the loop starts at the next block
;   0A LOOP                         back to MARK until count runs out
;   0B NEXTBLOCK                    end of the block: the next one follows it
;                                   in ROM
;   0C MENU                         language menu on the picture already
;                                   uploaded; picks the demo table, restarts
;   0D PACE  n                      vblanks per flip from here on (each demo
;                                   starts at 2: 30 fps at 60 Hz)
;   0E MUSIC                        start the music: the MOD on a MoonSound
;                                   found during the menu (mod_start, right
;                                   after the next page flip; it keeps its
;                                   own time and plays on for good: a MUSIC
;                                   while it plays does nothing), else
;                                   music_table, the best chip found:
;                                   OPL4/OPL3 FM, SCC + PSG, or PSG (one tick
;                                   per vertical blank of the page flips),
;                                   which stops at the next demo_init
;
;   0F CALL  bank first(2) end(2)   the raw ops at first..end-1 of that bank
;                                   (page 2), then back to the op after the
;                                   CALL: a raw block's ops already in ROM (the
;                                   same texture or table in several demos)
;                                   are stored once and run from there, as
;                                   fast as they run in their own stream
;   10 VMORE len(2) rle             more RLE data for the VRAM upload in
;                                   progress (a VRLE cut at a bank's end); no
;                                   port write but the data, so the traffic is
;                                   the VRLE's. Raw blocks only
;   11 EAGER                        while the MOD plays, until the next page
;                                   flip: the polls in busy code work out the
;                                   MOD's next tick at once (mod_poll), not
;                                   in the flip's wait, which is far off in a
;                                   frame an upload makes long (a demo's
;                                   black screen, tex's textures): its notes
;                                   keep their time. No traffic (op_eager)
;   12 STOP                         the end of the "geo3d not found"
;                                   picture's stream (nogeo): display on,
;                                   and the ROM stays there (op_stop)
;
; RAM (page 3): C000h-C055h variables, C100h-C4FFh scc_buf, C800h-E7FFh
; dz_buf, E800h-EDE0h the MOD player's (MP_RAM), the stack below F000h.
; Free: C050h, C056h-C0FFh, C500h-C7FFh and EDE1h-EEFFh (C04Eh-C04Fh: written
; only by a --null-mod ROM, a measure).
;
; Assemble: z80asm -o bank0.bin geo3d_rom.asm (build_rom.py does it all)
; ============================================================================

        include "rom_ports.asm"     ; PORT_BASE: 0x88 or 0x98
        include "rom_mod.asm"       ; MOD_SONG and where the MOD's data is

VDP_DATA:   equ PORT_BASE
VDP_CTRL:   equ PORT_BASE + 1
VDP_PAL:    equ PORT_BASE + 2
VDP_IND:    equ PORT_BASE + 3
VDP_PORT4:  equ PORT_BASE + 4
GEO_IDX:    equ PORT_BASE + 5
GEO_DAT:    equ PORT_BASE + 7

PPI_B:      equ 0xA9            ; keyboard column input
PPI_C:      equ 0xAA            ; keyboard row select (low nibble)
PSG_A:      equ 0xA0            ; PSG register select
PSG_D:      equ 0xA1            ; PSG data
OPL_A0:     equ 0xC4            ; OPL4 FM / OPL3: bank 0 address (read: status)
OPL_D0:     equ 0xC5
OPL_A1:     equ 0xC6            ; bank 1 address
OPL_D1:     equ 0xC7

ENASLT:     equ 0x0024
MSXVER:     equ 0x002D          ; 0 MSX1, 1 MSX2, 2 MSX2+, 3 turbo R
INITXT:     equ 0x006C          ; SCREEN 0 (the MSX's own VDP)
CHPUT:      equ 0x00A2          ; print A
RSLREG:     equ 0x0138
EXPTBL:     equ 0xFCC1
RG9SAV:     equ 0xFFE8          ; the BIOS's copy of R#9 (NT: 50 / 60 Hz)

WAIT_TURNS: equ 2               ; the waits for geo3d and the command engine:
                                ; 65536 polls a turn (~1.6 s on a 3.58 MHz Z80,
                                ; ~0.7 s on an R800 in ROM mode; a turbo R
                                ; runs the cartridge's INIT on the Z80), then
                                ; hw_timeout
WAIT_MOD:   equ 40000           ; the same while the MOD plays (wait_limit)

BANK2_SEL:  equ 0x7000          ; ASCII16: bank for 8000h-BFFFh

; RAM (page 3)
curbank:    equ 0xC000
loop_cnt:   equ 0xC001
loop_bank:  equ 0xC002
loop_ptr:   equ 0xC003          ; 2 bytes
cur_demo:   equ 0xC005          ; 2 bytes
keyprev:    equ 0xC007
menu_sel:   equ 0xC008          ; 0 English, 1 Español, 2 Português
menu_keys:  equ 0xC009          ; keys down at the last menu scan
demo_base:  equ 0xC00A          ; 2 bytes: demo table of the chosen language
flip_n:     equ 0xC00C          ; vblanks per page flip (PACE)
my_slot:    equ 0xC00D          ; this cartridge's slot (ENASLT format)
scc_slot:   equ 0xC00E          ; slot of a Konami SCC, FFh: none
scc_try:    equ 0xC00F
mus_target: equ 0xC010          ; 0 PSG, 1 SCC + PSG, 2 OPL + PSG, 3 MOD (MoonSound)
mus_on:     equ 0xC011
mus_bank:   equ 0xC012
mus_ptr:    equ 0xC013          ; 2 bytes
mus_wait:   equ 0xC015          ; ticks to skip
scc_end:    equ 0xC016          ; 2 bytes: end of the SCC writes in scc_buf
opl4:       equ 0xC018          ; 1: the FM part is an OPL4's (MoonSound)
kon_lo:     equ 0xC019          ; key on being written: F-number low
kon_b0:     equ 0xC01A          ; and B0
opl_b0:     equ 0xC020          ; 18 bytes: last B0 value per FM channel
dz_src:     equ 0xC032          ; 2 bytes: next token (page 2, bank curbank)
dz_dst:     equ 0xC034          ; 2 bytes: dz_buf is decoded up to here
dz_noff:    equ 0xC036          ; 2 bytes: last match offset, negated
dz_lim:     equ 0xC038          ; 2 bytes: dz_need decodes up to here
dz_end:     equ 0xC03A          ; 0: decoding the block, 1: a raw block or the
                                ; block decoded to its end, 2: inside a CALL
mus_hook:   equ 0xC03B          ; 3 bytes: RET, or JP mod_poll while the MOD plays
mod_go:     equ 0xC03E          ; 1: the MOD starts after the next page flip
call_bank:  equ 0xC03F          ; CALL: the caller's bank,
call_ret:   equ 0xC040          ;   2 bytes: its next op,
call_end:   equ 0xC042          ;   2 bytes: the end of the ops called
hw_hook:    equ 0xC044          ; 3 bytes: the geo3d and command engine waits' poll: RET, or JP mod_hw
vrle_jp:    equ 0xC047          ; 3 bytes: JP op_vrle, or JP op_vrle_f while the MOD plays
vmore_jp:   equ 0xC04A          ; 3 bytes: JP op_vmore, or JP op_vmore_f
mod_live:   equ 0xC04D          ; 1: the MOD plays (from its start on, for good)
dz_probe0:  equ 0xC04E          ; (--null-mod only: a token decoded ahead starts,
dz_probe1:  equ 0xC04F          ;   and ends)
vf_endh:    equ 0xC051          ; op_vrle_f: the end of the RLE data, high byte
idle_hook:  equ 0xC052          ; 3 bytes: the page flip's wait's poll: RET, or JP mod_poll
ng_vdp:     equ 0xC055          ; geo_probe: 1 = a V99x8 answers at PORT_BASE
                                ; (the "geo3d not found" picture can go there)
scc_buf:    equ 0xC100          ; 1 KB: this tick's SCC writes (offset, value)
dz_buf:     equ 0xC800          ; 8 KB: the stream block being played (C800h-E7FFh)
MP_RAM:     equ 0xE800          ; 1505 bytes: the MOD player's (geo3d_modplay.asm)

DZ_AHEAD:   equ 259             ; dz_need before each op: an op is at most
                                ; 258 bytes (GEO, VIND), but VRLE asks for its own

        org 0x4000
        db "AB"
        dw init
        dw 0, 0, 0
        ds 6, 0
        db "ROM_AS16"                   ; 4010h: ROM type signature (MSXgl): ASCII16
        include "../tools/mapper_tag_ascii16.asm"     ; never run: for mapper guessers

; ----------------------------------------------------------------------------
init:
        di
        ld sp, 0xF000
        ; page 2 -> this cartridge's slot (same slot as page 1)
        call RSLREG
        rrca
        rrca
        and 3
        ld c, a
        ld b, 0
        ld hl, EXPTBL
        add hl, bc
        ld a, (hl)
        and 0x80
        or c
        ld c, a
        inc hl
        inc hl
        inc hl
        inc hl
        ld a, (hl)
        and 0x0C
        or c
        ld (my_slot), a
        ld h, 0x80
        call ENASLT
        di
        xor a
        ld (keyprev), a
        ld a, 0xC9
        ld (mus_hook), a            ; RET: no music module poll
        ld (hw_hook), a
        ld (idle_hook), a
        ld a, 0xC3
        ld (vrle_jp), a             ; JP op_vrle, JP op_vmore: the uploads as
        ld (vmore_jp), a            ; they are without the MOD
        ld hl, op_vrle
        ld (vrle_jp + 1), hl
        ld hl, op_vmore
        ld (vmore_jp + 1), hl
        xor a
        ld (mod_live), a
        call geo_probe              ; the first port access: geo3d there?
        jp nz, nogeo                ; no: the message
        call music_detect
        call psg_silence
        ld hl, menu_entry           ; the menu is a stream too (picture + MENU)
        jr play_demo

restart:
        ld hl, (demo_base)

; HL -> demo table entry: bank, stream address (2), palette address (2)
play_demo:
        ld a, (hl)
        cp 0xFF
        jr z, restart
        ld (cur_demo), hl
        push hl
        inc hl
        inc hl
        inc hl
        ld e, (hl)
        inc hl
        ld d, (hl)
        ex de, hl
        call demo_init              ; HL = palette
        pop hl
        ld a, (hl)
        call setbank2
        inc hl
        ld e, (hl)
        inc hl
        ld d, (hl)
        ld (dz_src), de             ; the stream's first block
        call dz_block               ; HL = its first op

; ----------------------------------------------------------------------------
; HL = next op (in dz_buf, or in ROM for a raw block)
interp:
        call mus_hook               ; the MOD's poll, before every op
        ld a, (dz_end)              ; a raw block, or decoded to its end:
        or a                        ; nothing to decode
        jr nz, ip_raw
        ld bc, DZ_AHEAD
        call dz_need                ; the whole op decoded (VRLE asks for more)
ip_op:  ld a, (hl)
        inc hl
        add a, a
        ld e, a
        ld d, 0
        push hl
        ld hl, op_table
        add hl, de
        ld e, (hl)
        inc hl
        ld d, (hl)
        pop hl
        push de
        ret                         ; jump to the handler, HL = operands

ip_raw: dec a
        jr z, ip_op                 ; 1: raw, or decoded to its end
        ld de, (call_end)           ; 2: inside a CALL: at its end?
        ld a, l
        cp e
        jr nz, ip_op
        ld a, h
        cp d
        jr nz, ip_op
        ld a, 1                     ; back to the caller (a raw block)
        ld (dz_end), a
        ld a, (call_bank)
        call setbank2
        ld hl, (call_ret)
        jr ip_op

op_table:
        dw op_end, op_geo, op_geod, op_vreg, op_vind, op_waitgeo, op_waitce
        dw vrle_jp, op_flip, op_mark, op_loop, op_nextblock, op_menu, op_pace
        dw op_music, op_call, vmore_jp, op_eager, op_stop

; CALL, in a raw block: the ops at first..end-1 of a bank (raw ops of a
; stream placed earlier, no NEXTBLOCK among them), then the op after it.
; dz_end = 2 meanwhile: interp returns at the end (ip_raw).
op_call:
        ld a, (curbank)
        ld (call_bank), a
        ld a, (hl)                  ; bank
        inc hl
        ld e, (hl)
        inc hl
        ld d, (hl)                  ; DE = first op
        inc hl
        ld c, (hl)
        inc hl
        ld b, (hl)                  ; BC = end
        inc hl
        ld (call_ret), hl
        ld (call_end), bc
        call setbank2
        ld a, 2
        ld (dz_end), a
        ex de, hl
        jp interp

; VMORE: the rest of a VRLE that a bank's end cut (raw blocks only): its
; RLE data goes on at the VRAM address where the VRLE stopped
op_vmore:
        ld e, (hl)                  ; DE = packed length
        inc hl
        ld d, (hl)
        inc hl
        ld c, VDP_DATA
        jp vr_loop

op_end:
next_demo:
        ld hl, (cur_demo)
        ld de, 5
        add hl, de
        jp play_demo

op_geo:
        ld a, (hl)
        inc hl
        out (GEO_IDX), a
op_geod:
        ld b, (hl)
        inc hl
        ld a, b
        or a
        jp z, interp
        ld c, GEO_DAT
        otir
        jp interp

op_vreg:
        ld b, (hl)
        inc hl
        ld a, (hl)
        inc hl
        out (VDP_CTRL), a
        ld a, b
        or 0x80
        out (VDP_CTRL), a
        jp interp

op_vind:
        ld a, (hl)
        inc hl
        out (VDP_CTRL), a
        ld a, 0x80 + 17
        out (VDP_CTRL), a           ; R#17 = first register, auto-increment
        ld b, (hl)
        inc hl
        ld c, VDP_IND
        otir
        jp interp

; the same polls as without a time limit (a read, then the hook and a read
; again while busy); the count starts with the second read
op_waitgeo:
        in a, (GEO_IDX)
        rrca
        jp nc, interp               ; bit0 = RUN busy
        call wait_limit
wg_1:   call hw_hook                ; (keeps BC, DE, HL)
        in a, (GEO_IDX)
        rrca
        jp nc, interp
        dec de
        ld a, d
        or e
        jr nz, wg_1
        djnz wg_1
        jp hw_timeout               ; geo3d busy for ~3 s: it stopped answering

op_waitce:
        call wait_ce
        jp interp

op_pace:
        ld a, (hl)
        inc hl
        ld (flip_n), a
        jp interp

op_music:
        push hl
        call music_start
        pop hl
        jp interp

; MARK is the last op of its block, so the loop starts at the next block:
; at dz_src (DZ_AHEAD has decoded this one to its end), or right after this
; block's NEXTBLOCK when it is raw (HL in page 2)
op_mark:
        ld a, (hl)
        inc hl
        ld (loop_cnt), a
        ld de, (dz_src)
        bit 6, h
        jr nz, om_1
        ld d, h
        ld e, l
        inc de
om_1:   ld (loop_ptr), de
        ld a, (curbank)
        ld (loop_bank), a
        jp interp

op_loop:
        ld a, (loop_cnt)
        dec a
        ld (loop_cnt), a
        jp z, interp
        ld a, (loop_bank)
        call setbank2
        ld hl, (loop_ptr)
        ld (dz_src), hl
        call dz_block               ; HL = its first op
        jp interp

; the next block starts at dz_src (DZ_AHEAD has decoded this one to its end),
; or right here when this one is raw (HL in page 2)
op_nextblock:
        bit 6, h
        jr nz, onb_1
        ld (dz_src), hl
onb_1:  call dz_block
        jp interp

; VRAM upload, RLE. R#14 = A17..A14, then A7..A0 and 40h | A13..A8.
op_vrle:
        ld a, (dz_end)              ; (a raw block, or decoded to its end)
        or a
        jr nz, vr_go
        push hl                     ; the whole op decoded: 5 + packed length
        inc hl
        inc hl
        inc hl
        ld c, (hl)
        inc hl
        ld b, (hl)
        ld hl, 5
        add hl, bc
        ld b, h
        ld c, l
        pop hl
        call dz_need
vr_go:  ld e, (hl)                  ; A7..A0
        inc hl
        ld d, (hl)                  ; A15..A8
        inc hl
        ld a, (hl)                  ; A17..A16
        inc hl
        add a, a
        add a, a
        ld b, a
        ld a, d
        rlca
        rlca
        and 3
        or b
        out (VDP_CTRL), a
        ld a, 0x80 + 14
        out (VDP_CTRL), a
        ld a, e
        out (VDP_CTRL), a
        ld a, d
        and 0x3F
        or 0x40
        out (VDP_CTRL), a
        ld e, (hl)                  ; DE = packed length
        inc hl
        ld d, (hl)
        inc hl
        ld c, VDP_DATA
vr_loop:
        ld a, d
        or e
        jp z, interp
        ld a, (hl)
        inc hl
        dec de
        cp 0x80
        jr nc, vr_run
        inc a                       ; literal: a + 1 bytes
        ld b, a
        ld a, e
        sub b
        ld e, a
        jr nc, vr_lit
        dec d
vr_lit:
        otir
        jr vr_loop
vr_run:
        sub 0x7E                    ; run: 2..129 copies
        ld b, a
        ld a, (hl)
        inc hl
        dec de
vr_r1:
        out (VDP_DATA), a
        djnz vr_r1
        jr vr_loop

; Page flip: the V9968 sets S#0 bit7 (F) at every vertical blank and reading
; S#0 clears it. Flip on the flip_n-th blank since the last flip (2 = 30 fps).
op_flip:
        ld a, (hl)
        inc hl
        push hl
        rrca
        rrca
        rrca
        or 0x1F                     ; R#2 = page * 32 + 1Fh
        ld e, a
        ld a, (flip_n)
        ld b, a
        in a, (VDP_CTRL)            ; S#0 (R#15 = 0)
        rlca
        jr nc, fl_wait
        dec b                       ; one blank already went by (PACE >= 2)
        call music_tick             ; one music tick per blank
fl_wait:
        in a, (VDP_CTRL)
        rlca
        jr c, fl_blank
        call idle_hook              ; (the MOD works out its next tick here)
        in a, (VDP_CTRL)            ; again: the flip waits for the poll or for
        rlca                        ; the token, never for both
        jr c, fl_blank
        push bc
        push de
        if MP_NULL
        ld a, (dz_end)              ; (build_rom.py --null-mod, a measure:
        or a                        ; dz_probe0 and dz_probe1 written around
        jr nz, flw_1                ; each token decoded here, for openMSX's
        if MP_NULL & 2              ; watchpoints: modcost.py; --null-mod 2:
        jr flw_1                    ; no decoding ahead, every op decoded
        endif                       ; when it is needed)
        ld (dz_probe0), a
        call dz_idle
        ld (dz_probe1), a
flw_1:
        else
        call dz_idle                ; decode ahead while waiting: one token
        endif
        pop de
        pop bc
        jr fl_wait
fl_blank:
        dec b
        jr z, fl_flip
        call music_tick
        jr fl_wait
fl_flip:
        ld a, e
        out (VDP_CTRL), a
        ld a, 0x80 + 2
        out (VDP_CTRL), a           ; flip right at the blank,
        call music_tick             ; then this blank's music tick (FM ticks can be long)
        ld a, (mod_go)
        or a
        call nz, mod_go1            ; the MOD, if its MUSIC came since the last flip
        ld a, (mod_live)
        or a
        jr z, fl_sp
        ld hl, mod_tpoll            ; (after an EAGER: the busy host's poll again)
        ld (mus_hook + 1), hl
fl_sp:
        ; space bar (row 8, bit 0, active low): next demo on a new press
        in a, (PPI_C)
        and 0xF0
        or 8
        out (PPI_C), a
        in a, (PPI_B)
        cpl
        and 1
        ld b, a
        ld a, (keyprev)
        ld c, a
        ld a, b
        ld (keyprev), a
        pop hl
        or a
        jp z, interp
        ld a, c
        or a
        jp nz, interp
        call wait_ce
        jp next_demo

; EAGER: while the MOD plays, mus_hook works out its next tick as soon as it
; can (mod_poll) until the next page flip puts mod_tpoll back
op_eager:
        ld a, (mod_live)
        or a
        jp z, interp
        push hl
        ld hl, mod_poll
        ld (mus_hook + 1), hl
        pop hl
        jp interp

; hw_hook while the MOD plays (the waits for geo3d and for the command
; engine): a tick that is due, and one token more of the block (dz_idle):
; while the hardware works, the CPU decodes ahead what the page flip's wait
; would, which now also works out the MOD's ticks
mod_hw:
        push bc
        push de
        push hl
        if MP_NULL & 2
        else
        call dz_idle
        endif
        pop hl
        pop de
        pop bc
        jp mod_tpoll

; ----------------------------------------------------------------------------
; Stream decompression (G3LZ, g3lz.py). The compressed stream is read through
; page 2 (bank curbank); each block (at most 8 KB of ops) is decoded into
; dz_buf token by token, only as far as the interpreter needs it.
;
; Token T = LLL R MMMM, then the literal length byte, the literals, the
; offset, the match length byte (each only when needed):
;   LLL   0..6 literals; 7: next byte x, 7 + x literals
;   MMMM  0: no match; 1..14: a match of MMMM + 1 bytes; 15: next byte x,
;         a match of 16 + x bytes
;   R     1: the last offset again; 0: a new offset: b < 80h: b + 1, else
;         ((b & 7Fh) << 8 | next byte) + 1
;   T = 00h: escape: next byte 00h = end of the block, 01h = the stream goes
;         on at 8000h of the next bank, 02h (at a block's start) = a raw
;         block: its ops follow as they are, in this bank
; The last offset starts at 1 in every block. A token decodes at most 256
; bytes (g3lz.py caps literal runs and matches at 128). AF' holds the token
; only inside dz_need: nothing else in the player keeps a value in AF'.
; A raw block is interpreted from ROM (HL in page 2, where dz_buf's HL is in
; page 3): dz_dst = FFFFh and dz_end = 1, so dz_need and dz_idle do nothing;
; the ops a CALL runs are raw too, with dz_end = 2 until their end (ip_raw).

; dz_block: start the block at dz_src (bank curbank). HL = its first op, in
; dz_buf, or in ROM for a raw block.
dz_block:
        ld hl, (dz_src)
        ld a, (hl)
        or a
        jr nz, dzb_lz               ; a token
        inc hl
        ld a, (hl)
        inc hl
        dec a
        jr nz, dzb_raw              ; 00 02
        ld a, (curbank)             ; 00 01: on at 8000h of the next bank
        inc a
        call setbank2
        ld hl, 0x8000
        ld (dz_src), hl
        jr dz_block
dzb_raw:
        ld a, 1
        ld (dz_end), a
        ld de, 0xFFFF
        ld (dz_dst), de
        ret
dzb_lz: ld hl, 0xFFFF
        ld (dz_noff), hl            ; last offset = 1, negated
        xor a
        ld (dz_end), a
        ld hl, dz_buf
        ld (dz_dst), hl
        ret

; dz_idle: one token more, unless the block is decoded to its end (the page
; flip's wait). Changes AF, BC, DE, HL, AF'.
dz_idle:
        ld a, (dz_end)
        or a
        ret nz
        ld hl, (dz_dst)
        ld bc, 1                    ; dz_need(dz_dst, 1): exactly one token

; dz_need: HL = op in dz_buf, BC = bytes needed from there. Decodes whole
; tokens until dz_dst >= HL + BC, or to the end of the block. Keeps HL;
; changes AF, BC, DE, AF'.
dz_need:
        push hl
        add hl, bc
        ex de, hl                   ; DE = limit
        ld hl, (dz_dst)
        or a
        sbc hl, de
        jr nc, dz_done              ; already decoded
        ld a, (dz_end)
        or a
        jr nz, dz_done
        ld (dz_lim), de
        ld hl, (dz_src)
        ld de, (dz_dst)
        jr dz_tok1
dz_tok: call mus_hook               ; the MOD's poll, between two tokens (none
dz_tok1:                            ; before the first: dz_idle's one token)
        ld a, (hl)                  ; HL = compressed, DE = decoded
        inc hl
        or a
        jp z, dz_esc
        ld c, a
        ex af, af'                  ; A' = token
        ld a, c
        and 0xE0
        jr z, dz_nolit
        cp 0xE0
        jr z, dz_litx
        rlca
        rlca
        rlca
        ld c, a
        ld b, 0
dz_lit: ldir                        ; the literals
dz_nolit:
        ex af, af'                  ; A = token
        ld c, a
        and 0x0F
        jr z, dz_next               ; no match
        bit 4, c
        jr nz, dz_len               ; R: the last offset again
        ld a, (hl)                  ; a new offset d + 1, kept negated: ~d
        inc hl
        or a
        jp m, dz_off2
        cpl
        ld (dz_noff), a
        ld a, 0xFF
        ld (dz_noff + 1), a
        jr dz_len
dz_off2:
        cpl
        or 0x80
        ld (dz_noff + 1), a
        ld a, (hl)
        inc hl
        cpl
        ld (dz_noff), a
dz_len: ld a, c
        and 0x0F
        cp 15
        jr z, dz_mx
        inc a
        ld c, a
        ld b, 0
dz_copy:
        push hl
        ld hl, (dz_noff)
        add hl, de
        ldir                        ; the match (overlaps repeat, byte by byte)
        pop hl
dz_next:
        ld bc, (dz_lim)
        ld a, e
        sub c
        ld a, d
        sbc a, b
        jr c, dz_tok                ; below the limit: one more token
dz_save:
        ld (dz_src), hl
        ld (dz_dst), de
dz_done:
        pop hl
        ret
dz_mx:  ld b, 0                     ; long match: 16 + x
        ld a, (hl)
        inc hl
        add a, 16
        ld c, a
        jr nc, dz_copy
        inc b
        jr dz_copy
dz_litx:
        ld b, 0                     ; long literal run: 7 + x
        ld a, (hl)
        inc hl
        add a, 7
        ld c, a
        jr nc, dz_lit
        inc b
        jr dz_lit
dz_esc: ld a, (hl)
        inc hl
        or a
        jr z, dz_eob
        ld a, (curbank)             ; 01h: on at 8000h of the next bank
        inc a
        call setbank2
        ld hl, 0x8000
        jp dz_tok
dz_eob: ld a, 1                     ; 00h: the end of the block
        ld (dz_end), a
        jr dz_save

; ----------------------------------------------------------------------------
; Language menu. The picture is on page 0: each option's text uses its own
; palette entry (5, 6, 7) and so does its arrow (8, 9, 10), so the highlight
; is a palette change. Acts on new key presses only (keys already down when
; the menu appears are ignored), then waits until every key is up, so the
; choosing key does not also skip the first demo.
op_menu:
        xor a
        ld (menu_sel), a            ; English first
        dec a
        ld (menu_keys), a
        call menu_paint
mn_loop:
        call wait_frame
        call read_keys
        ld b, a
        ld a, (menu_keys)
        cpl
        and b                       ; A = keys pressed since the last scan
        ld c, a
        ld a, b
        ld (menu_keys), a
        ld a, c
        and 0x38                    ; 1 / 2 / 3: choose and go
        jr nz, mn_digit
        bit 0, c
        jr nz, mn_up
        bit 1, c
        jr nz, mn_down
        bit 2, c
        jr nz, mn_go
        jr mn_loop
mn_digit:
        ld b, 0                     ; lowest digit pressed: bit 3 = '1'
mn_dg1: bit 3, a
        jr nz, mn_dg2
        rrca
        inc b
        jr mn_dg1
mn_dg2: ld a, b
        ld (menu_sel), a
        call menu_paint
        jr mn_go
mn_up:
        ld a, (menu_sel)
        or a
        jr nz, mn_up1
        ld a, 3
mn_up1: dec a
        jr mn_new
mn_down:
        ld a, (menu_sel)
        inc a
        cp 3
        jr c, mn_new
        xor a
mn_new: ld (menu_sel), a
        call menu_paint
        jr mn_loop
mn_go:
        call wait_frame
        call read_keys
        or a
        jr nz, mn_go                ; until every key is up
mn_rest:
        ld a, 255
        call mod_upload_step        ; the MOD's samples not up yet, if the
        jr nz, mn_rest              ; choice came first (done ~2.0 s after the menu shows)
        ld a, (mp_ok)
        or a
        jr z, mn_r1
        ld a, 3
        ld (mus_target), a          ; a MoonSound for the MOD: it plays the music
mn_r1:  xor a
        ld (keyprev), a
        ld a, (menu_sel)
        add a, a
        ld e, a
        ld d, 0
        ld hl, lang_tables
        add hl, de
        ld e, (hl)
        inc hl
        ld d, (hl)
        ld (demo_base), de
        jp restart

; palette entries 5..7 (texts) and 8..10 (arrows): bright for the selection
menu_paint:
        ld a, 5
        ld b, 16
        call vdp_wreg               ; R#16 = 5, auto-increments per entry
        ld hl, mn_text
        call mn_three
        ld a, 8
        ld b, 16
        call vdp_wreg
        ld hl, mn_arrow
mn_three:                           ; HL = on (2 bytes), off (2 bytes)
        ld a, (menu_sel)
        ld d, a
        ld e, 0
mn_l:   push hl
        ld a, e
        cp d
        jr z, mn_on
        inc hl
        inc hl
mn_on:  ld a, (hl)
        out (VDP_PAL), a
        inc hl
        ld a, (hl)
        out (VDP_PAL), a
        pop hl
        inc e
        ld a, e
        cp 3
        jr c, mn_l
        ret

mn_text:  db 0x71, 0x06, 0x34, 0x03    ; on (7,6,1) yellow, off (3,3,4)
mn_arrow: db 0x71, 0x06, 0x00, 0x00    ; on yellow, off black (hidden)

; one vertical blank: S#0 bit7 (R#15 = 0), cleared by the read. Meanwhile
; the MOD goes up to the MoonSound a unit (1-2 ms) at a time: the tone
; headers, then the samples; done ~2.0 s after the menu shows (openMSX,
; Star Wars' 252 KB), so it is usually there before a language is chosen
; (without a MoonSound,
; mod_upload_step has nothing to do). Changes AF, BC, DE, HL, IY.
wait_frame:
        in a, (VDP_CTRL)
        rlca
        ret c
        ld a, 1
        call mod_upload_step
        jr wait_frame

; A = keys down: bit0 up, bit1 down, bit2 SPACE or RETURN, bit3..5 = 1, 2, 3
read_keys:
        xor a
        call key_row                ; row 0: bit1..3 = keys 1..3
        and 0x0E
        add a, a
        add a, a
        ld c, a
        ld a, 7
        call key_row                ; row 7: bit7 = RETURN
        and 0x80
        jr z, rk_1
        set 2, c
rk_1:   ld a, 8
        call key_row                ; row 8: bit0 SPACE, bit5 up, bit6 down
        ld b, a
        and 0x01
        jr z, rk_2
        set 2, c
rk_2:   ld a, b
        and 0x60
        rlca
        rlca
        rlca                        ; bit5 -> bit0, bit6 -> bit1
        or c
        ret

key_row:                            ; A = row; returns its keys, 1 = down
        ld b, a
        in a, (PPI_C)
        and 0xF0
        or b
        out (PPI_C), a
        in a, (PPI_B)
        cpl
        ret

; ----------------------------------------------------------------------------
; Music (data made by music.py). At power on: an OPL3 / OPL4 FM part at C4h
; answers the timer test -> OPL target; else a Konami SCC in some slot ->
; SCC target; else the PSG. The data of the chosen target sits in ROM banks
; and is read through page 2 (the stream's bank goes back after each tick).
; The SCC also lives in page 2, so its writes of a tick are buffered in RAM
; and applied with the SCC's slot switched in (ENASLT), then ours back.
;
; The MOD (geo3d_modplay.asm; the whole MOD and the player's tables after
; the music data, placed by modplay.py): when music_detect finds an OPL4,
; the MOD player's own detection (the MOD's header, the sample RAM its
; samples need) and the upload of its samples run while the language menu
; waits for its blanks (wait_frame, mod_upload_later; what is left when a
; language is chosen goes up before the crawl), and not at power on, so the
; menu shows as early as without it. With the MoonSound for the MOD (mp_ok)
; the target becomes 3 when the menu ends. The first crawl's MUSIC opcode
; then asks for the song (mod_go), which starts right after the next page
; flip (mod_start takes ~6 ms: behind the black screen before the crawl it
; would make the first flip a frame late); from there it plays for good,
; looping at the song's end (ProTracker's restart): demo_init does not stop
; it and a MUSIC finds it playing (mod_live). The old engine's music_tick
; has nothing to do then (mus_on = 0). mod_go1 points three RAM hooks
; (RET until then: the ROM runs as without a MoonSound, the same port
; traffic in the same time) at the MOD player:
;   mus_hook  JP mod_tpoll: before every opcode (interp), between two
;             tokens of the decoder, inside the uploads (op_vrle_f): a tick
;             that is due, 33 T (and the CALL) when none is.
;   hw_hook   JP mod_hw: the waits for geo3d's RUN (op_waitgeo) and for the
;             command engine (wait_ce, whose loop reads S#2): a tick that is
;             due, and one token more of the block (dz_idle), which the
;             hardware's time decodes ahead for the frames to come.
;   idle_hook JP mod_poll: the page flip's wait (fl_wait, between the
;             decoder's tokens): the work of the next tick too, a piece a
;             poll (a row read, a channel), so a tick's notes need only
;             their key ons when it is due.
; The uploads (VRLE, VMORE) run in op_vrle_f then, in about 70 % of
; op_vrle's time, with a poll every few RLE codes: what that saves pays for
; the MOD's work, so the frames whose length the upload sets (the black
; screens, tex's texture frame) end no later than without the MOD, and
; the flips paced by PACE stay on their blanks. That holds for a MOD whose
; work fits: build_rom.py measures the MOD's work per tick (modcost.py) and
; takes the MOD only if its heaviest stretch fits in the time each frame
; has to spare (openMSX, the MOD player's hooks without its work). In the
; frames an upload makes long (each demo's black screen, tex's textures) an
; EAGER has the busy code's polls work out the next tick at once (mod_poll):
; their notes keep their time. With Star Wars (run_rom_z80.py --moonsound
; --cycles 3): a tick is played within ~4.8 ms of its timer (0.65 ms for
; 99 % of them), a key on within ~5 ms (openMSX, 230 s: 2.2 ms), none is
; lost; the longest time between two polls is ~6.4 ms.
; The hooks keep every register but AF (no caller keeps a value in A or
; the flags across them), leave page 2 on bank curbank (mp_restbank) and
; do not touch the VDP.

music_detect:
        call mod_reset              ; the MOD player: nothing to play or upload
        xor a
        ld (mus_on), a
        ld (mus_target), a          ; PSG
        ld (opl4), a
        ld hl, scc_buf
        ld (scc_end), hl
        dec a
        ld (scc_slot), a
        call opl_detect
        jr nz, md_scc
        ld a, 2
        ld (mus_target), a
        ; an OPL4 (MoonSound) answers device ID 001 in wave register 2
        ; (ports 7Eh/7Fh), which it only selects with NEW2 = 1 (FM bank 1,
        ; register 05h = 03h; an OPL3 ignores that bit). Its FM part runs at
        ; 49517 Hz instead of the OPL3's 49716 Hz, so key on raises the
        ; F-number by 1/256. BUSY is only valid with NEW2 = 1: pauses (ex
        ; (sp), hl) give a faster CPU's writes to register 105h time.
        ld a, 5
        out (OPL_A1), a
        ex (sp), hl
        ex (sp), hl
        ld a, 3
        out (OPL_D1), a             ; NEW = NEW2 = 1
        ex (sp), hl
        ex (sp), hl
        ld a, 2
        out (0x7E), a
        ex (sp), hl                 ; let the register select settle
        ex (sp), hl
        in a, (0x7F)
        and 0xE0
        ld b, a
        ld a, 5
        out (OPL_A1), a
        ex (sp), hl
        ex (sp), hl
        xor a
        out (OPL_D1), a             ; NEW = NEW2 = 0 (the music sets NEW)
        ld a, b
        cp 0x20
        ret nz
        ld a, 1
        ld (opl4), a
        ; a MoonSound with the sample RAM for the MOD's samples plays the MOD
        ; itself: found, and its samples uploaded, during the language menu
        ; (mn_rest sets the target then); else its FM part plays the
        ; conversion
        ld a, MOD_SONG
        or a
        ret z
        jp mod_upload_later
md_scc: call scc_detect
        ld a, (scc_slot)
        inc a
        ret z                       ; no SCC: PSG
        ld a, 1
        ld (mus_target), a
        ret

; Z = an OPL3/OPL4 FM part: timer 1 (80 us) must raise status bits 7 and 6.
; No BUSY polling here: an empty port reads FFh.
opl_detect:
        ld c, 4
        ld a, 0x60
        call od_w                   ; reset both timers
        ld a, 0x80
        call od_w                   ; reset the IRQ flags
        in a, (OPL_A0)
        and 0xE0
        ret nz                      ; flags up without a timer: not an OPL
        ld c, 2
        ld a, 0xFF
        call od_w                   ; timer 1: one step to overflow
        ld c, 4
        ld a, 0x21
        call od_w                   ; start timer 1, timer 2 masked
        ld b, 0
od_1:   djnz od_1                   ; ~1 ms
        in a, (OPL_A0)
        and 0xE0
        ld b, a
        ld a, 0x60
        call od_w
        ld a, 0x80
        call od_w
        ld a, b
        cp 0xC0
        ret
od_w:   push af
        ld a, c
        out (OPL_A0), a
        pop af
        out (OPL_D0), a
        ret

; scans every slot and subslot of page 2 for a Konami SCC: 9800h must be
; read-only with the SCC off (9000h = 0) and writable with it on (3Fh).
; RAM (writable both ways) and ROM (neither) are left as they were.
scc_detect:
        ld b, 0
sd_p:   push bc
        ld a, b
        ld hl, EXPTBL
        add a, l
        ld l, a
        ld a, (hl)
        and 0x80
        or b
        ld c, a                     ; slot with the expanded flag
        jp p, sd_one
        ld d, 0
sd_s:   ld a, d
        add a, a
        add a, a
        or c
        push bc
        push de
        call scc_test
        pop de
        pop bc
        jr z, sd_found
        inc d
        ld a, d
        cp 4
        jr c, sd_s
        jr sd_next
sd_one: ld a, c
        call scc_test
        jr z, sd_found
sd_next:
        pop bc
        inc b
        ld a, b
        cp 4
        jr c, sd_p
        ret
sd_found:
        pop bc
        ret

scc_test:                           ; A = slot; Z = SCC there; page 2 back to us
        ld (scc_try), a
        ld h, 0x80
        call ENASLT
        di
        ld hl, 0x9800
        ld a, (0x9000)
        ld e, a                     ; what was at 9000h (RAM)
        xor a
        ld (0x9000), a              ; SCC off (a Konami mapper switches bank here)
        ld d, (hl)                  ; 9800h as it reads now, after the switch
        ld a, d
        cpl
        ld (hl), a
        cp (hl)
        jr z, st_ram                ; writable with the SCC off: not an SCC
        ld a, 0x3F
        ld (0x9000), a              ; SCC on
        ld a, (hl)
        ld d, a
        cpl
        ld (hl), a
        cp (hl)
        ld (hl), d
        jr nz, st_no
        ld a, (scc_try)
        ld (scc_slot), a
        call slot_back
        xor a
        ret
st_ram: ld (hl), d
        ld a, e
        ld (0x9000), a
st_no:  call slot_back
        or 1
        ret

slot_back:                          ; page 2 = this cartridge again
        ld a, (my_slot)
        ld h, 0x80
        call ENASLT
        di
        ret

; MUSIC opcode: start the MOD, or the chosen target's data (music_table:
; bank FFh = the ROM was built without music)
music_start:
        ld a, (mus_target)
        cp 3
        jr z, ms_mod
        ld e, a
        add a, a
        add a, e
        ld e, a
        ld d, 0
        ld hl, music_table
        add hl, de
        ld a, (hl)
        cp 0xFF
        ret z
        ld (mus_bank), a
        inc hl
        ld e, (hl)
        inc hl
        ld d, (hl)
        ld (mus_ptr), de
        xor a
        ld (mus_wait), a
        ld a, (mus_target)
        cp 1
        jr nz, ms_on
        ld a, (scc_slot)
        ld h, 0x80
        call ENASLT
        di
        ld a, 0x3F
        ld (0x9000), a              ; SCC registers at 9800h
        call slot_back
ms_on:  ld a, 1
        ld (mus_on), a
        ret
ms_mod: ld a, (mod_live)            ; the MOD from its first tick, right after
        or a                        ; the next page flip (mod_go1); when the
        ret nz                      ; sequence comes round again it plays on
        inc a
        ld (mod_go), a
        ret

mod_go1:                            ; the MOD starts (the upload ended with the menu)
        push hl                     ; and plays for good
        xor a
        ld (mod_go), a
        call mod_start
        ld hl, mod_tpoll            ; where the CPU is busy: its ticks
        ld (mus_hook + 1), hl
        ld hl, mod_poll             ; where it waits for a blank: the work
        ld (idle_hook + 1), hl      ; of the next tick too
        ld hl, mod_hw               ; where it waits for geo3d or the command
        ld (hw_hook + 1), hl        ; engine: its ticks, and the block ahead
        ld hl, op_vrle_f
        ld (vrle_jp + 1), hl
        ld hl, op_vmore_f
        ld (vmore_jp + 1), hl
        ld a, 0xC3
        ld (mus_hook), a            ; JP: every wait polls its timer
        ld (hw_hook), a
        ld (idle_hook), a
        ld a, 1
        ld (mod_live), a
        pop hl
        ret

; stop and silence every chip of the target
music_stop:
        xor a
        ld (mus_on), a
        ld (mod_go), a
        call psg_silence
        ld a, (mus_target)
        cp 1
        jr z, mstop_scc
        cp 2                        ; (3: the MOD plays on, through every demo)
        ret nz
        ld e, 0                     ; OPL: key off all 18 channels
mstop_o:
        ld a, e
        call opl_chan
        ld a, 0xB0
        add a, b
        ld c, a
        xor a
        call opl_w
        inc e
        ld a, e
        cp 18
        jr c, mstop_o
        ret
mstop_scc:
        ld a, (scc_slot)
        ld h, 0x80
        call ENASLT
        di
        xor a
        ld (0x988F), a              ; all SCC channels off
        jp slot_back
psg_silence:
        ld a, 7
        out (PSG_A), a
        ld a, 0xBF                  ; tones and noise off; bit7 = 1 (port B output)
        out (PSG_D), a
        ld b, 8
psl:    ld a, b
        out (PSG_A), a
        xor a
        out (PSG_D), a
        inc b
        ld a, b
        cp 11
        jr c, psl
        ret

; one tick of music (called once per vertical blank); keeps every register
music_tick:
        push af
        ld a, (mus_on)
        or a
        jp z, mt_off
        push bc
        push de
        push hl
        ld a, (mus_wait)
        or a
        jr z, mt_run
        dec a
        ld (mus_wait), a
        jp mt_ret
mt_run: ld a, (mus_bank)
        call bank2_raw              ; music data in page 2
        ld hl, (mus_ptr)
mt_op:  ld a, (hl)
        inc hl
        cp 0x0E
        jr c, mt_psg
        cp 0x20
        jr c, mt_sreg
        cp 0x24
        jr c, mt_swav
        cp 0x30
        jr z, mt_opl0
        cp 0x31
        jr z, mt_opl1
        cp 0x52
        jp c, mt_kon                ; 40h-51h
        cp 0x72
        jp c, mt_koff               ; 60h-71h
        cp 0xFD
        jp c, mt_wait               ; 80h-FCh
        cp 0xFE
        jp z, mt_nextb
        ; FFh: the end
        ld a, (curbank)
        call bank2_raw
        call music_stop
        jp mt_ret
mt_psg: out (PSG_A), a
        ld a, (hl)
        inc hl
        out (PSG_D), a
        jr mt_op
mt_sreg:
        add a, 0x70                 ; 10h-1Fh -> 80h-8Fh (9880h-988Fh)
        ld c, a
        ld a, (hl)
        inc hl
        call scc_put
        jr mt_op
mt_swav:
        sub 0x20
        rrca
        rrca
        rrca                        ; channel * 32
        ld c, a
        ld b, 32
mt_sw1: ld a, (hl)
        inc hl
        call scc_put
        inc c
        djnz mt_sw1
        jr mt_op
mt_opl0:
        ld d, 0
        jr mt_oplw
mt_opl1:
        ld d, 1
mt_oplw:
        ld c, (hl)
        inc hl
        ld a, (hl)
        inc hl
        call opl_w
        jr mt_op
mt_kon: sub 0x40                    ; A0 = a, carrier TL = t, B0 = b (key on)
        ld e, a
        ld a, (hl)
        inc hl
        ld (kon_lo), a
        ld a, (hl)
        inc hl
        ld (kon_b0), a
        ld a, (opl4)
        or a
        call nz, opl4_tune
        ld a, e
        call opl_chan
        ld a, 0xA0
        add a, b
        ld c, a
        ld a, (kon_lo)
        call opl_w                  ; F-number low
        ld a, (kon_b0)
        push af                     ; B0 value
        push hl
        ld hl, car_off
        ld a, l
        add a, b
        ld l, a
        jr nc, mt_k1
        inc h
mt_k1:  ld a, (hl)
        add a, 0x40
        ld c, a
        pop hl
        ld a, (hl)
        inc hl
        call opl_w                  ; carrier TL
        pop af
        push hl
        ld hl, opl_b0
        ld c, e
        ld b, 0
        add hl, bc
        ld (hl), a
        pop hl
        push af
        ld a, e
        call opl_chan
        ld a, 0xB0
        add a, b
        ld c, a
        pop af
        call opl_w                  ; key on
        jp mt_op
mt_koff:
        sub 0x60
        ld e, a
        push hl
        ld hl, opl_b0
        ld c, a
        ld b, 0
        add hl, bc
        ld a, (hl)
        and 0xDF
        ld (hl), a
        pop hl
        push af
        ld a, e
        call opl_chan
        ld a, 0xB0
        add a, b
        ld c, a
        pop af
        call opl_w
        jp mt_op
mt_nextb:
        ld a, (mus_bank)
        inc a
        ld (mus_bank), a
        call bank2_raw
        ld hl, 0x8000
        jp mt_op
mt_wait:
        sub 0x80
        ld (mus_wait), a            ; op 7Fh + n: this tick and n - 1 more
        ld (mus_ptr), hl
        ld a, (curbank)
        call bank2_raw              ; the stream's bank back
        call scc_flush
mt_ret: pop hl
        pop de
        pop bc
mt_off: pop af
        ret

scc_put:                            ; buffer SCC write: C = offset (98xxh), A = value
        push hl
        ld hl, (scc_end)
        ld (hl), c
        inc hl
        ld (hl), a
        inc hl
        ld (scc_end), hl
        pop hl
        ret

scc_flush:                          ; apply the buffered SCC writes
        ld hl, (scc_end)
        ld de, scc_buf
        or a
        sbc hl, de
        ret z
        ld a, (scc_slot)
        ld h, 0x80
        call ENASLT
        di
        ld hl, scc_buf
        ld d, 0x98
sf_1:   ld e, (hl)
        inc hl
        ld a, (hl)
        inc hl
        ld (de), a
        push hl
        ld bc, (scc_end)
        or a
        sbc hl, bc
        pop hl
        jr c, sf_1
        ld hl, scc_buf
        ld (scc_end), hl
        jp slot_back

opl4_tune:                          ; F-number += F-number >> 8 (the data is for
        ld a, (kon_b0)              ; 49716 Hz; +0.26..0.39% for 49517 Hz)
        and 3
        ld c, a
        ld a, (kon_lo)
        add a, c
        ld (kon_lo), a
        ret nc
        ld a, (kon_b0)
        ld c, a
        and 3
        cp 3
        jr z, ot_max
        inc c                       ; carry into F-number bits 8-9
        ld a, c
        ld (kon_b0), a
        ret
ot_max: ld a, 0xFF                  ; already at the top: stay at 1023
        ld (kon_lo), a
        ret

opl_chan:                           ; A = channel 0..17 -> B = index 0..8, D = bank
        ld d, 0
        cp 9
        jr c, oc_1
        sub 9
        inc d
oc_1:   ld b, a
        ret

opl_w:                              ; D = bank, C = register, A = value
        push af
ow_1:   in a, (OPL_A0)              ; OPL4: wait while BUSY
        rrca
        jr c, ow_1
        ld a, c
        bit 0, d
        jr nz, ow_b1
        out (OPL_A0), a
ow_2:   in a, (OPL_A0)
        rrca
        jr c, ow_2
        pop af
        out (OPL_D0), a
        ret
ow_b1:  out (OPL_A1), a
ow_3:   in a, (OPL_A0)
        rrca
        jr c, ow_3
        pop af
        out (OPL_D1), a
        ret

car_off:                            ; carrier operator of channel index 0..8
        db 0x03, 0x04, 0x05, 0x0B, 0x0C, 0x0D, 0x13, 0x14, 0x15

; ----------------------------------------------------------------------------
setbank2:                           ; A = bank for page 2 (the stream's)
        ld (curbank), a
bank2_raw:                          ; A = bank for page 2, curbank kept (music data)
mp_setbank:                         ; (the MOD player's data too)
        ld (BANK2_SEL), a
        ret

mp_restbank:                        ; the MOD player is done with page 2: the
        ld a, (curbank)             ; stream's bank back
        jr bank2_raw

vdp_wreg:                           ; A = value, B = register
        out (VDP_CTRL), a
        ld a, b
        or 0x80
        out (VDP_CTRL), a
        ret

wait_ce:                            ; S#2 bit0 = CE; leaves R#15 = 0. Keeps HL
        ld a, 2
        ld b, 15
        call vdp_wreg
        in a, (VDP_CTRL)
        rrca
        jr nc, wc2
        call wait_limit             ; (busy: the polls as op_waitgeo's)
wc1:    call hw_hook                ; (S#2 is selected: no hook reads the VDP)
        in a, (VDP_CTRL)
        rrca
        jr nc, wc2
        dec de
        ld a, d
        or e
        jr nz, wc1
        djnz wc1
        jp hw_timeout               ; CE up for ~3 s: the V9968 stopped answering
wc2:    xor a
        ld b, 15
        jp vdp_wreg

; the time limit of the waits for geo3d and for the command engine: B turns
; of DE polls (DE = 0: 65536) until hw_timeout, about 3 s on a 3.58 MHz Z80
; either way: WAIT_TURNS x 65536 polls, or WAIT_MOD while the MOD plays
; (the MOD player's poll in hw_hook makes each one about 3 times as long)
wait_limit:
        ld b, WAIT_TURNS
        ld de, 0
        ld a, (mod_live)
        or a
        ret z
        ld b, 1
        ld de, WAIT_MOD
        ret

; HL = palette (32 bytes). SCREEN 5 on the V9968, V9968 mode (LRMM,
; 256 KB), high-speed commands, full LRMM window, both pages cleared.
demo_init:
        push hl
        ld a, 2
        ld (flip_n), a              ; 30 fps unless the stream says PACE
        call wait_ce
        xor a
        out (VDP_PORT4), a          ; bit7 = 0: unlock R#20 / R#21
        call music_stop             ; every demo starts silent
        ld hl, init_regs
di_1:   ld a, (hl)
        cp 0xFF
        jr z, di_2
        ld b, a
        inc hl
        ld a, (hl)
        inc hl
        call vdp_wreg
        jr di_1
di_2:   xor a
        ld b, 21
        call vdp_wreg               ; R#21 = 0: V9968 mode
        ld a, 1
        ld b, 20
        call vdp_wreg               ; R#20 = 1: high-speed commands
        ld a, 51
        ld b, 17
        call vdp_wreg
        ld hl, window_regs
        ld bc, 8 * 256 + VDP_IND
        otir                        ; R#51..58: window 0..511 x 0..2047
        xor a
        ld b, 16
        call vdp_wreg
        pop hl
        ld bc, 32 * 256 + VDP_PAL
        otir
        ld a, 36
        ld b, 17
        call vdp_wreg
        ld hl, clear_cmd
        ld bc, 11 * 256 + VDP_IND
        otir                        ; HMMV pages 0 and 1 to black
        jp wait_ce

init_regs:
        db 0, 0x06                  ; GRAPHIC4 (SCREEN 5)
        db 1, 0x40                  ; display on, no interrupts
        db 2, 0x1F                  ; page 0
        db 7, 0x00                  ; border
        db 8, 0x0A                  ; sprites off
        db 9, 0x80                  ; 212 lines
        db 15, 0x00                 ; status register 0
        db 0xFF

window_regs:
        db 0, 0, 0, 0, 0xFF, 0x01, 0xFF, 0x07

; ----------------------------------------------------------------------------
; geo_probe: geo3d at PORT_BASE? As geo3d BASIC's detect (g3basic.asm), at
; this ROM's base only: reads only, until geo3d is identified.
;  1. 98h (the emulator profile): not on an MSX1 (MSXVER = 0), whose TMS9918
;     would take the R#15 write below as a write to R#7.
;  2. S#1 through P+1: a V99x8 answers with its ID, 0 (V9938), 2 (V9958, or
;     a V9968 in V9958 mode) or 3 (a V9968 in V9968 mode); a port where
;     nothing answers reads FFh (ID 1Fh). ng_vdp = 1 for ID 0, 2 and 3: the
;     message picture can go there. geo3d needs ID 2 or 3.
;  3. With R#15 = 2: P+5 must not read FFh (HRA!'s bitstream without geo3d
;     drives FFh there; an empty port reads FFh too) nor have bits 3-2 = 11
;     (a VDP whose ports repeat at P+4..P+7 returns S#2 there, whose bits
;     3-2 always read 1; geo3d idle reads 00h). Only then P+4 is read
;     (through such a repeat it would be a VRAM read): PORT#4 must have
;     bits 6-3 = 0.
;  4. The first write: index 40h to P+5, then 17 reads of P+7: LOP (45h)
;     has 4 bits, YPAGE (46h-47h) 11 bits, and the read pointer wraps back
;     to 40h (the 17th read equals the first).
; Z: geo3d found. Changes AF, BC, DE.
geo_probe:
        xor a
        ld (ng_vdp), a
        if PORT_BASE == 0x98
        ld a, (MSXVER)
        or a
        jr z, gp_no                 ; an MSX1: a TMS9918 at 98h
        endif
        ld a, 1
        ld b, 15
        call vdp_wreg               ; R#15 = 1
        in a, (VDP_CTRL)            ; S#1 = FL LPS ID4-ID0 FH
        ld e, a
        xor a
        ld b, 15
        call vdp_wreg               ; R#15 = 0
        ld a, e
        rrca
        and 0x1F                    ; the ID
        ld d, a
        cp 1
        jr z, gp_no                 ; (a V9948)
        cp 4
        jr nc, gp_no                ; not a V99x8 (nothing there: 1Fh)
        ld a, 1
        ld (ng_vdp), a              ; a V99x8: the message picture can go there
        ld a, d
        or a
        jr z, gp_no                 ; a V9938: no geo3d next to it
        ld a, 2
        ld b, 15
        call vdp_wreg               ; R#15 = 2
        in a, (GEO_IDX)             ; P+5
        ld e, 0xFF                  ; E = PORT#4: FFh (fails) unless read below
        cp 0xFF
        jr z, gp_1                  ; FFh: no geo3d
        and 0x0C
        cp 0x0C
        jr z, gp_1                  ; S#2 of a VDP repeated at P+4..P+7
        in a, (VDP_PORT4)
        ld e, a                     ; PORT#4
gp_1:   xor a
        ld b, 15
        call vdp_wreg               ; R#15 = 0
        ld a, e
        and 0x78
        jr nz, gp_no
        ld a, 0x40
        out (GEO_IDX), a            ; the first geo3d write: index 40h (VADDR)
        in a, (GEO_DAT)             ; 40h VADDR
        ld d, a
        in a, (GEO_DAT)             ; 41h EADDR
        in a, (GEO_DAT)             ; 42h NVERT
        in a, (GEO_DAT)             ; 43h NEDGE
        in a, (GEO_DAT)             ; 44h COLOR
        in a, (GEO_DAT)             ; 45h LOP
        and 0xF0
        jr nz, gp_no
        in a, (GEO_DAT)             ; 46h YPAGE
        in a, (GEO_DAT)             ; 47h
        and 0xF8
        jr nz, gp_no
        ld b, 8
gp_2:   in a, (GEO_DAT)             ; 48h status, 49h version, 4Ah-4Fh counters
        djnz gp_2
        in a, (GEO_DAT)             ; 40h again
        cp d
        ret                         ; Z: geo3d
gp_no:  or 0xFF                     ; NZ: no geo3d
        ret

; ----------------------------------------------------------------------------
; "geo3d not found" (in English, Español and Português), and the ROM stays
; there. From here on no geo3d port is written, and only hw_timeout reads
; geo3d's status (P+5, no side effects).
;   hw_timeout  a wait for geo3d's RUN or for the command engine's CE ran
;               out of time (wait_limit): the music stops (the MOD's
;               channels and timer, and its flags, so that the BIOS's EI
;               below meets no pending interrupt), the command engine gets
;               STOP (R#46 = 0: a command left hanging ends). geo3d waits
;               for CE = 0 before each command it writes, so a geo3d held
;               up by a hanging command goes on with the rest of its frame
;               once the STOP frees the command engine: the picture waits
;               for geo3d's RUN to end (up to 32768 reads of P+5, ~0.55 s
;               on a 3.58 MHz Z80), so that nothing of that frame is drawn
;               over it, then a second STOP ends geo3d's last command. A
;               RUN that does not end (geo3d itself hung) gets no second
;               STOP, which could free geo3d again while the picture goes
;               up. (The first STOP breaks the R#32-R#58 rule only in
;               theory: geo3d writes no register while CE is up or while it
;               is hung.) Then the message.
;   nogeo       geo_probe found no geo3d at power on (nothing played yet).
; The message goes:
;   - to the VDP at PORT_BASE when geo_probe found a V99x8 there (ng_vdp):
;     a SCREEN 5 picture (build_rom.py nogeo_page) uploaded by a stream of
;     VRLE ops ending with STOP, as the menu's picture, with registers any
;     V99x8 takes (no V9968 register, no command, no PORT#4 write);
;   - 88h profile: also to the MSX's own screen, through the BIOS (INITXT,
;     CHPUT: the machine's font, plain ASCII, ng_msg), the only message
;     when no VDP answers at 88h (no cartridge, or its DIP switch at 98h);
;     98h profile: there only when no V99x8 answers at 98h (an MSX1).
hw_timeout:
        di
        ld sp, 0xF000
        call mod_stop               ; (nothing when the MOD does not play)
        call music_stop
        xor a
        ld b, 46
        call vdp_wreg               ; R#46 = 0: STOP
        ld de, 0x8000
ht_1:   in a, (GEO_IDX)             ; geo3d's status
        rrca
        jr nc, ht_2                 ; bit0 = RUN busy: over
        dec de
        ld a, d
        or e
        jr nz, ht_1
        jr nogeo                    ; geo3d hung: no second STOP
ht_2:   xor a
        ld b, 46
        call vdp_wreg               ; R#46 = 0: geo3d's last command ends
nogeo:
        di
        ld sp, 0xF000
        ld a, 0xC9
        ld (mus_hook), a            ; RET: no poll of the MOD player
        ld (hw_hook), a
        ld (idle_hook), a
        ld hl, op_vrle              ; the uploads as without the MOD
        ld (vrle_jp + 1), hl
        ld hl, op_vmore
        ld (vmore_jp + 1), hl
        if PORT_BASE == 0x88
        call ng_text                ; the MSX's own screen
        di
        endif
        ld a, (ng_vdp)
        or a
        jr nz, ng_pic
        if PORT_BASE == 0x98
        call ng_text                ; an MSX1: its own screen only
        endif
        di
        jr ng_stay
ng_pic: ld hl, ng_regs
ngp_1:  ld a, (hl)
        cp 0xFF
        jr z, ngp_2
        ld b, a
        inc hl
        ld a, (hl)
        inc hl
        call vdp_wreg
        jr ngp_1
ngp_2:
        if PORT_BASE == 0x98
        ld a, (RG9SAV)              ; the machine's own VDP: its NT bit as the
        and 0x02                    ; BIOS set it (50 Hz on a PAL machine)
        or 0x80                     ; 212 lines
        ld b, 9
        call vdp_wreg
        endif
        ld hl, pal_nogeo
        ld bc, 32 * 256 + VDP_PAL
        otir                        ; (R#16 = 0 in ng_regs)
        ld hl, nogeo_entry          ; the picture: bank, stream (a raw block)
        ld a, (hl)
        call setbank2
        inc hl
        ld e, (hl)
        inc hl
        ld d, (hl)
        ld (dz_src), de
        call dz_block
        jp interp                   ; its VRLE ops, then STOP

; STOP: the end of the message picture's stream: display on, and here the
; ROM stays (interrupts off, no port access)
op_stop:
        ld a, 0x40
        ld b, 1
        call vdp_wreg               ; R#1: display on, no interrupts
        di
ng_stay:
        jr ng_stay

; SCREEN 5 on page 0, the display off while the picture goes up
ng_regs:
        db 1, 0x00                  ; display off, no interrupts
        db 0, 0x06                  ; GRAPHIC4 (SCREEN 5)
        db 2, 0x1F                  ; page 0
        db 7, 0x00                  ; border
        db 8, 0x0A                  ; sprites off
        if PORT_BASE == 0x88
        db 9, 0x80                  ; 212 lines, 60 Hz (as the demos)
        endif                       ; (98h: R#9 after the table, NT kept)
        db 23, 0x00                 ; no vertical scroll
        db 15, 0x00                 ; status register 0
        db 16, 0x00                 ; palette from entry 0
        db 0xFF

; the message on the MSX's own screen: SCREEN 0 (INITXT), then ng_msg
; (rom_tables.asm) through CHPUT, which keeps every register. The BIOS
; enables interrupts: nothing of this ROM raises one (the V9968's are off,
; the MOD's timer is stopped and its flags cleared).
ng_text:
        call INITXT
        ld hl, ng_msg
ngt_1:  ld a, (hl)
        or a
        ret z
        call CHPUT
        inc hl
        jr ngt_1

clear_cmd:
        dw 0, 0, 256, 512           ; DX, DY, NX, NY
        db 0x00, 0x00, 0xC0         ; CLR, ARG, HMMV

; ----------------------------------------------------------------------------
; VRLE and VMORE while the MOD plays (vrle_jp and vmore_jp lead here from
; mod_go1 on): the same port traffic as op_vrle and op_vmore, in about 70 %
; of their time, with polls inside. The MOD's own work (about 15 % of the
; CPU) would otherwise make the long uploads longer (the setups behind the
; black screens, tex's texture frame: 0.4-0.8 s), and without polls it
; would lose ticks in them. A literal of n bytes jumps into unrolled OUTIs
; (18 T a byte and 71 T a code, against OTIR's 23 and 105), a run into
; unrolled OUT (C),As (14 T a byte and 104 T a code, against 26 and 107):
; both slower than the V99x8 takes VRAM writes with sprites off (its longest
; wait for an access slot, 76 VDP cycles, is 12.7 T). A poll every VF_RUNS
; runs, and one in each literal of 128 bytes (a literal only follows one of
; 128 bytes): usually well under 1 ms apart, ~6 ms at most (runs of 129
; bytes in a row). Registers in the loop: HL the data, E the
; end's low byte (vf_endh the high one), D runs until the next poll, C the
; VDP's data port, IXH / IYH the pages of the two tables (IXL / IYL the
; entry: the code's complement).
VF_RUNS:    equ 8

op_vrle_f:
        ld a, (dz_end)              ; (as op_vrle)
        or a
        jr nz, vf_adr
        push hl
        inc hl
        inc hl
        inc hl
        ld c, (hl)
        inc hl
        ld b, (hl)
        ld hl, 5
        add hl, bc
        ld b, h
        ld c, l
        pop hl
        call dz_need
vf_adr: ld e, (hl)                  ; A7..A0
        inc hl
        ld d, (hl)                  ; A15..A8
        inc hl
        ld a, (hl)                  ; A17..A16
        inc hl
        add a, a
        add a, a
        ld b, a
        ld a, d
        rlca
        rlca
        and 3
        or b
        out (VDP_CTRL), a
        ld a, 0x80 + 14
        out (VDP_CTRL), a
        ld a, e
        out (VDP_CTRL), a
        ld a, d
        and 0x3F
        or 0x40
        out (VDP_CTRL), a
op_vmore_f:                         ; (VMORE: its length is where the VRLE's is)
        ld e, (hl)
        inc hl
        ld d, (hl)                  ; DE = packed length
        inc hl
        ld a, d
        or e
        jp z, interp
        ex de, hl
        add hl, de                  ; HL = the end
        ld a, h
        ld (vf_endh), a
        ld a, l
        ex de, hl
        ld e, a
        ld d, VF_RUNS
        ld c, VDP_DATA
        ld a, vf_lit / 256
        ld ixh, a
        ld a, vf_run / 256
        ld iyh, a
        jp vf_next

vf_o8:  macro
        outi
        outi
        outi
        outi
        outi
        outi
        outi
        outi
        endm
vf_c8:  macro
        out (c), a
        out (c), a
        out (c), a
        out (c), a
        out (c), a
        out (c), a
        out (c), a
        out (c), a
        endm

        ; the literals: code k (n = k + 1 bytes) enters at xx01h + 254 - 2k,
        ; so that n OUTIs follow (xx01h: 128 bytes, a poll after the first)
        ds (0xF9 - ($ & 0xFF)) & 0xFF, 0
vf_l128:
        outi
        call mus_hook
        jp vf_lit + 2
vf_lit: jr vf_l128                  ; (at xx01h)
        vf_o8
        vf_o8
        vf_o8
        vf_o8
        vf_o8
        vf_o8
        vf_o8
        vf_o8
        vf_o8
        vf_o8
        vf_o8
        vf_o8
        vf_o8
        vf_o8
        vf_o8
        outi
        outi
        outi
        outi
        outi
        outi
        outi
vf_next:                            ; the next code: the end? a literal? a run?
        ld a, l
        cp e
        jr z, vf_end1
vf_go:  ld a, (hl)
        inc hl
        add a, a
        jr c, vf_r
        cpl                         ; a literal
        ld ixl, a
        jp (ix)
vf_r:   cpl                         ; a run: code 80h + k (n = k + 2 bytes)
        ld iyl, a                   ; enters at yy01h + 256 - 2k
        ld a, (hl)
        inc hl
        jp (iy)
vf_end1:
        ld a, (vf_endh)             ; the end's low byte: the end?
        cp h
        jp z, interp
        jr vf_go

        ; the runs: 129 OUT (C),A from yy01h
        ds (0x01 - ($ & 0xFF)) & 0xFF, 0
vf_run: vf_c8
        vf_c8
        vf_c8
        vf_c8
        vf_c8
        vf_c8
        vf_c8
        vf_c8
        vf_c8
        vf_c8
        vf_c8
        vf_c8
        vf_c8
        vf_c8
        vf_c8
        vf_c8
        out (c), a
        dec d                       ; (after a run) a poll every VF_RUNS runs
        jr z, vf_poll
vf_n2:  ld a, l                     ; then as vf_next
        cp e
        jr z, vf_end2
vf_go2: ld a, (hl)
        inc hl
        add a, a
        jp c, vf_r
        cpl
        ld ixl, a
        jp (ix)
vf_end2:
        ld a, (vf_endh)
        cp h
        jp z, interp
        jr vf_go2
vf_poll:
        ld d, VF_RUNS
        call mus_hook
        jr vf_n2

        include "geo3d_modplay.asm"
        include "rom_tables.asm"
