alexmoncks/V9968_Cartridge/(commit log)

2026-09-23 top: wire geo3d to the slot bus and the VDP command port
2026-09-23 geo3d: demo animation and frames
2026-09-23 geo3d: README, longest frame measured over the full 130-frame system run (4.1 ms)
    Claude-Session: https://claude.ai/code/session_01RYWJ3BV9AUfPQ76MQzLc2T
2026-09-23 geo3d: showcase scenes and a MegaROM with all demos for real hardware
    - showcase/: pan and zoom, perspective text crawl (light level as texture
    bank, LRMM window for transparency), letters flying in over a SCREEN 5
    background; engine RTL == model on every frame, sampled frames end to end
    on HRA!'s vdp_command.v == model
    - sim/hra/check_lrmm.py: TIMP is tested on the whole CLR byte by
    vdp_command.v (LINE and LRMM outside the window); model fixed, random
    test now covers full-byte CLR
    - rom/: ASCII16 MegaROM player (769 bytes) + stream builder; six demos in a
    loop, space bar skips; every demo's traffic checked in a Z80 emulator
    against the verified traffic
    - README, run_all.sh, .g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
    [build_rom.py, check_lrmm.py, geo3d_rom.asm, run_rom_z80.py]
2026-09-24 geo3d: ROM language menu, crawl at 0.7 speed, music on PSG / SCC / OPL4
    - Language menu at power on (English, Español, Português; 1/2/3 or
    cursor + SPACE/RETURN): the crawl, the only text in the demos, is built
    in the three languages and each language has its own demo table.
    - Crawl 30% slower: one texture row per frame as before, page flips every
    3,3,3,2,... vertical blanks (new PACE opcode), so every frame stays one
    of the verified full-speed frames.
    - Music from the start of the crawl: rom/music.py converts a MIDI file
    (build_rom.py --music) for the PSG, SCC + PSG and OPL4/OPL3 FM + PSG;
    the player detects the chips at power on (OPL4 ID, OPL timer test, SCC
    slot scan), tic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
    [build_rom.py, geo3d_rom.asm, music.py, run_rom_z80.py]
2026-09-24 geo3d: demo page with GIFs in English, Portuguese and Spanish
    geo3d/demos/README.md (English), README.pt.md and README.es.md: the
    language menu, the six demos, the music, how to run the ROM in openMSX
    and on real hardware, how to build and check it. Every GIF in
    geo3d/demos/img/ was captured from GEO3D_98.ROM running in openMSX (V9968
    fork with the geo3d device), page flip by page flip, with the real
    palette and timing: the menu, the crawl in the three languages, the
    wireframe, solid, textured, pan and zoom and fly-in demos.
2026-09-24 geo3d: README with the demo GIFs and an openMSX section
    - Demos section at the top: the GIFs captured in openMSX, linking the
    demo page in English, Portuguese and Spanish.
    - openMSX section: the geo3d device and the V9968 fix in
    alexmoncks/openMSX (branch geo3d), how to run the ROM, its limits.
    - Demo ROM section: language menu, crawl pacing, music on PSG / SCC /
    OPL4, what run_rom_z80.py checks; crawl checks in three languages.
    - Known limits: it runs in openMSX now (not yet on hardware).
    - The demo pages link the published openMSX fork.
2026-09-25 geo3d: BASIC extension spec and a CALL name test ROM
    docs/BASIC_API.md: the MSX-BASIC CALL API for geo3d (PT-BR), with the
    decisions taken so far and the V9968 features that matter for 3D (EPAL
    256-color SCREEN 8, flat interlace, sprite modes, command-end interrupt).
    basic/g3names.asm: a 16 KB ROM whose CALL handler prints PROCNM, the raw
    bytes after the name and each argument from FRMEVL. run_names.sh runs
    disk/G3TEST.BAS (the 46 spec names and variants) in openMSX on MSX1
    (Gradiente Expert), MSX2, MSX2+ and turboR V9968 BASIC; all four logs match
    byte for byte. Names reach PROCNM intact, keywords inside them included.
    RST 08h/10h and page-0 routines that jump into page 1 (FOUT) hang from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
2026-09-25 geo3d: BASIC extension ROM skeleton (INIT, dispatch, G3INIT, G3END)
    basic/g3basic.asm builds a 64 KB ASCII8 ROM (code in bank 0, 2592 bytes):
    - INIT installs once, hooks H.CLEA (the work area is reserved at BASIC's
    CLEAR, the way the disk ROMs expect), detects the 88h/98h profile;
    holding G skips it.
    - The CALL handler dispatches G3 names by table; arguments accept empty
    positions and every numeric type, with the ROM's own rounding BCD to
    integer conversion (FRCINT cannot be reached through CALBAS).
    - G3INIT (mode 5) and G3END on both profiles: V9968 mode through PORT#4,
    palette ramps, page clears, geo3d set up for SCREEN 5; waits with
    timeouts, CTRL+STOP raised only once the eng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
    [g3basic.asm]
2026-09-25 geo3d: demo ROM plays a MOD on the MoonSound; streams compressed (G3LZ)
    - geo3d_modplay.asm: a ProTracker MOD player for the OPL4 wave part. The
    ROM carries the MOD (header, order, patterns, samples); the Z80 reads the
    patterns row by row and runs the effects per tick at the song's own
    speed/BPM, timed by OPL4 timer 2. Samples are uploaded to the MoonSound
    sample RAM during the language menu (needs 256 KB; less falls back).
    - music.py: read_mod (ProTracker timeline, sample pitch/family analysis)
    feeds the existing arranger, so PSG, SCC+PSG and OPL FM play a
    conversion of the same MOD as the fallback; MIDI output is unchanged.
    - g3lz.py + player: demo streams in 8 KB G3LZ blocks d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
2026-09-25 geo3d: whole MOD looping through the demos, effects 4/6/7, CPU-load check
    - The MoonSound path packs the whole MOD and keeps playing it through
    every demo and restart, looping like ProTracker; the PSG/SCC/FM
    fallback still plays during the crawl only.
    - Space without slower starts: raw setup data shared between demos is
    stored once (CALL opcode), VRLE uploads split at bank ends (VMORE);
    81 KB freed, 43 KB still free with the whole song.
    - While the MOD plays, VRAM uploads use an unrolled loop that polls the
    OPL4 timer (same bytes, same ports); in openMSX no black screen, demo
    start or paced frame is later than in the uncompressed reference ROM.
    - Player: vibrato, vibrato+slide, t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
    [build_rom.py, geo3d_modplay.asm, geo3d_rom.asm, modcost.py, modplay.py, modplay_test.asm, run_rom_z80.py, test_modplay.py]
2026-09-25 geo3d: BASIC ROM scene commands and a GLB to geo3d model converter
    BASIC ROM (g3basic.asm, bank 1 g3bank1.asm, sine table in bank 2):
    - G3DATA(m[,o]) reads custom models 16-31 from DATA with BASIC's own
    READ routines (checked on BASIC 1.0 to 4.0) into VRAM page 7.
    - G3OBJ, G3POS, G3ROT, G3SPIN (degrees, R = Ry*Rx*Rz), G3CAM, G3STYLE
    (wireframe/solid), G3RAMP, G3PAL and G3FRAME[(v)]: spins, hidden-page
    clear, upload only when geo3d does not hold the model, far-to-near
    draw, paced flip (98h H.TIMI hook, 88h V9968 F flag).
    - A 255-face object runs at about 20 fps on a 3.58 MHz Z80, 60 on R800.
    - Fixes: AUTOEXEC.BAS no longer blocked by the H.CLEA work area (files
    kept open across the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
    [check_frames.py, g3bank1.asm]
2026-09-26 geo3d: VECTOR RAID, a side-scrolling shooter cartridge for V9968 + geo3d
    A 64 KB ASCII16 MegaROM in Z80 assembly (geo3d/game/), built for both
    port profiles (98h for openMSX, 88h for the cartridge).
    - Starfield intro in three parallax layers, then the background tile
    scrolls in, then the foreground band at twice its speed. Every frame
    the hidden page is composed by the VDP (HMMM for the background, a
    masked copy for the foreground band, one-pixel-shifted copies built at
    load time for odd offsets), geo3d draws the ship and the enemies as
    shaded 3D models on top, and the flip happens in the vertical blank.
    30 fps; about 0.04% late frames in a 240 s soak.
    - Collisions: invisible (c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
    [gen_assets.py]
2026-09-26 Bugfix "Sprite overmap"
    ドラクエ2がフリーズする・スプライトが異常に点滅する、その辺の問題が解消
    [tb.sv, vdp.v, vdp_cpu_interface.v, vdp_sprite_select_visible_planes.v, vdp_timing_control.v, vdp_timing_control_sprite.v, vdp_timing_control_ssg.v]
2026-09-26 Bugfix left side of MSX2+ logo
    MSX2+ロゴで、左端にロゴの一部が縦線状に見えてしまうバグを修正
    [tb.sv, vdp_color_palette.v]
2026-09-27 geo3d: own PLL clock for the engine, timing-clean Gowin build
    The engine ran on HRA's clk42m, which comes from the Gowin CLKDIV; the
    timing model gives that output no insertion delay against 2.9-4.4 ns on
    the PLL's clk85m, and the Gowin build had 33 setup and 40 hold paths
    failing on the geo3d crossings (worst -2.487 ns).
    - apply_geo3d_patch.py: exposes u_pll2 CLKOUTD (already set to CLKOUT/2)
    as clkoutd in the rPLL2 wrapper, adds clk42g in the top for geo3d_bus
    clk_eng only, and adds clk42g (clk14m x3) with a 0.5 ns uncertainty on
    the clk85m<->clk42g crossings to the SDC. HRA's clk42m, HDMI, pins and
    msx_slot.v are unchanged. Every run checks the PLL settings and the SDC
    clocks a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
    [geo3d_bus.v, gowin_rpll2.v, tangnano20k_vdp_cartridge.v]
2026-09-27 geo3d: demo ROM detects a missing geo3d instead of hanging
    - geo_probe at power-on (reads only before any geo3d write, as the BASIC
    ROM does): without geo3d the ROM shows a "geo3d not found" screen in
    English, Espanol and Portugues (and through the BIOS on the TV for the
    88h ROM) and stays there, with no geo3d writes.
    - Every geo3d / command-engine wait gives up after about 3 s and goes to
    the same screen (STOP first, waiting for a blocked geo3d).
    - With geo3d present the port traffic is unchanged apart from the probe;
    run_rom_z80.py gains --absent, --stuck, --msxver and --pal modes.
    Claude-Session: https://claud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
    [build_rom.py, geo3d_rom.asm, run_rom_z80.py]
2026-09-27 geo3d: cartridge verification report in Portuguese, English and Japanese
    docs/cartridge_report{,.pt,.ja}.md: whether geo3d works on the standard
    V9968 cartridge (board: no change needed; HRA's FPGA files touched;
    Gowin utilisation and timing; integrated RTL simulation; software with
    HRA's stock bitstream; programming rules; first power-on plan and
    recovery). BASIC_API.md: the command-register rule now covers R#32-R#58
    and says CE = 0 does not mean the engine is free during a geo3d RUN.
    Claude-Session: https://claude.ai/code/session_01D3WQkzquf44TCVTAyavdak
2026-09-27 Updated cache memory
    4way full associative cache with round robin → 8way full associative cache with LRU
2026-09-27 Bugfix horizontal magnifier
    水平拡大が汚かったバグを修正
    [tb.sv, vdp_video_out.v]
2026-09-27 fpga: HRA's project back to upstream; geo3d cartridge as its own Gowin project
    The HRA folder held his 86361d8 sources with our patch applied next to
    his own impl/ build, which listed no geo3d files and was confusing.
    - fpga/V9968_Cartridge_TangNano20K: exactly HRA upstream 86361d8 again
    (sources and his impl/, the recovery bitstream), so upstream merges
    never conflict.
    - fpga/V9968_Cartridge_TangNano20K_geo3d: new sibling Gowin project laid
    out like HRA's (src/ with his sources patched and geo3d in src/geo3d/,
    .gprj with in-project paths, .cst, .sdc, process config) and impl/ with
    our Gowin build: the synthesis lists the geo3d files, and the pnr
    bitstream is the geo3d cartridge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
    [device.cfg]
2026-09-29 Bugfix Fleet commander 2
    [tb.sv, vdp_cpu_interface.v]
2026-09-29 Bugfix HMMM, DIY=1 の場合の NY の挙動
    [vdp_command.v]
2026-09-29 Bugfix SCREEN2 で CMD=1 にすると、VDPコマンドが 1byte飛ばしで動作するバグを修正
    [vdp_command.v]
2026-10-02 geo3d: ASCII16/ASCII8 mapper signature in the ROMs; MSXimus Z integration notes
    Launchers and openMSX without -romtype took GEO3D_98.ROM for Konami SCC:
    its compressed data holds bytes that read as LD (9000h),A. Bank 0 of every
    ROM now carries a mapper tag that never runs:
    - the 8-byte ROM type signature at file offset 0010h (MSXgl convention):
    ROM_AS16 for the ASCII16 ROMs, ROM_ASC8 for G3BASIC.ROM;
    - a readable description of the mapper;
    - 40 LD (nnnn),A to the mapper's own registers, so a guess that counts
    them like openMSX's guessRomType picks the right type by 24+ points.
    tools/mapper_guess.py prints the signature, the counts and the guess; the
    builds fail if the guess is wrong. ope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
    [build_rom.py, g3basic.asm, geo3d_rom.asm, run_rom_z80.py]
2026-10-03 geo3d: SPHERE7, a textured sphere bouncing in SCREEN 7 (G6, 512 x 212)
    A standalone ASCII16 demo ROM (SPHERE7_98 / _88, built by sphere7/build.sh
    with the ROM type signature): a 200-face UV sphere drawn by geo3d with LRMM
    textures, lit from one side, spinning about a tilted axis and bouncing off
    the four screen edges, with a short squash and a PSG "boing" at each
    contact. Six original procedural textures (ocean world, cratered moon, gas
    giant, beach ball, checker ball, lava world), each with five light levels,
    live in VRAM pages 2-3 and switch at every side-wall bounce or with SPACE,
    with no upload; ESC restarts. Double-buffered pages 0-1, flips in the
    vertical blank, 15-bit palette (EPAL; -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
    [gen_assets.py, run_z80.py, sphere7.asm, tb_hra_cmd_g6.v, tb_system_g6.v]
2026-10-14 geo3d v2.0: checks for the emulators' cores (producer clock, blue_replay)
    Both emulators have a local geo3d-v2.0 branch with Geo3DCore brought to
    v2.0 (the openMSX fork; a clone of Hesoten's blueMSX+, whose port of the
    core also models the engine's time). What checks them lives here:
    - sim/tb_engine.v, +ec=<file>: the producer's clock of every command and of
    every RUN end, counting the clocks since RUN that the producer does not
    spend stalled on the holding register
    - sim/blue_replay.cc: runs a stimulus through blueMSX+'s Geo3DCore and
    writes the command log and those clocks as the core has them
    - sim/check_ec.py: the two clock files must differ by one constant
    Results (docs/geo3d_v2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
2026-10-14 bench_v2.py: resident scenes larger than v1.0.0 allows (extended formats)
    A scene of more than 256 vertices or faces is sent in geo3d v2.0's extended mode (10-bit pointers, 12-byte faces) and the counts as 10-bit registers; it has no v1.0.0 traffic to compare with. GEO FIGHTER's new frame (869 vertices, 792 faces): 6.85 ms on the v2.0 RTL with the V9968 in high-speed mode.
    Claude-Session: https://claude.ai/code/session_01DGPUYbXQmuTT4HZC2jw5Z9
2026-10-16 geo3d v2.0: engine reset from its own flop, heap without COLOUR (20 BSRAMs)
    Both for HRA!'s timing, after his report of a clk85m violation with v2.0:
    - geo3d_bus.v: the engine side resets from rst_e, a clk_eng register of
    ~reset_n. The slot's reset reached every register of the engine before
    (a clk -> clk_eng path with a fanout of hundreds: -1.287 ns with geo3d's
    RAMs placed and Route Option 0). The engine leaves reset one engine
    clock later; nothing else changes.
    - geo3d_engine.v: the heap entry is KEY, FACE, LEVEL (31 bits, 2 BSRAMs
    instead of 3). COLOUR = BASE + level is computed when the root comes
    out (D_FW2), from the face read back: the Z80 does not write model RAM
    whil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
2026-10-27 geo3d docs: KiCad logic drawing of the cartridge (V9968 + geo3d v2.0)
    A 13-page hierarchical KiCad 10 schematic generated from the RTL, plus
    its PDF (geo3d/docs/kicad/geo3d_logic.pdf):
    - top sheet: FPGA pins, sheets, leaf IPs, bus glue in gates, P&R usage
    - clock_reset, msx_slot and geo3d_bus at gate/flip-flop level
    - geo3d_engine and geo3d_core as RTL blocks
    - the V9968 hierarchy generated straight from the Verilog
    gen/ holds the generator (KiCad's own Python, no dependencies);
    export_pdf.ps1 regenerates the schematic and the PDF. Resource counts
    come from the Gowin v2_locr2 build reports copied into gen/data.
